gmingtian/HachimoDock-esp32s3/docs/superpowers/specs/2026-11-07-fusion-enclosure-api.md

# 当前接续：R4 原版实体复制

用户最终明确：以原版 STEP 实体为母版，外形只略放大；按键、摇杆、凹槽深度与原版接合结构照搬，内部空间和屏幕安装重新适配，左侧为双 Type-C。此前 R2/R3 完成记录和重画外形均已被本要求取代。

R4 复制原实体，在屏幕段 V=43 mm 插入原截面8.5 mm，总宽增3 mm；原版操作区实体恢复原尺寸和坐标。屏幕内装四个 M2 自攻圆柱，PCB H3/H4 为 M2.5×4×3.5 热熔螺母，H1 塑料定位。底部和上方收音孔同时保留。当前 R4 安装、面框视线、错误孔洞检查及最终 STL 导出回读完成。球帽18,360姿态无新增碰壳；未测枢轴的极限杆体模型仍有约0.268 mm³新增交集，保留原版操作区并明确为试装件。实物行程与USB插头尚待确认，不交付 R1/R2/R3。

以下为历史过程记录，不表示当前 R4 已最终验收。

---

# A4 外壳 R2：Fusion API 接续

用户确认使用 Fusion API 由当前助手继续设计；交付只需要前后壳 STL。用户要求补齐前壳中间 H3 固定，相关固定座统一为圆柱；尺寸参考用户原版打印件；屏幕与机身为连续圆角一体过渡。保留 A4 PCB 与按键/摇杆坐标、原 14 mm 球帽，接受球帽与 SW3 既有干涉。

本地 Fusion 加载一次会话插件。插件通过工作区 JSON 请求/响应通信，不开网络端口，不自启动，不执行来自请求的 Python 文本。后台线程只发 CustomEvent，全部 Fusion 对象操作在主线程完成。原版 STEP 导入独立参考文档；修改仅发生于插件创建的工作文档，输出限定在外壳工程 `output/r2-fusion/`。不覆盖原 STEP/3MF，不提交或推送。

先接通并读取实体、圆柱孔轴和高度，再依据实测原 CAD 修正前后壳固定结构。不能只检查无碰撞而遗漏中间固定是否存在；需要检查圆形承座、孔/螺丝路径及前后/PCB 同轴性。API 导出 STL 强制毫米，并回读验证尺寸、封闭性与实体数。保留音频低位安装假设、左侧双 USB、屏幕内装四个 M2 柱与收音孔，并重新校核。
