gmingtian/HachimoDock-esp32s3/hardware/s3-carrier/output/electrical-audit.md

# A4 电气与固件对应核对

已直接读取最终 KiCad PCB 焊盘，按当前 S3 代码和编号引脚逐项核对；不只检查生成器的网络表。

| 代码信号 | GPIO | 果云排母引脚号 | 目标端子 |
|---|---:|---:|---|
| PET_S3_LCD_CLK | 21 | 39 | J1.3 |
| PET_S3_LCD_MOSI | 47 | 38 | J1.4 |
| PET_S3_LCD_RST | 45 | 36 | J1.5 |
| PET_S3_LCD_DC | 40 | 29 | J1.6 |
| PET_S3_LCD_CS | 41 | 28 | J1.7 |
| PET_S3_LCD_BL | 42 | 27 | J1.8 |
| PET_S3_MIC_WS | 4 | 4 | U3.5 |
| PET_S3_MIC_BCLK | 5 | 5 | U3.6 |
| PET_S3_MIC_DIN | 6 | 6 | U3.3 |
| PET_S3_SPEAKER_DOUT | 7 | 7 | U2.5 |
| PET_S3_SPEAKER_BCLK | 15 | 8 | U2.6 |
| PET_S3_SPEAKER_WS | 16 | 9 | U2.7 |
| PET_S3_PREVIOUS_GPIO | 39 | 30 | SW1.1 |
| PET_S3_NEXT_GPIO | 38 | 31 | SW2.1 |
| PET_S3_CONFIRM_GPIO | 0 | 35 | SW3.1 |

麦克风 L/R 接地匹配当前左声道采集；按键另一端接地匹配内部上拉、低电平按下逻辑。
功放 VIN 保持用户确认的 3V3，SD 接 3V3；GAIN 连接 JP1 中间2脚，1脚接3V3、3脚接GND。I²S模式下单帽1-2为6dB，拔帽为9dB，2-3为12dB（模块自身若有增益电阻需先核实）。喇叭直接接模块端子。
JP1仅使用一个2.54mm跳线帽，断电后切换；禁止同时跨接1-2和2-3，否则短接3V3与GND。不占用GPIO，不新增电阻电容。
GPIO1/2/8 只预留给摇杆，当前 S3 固件不采集摇杆。
果云使用两条 1×21P 排母；功放 1×7P；圆形麦克风两条 1×3P、排距 7.62mm。模块按元件面安装，不能照背面视图把引脚顺序镜像。
麦克风预焊照片已核对：带字面朝外、长针向下；元件面左列由上到下 SD/3V3/GND，右列 SCK/WS/L/R。
屏幕接口由左到右 GND/VCC/SCL/SDA/RES/DC/CS/BLK，VCC=3V3；与用户屏幕图片同序。
未上电焊接检查：按连接表确认排母每脚与对应端子通断、相邻焊脚无锡桥，3V3 与 GND 无焊接短路。预留 GPIO 和 NC 脚不能当成地线连接。
本次是设计文件审核，不代替打样板的断电通断检查、上电电压测量、负载和温升测试。高度/屏幕/USB 对壳尚未核实，因此没有制造放行。
