gmingtian/HachimoDock-esp32s3/hardware/s3-carrier/output/independent-review.md

# A4 独立复核

结果：PASS；独立复核代理 pcb_gain_review，2026-11-02。

- 原生KiCad DRC重新执行：0违规、0未连接。
- 23项测试通过，6种故意错误被拒绝。
- 与A3原生PCB比对：98个原有焊盘（包括机械孔）的坐标、尺寸、钻孔、形状、朝向不变；原网络仅U2.4按要求变为AMP_GAIN。原模块、板框和控制器件位置不变。
- JP1为2.54mm三针：1=3V3、2=AMP_GAIN、3=GND；单帽1-2=6dB、拔帽9dB、2-3=12dB，符合MAX98357A官方手册第28页表8（I²S模式）。
- 无新增阻容，没有更改GPIO。说明保留单帽、断电切换、禁止双帽和模块原有增益电阻/焊桥需核实的条件。
- PCB SHA256：`3ea5f653f6bf27bdb09c90290e1f22ae493803e0c346911ff89b9b5f40b8624e`。

本复核是设计文件检查；实际模块增益设置、安装高度、整机装配、电源/RF和打样上电仍未验证，不构成量产或整机无干涉证明。
