gmingtian/HachimoDock-esp32s3/hardware/s3-carrier/output/mechanical-audit.md

# A4 装配间隙核对

以下为已锁定布局的平面包络计算，并与最终 PCB 的焊盘坐标校验值关联；不是整机三维无干涉证明。

| 检查对象 | 包络间隙 mm | 规划下限 mm |
|---|---:|---:|
| 屏幕插头—果云下排排母 | 0.536 | 0.5 |
| 屏幕插头—麦克风包络 | 2.600 | 1.0 |
| 麦克风包络—SW3键帽预留 | 1.071 | 1.0 |
| 功放包络—SW1键帽预留 | 0.871 | 0.8 |
| 摇杆本体—SW3键帽预留 | 1.593 | 1.0 |
| 屏幕插头—H1螺丝头Ø6 | 11.286 | 0.5 |
| 屏幕插头—H2螺丝头Ø6 | 19.504 | 0.5 |
| 屏幕插头—H3螺丝头Ø6 | 0.560 | 0.5 |
| 屏幕插头—H4螺丝头Ø6 | 11.599 | 0.5 |
| 屏幕插头—H5螺丝头Ø6 | 19.298 | 0.5 |
| JP1含跳线帽—U1模块 | 8.403 | 1.0 |
| JP1含跳线帽—U2模块 | 2.900 | 1.0 |
| JP1含跳线帽—U3模块 | 9.000 | 1.0 |
| JP1含跳线帽—屏幕插头 | 4.800 | 1.0 |
| JP1含跳线帽—SW1键帽预留 | 10.268 | 1.0 |
| JP1含跳线帽—SW2键帽预留 | 4.371 | 1.0 |
| JP1含跳线帽—SW3键帽预留 | 7.612 | 1.0 |
| JP1含跳线帽—H1螺丝头Ø6 | 12.015 | 1.0 |
| JP1含跳线帽—H2螺丝头Ø6 | 37.046 | 1.0 |
| JP1含跳线帽—H3螺丝头Ø6 | 3.170 | 1.0 |
| JP1含跳线帽—H4螺丝头Ø6 | 28.082 | 1.0 |
| JP1含跳线帽—H5螺丝头Ø6 | 26.373 | 1.0 |

JP1采用2.54mm三针直排针与一个跳线帽，帽体限4×5.5mm；两种插法与针座的总平面包络按4×8.5mm预留。实际高度和外壳可达性仍需装配确认。

屏幕杜邦插头选型限制为外壳不超过 22×3mm；实际排母宽度、插头与线缆高度仍需核准。键帽按18.5mm预留，原版STEP中三个键帽约18.021mm。

摇杆保持原版孔位、封装、朝向，使用用户确认的原版约14mm 3D打印圆帽。按厂家图纸使用角为±30°，角度公差另留2°；新模块与插头避开R15mm保守活动预留圈。这个圈包含较大的杆帽中心位移规划余量，不是实测帽子扫过边界，也不表示帽子直径30mm。

该保守圈与原版SW3键帽在俯视投影中相交；高度差可能提供实际间隙，不能据此认定碰撞，也不能据此宣布无干涉。原版STEP有帽和键帽几何，但果云排母高度、摇杆支点对打印帽的位置和屏幕总装高度尚未核准，需完成全行程、按压及键帽按下的三维/实物检查。控制器件不因此改位。

U1/U2下方原安装孔的螺钉头与模块背面也需按实际排母高度检查。屏幕本体和背板、外壳、USB插头、线缆弯曲空间尚未完成三维核对。

原版摇杆规格：YTL YA13S-L7.4-B10Ka(60)-0-DL01；厂家机械图通过立创数据手册获取：https://www.lcsc.com/datasheet/C37323748.pdf

固定螺丝头选型限外径不超过6mm，螺丝头高度、实际型号及排母实际宽度仍待核准；H3孔保留原位，J1由A2的Y32.6改为Y31.0mm。屏幕插头与上侧ESP32排母、下侧H3螺丝头同时留有约0.54/0.56mm平面余量，不能再套用A2的2.14mm上侧间隙。两层螺丝头周围3.5mm半径内禁止走线、过孔和铺铜。

结论：规定包络内的新增模块平面间距通过；整机无干涉及制造放行仍待核实。
