gmingtian/HachimoDock-esp32s3/.folder.md

# 目录导航

- `pc/`：客户端、Agent 连接服务、组件生成 Skill 和内置素材。
- `firmware/`：ESP32-S3 A4 / ESP32-P4 固件、驱动、测试及烧录工具。
- `hardware/`：A4 PCB、R4.4 外壳和经过校验的制造/打印清单。
- `tools/`：离线游戏与硬件发布包构建工具。
- `assets/`：项目介绍使用的图片。
- 构建方法见各目录 README，下载入口见项目首页。
