gmingtian/HachimoDock-esp32s3/firmware/.folder.md

# Host and target build consistency

S3 Xiangqi admits its unchanged maximum 256-work AI slice every 2ms; portable
preview and P4 retain 8ms. `pet_p4_game.c` loads target CONFIG macros through
`sdkconfig.h` only on ESP builds. The cadence test mirrors that IDF macro path
and compares changing positions, completed depth, work, nodes and exact replies
against the portable 8ms reference; search rules, evaluation and limits stay fixed.

S3 landscape Xiangqi has a main-task static-frame scheduling gate. It compares
the existing input/instance context, widget identity, view revision and state
update time only after successful rendering, and forces a refresh every second.
Page exits, transfers, render failures and live touch, confirmation, approval or
conversation overlays invalidate it. Animated/unknown surfaces keep the original
render cadence. This skips duplicate raster work, not game/input/protocol turns;
it retains no pixels and changes no AI search limits. Host gate/adapter tests
cover the fallback rules; S3 response latency still requires device measurement.

The S3 LCD SPI clock defaults to 40 MHz. A bounded 80 MHz experiment can pass
`-DPET_S3_LCD_SPI_HZ=80000000`; S3 main accepts only 40000000 or 80000000.
`build-local.ps1 -Target S3` explicitly selects 40 MHz so an earlier trial CMake
cache cannot silently alter the stable build. Clock trials must use a distinct
firmware version and retain the previous image; see `docs/ESP32-S3-80MHz-Trial.md`.

CI prepares the locked v1/v3 SDK compilation contexts before the complete host
suite. Preview WASM uses LLVM/LLD 20.1.8. Portable C keeps strict compiler and
sanitizer checks; R179 includes bounded tone text formatting. Compile databases
and dependency caches are generated inputs and are not published.

# R178 independent appearance audio

Status-cue updates use the bounded audio-only protocol and two independent
audio banks. Empty snapshots restore defaults; unknown storage or publication
results preserve both banks. Video assets and factory components remain intact.
The protocol dispatcher includes the system-cue declarations used by this route.

# R174 media controls and pet-status candidate

The media transport primitive draws a complete triangle and centers action
labels using font visual bounds. Empty main-page captions use pet lifecycle
labels rather than Agent/session identity. City-radio 1.4.1 carries the aligned
controls in the canonical generated bundle; existing full resource packages
need a normal PC sync after upgrade. Factory membership remains 29. This is a
local candidate requiring clean dual-chip builds and manual device validation.

# Paced CONTROL alignment isolation candidate

Only the existing PET_P4_UART_PACING_ACTIVE CONTROL queue and its prefix use
one 256-byte internal DRAM staging buffer aligned to 64 bytes. Each driver
submission re-copies the unaccepted original suffix with volatile byte accesses.
Prefix debt, bursts, drain/tick and terminal error gates remain unchanged.
Default-off policy, raw screenshot, audio/media/log queues, USB, DSP, SDK,
clock/task/watchdog policy and versions are unchanged. This is isolation and a
candidate mitigation, not validated root cause or hardware acceptance. Actual
ELF placement/alignment/byte-loop/no-copy-call proof and original gates remain
mandatory; host tests cannot grant those claims.

# Firmware repair baseline

Private `negotiated-parent` offers downstream control framing per physical
route and enables it only after a bounded explicit engine/nonce proposal.
Legacy bind/ack resets only that route; invalid proposals preserve its session.
The protocol worker serializes capabilities and negotiation; native USB has no
guarded writer and advertises no serial integrity. Existing media/audio/raw
paths, execution grants, flash format and timing gates are unchanged. Winning
boot-lifetime frame evidence additionally retains exact node costs and LCD
compare/submit/wait observations, not later independent maxima. These numeric
diagnostics contain no text, identities, paths or packet contents.

Private `bulk-parent` compares unbuffered IO only for authorized non-live
package JSON streams and alignment-checked may-alias word copies only for
existing app clean-frame buffers. Defaults preserve libc buffering/copy paths.
No extra framebuffer, file-format, private-save or catalog-publication change.
The same winning frame retains app capture/wait/draw phases; the worst native
registry turn also retains its inner duration plus numeric query/SAVE interval
context. Endpoint overlap is not causal CPU attribution. No payload, path,
native owner address, task policy, clock, watchdog or public grant is added.

Private `phase-parent` retains same-frame boot-lifetime raster stages and the
worst aggregate native registry turn's scheduler/collect/capture wall phases.
These bounded numeric observations export no program/event/owner/private data,
never reset maxima and never subtract waits from the original timing gates.
Private spare-open purpose stages append IDs 21/22 and a third post-operation
numeric trace line; ordinary targets retain their original stage count/format.
The independent opaque-span experiment uses at most 256 bytes of local scratch,
preserves default 32-byte scratch elsewhere, and still requires actual stack,
pixel, memory and whole-window device acceptance. It is not a throughput claim.

Private `dirty-parent` adds default-OFF `PET_P4_APP_DIRTY_CACHE` and
`PET_P4_SPARE_UPDATE`. The app path keeps the existing clean-frame buffer and
native overlays, compares exact resolved keys, and replays all intersecting
layers in order through intersected dirty/viewport clips. Unsupported resources,
animation, runtime layers and structural changes keep full repaint. A first
proven opaque panel center avoids duplicate background stores; the redundant
prefix snapshot is omitted only before a full clean-frame cache write.
Empty-to-empty image revisions update metadata without visual invalidation.
Non-cacheable app prefixes additionally bind their exact resource revision;
an empty image pack never authorizes a different component's cached prefix.
The separate storage candidate updates ONLY a positively seen, non-live spare
JSON target using write/flush/final-tail truncation; unknown targets retain wb,
only ENOENT may fall back, and all readback/catalog/save rules remain. These
are raster/storage experiments, not execution grants or released capabilities;
source-bound device, throughput and whole-frame acceptance are still required.

Private startup-parent queues only unsolicited hello work on the existing
protocol worker, using one immutable native board identity and a coalesced
pending tag. No model/state mutex spans that full capability TX. Requested
bind/ack replies and all audio routing stay unchanged. The optional I2C
diagnostic sweep finishes before the first visible frame; original timeouts,
drivers, milestones and lifetime counters remain. Additional numeric app-frame
phases separate snapshot wait/capture from actual drawing; no duration is
excluded from the unchanged frame budget. The same private profile compares
removing/recreating only an already-unreferenced spare package generation
instead of truncating it page by page. Live-generation exclusion, full readback,
checksums, atomic catalog rename and save durability are unchanged. All three
switches default OFF; this profile is not physically accepted or released.

Private prefetch-parent reuses the existing priority-1 asset preparation task
for one physically owned H264 frame. Source pins, exact lease completion and
single-job generation prevent cancellation from freeing live codec readers.
Renderer-owned packed-current pixels remain independent from next-frame I420,
including an exact original-coefficient CPU fallback. Worker trace is separate
from complete render lifetime/gap measurements; future frames wait their target
and clip tails are displayed before reset. The main native program window and
worker claim share one short mux admission; visibility/cancel handling is not
deferred, accepted events are neither dropped nor replayed. The private existing
worker uses 6144 bytes pending actual link/stack/high-water/memory acceptance;
normal targets retain 4096. No SDK, priority, clock, watchdog, new task or audio
policy changes. This experiment is NOT yet physically accepted or released.
The static render guard additionally covers three actual asynchronous render
paths; all original paths and the 4096-byte reviewed-path limit remain.
Input eligibility queries provider-neutral two-byte paging under the same data
lock rather than copying five text rows to the input/form stack. Full snapshots
and the paging query share signed modulo/count logic; validation, retained stale
rows, TTLs and source isolation are unchanged. A private 32-byte HOST candidate
is serialized by the existing host mux, preserving all-or-none typed reads while
avoiding a per-task stack candidate. Cooldown admission has its own bounded
call frame; the complete nested path is audited, not hidden by outlining.

Private state-memory-parent preserves the original stable-address task model
and struct ABI, placing only that model in external BSS. No audio/DMA/ISR/RTC
buffer, mutex, task priority, stack or watchdog changes. Ordinary targets keep
the original placement. Actual ELF section/RAM and same fixed memory/timing
gates are required; source checks cannot grant hardware acceptance. Program
action dispatch now returns actual queue acceptance, not success after a
denied/full/stopped/uninitialized foreground session. No fallback or replay.

Private lookup-parent integrates bounded positive search-start coordinates into
the already measured save-budget/shared-program parent. Native eight-FD pool,
original SDK visitor (exactly once), full names/headers/flags/readback/errors,
catalog temporary-file atomic rename, save A/B/fsync, priorities and watchdogs
are retained. Missing files are never cached as absent; stale/colliding hints
only change the visitor's start and cannot supply a result. Timer/metadata work
preserves the real visitor's errno. Ordinary targets remain OFF. Exact-package
comparison adds opt-in numeric OPEN/DATA/CLOSE spans, no paths/content. Previous
actual SAVE-fault data remains retained; this new integration is not yet P4
throughput, serial, memory, long-frame or acoustic acceptance.

Private save-budget-parent moves only the immutable pending save snapshot into
fixed PSRAM under exact original-address/current-task ownership. Nested writers
cannot overwrite it before storage admission. Original 4096-byte SAVE stack,
priority 1, task count, A/B/fsync, dirty-newer reconciliation, audio admission
and revocation stay unchanged. After a real physical flush returns, the same
worker caches numeric byte-labelled high-water metadata; diagnostics only copy
that metadata, never scan another stack or export addresses/content. Ordinary
targets remain default-OFF. Native sanitizer tests and static frames do not
prove whole-SDK stack bounds, real workload margin or acoustic acceptance.

The private unchanged-install comparator reads exact filesystem bytes plus EOF
while bypassing only the product HAL read cache. Native SPIFFS file/index cache
coherency remains unchanged; this is not a raw-media bit-rot scrub.

Private snapshot-close-parent adds an explicitly negotiated exact id/requestId/
route close receipt after physical retirement, plus bounded numeric request/id
correlation on errors. Legacy cleanup and all snapshot/audio/driver deadlines
stay unchanged. The PC waits inside its original frame budget, never retries
close or replays a task, and retains late errors. This extension is not yet
compiled or physically accepted; R106's full reader gate failed despite all
600 queries and all raw frame checks passing. Its separate unexecuted lifecycle
tail passed and removed only the two owned fixtures, preserving private saves.
The same private candidate additionally retains an unexpired boot cache epoch
across physical package boundaries without extending its <=5s deadline; only a
fully completed old epoch can rotate. Every original read/check/recovery still
runs. Explicit reopening of the same validated RAM program may retain its live
owner unchanged, or take the latest fully retired committed snapshot before
NEW broker admission. Visibility never rearms it; manually stopped registered
background programs remain stopped. These default-OFF optimizations have native
ownership/retirement tests but are not yet P4 timing or acoustic acceptance.
The RAM snapshot adapter itself is compiled only when its opt-in is enabled:
ordinary pure-compute sessions retain their original parser-free link boundary.

Private boot-trace-control records eight fixed monotonic app_main milestones;
boot-cache-parent additionally gives EACH existing physical catalog package
validation and catalog JSON/selected-package read its own finite native cache
work lifetime. No cached filename/absence/validation result, skipped parser,
checksum, older-item recovery or changed data format. Cache admission failure
only bypasses the optimization, never marks resources damaged. The selected
package scope finishes before private saves acquire their separate lease.
The generic adapter keeps exact original pointer/task/lease/epoch ownership,
including revoke, copied/stale scope and external manual-observer cases.
No TTL extension or new IO retry. Boot trace is default-empty, <=64 bytes plus
one mux, explicitly requested metadata only and atomically assembled JSON.
Milestones include preemption; returned initialization is not a health verdict.
These changes are not yet compiled or physically accepted; normal targets
remain closed and the earlier original OTA boot-deadline failure is retained.

Private `storage-save-parent` extends the exact-byte cache to independently
admitted native save IO leases, including cold loads and background flushes.
Borrowed miniapp leases retain their original scope; busy/manual observation is
never adopted. The native adapter binds the original scope pointer and task,
stops only its exact generation after physical close and before lease finish,
and permits cleanup after audio revocation without stopping a newer observer.
The five-second expiry, original fsync/A-B/save error semantics, audio guards,
task priorities and ordinary targets are unchanged. This is not a measured
throughput fix or acoustic acceptance. Activation/storage rejection logs add
fixed numeric admission gates, never paths, content or credentials.

Private render-pack-probe checks 4-byte source/output alignment before compiler
alignment assumptions and uses ordinary memcpy word IO for an 8-pixel H264
layout block. Unaligned rows and 2-pixel tails retain the original byte-safe
path. No new buffer/task/priority, DMA mode, ownership or fence change. Normal,
UI and mixed profiles keep the option off; bit-exact tests are not P4 speed or
acoustic acceptance. CPU tiled rotation remains a rejected private comparison.

Private framework-mixed-acceptance composes the reviewed unified parent,
scoped exact-page cache and guarded 256-byte paced control transport for JOINT
acceptance only. Still two PROGRAM leases/4096 total fuel/64 aggregate dispatch,
zero arbitrary peripherals/media grants, no auto-start. The inherited33-slot
catalog exists only for two owned fixtures without removing retained user
resources; remove exact fixtures before a32-slot image. Normal/UI/Windows are
unchanged. This configuration alone is not mixed P4/performance/AEC acceptance.

Private render-rotate-probe compares a bounded tiled CPU quarter-turn with the
unchanged PPA control after actual queue measurements. Same source/destination,
RGB565 element order and panel mapping, no extra framebuffer/priority/task. The
original panel submit, cache synchronization, refresh fence, screenshot and
double-buffer ownership remain in place. Invalid dimensions/capacity/overlap
fall back before any write. Ordinary builds remain closed; no throughput or
66.667ms/voice/AEC success is claimed before paired physical measurement.

Private render-queue-probe wraps only the pinned SDK ppa_do_operation boundary
for the exact renderer task/client/cookie. Preparation wall time is separated
from queue-to-callback on the SAME frame; neither is claimed as exclusive DMA.
Original arguments/result/errno, blocking mode, buffers, deadlines, fences and
priorities remain unchanged. No global cache wrapper, image data or pointers in
logs. Ordinary builds add no queue state/clock calls. Physical measurement and
the existing frame gate remain pending; this is diagnostic, not an optimization.

Private exact-page cache entries now use an 8-byte numeric representation:
all 23 aligned-address bits, 8 bounded pin bits, one filling bit, and the full
generation. Metadata is 17408 bytes, 8192 less than the earlier layout. Saturated
pins bypass the cache rather than wrap; invalidation still changes generation
only and cannot recycle pinned/filling copies. This is not a voice/AEC or DMA
acceptance, and the cache remains disabled in ordinary builds.

Private render-lcd-probe separates comparison, panel-submit and refresh-fence
wall time for the SAME retained window-peak frame. It does not change the
existing lcd_us meaning, fence/deadline, frame gate, DMA/buffer ownership or
voice/AEC policy. Ordinary compiled paths make no new timer calls. Invalid
timings are marked rather than interpreted as zero cost; measurement is not a
66.667ms gate pass or permission to remove the refresh wait.

The private storage-page-parent profile alone connects the bounded exact-byte
cache to actual STORAGE_WORK scope ownership. A busy/manual diagnostic window
is not adopted. Exact successful native scope completion stops only its own
generation; copied/failed/durable-unpublished scopes cannot stop another job.
Expiry is a cache bypass, never an IO/installation success or permission. The
new strict storage_io_latest RPC only observes metadata. Normal builds remain
closed; host tests are not automatic-parent P4 or acoustic acceptance.

`pet_p4_storage_sparse_page.h` adds a default-off exact65-byte representation for
successful512-byte snapshots with a uniform middle, within the same slot and
metadata budgets. Partial copies retain every prefix/tail byte; pins, generation,
invalidation, physical bypass and original SDK recovery semantics are unchanged.
`pet_p4_logical_retention.h` owns bounded renderer-only common-overlay plans and
previous successful final-frame authority. Exact staged content/resource keys
and unchanged captured overlays can avoid repeated rasterization while retaining
the complete final pixel comparison and original frame/gap clocks. Final pixels
with overlays never populate a clean texture; noncacheable modes remain live.

The private glyph-axis candidate relocates only the existing512-byte axis to
internal RAM. No sampling expression, font release, clipping or wide-glyph
fallback is changed. The relocation requires explicit internal-memory admission;
default profiles retain their original allocation. No extra scratch, framebuffer,
task, guest service or execution grant is introduced.

`pet_p4_storage_io_trace.c/.h` and its RPC are DEFAULT-OFF private observation of
the real SDK SPIFFS physical HAL callbacks, not a cache or new storage policy.
The private IO profile alone wraps read/write/erase, preserving exact args,
single-call returns and errno. Four categorical actors and size-count buckets
report requested (NOT accepted) bytes and preemptible wall time. In-flight calls
keep a stopped window incomplete until physical return; old generations/boot
tickets cannot reset a later window. No paths/addresses/payloads are exported.
Read/status export uint64 counters as exact decimal strings, bounded to one
record per reply. Ordinary builds have no wrappers or trace state. SDK link,
full regression and physical measurement for this new observer are still pending.

The private v2 background controller uses strict `widget/program-query/inspect/start/stop`
with request IDs, exact installed checksums and decimal registration serials.
Mutations additionally require the current exact boot ID; serial1 after reboot
cannot be cancelled by a stale serial1 ticket from the preceding boot. Query
returns the boot ID but needs no mutation authority. No automatic retry.
`pet_p4_background_protocol.inc` is included once by protocol.c and emits only
bounded categorical ownership/timing/checkpoint metadata, not program/cells.
Inspection separately negotiates `p4-program-inspect-v1` and copies exact
checksums from the verified RAM catalog only. Allocation failure never emits
a partial or apparently empty successful status; a lost receipt stays unknown.
Capability is advertised only after the private native parent initializes;
ordinary/Windows/UI remain ungranted. The small r71 private installed lifecycle
passed silent P4 acceptance; later v2 cross-boot stale-ticket rejection is also
verified. Real client inspection/control integration remains separately gated.

`pet_p4_screenshot_write.h` preserves a bounded numeric first TX failure across
best-effort error transmission and exact snapshot terminal history. Writer
budget, no-progress/invalid return, drain, lease, audio, mutex and encode differ.
There is no image/text capture, larger deadline, new thread or audio path change.
An unwritten TX-mutex refusal retains the SAME pull snapshot for a bounded
read-only observation. Begin reuses the exact nonce/route/dimensions; read/end
may return fixed busy metadata. Partial writes/driver/drain remain terminal;
idle/lifetime/read quotas and physical buffer ownership are unchanged.

Main samples its existing monotonic timestamp AFTER the shared state lock.
A protocol owner can admit new timers while main is waiting; an earlier sample
would spuriously cancel them as a clock rollback. There is still one sample,
no timer clamping, reset/replay, priority change or audio-path rewrite. The
actual extracted main prefix is tested with the real timer core; a genuinely
regressing timestamp must continue to latch cancellation.

Private `esp32_p4_background_candidate` connects the native registry to the
actual main parent and verified installed-package loader. The private parent
fragment `pet_p4_miniapp_background.inc` is included once by miniapp.c, not a
separate task/owner. Explicit native start preserves the visible selection,
uses exact catalog content identity, pins its authoritative RAM seed, rereads
the latest RAM checkpoint at publication and refuses inflight foreground events.
Registered program views project the registry owner; stale retired foreground
snapshots cannot overwrite later background progress. Update/delete quiesce and
checkpoint hidden owners too. First published seed refreshes its view without
pumping, avoiding a live revision with parse-time zero display. This is not a public
or package-autostart capability; global quota stays ONE, reclaim stays off.

`pet_p4_program_registry.c/.h` introduces a DEFAULT-OFF native parent with four
fixed session slots, one aggregate dispatcher, exact content/serial handles,
scoped-save pins and separate one-entry RAM checkpoints. Actual broker quota
is not enlarged. Parent/schema/install/UI integration and device acceptance
are still required; this source alone is NOT an installed background capability.

r69 private paced-UART reference now covers the screenshot writer too: the
r63 reference had paced only drained control replies, so its later screenshot
failure was on an UNPACED path. Keep that failure; it is not evidence that
pacing failed on screenshots. Default, USB JTAG and audio/media queueing stay
unchanged. Same send/snapshot deadlines and all CRC/error/ownership checks.

Scoped app-save RAM entries now support exclusive native lifetime pins, with
monotonic stale-safe tokens. Only confirmed loaded/clean/unpinned scoped slots
can be reused after successful storage admission; observation/update cannot
reserve a key. Dirty, loading, failed and all 32 legacy entries stay protected;
reclaiming RAM never deletes files. Reclamation remains DEFAULT OFF until all
long-lived consumers acquire pins; the existing foreground profile is unchanged.
This is a registry prerequisite, NOT an
installed background scheduler, execution grant or durability acknowledgement.

`pet_p4_spiffs_hint.c/.h` is a private IDF-5.5.1 lookup-start experiment,
default empty. Same-memory control/probe keep eight descriptors/cache pages;
only the probe changes where the unchanged SDK full-name visitor starts its
wrapping search. No existence/content/negative answers are cached, no file
format/readback/CRC/error is changed, and diagnostic counts contain no names.
Host RAM-flash tests compile the installed SDK unmodified (symbol redirection
only); P4 final-ELF caller/heap/timing verification is separately required.

A separate private `esp32_p4_program_candidate` permits ONE foreground PROGRAM
lease (4096 fuel total), following r64's actual main maximum-image/backedge
measurement. Normal/UI/Windows remain closed, peripherals remain closed, and
audio reservation still revokes it before flag sampling. This is not arbitrary
mixing, a background registry, public firmware or voice/AEC certification.
The broker denies NATIVE_PROBE versus PROGRAM/PERIPHERAL in both directions,
including revoked-but-unfinished physical work, so a debug job cannot silently
double an admitted component's quantum. Quotas and realtime masks are unchanged.

r65 retains a bounded terminal category for the last exact screenshot ID/route.
Idle expiry, lifetime expiry, broker revocation, explicit close, failed physical
send and active ID/route mismatch no longer collapse into one generic error.
Budgets, CRC checks, cancellation and no-recapture rules remain unchanged. No
image bytes or request contents survive release in this diagnostic record.

r64 expands the fixed main-loop diagnostic with two full 256-instruction,
64-cell images: a successful HALT and a 4096-fuel backedge trap. The latter must
retain every committed cell/output and revision. Both validate/start through the
actual host/session and shared parent, one operation per main turn; no guest
quota is opened and this is not a worst-case or acoustic timing certificate.

A private 4M paced-UART reference limits only drained-control bursts to 64
bytes separated by one RTOS tick. Normal/UI/Windows and audio/media queueing
are unchanged. This is a controlled link experiment, not a released workaround,
driver attribution, throughput improvement or acoustic acceptance.

r63 adds a fixed native main-loop diagnostic with one bounded work operation
per main turn outside UI locks. Completion publication is memory-only; only the
protocol worker serializes/drains the retained static reply route, exactly once.
No arbitrary guest code, background installation or resource grant is enabled.

r63 separates shared-parent dispatch from each session's own report collection.
Fresh sessions may bind one fixed native parent before admission; they cannot
step/rearm that parent implicitly or consume another child's result. The real
component parent now dispatches once and collects its own output after visibility
guards. Private-session callers remain compatible. Alias checks cover the shared
dispatcher and its registered host/group/timer/bus storage. This is not yet an
installed background registry, arbitrary mixing or new execution permission.

A separate `esp32_p4_uart_2m_reference` is a private silent link comparison;
normal/UI/Windows/default baud remain 4M. A clean low-rate window alone is not
driver fault attribution, normal-rate closure or voice/AEC acceptance.

The r62 fixed native session diagnostic uses a separate immutable constructor
and actual NATIVE_PROBE leases/publication. Ordinary PROGRAM construction and
its zero admission quota are unchanged. Eight fixed actions plus a one-shot
timer traverse the actual session/group/scheduler; every quantum returns and
yields. The bounded empty request cannot supply code/state/grants/owners. It
reports protocol-worker step timing, NOT main-parent/mixed-load acceptance.

r62 evaluates a startup-only lossless font pack in the UI candidate only.
Every original glyph byte/metric/mapping/kerning and MiSans notice is retained;
the normal target remains unpacked for comparison. One static PSRAM output and
inflater replace bitmap Flash bytes, never per-glyph decode or dynamic memory.
Startup requires exact packed/output lengths, terminal decode and Adler match
before input/audio/render; failure is latched and cannot validate the OTA app.
Existing OTA/stack budgets stay unchanged. This is capacity engineering, not
guest/background admission or acoustic acceptance.

r61 reads the bounded extent of the same owned file before and after reading,
without probing past EOF. Save metadata I/O failure or changing extent is
unavailable, never an invented empty save. Package/checksum/Unicode/lease/close
checks and directory retry/error gates remain intact; there is no SDK clearerr
or storage migration. Host fault tests are not P4 throughput acceptance.

r60 applies the existing bounded Unicode/depth source preflight before the
early debug parsers as well as the ordinary dispatcher. Screenshot envelopes
must consume the complete JSON text. An explicit audit result gets a separate
fixed TX observation; read-only last-result metadata does not recursively
capture itself or retry any command. Ordinary/audio no-audit hashing is unchanged.

r59 routes the component program session through the shared group/scheduler.
Explicit empty-scheduler rearm preserves serial uniqueness; stopped work never
automatically resumes. The guest execution gate remains closed pending device
admission/mixed-load review. Only cold declaration/diagnostic/capability code
uses size optimization; VM, audio DSP and pixel-render optimization are unchanged.

r58 writes widget/buttons JSON directly to an explicitly owned, unreferenced
package generation. Current catalog references are denied before any open;
readback/checksums and the final catalog's atomic replacement remain unchanged.
Partial writes can only leave unpublished spare bytes, not alter the live pair
or private saves. Legacy boot migration and sprite/catalog writes retain the
old atomic file helper. Native tests cover owner loss, reference checks and
short write/flush/close faults, alongside the real parent mutation tests.

Opt-in transport audits also sample the caller's bounded source fingerprint
after driver return, per retained route. This separates a changing source buffer
from driver/wire/host loss, not proof of delivery or cryptographic identity.
Normal and audio/media sends still perform no audit hashing while disarmed.

r57 compares the unlocked storage phase at the existing main/save-worker base
priority (1), never above UI. The idle-only r56 intervention removed reproduced
multi-second render starvation but tripled package completion time; that result
is retained as a rejected throughput trade-off. Exact owner, unlock/restore
ordering, audio reservations and all ordinary execution gates stay unchanged.

r56 gives only the exact protocol task's unlocked storage preparation/cleanup
phase an idle base priority. It restores the known protocol base before taking
the state lock, never an inherited effective value. File ownership, durable
publication, audio reservation, legacy saves and package format are unchanged.
This addresses a reproduced high-priority filesystem/render starvation path;
same-fixture device timing still gates acceptance, not filesystem wall time alone.

r55 adds a private priority-9 scheduling comparison, sharing the input priority
but remaining below UART/control. Ordinary/UI priorities are not changed by
this experiment. Only priorities 9 or 16 are allowed in this reference profile;
component execution remains explicitly forbidden. Performance acceptance is
still pending the same-clip device comparison, not inferred from compilation.

r54 adds an explicitly separate scheduling-reference build for matched fixed
clip comparisons. It keeps the old primary/pack priority only in that reference
image, cannot compile with guest execution reviewed, and is never a public
candidate or a new capability. Default UI ordering stays unchanged. Count actual
rendered frames separately from intentional exact-frame LCD suppression; random
idle variants and unmatched time windows cannot establish a performance delta.

r53 separates the existing core-1 secondary decoder priority from primary/pack
priority for a controlled throughput comparison. Control/input and audio task
priorities are not raised. Compile-time checks bind the SDK secondary to core 1;
this candidate must still pass wall-time and throughput gates, not just compile.

r52 tests the highest animation priority still below input/control (8), after
the conservative priority-7 candidate's observed throughput was lower. Timing
and throughput must both pass independently. Trusted read-only service native
authorities now reject copied instances before providers, output or revocation;
ordinary peripheral/program grants remain unchanged and closed.

r51 makes animation decode/pack best-effort below control and input, without
changing audio task priorities, codec parameters or pixel operations. Temporary
main-task boosts never save an inherited effective priority as a new base.
The secondary decoder priority is compile-time checked against the same policy.
Wall-time and frame-throughput acceptance remain separate device measurements.

r50 extends fixed-instance identity and admission-time stop latching to the
component session. A separate opt-in scheduler evidence build links audited
partial wrappers and numeric bounded reads; normal/UI builds contain no active
hooks/ring/commands. It is diagnostic only, not a capability or release image.

r49 rejects moved/copied program host, runtime, timer, group and scheduler
instances before callbacks or resource retirement. This is private native
identity, never a wire handle or storage field. Fixed probes retain timestamps
of the same slowest quantum for correlation; no execution quota is opened.

r48 adds a native cooperative deadline checkpoint over the same interpreter:
fresh factory clock/budget only, exact continuation without event replay, fresh
authority after each permitted checkpoint, terminal clock/no-progress failures.
It cannot preempt native callbacks, interrupts or Flash/cache stalls. A fourth
fixed probe case compares the same loop with the 750us policy, retaining the
legacy cases. PROGRAM/PERIPHERAL quotas and execution review remain closed.

r47 keeps the new program foreground activation latched after hide: ordinary
ticks and input cannot resume just because visibility/focus returns. A fresh
explicit activation preserves committed state. Legacy non-program timers keep
their old behavior. Shared mixed form/program/navigation fixtures exercise
separate writers, draft cancellation and bounded visible input verification.

r46 retains separate whole-call wall time and diagnostic-only local critical
cycles. No timing callback or timer SDK lock is invoked inside resource_mux;
compiler memory barriers fence the native cycle reads. Host stubs mark cycles
unmeasured. Keyboard transient role ownership and read-only queue availability
agree with the same-C preview; neither observation is a new execution grant.

`pet_resources_device_program_publish` atomically checks the exact PROGRAM
lease and copies one <=512-byte private state under the same mux used by real
realtime reservations/revocation. The device host factory binds that publisher
once, before first admission; components cannot select callbacks or pointers.
VM work, allocation, IO, audio getters and callbacks stay outside the critical
section. A losing commit preserves the entire old model and stops without retry;
later revocation cannot relabel a completed report. Other native adapters retain
their explicit serialization contract. P4 critical latency and voice/AEC gates
remain pending; no execution quota has been enabled.
`pet_p4_program_publication_probe` explicitly measures that same copy primitive
with fixed PSRAM scratch and NATIVE_PROBE leases, never caller bytecode/addresses
or program admission. It yields between bounded copies, stops on audio/ownership
loss, sends categorical timing only and never retries an uncertain result.

`pet_p4_component_program` validates the data-only candidate runtime.program;
`pet_p4_component_program_session` owns one foreground interpreter, timers,
receiver-derived outputs and latched stop. The real component parent prepares
private saves, quiesces before same-component replacement, captures typed input
and pumps once per main turn. UI compiles implementation only: a separate
EXECUTION_REVIEWED=0 gate still prevents PROGRAM quota/capability. No arbitrary
code, service grant or background app registry is opened. Timing/commit exclusion
and audio acceptance remain separate. Diagnostics never reuse the old owner's
report for a new active UI revision.
New program declaration/controller sources use size optimization; the VM, audio
DSP and rendering retain their previous performance flags and all budgets.

`pet_p4_host_collection` is the separate opt-in PC-fed visible-row control.
The UI candidate alone admits its strict declaration/snapshot; normal builds
reject it and advertise no capability. Source records stay on the PC. A whole
captured projection resolves into budgeted standard nodes, without per-node
host reads. Row presence, source and native observation fence the final action;
old/empty/mismatched rows cannot be reinterpreted as another record. No installer
for autonomous programs, new task, framebuffer, audio or peripheral grant is added.

`main/pet_p4_collection_host` is a default-closed owned-list lifecycle bridge.
Inactive fixed banks copy/validate source text; the receiver fixes its expected
declaration identity before first publication. Exact generation, source revision
and action epoch fence old gestures, with current authority checks and latched
stop. Cached copied views require no full dataset scan; parent rasterizes outside
the lock, then rechecks context/physical ownership before publication. Preparation
and PSRAM/resource admission stay with a trusted worker/parent; no package/wire
route, source IO, record mutation, installer or grant is opened here.
`pet_p4_collection_internal.h` exposes a native-only prevalidated projection to
that owned model; old public projections/authoring still validate fully. Product
WASM exports only its explicit cv_* ABI, not that trusted internal fast path.

`main/pet_p4_program_scheduler` adds a default-closed native four-group
cooperative dispatcher: one selected group, at most one timer/bus offer and
one pump per caller turn. Round-robin cursor and alternating ingress retain
report/queue backpressure. Exact registrations isolate reused host addresses;
manual stop or backwards time latches all attached groups, retaining busy
retirements and historical reports. No task, installer, grant, automatic restart,
physical deadline or acoustic acceptance is supplied by this library.
Per-registration removal also latches stop intent before cleanup; a busy remove
cannot accidentally resume work on a later turn or external group enqueue.

`main/pet_p4_json_source.h` rejects raw NUL and JSON-escaped decoded NUL
before cJSON can discard string lengths. Protocol/native JSON and component
JSON file readers share this allocation-free guard; legacy identity text and
binary image reads retain their distinct paths. Literal backslash-u0000 text
remains valid. The separate `source_text` functions also require valid UTF-8
scalars and paired Unicode escapes, refusing raw string controls/invalid escape
spelling before parsing. They never substitute replacement characters. Neither
entry is a complete JSON grammar/duplicate-key/schema validator or wire-loss
repair. Device ingress uses the separate bounded-text wrapper, limiting object/
array nesting to 32 BEFORE recursive cJSON parse. This does not change vendor
parser settings, enlarge task stacks or prove full call-graph/high-water bounds;
binary and legacy identity text remain separate readers.

This folder remains based on PC-bundled 0.7.103, not the experimental 0.7.108 branch.

`pet_p4_evidence_identity.h` provides a startup-only immutable boot nonce and
strict bounded read-only identity response. The protocol exposes the actual ELF
digest, not task authority. Screenshot begin carries the boot nonce. Host-side
evidence binding checks lifetimes/source without copying the raw board ID into
its summary; this is not authentication or timing/acoustic acceptance.

`pet_p4_form_v2` is the default-off mixed UTF-8/integer/choice editor core shared
with the product preview WASM. Its strict decoder and typed restoration keep
committed and draft ownership separate; malformed cold saves block publication
instead of allowing defaults to overwrite user progress. The experimental UI
target alone advertises v2. It does not open program/peripheral quotas or change
audio/AEC algorithms. Full device input/font/timing acceptance remains separate.

`main/pet_p4_main.c` gives debug screenshots a checked, bounded transmit path with
per-chunk byte counts and checksums. Partial writes/encode/drain failures abort the
capture; audio and media retain their existing no-drain path. Screenshot fault
injection is host-only; the earlier short capture's cause remains unproven.
`pet_p4_control_integrity.h` adds a DEFAULT0 downstream serial CONTROL-only
21-byte `!P4C1:ddddd:hhhhhhhh:` prefix for 1..32768 immutable JSON bytes. The
existing TX mutex/queues serialize prefix/body/newline; prefix is queued with
NO extra drain. Partial prefix cannot fall back to an unguarded serial body;
audio/media no-drain, native USB JSON and checked snapshot writers are unchanged.
Only private control/controlpaced targets advertise the new capability; the
latter separately inherits the existing 256-byte pacing experiment. This does
not establish a physical driver cause, authentication or acoustic acceptance.
Audit body counts/hash still describe ORIGINAL inner JSON and its body driver
calls, not the added wire prefix. No new audit delivery claim or business retry.

`pet_p4_transport_audit` adds an explicitly armed, RAM-only 64-record observation
budget with a 16-entry ring for ordinary drained TX metadata. It observes existing
driver returns without new drains/retries; audio/no-drain traffic disables it.
Large reply scratch lives in PSRAM. The raw-byte comparison tool never prints
frame contents or interprets driver acceptance as successful host delivery.
JSONL overflow/NUL rejects the entire remaining line; native JSON refuses NUL
and the protocol parser rejects trailing non-whitespace. Binary chunks remain
byte-exact. Screenshot writes recheck authority before drain, and native writes
reject overreported lengths. These bounds do not identify physical wire loss.

`main/pet_p4_resources.c/.h` owns bounded typed leases and trusted owner generations;
`pet_p4_resources_device.c/.h` is the single short-lock adapter. Host views and
snapshot/debug buffers and asynchronous asset preparation are real consumers; program/peripheral kinds remain zero
capacity, not advertised package capabilities. Cancel revokes delivery but only
physical completion releases capacity. Dedicated realtime tickets atomically
exclude new background storage/debug/asset work without consuming background
owner slots. Capture stop/start uses exact request identity, not a reused bool;
old completion/errors cannot cancel the next session. DSP parameters, frame
sizes, task priorities and core assignments are unchanged; acoustic and timing
acceptance remain separate.

`pet_p4_render_trace.h` records same-frame wall-time subphases and a complete
100-frame-window peak. Nested decode/pack/convert measurements must not be summed.
The screenshot pull mode retains one immutable frame until close/idle/lifetime
expiry, with origin-scoped idempotent reads; strict checks are never relaxed.
Numeric widget-operation traces use two independent fixed lanes (protocol and
deferred save). Nested filesystem/parse/checksum/NVS stages are wall times and
must not be summed. Frame context records absolute intervals and both lane
observations; coincident activity alone does not prove causality.
Inter-frame gaps are reported separately from execution time, so state-lock
waits cannot disappear merely because the next completed frame is fast.
`pet_p4_file_cleanup` uses one bounded exact-name directory snapshot only when
the caller still owns that namespace and `pet_p4_fs_activity` proves no other
SPIFFS operation overlapped enumeration. The observer covers independent file
readers as well as saves, because SPIFFS error state is shared. Unknown/error/
concurrent scans retain the original per-path cleanup; ownership loss stops
cleanup. It does not defer deletion, change catalog commit order, or touch
private save names. Existing committed package generations remain available
to the recovery mechanism.
`pet_p4_ppa_trace.h` splits observed callback/return timing with non-reused
transaction cookies. Missing/late callbacks remain unknown; this is not a DMA
CPU-time measurement and does not change blocking mode or buffer ownership.
The two existing compressed-stream caches now prepare data on one priority-1
worker in 16 KiB chunks, checking audio and owner authority between chunks. Its
physical buffers remain leased until work exits; storage suspension invalidates
even same-path/same-size cached data. Raw metadata uses short-lock epoch
publication, never Flash I/O under a critical section. Rendering still owns
decoder reset/copy/first-frame decode, overlays and panel submission: asynchronous
read/validation logs are not measurements of those remaining synchronous costs.

`pet_p4_app_form.h` and its JSON validator implement capability-gated integer and
choice editing with distinct draft/committed variables and all-field atomic
accept. Hide/cancel discards drafts; only declared committed variables persist.
`PET_P4_RENDER_SPAN_FILL` separately compares bounded opaque RGB565 burst
stores against the original halfword loop. Rectangles retain exact clipping,
pixels, draw order and synchronous ownership; private scratch is 32 bytes, no
allocation/DMA/priority/deadline change. It does not relax the frame gate or
claim faster hardware rendering without same-source P4 measurements.

`pet_p4_catalog_profile.h` gates `PET_PRIVATE_PARENT_CAPACITY_ACCEPTANCE`:
33 fixed catalog slots instead of 32, only to fit two owned fixtures beside
retained hidden user data. Format/path/publication are unchanged; ordinary
targets remain 32. Remove exact fixtures, preserve their saves, and verify the
original catalog before returning to a smaller image. No user data is freed.

`PET_COMPONENT_PROGRAM_PARENT_UNIFIED` is a separate default-off candidate.
Its fixed foreground session binds to the installed background registry's exact
scheduler, with model -> registry serialization for input, snapshots, lifecycle
and projection. There is one aggregate 64-instruction turn, not one per child.
Hidden foreground is stopped before that pump; explicit background survives
view detachment. Only this profile admits two physical PROGRAM leases within
4096 TOTAL fuel; ordinary/UI remain zero and older private profiles remain one.
Audio reservation still revokes all exact owners without auto-resume. Native
tests do not establish P4 timing, arbitrary service mixing or acoustic safety.

`pet_p4_program_core` is a bounded integer VM experiment. The staged
`pet_p4_program_image` decoder and `pet_p4_program_runtime` add a copied-code image,
four-event queue, cooperative one-phase pump, schema-checked state and exact-owner
cancellation. They are compiled for integration checking, but PROGRAM stays at
zero capacity: there is no enabled package installation/execution path. The
fixed-vector probe's previous P4 budget failure remains an open gate.
`pet_p4_program_timers` shares a fixed eight-timer monotonic event scheduler with
the offline product preview. One tick offers at most one event, late intervals
coalesce without catch-up bursts, queue backpressure preserves due work, and
clock/sequence failures latch cancellation. Its approved enqueue adapter still
uses the real program host's lease checks; it cannot create execution authority.
This is not an RTOS/background installation path, persisted alarm restoration,
cross-component bus or hard timing guarantee. Parent lifecycle cancellation must
stop both scheduler and host. Receiver-derived immutable output limits now
guard the complete numerical transaction; incompatible seeds remain untouched.
`pet_p4_event_bus` is a native-only, fixed four-owner/four-message integer bus.
Explicit native publish/subscribe masks are not component grants. Fanout is
all-or-none under backpressure, accepted publication IDs cannot repeat within
their registration, and delivery rechecks the exact receiver owner. The receiver
uses its own shared runtime sequence, not a sender's sequence. Queue-full/busy
retains pending work; uncertain/rejected enqueue outcomes latch stopped instead
of replaying. Closing/reopening a receiver clears only its volatile queue and
old tokens cannot affect the new registration. It never revokes broker owners
or releases physical leases. Native/WASM/fault tests and a real-host adapter
fixture do not open a device registry, package grants or persistent event jobs.
`pet_p4_program_host` binds that runtime to an exact broker lease and a native
owner generation, with single-step scheduling and cancellation before release.
Its device factory only binds broker operations and audio-state observers; it
does not activate programs, acquire hardware or advertise an install capability.
`pet_p4_program_store` provides the strict P4S1 portable snapshot and canonical
JSON envelope for the existing private save layer. Invalid/incompatible saves
preserve the old output; no reset, migration, filesystem or queue replay occurs.
`pet_p4_program_persistence` connects that codec to the existing A/B save worker
using a platform-only namespace. Eight bounded native cache slots are separate
from the 32 legacy slots; namespaced filenames cannot replace legacy saves.
Loading is worker-only and preserves EMPTY/BUSY/UNAVAILABLE distinctions. Save
acceptance and exact-content durability are separate RAM-only observations;
only reconciled fsync/close permits DURABLE. Flush selection is round-robin.
This does not install packages, execute events or supply a durable job journal.
`pet_p4_program_activation` bridges inactive image decoding, restore and final
host publication under a borrowed STORAGE_WORK ticket. The parent transaction
must provide the current operation/component/content identity while holding its
publication lock. Stale/denied publication preserves the old host; a successful
preparation is consumed once. Package wire/schema installation remains closed.
Candidate r34 keeps the CMake fallback and PlatformIO versions aligned; the
same immutable receiver recipe is validated and copied at verified publication.
Incompatible saved output domains preserve the preparation and old host data.
Candidate r35 adds `pet_p4_program_group`, one default-off native lifecycle for
an admitted host, its deliberate timer schedule and exact bus subscription.
One native host accepts only one group; only successful new-owner activation
clears the old attachment. Three enqueue paths share a sequence and preserve backpressure. Manual stop,
observed revocation/clock faults retire owned work without touching new-generation
instances; historical reports/snapshots survive. Its wrappers do no IO or queue
draining and do not create the missing installed registry or fair device task.
The package transaction, persistent-key assignment, actual lifecycle locks and
P4 latency gates still have to be integrated before these adapters are enabled.
`pet_p4_trusted_services` and its device adapter provide reviewed read-only clock
and existing joystick snapshots, not arbitrary native calls or raw bus access.
PERIPHERAL also stays at zero capacity. No GPIO, DMA or audio access is opened.
`pet_p4_observation` provides three fixed pinned slots for coherent native
observations of at most 64 bytes. Reader pins prevent physical reuse; weak CAS
and fixed acquisition attempts avoid a source-level spin/wait or a wrapping
sample-generation counter. It does not grant access, create driver threads or
promise freshness/hard deadlines. Joystick diagnostics now capture a completed
row rather than mixing new coordinates with old min/max/calibration fields;
unavailable capture reports ready=false. The ADC sampling, decoder, input-event
routing, timing configuration and all audio/AEC algorithms are unchanged.
Two-writer/four-reader native ASan/UBSan and ThreadSanitizer stress, pinned-slot
faults and the actual input writer/getter interleaving are covered offline.
P4 contention/performance and acoustic acceptance remain separate gates.
Service authorities are fresh zero-initialized, single-invocation objects;
callbacks cannot reinitialize their budgets or reenter reads. Aliased public
arguments fail before output mutation, and revoked/invalid completion cannot
publish a snapshot or free another owner's physical lease.

`pet_p4_storage_lane` retains one physical catalog mutation through preparation,
durable publication and cleanup. Each job is bound to its original fixed-address
native scope as well as its task/serial; copied scopes cannot change phases,
unlock/relock or release occupancy. Live scope rebinding, lane/scope overlap and
an unidentified configured task are refused before mutation. Boot's deliberate
unconfigured synchronous fallback remains unchanged. Only the protocol worker's explicit command
owner token permits temporarily releasing its state mutex; boot/native fallback
calls cannot release a mutex merely because callbacks were configured. Filesystem
preparation and cleanup run outside the state lock, while publication merges the
latest in-memory save. Asset preparation is suspended before the first unlock;
normal UI rendering keeps its existing cadence. These are not evidence that
all Flash driver calls are preemptible. Storage scopes and the deferred save
worker now share atomic broker admission with realtime audio. Revocation stops
at the next checked I/O boundary; already-durable results still reconcile.
Cold UI activation queues an exact token on the existing worker, retains the
previous view during preparation, and cancels late navigation after exit or
selection replacement. Pending acceptance is not activation success. Busy or
unreadable saves never fall back to invented empty data.
Runtime publication and sprite snapshots use an explicitly initialized static
recursive task mutex instead of masking interrupts during large copies. All
52 sections are task-only; unrelated clock/ISR short spinlocks remain. Host
contention tests establish whole snapshots and fail-closed misuse guards, not
P4 priority inheritance, bus latency or frame-time acceptance.
See `tests/PROGRAM_RUNTIME_EXPERIMENT.md`, `tests/TRUSTED_SERVICES.md` and the
storage mutation/integration fault tests for the implemented boundaries.

`pet_p4_surface` provides opt-in bounded App viewport projection and clipped hit
testing. `pet_p4_renderer` clips palette images, panels and labels without another
framebuffer; `petui_viewport_test.py` and renderer sanitizer tests cover boundaries.
`pet_p4_app_cache.h` holds exact keys for static App frames, with or without
viewports, reusing the
existing background buffer; changing text, geometry or button state invalidates
the key. Animated images are excluded; confirmation/connection overlays stay live.

`main/pet_p4_side_scene.c/.h` provide the bounded tile-world fixed-step core;
`pet_p4_side_scene_json.c/.h` parse strictly typed declarations. The renderer and
PC WASM preview share its camera/animation draw list. The opt-in profile does not
change legacy game, microphone or AEC paths. See the side-scene tests and contract.

The capability report separates current input/graphics limits from legacy
limits. Shared runtime semantic vectors are checked by both PC and host tests.
`tests/petui_generality_smoke_test.py` covers same-page variable exploration,
bounded search and rejection of actions without visible feedback.

Named app-variable bindings share the same typed source for drawing, visibility
and input hit testing. Host snapshots are instance/sequence scoped and expire;
local state machines retain the existing path. New packages require an explicit
binding capability; microphone, audio scheduling and AEC configuration are unchanged.

`main/pet_p4_miniapp.c` owns transactional component storage and per-component recovery from verified committed catalogs. `pet_p4_selection.c` stores only the selected ID/catalog epoch in NVS; old selection files remain read-only migration inputs. Package catalogs and progress stay untouched during navigation. Unparseable existing catalogs block destructive bootstrap reseeding. Known image-free bootstrap packages are distinguished from complete resources.

`main/pet_p4_navigation_core.h` contains the bounded pure-C page stack shared with
the fixed PC WASM; `main/pet_p4_app_navigation.h` parses page-level declarations and
action conditions. Shared vectors test C/Python/JS behavior; full/empty stacks never
apply accompanying mutations. Host UI, services and game profiles are not implied.

`main/pet_p4_collection.c/.h` is a bounded, data-only keyed collection model,
compiled but not wired to a package/control route. Caller-owned off-stack views
preserve hidden selection IDs and full source records; failures cannot reset the
saved view. Fixed product WASM/native C and the independent existing Rust PC
service execute shared vectors. Its full validation is not a render-critical-path
or P4 timing guarantee; installed dataset/gesture/resource ownership is still pending.

`main/pet_p4_protocol.c` exposes resource integrity and bounded resource-repair installation. Repairs retain component records and existing button configuration, and refuse writes during audio activity. `tools/build_builtin_bundle.py` emits bootstrap identity checks without inflating the bundle. `tests/component_resource_recovery_test.py` executes production recovery logic with sanitizers; fault injection belongs in offline tests, never on user storage.
- `main/pet_p4_app_host.c` 普通命令携带当前宿主上下文，但不冒充用户确认；组合 v2 需显式协商。
- `tests/petui_activation_test.py` 执行实际组件导航分支，覆盖未知字段、音频忙及失败保留页面，不重装资源。
- `main/pet_p4_app_host.c` 隐藏视图立即失效，重入/序号溢出更换实例；重复回包不续期，变量版本保护帧间往返点击。
- `main/pet_p4_host_observation.h` 是仅限原生的输入观察快照，不是 wire 授权。组件 ID、版本、视图生命期、变量 epoch 和上下文在宿主锁内一次捕获；固定/滚动视图均使用。松开后的实际命令入口再次在同一个锁内核验身份及动作可用性，旧点击不能转而作用于新列表，也不冒充 confirmed。
- `main/pet_p4_host_render.h` 是无令牌的只读整份宿主回复快照。App/媒体渲染以一次运行时快照取得布局、变更图片、横版场景和确认提示，不在绘制中重新抓取另一个组件；输入观察/授权与渲染数据分离。`main/pet_p4_render_lifetime.h` 保留窗口重置前的长帧峰值和饱和计数，不将耗时或日志端点关联等同于根因。
- `tools/renderer_stack_budget.py` 对跨 renderer/miniapp/host/form 的已审查静态路径（当前 17 条）检查 4096 字节预算，保留编译器内联语义并拒绝动态栈/缺失入口。应用镜像构建前产生绑定 ELF 摘要的 `.stack-budget.json`，构建证据独立检查；不是全调用图、ISR、库栈或实际高水位的证明，不增加任务栈。
- `tools/firmware_budget.py` 的 `p4-allocated-ram-v2` 按真实 P4 内存地址区间统计所有非空静态段，包括第二 DRAM 段、TCM、LP SRAM 和保留/对齐字节；修正旧三段求和的漏算。构建证据独立解析 ELF，旧未标记算法的记录不再获准通过。384 KiB 静态上限、128 KiB OTA 余量不变；不等同于运行时可用堆或音频性能。
- `main/pet_p4_canvas.c/.h` 是固定指令/变量/span 预算的整数绘图核心，设备和预览 WASM 同源。`pet_p4_canvas_json.h` 严格解析数据声明；组件不持有原生回调、像素地址或 DMA。默认编译开关关闭，正常 surface 结构不增加绘图存储；独立 canvas candidate 才接入实际解析/渲染/协商。绑定使用同一宿主锁内的完整整数快照，缺失/过期不画，完整帧缓存包括其可用性与数值。离线与目标编译不代表帧耗时、语音/AEC 已验收。
- `main/pet_p4_surface.c` 多视口使用独立能力、严格归属和共享裁切；旧单视口及全部预算不变。
- `tests/p4_screenshot_integrity_test.py` 故障注入截图专用发送路径；普通音频/媒体仍使用原非 drain 路径。
- `main/pet_p4_file_cleanup.c` 仅在首次目录读取失败且所有权/活动 epoch 不变时允许一次独立完整重扫，保留首轮诊断、不混合位图、不重试删除；`tests/petui_spiffs_dir_error_test.py` 提取已安装 SDK 的真实 EOF/目录错误路径作离线对照。
- `main/pet_p4_app_store.c` 后台存档启动前同时观察普通播放、流播放、采集和实时对话状态；忙时保留待保存内容，不把单次观察当作音频资源所有权。
- `main/pet_p4_sched_trace.c/.h` 及 `pet_p4_sched_trace_rpc.c/.h` 已接入 CMake，但普通/UI 目标编译为空；仅私有观测目标显式开启五个 SDK wrap。1024 条原始环仍保留溢出标记，三个已注册长寿命任务另有独立的完整窗口 FS/返回位汇总；OTHER 不配对，跨窗口不续算，不将墙钟时间等同 CPU 时间或优先级。`pet_p4_sched_probe.c/.h` 仍是未接入 CMake 的旧实验。均不增加组件权限或更改任务优先级/亲和性；host 测试不等于实机开销、传输所有权或长帧根因已验收。
- `main/pet_p4_storage_policy.h` 将原有 SPIFFS 挂载内存值显式固定为默认 8；只有独立私有对照目标可试验 31 个描述符/缓存页，未提升普通/UI/Windows 目标。SDK 的 max_files 同时影响 FD 名称提示和页缓存，不能将结果归因于其中单项。上界避开已审查 SDK 缓存位图的符号移位；不改文件系统、数据格式、校验、原子目录提交或挂载失败不格式化策略。候选仍待实际堆、吞吐和绘制对照。
# Private query reply boundary

`pet_p4_ota.c/.h` 的默认关闭 metadata 观测在可信启动/有效性确认结果处更新，
热查询只复制内部 DRAM 的两个标量，不等候长 OTA 锁、不进行 Flash/MMU 操作。
启动分区观察仅在原生 setter 返回后更新，失败则不可用；实际校验和回滚不变。
`tests/p4_ota_observation_test.py` 编译实际 init/process/status/getter 分支，覆盖
SDK 错误、未知结果、不假报有效、原回滚门限及 cached/default-off 对照。

`main/pet_p4_native_panic.c/.h` 是默认关闭的 144 字节 RTC 数值异常观测。
仅保存同一构建的 PC、返回地址、异常类别和核心，不保存原因文本、堆栈、
寄存器数据或用户内容；原 SDK handler 以原参数执行一次，复位、打印、
看门狗策略不变。私有 profile 需验证实际调用重定位、IRAM/DRAM/RTC 放置。
它不授予恢复、重发或清空数据权限，也不是异常根因已修复的证明。

`main/pet_p4_flash_phase.c/.h` 是默认空对象的私有 SDK 擦除阶段边界，
只包装原调用一次并保留参数、返回和 errno，不替换驱动、不重试、不改看门狗。
必须核对 ELF 重定位与实际选中芯片 callback 覆盖；固定数值阶段不是故障归因。

`main/pet_p4_storage_snapshot.h` 为默认关闭的只读诊断统计快照，失败/时钟倒退保留
旧值并显式标记陈旧，不参与写入授权。私有 storage-query 对照由现有存档线程的
固定原生 housekeeping 钩子在 flush 返回后锁外刷新，音频忙时跳过；查询不等待 FS。
`tests/p4_storage_snapshot_test.py` 编译实际查询、刷新和 worker 分支，验证锁外顺序、
默认关闭、旧字段与错误保留。RTC 阶段另覆盖原生分配和 HAL 调用，不能当故障归因。

`main/pet_p4_reset_record.c/.h` 是默认关闭、244字节、无 IO 的 retained-word codec；
`main/pet_p4_reset_phase.c/.h` 将固定原生任务和临界区外阶段绑定到它，不暴露 wire
写入入口。原始 ROM 双核复位原因与历史同构建阶段仅供只读诊断，不是设备认证或
根因证明。`tests/p4_reset_record_test.*` 覆盖逐字中断写入、校验/版本/启动/actor、
饱和及默认空对象；adapter 测试使用明确 SDK stub 模拟 BSS 重启，不能替代真实
RTC linker/保留/时间验收。看门狗配置、优先级、数据与音频发布语义均保持原值。
稳态入口、上下文门禁及完整记录调用链须在 IRAM/ROM，状态在内部 DRAM/RTC；
原生 CLIC 门限不等于全局 IRQ 开启，故另检查 MIE 和 SDK 缓存状态。未通过门禁
不读任务/owner、不写 RTC。实际 ELF 检查不能被 host stub 测试代替。
`main/pet_p4_reset_cost.c/.h` 仅私有目标开机测 32 次 enter/leave，分组让出 CPU，
不访问文件、网络或音频，不改频率、优先级和看门狗；显式 `includeRecorderCost`
查询只读不可变结果，包含抢占、不等于 CPU 时间/WCET。cache-hit 对照仅收粗
软件命中阶段，不改变物理读取/填充、字节校验、失效、errno、取消或写入权限。

`main/pet_p4_file_exact.h` provides bounded two-segment physical file comparison
with exact EOF and cancellation. The private unchanged-install gate uses a
fixed-address/task-bound HAL cache bypass, retains every legacy mutation path,
and never equates checksums with identical bytes. No public execution grant.

`main/pet_p4_query_reply.h` owns the default-off immutable diagnostic reply and
numeric previous-query timing contract. `pet_p4_protocol.c` retains the original
entry as a synchronous compatibility wrapper; its shared dispatch never stores
a temporary sender/context. `pet_p4_diagnostics.c` releases its mutex before TX;
the private main worker also releases runtime state before sending once. Tests
exercise actual serialization, allocator failures, both APIs, all trace/defer
build combinations, route preservation and numeric saturation without hardware.

`main/pet_p4_rgb565_blend.h` is the default-off exact raster candidate. Its
renderer-owned 128-byte channel lookup keeps every RGB565 rounding step; three
disjoint rounded-mask spans retain the original AA corners without double
compositing. Font sampling uses fixed 64-column/512-byte renderer scratch,
retaining float coordinates, bilinear order, weight, clipping and glyph release.
No task, allocator, DMA, audio or lifecycle authority is added. The private
`esp32_p4_raster_parent` retains asynchronous startup but does not enable the
unsuccessful spare-recreation experiment. `tests/p4_raster_exact_test.py` compares
all destination words/alpha values and actual old/new rectangle and glyph paths;
host pixel equality alone is not a hardware long-frame acceptance result.

The private `esp32_p4_delta_parent` additionally checks alpha endpoints before
channel divisions and bursts constant-alpha rows through only 16 stack pixels.
It can reuse an already-written, unreferenced spare JSON generation only after
the same storage owner checks and exact bytes/EOF comparison through the scoped
product HAL bypass. A boot-volatile 66-byte positive write filter avoids added
read scans on unknown/new generations; neither that filter nor a checksum can
authorize reuse. Cancellation/close failure cannot report a match. The current
generation, full readback/parse, save merge and atomic catalog publication are
unchanged. Both optimizations default off, have no new grants/tasks, and retain
all existing frame/memory/OTA gates. `p4_alpha_fast_test.py` and
`p4_spare_exact_reuse_test.py` cover actual C branches, cold writes, corrupted
targets, hash collisions and failure/cancellation paths; real throughput and
acoustic acceptance remain separate from host tests.

The default-off `esp32_p4_glyph_rows_parent` candidate additionally reuses two
source alpha rows within one glyph/tile in 532 bytes of renderer-owned DRAM.
It retains the original float coordinates, bilinear expression order, weight,
clipping and source lifetime; it does not retain a glyph or bitmap pointer.
Widths above 64 take the unchanged per-pixel sampler. `p4_glyph_rows_test.py`
compares actual old/new native/atlas/symbol/fallback paths byte-for-byte and
counts source samples independently; no font content, task, DMA or permission
changes. Source-read reduction is not a P4 frame-budget acceptance result.
Its 1,536-byte label layout scratch also belongs to the same serialized renderer
in PSRAM, rather than the nested UI stack. Sequential-label placement/wrapping
is checked against the original stack-backed implementation.

`tools/compress_font_metrics.py` canonically/losslessly packs all 21,208 existing
licensed metric records. No glyph, advance, map, kerning or attribution changes.
Only that private profile enables `PET_FONT_METRICS_PACKED`: the existing
before-input/audio/render initializer reconstructs numerical fields in fixed
PSRAM, with exact input/output/checksum and bitmap extent checks. It never treats
serialized bytes as a portable C bitfield ABI, publishes ready only after both
bitmap and metadata pass, and latches/clears failures without retry or allocation.
Ordinary/unpacked builds retain the original C descriptor table. The actual
record identity/ABI, decoder faults, reentry and truncated assets are covered in
`p4_font_metrics_test.py`; P4 boot/placement/frame/audio gates remain independent.
The asset must be declared in both CMake and `board_build.embed_files`: the
PlatformIO/SCons graph generates its assembly independently of CMake's graph.

The private `esp32_p4_span_target_parent` retests the existing exact opaque span
stores on the current shared execution parent. It does not change ordinary
builds, opacity rules, frame budgets, task priorities or audio policy. Its
`PET_P4_SPARE_TARGET_FILTER` keeps boot-volatile successful-write CRC/length
metadata for each actual spare JSON path. This is only a rejection filter;
reusing a candidate still compares physical bytes and exact EOF under all
existing storage ownership/non-live-generation guards. The live other
generation's CRC is not evidence about this target. Cold targets and failed
writes retain the original path; old filter mode and failure vectors remain.

`pet_p4_app_draw_trace.h` adds default-off numeric image/key/copy/clear/cache-save
and per-node wall observations to the same renderer frame/peak. RAII scopes also
end on continue/return. No text, IDs, paths or values are logged, and only the
existing peak/gap cadence emits a bounded line. These observations include
preemption, never subtract from or reset lifetime gates, and are not CPU-time
or causal proof. `p4_app_draw_trace_test.py` covers clock faults, saturation,
same-frame capture, scope exits and worst-case formatting/truncation.

Private `esp32_p4_budget_parent` adds `pet_p4_native_work_window.*`: one static
binary semaphore for pure native compute versus drained control/snapshot TX.
Compute only tries admission after model acquisition and media processing;
retirement still runs and no task priority is inherited or changed. Audio/media
bypass this window. No program, IO, register or package authority is added.
All ordinary profiles keep it disabled; source/emitted/physical timing gates
remain independent of the concurrency tests.

`PET_P4_STORAGE_PAGE_CACHE_PARTIAL` reuses only contained byte slices from a
previous successful full-page snapshot, with the same pins, owner, epoch and
physical bypass. It adds no physical read or existence result. The optional
completed-IO observer retains at most three native caller windows (under 2 KiB)
and atomically returns one actor's read/write/erase counters. Its immutable
generation is separate from a later save window; it is diagnostic, not storage
authority or durability. Query timing also identifies native debug/hello/
activation intervals numerically, without exposing their payloads.

`PET_P4_APP_CACHE_POPULATION_BUDGET` can defer only the optional background-cache
copy after a slow draw. It never omits current pixels or publishes an unmatched
cache key. Partial redraw retains its previous exact key/bytes when population
is deferred; a later fast draw can populate normally. No additional framebuffer
or relaxed frame budget is used. Unmeasured performance is not acceptance.

- D 集成：`main/pet_p4_miniapp_d.inc` 为通知与 data.refresh 的实例内出站钩子；form3 写回/恢复保留非表单 quota v3 长字符串，调用端用锁保护的 PSRAM workspace。定向测试为 `tests/petui_d_entrypoints_test.py`。

Native font storage follow-up: `tools/compress_font_kerning.py --check` verifies
`pet_p4_font_kerning_sparse.h` against both complete original arrays. The packed
metrics startup parent expands 73 sparse class pairs into two 21,208-byte PSRAM
maps and verifies their combined FNV before rendering starts. All glyph IDs and
kerning class values remain byte-identical; no glyph-time work is added.

`main/pet_p4_miniapp_observation.inc` supplies request-bound read-only content digests; `main/pet_p4_miniapp_alarm_boot.inc` stages saved hidden alarms on explicit per-boot worker grant. Neither starts hidden programs or changes task/stack policy.

组件 OTA 修复：`pet_p4_component_media.c` 对空媒体 staging 跳过不会增加用量的全设备预算扫描，避免普通计数器提交执行 896 次 SPIFFS 路径查询。仍校验 staging、阻止覆盖待发布事务、清理目标备用代；实际媒体包保留原预算上限与检查。`tests/component_media_budget_test.py` 验证查询数、清理与拒绝边界；离线通过不代表已刷入设备。

图片组件提交（r157 开发修复）：仅在当前存储命令持有未锁住状态通道、且目标 slot/generation 不被当前目录引用时，图片直接写备用代，替代临时文件和重命名；每次最多写 4096 字节并在 VFS 返回后让出一个 RTOS tick。整包物理回读、校验和、解析及 A/B 目录发布顺序保留；旧同步初始化路径仍使用原子文件写入。该更改尚待用户设备验证，未宣称已消除故障。

## Service bridge candidate routing

`main/pet_p4_service_bridge.h` owns the default-off
`PET_SERVICE_BRIDGE_ENABLED` bounded timeline/image core;
`main/pet_p4_service_bridge_json.h` owns its strict presentation parser.
app_host/surface/renderer/miniapp/protocol use the existing host-view identity,
legacy host scalar projection or explicit candidate service capability and
host_contract pairing for dynamic images/timelines/event parameters/local-media.
All numeric zero forms frame as i0; (other finite floats retain binary framing).
The image path uses request-correlated
app/image ACKs and immutable image leases. Only the independent
esp32_p4_service_bridge_candidate opts in; normal firmware is not opened.
See protocol.md and ../pc/skills/petui/references/service-bridge.md for quotas,
revocation/no-replay rules and local-media boundaries. This documentation does
not claim complete firmware/HIL acceptance or alter timing/memory gates.

安装失败隔离（r158 开发）：存储命令释放状态锁后，既有 RX 任务可处理严格白名单的 RAM 心跳、组件清单与缓存诊断；序列化在状态锁内完成，传输在锁外，任何 mutation 仍只走原命令队列。延迟 ACK 按真实任务所有者隔离。仅存储协议任务在原生 HAL 返回、cache/observer 临界区结束后每 10 ms 让出一 tick，使 GC 不持续饿死 idle；不改变错误码、不中断原生 GC、不自动重放。已知失败的当前未发布图片尽力删除其部分分配，旧目录/当前代和存档保留。实际断连、空间与后续同步恢复尚待用户设备验证。

### 2026-11-03 review fixes (source/offline scope)

The renderer retries only missing native output buffers after partial allocation
failure, preserving successful buffers and the current LCD reference. Cold APP
panels use exact gradient spans only on the three disjoint cover=1 interior
rectangles; corners, strokes and invalid radii retain the SDF path. The keyframe
worker retires its prior ready tag before overwriting its single output, so failed
decode cannot expose partially replaced pixels under an old frame identity. Big
image slots retain original RGBA palette bytes before RGB565 blending (8192 bytes
more fixed PSRAM across 32 slots, no added internal RAM or tasks). Focused host
tests execute the actual functions with sanitizer coverage, pixel comparisons and
allocation/decode fault injection; these checks do not establish device frame,
heap/DMA, worker-stack or 1200-query acceptance.
The APP clip pin now retains ownership of the shared H.264 job across frame
entries; hidden/generation/page-exit paths still retire it, and transfer frames
still cancel preparation. Node overlap totals include all admitted 48/64 trace
slots with saturation, rather than only the first 32.
Clip visibility uses the same shell-page and viewport projection as node drawing;
ordinary asset-read reclamation continues while a clip owns the shared decoder.
Keyframe decoding and PROGRAM slice admission now exclude one another under
the existing asset mux. Diagnostic node arrays cover all admitted slots, with
additional exact u32 mask halves while retaining the legacy numeric mask.
Visible runtime cell grids remain live outside whole-frame cache authority:
a 32-bit grid change hint cannot prove identical pixels. Hidden/off-page/outside-
viewport grids do not disable an otherwise static current page. Host images
retain their existing snapshot epoch key; successful service rendering consumes
a pending first-JPEG clear before subsequent nodes. Independent static prefixes
may still be reused. A keyframe background swap retires partial row population
and the old exact-key validity together. The unchanged 4096-byte static-path
guard now additionally covers panel scratch and cache/clip visibility (17 paths).

- r162 candidate: fixed public control-only UART pacing in `pet_p4_uart_pacing.h`; no-drain audio/media unchanged. Added `p4_uart_control_pacing_test.py` and actual SDK `p4_aux_metadata_bss_test.py`. Renderer static evidence v4 covers all 17 reviewed paths; historical schema consumers remain compatible. All 29 factory defaults retained. Hardware/release acceptance requires separate evidence.

2026-11-03：pet_p4_audio_volume* 提供读取真实 DAC 寄存器的有界总音量与空闲 NVS 保存；SDK 三个固定哈希源码仅复制到构建目录后修复错误传播，不原地修改依赖，不改变 AEC/DSP/PCM。widget_data 新增通用 clearOnExpire 和 8 个 PSRAM 有界源槽；过期/回退时不再提供受保护快照的旧行。main/CMakeLists 绑定生成源码与输入哈希。

工厂布局 v2 为32MiB：双3MiB OTA + 8.875MiB组件/元数据 + 双8.5MiB形象。build_factory_image 和 package-factory-release 同时核对生成分区表；旧20/18MiB形象布局只识别为历史布局，不能用普通OTA迁移。组件容量保持比旧设备增加2MiB。

OTA 客户端发送前按设备真实分区检查至少128KiB余量，旧2.5MiB布局不会被当作3MiB。当前测试机允许全新部署，无需以备份为前提；普通用户数据保全迁移仍是单独流程。

2026-11-03：R163 renderer 常规成功/性能/context 日志统一为 DEBUG；V1/V3 生产默认及最高 INFO，因此不会为正常绘帧等待共享协议 TX 锁。WARN/ERROR、故障及帧/gap 指标和计时边界保留。未改 transport mutex/framing/pacing、codec、DSP/AEC 或任务。

2026-11-03：P4 CPU暖重启生命周期修复：CORE priority0 在 init_heap100 前清理未拥有的旧 AHB group0，保留固定数值 before/after 快照及 C getter；不新增 wire 字段、不改计数/验收门槛或音频热路径。V1 IDF5.5.1 restart 仅通过固定哈希校验的构建目录副本回移 V3 已有 AHB reset SET/CLEAR；SDK 原件/V3 原生实现不改。仅离线检查不代表启动/OTA/设备验收通过，事故 fault12 及原 fault11 失败保留。

只读早期 DMA 数值证据：`diagnostics/query` 显式携带 `includeBootDma:true` 才附加 `bootDma`，从不可变 C 快照序列化3对 AHB 通道的 before/after 链地址、EOF/state、dw0 原值及 size/length/owner/successEof。查询不读 MMIO、不复位、不触碰 NVS；普通轮询及组件/持久化数据格式不变。dw0 是 CPU 内存视图，不能单凭该值宣称已证明 DMA 根因。

2026-11-03：scene sprite 临时节点显式初始化 big=-1，沿用普通图片节点的未使用哨兵，避免启用 PET_P4_BIG_IMAGE 后被默认 big=0 误分流并消失。所有 scene_view 精灵通用修复，不修改云端跳一跳资源或游戏逻辑。此修改尚未进入 R164 已发布镜像，后续须使用新固件标签构建。

2026-11-03：素材兼容复核：普通图片优先使用有效 image 索引，只有 image<0 且 big>=0 才进入大图分片绘制；scene sprite、壳导航及 PC 集合的合成节点保留 big=-1 哨兵。PC 集合标签补 text_id=-1，避免与长文本块0共存时被分页内容覆盖。未重生成组件素材、未改变组件 ID 或游戏规则，尚未构建/刷入新固件；只做代码审查与 surface.c 语法编译，不执行回归/实机验收。

2026-11-03：组件绘制复核：scene_view 与调用方裁剪取交集，角色仅完全离开时跳过；部分越界保留可见像素并恢复原裁剪。动态大图/短视频是否缓存与图层插入边界解耦，仍禁止这些媒体复用整帧和静态前缀，背景之后再画 scene/canvas。clip pack 期间取消后停止交付；粒子动作及状态复用绑定原生 g_image_revision/g_surface_revision，无粒子时清空。renderer_note_action 的声明、stub、caller 与既有源码契约同步；没有新增任务/音频处理或更改预算。尚未构建、刷机或回归。

Native32 candidate: `docs/font-native32.md` describes the default-off
`PET_FONT_NATIVE_32` path. `pet_p4_font_cn_32.c` retains PR12 native 32px
2bpp data for 199 glyphs; all 21,207 existing font16 glyphs remain intact.
`compress_font_native32.py` and `compress_font_metrics_columns.py` verify
lossless resources. Column metrics borrow the bitmap buffer only during
startup, before bitmap decode; font32 reuses the single inflater. Final
V1/V3 image size, old-slot headroom and device frame acceptance are separate.

2026-11-04：R172 审查候选同步 CMake、默认 evboard 与 public candidate 的版本。后台 PROGRAM 的 cells 提交同步到可见网格；会话期间闹钟通知保留到可展示时再消费；raw asset 冷缓存的临时分配失败允许恢复。音频 begin 使用同一 capture reservation 下取得的 owner 快照。factory builder 校验当前分区表的 MD5、完整性与精确分区集合；分区容量不变。新增确定性交错、连续 cells-only 提交、OOM 恢复与分区表负向回归。形象激活保留 owner、代次与存储工作租约，锁外准备并校验快照、写入标记，短锁发布并在锁外确认；正常激活不再扫描清理 legacy 全目录。无效上传 begin 保留已接受 staging，最终 close 失败返回失败。目录写入在可能已经改变持久代次后失败时进入只读恢复隔离，不伪称已提交或回滚删除；实际 sealed 代次决定重启恢复。Manifest 解析前拒绝真实文件字节中的 NUL 截断。静态构建、静默、显式激活与 I/O 重叠、各芯片硬件和声学验收分别记录。

2026-11-04：组件安装提交不以触屏硬件就绪状态为前置条件；触屏组件可以先安装，实际切果输入仍要求触屏就绪。包解析、资源校验、存档兼容、物理提交和空间边界保持不变。

全局提示音通过独立音频命名空间持久化，所有形象共用；音频下发保持视频和形象槽不变。

### ESP32-S3 A4 port (official 0.1.201 baseline)

The S3 port keeps the fabricated A4 GPIO mapping and official SW1-confirm,
SW2-component/realtime, SW3-back, analog joystick and center-press behavior.
There is no three-button action menu or virtual touch pointer. The client
exposes joystick bindings and uses fresh `s3j_` preferences.

`input/config` writes on S3 require `inputModel: "s3-a4-buttons-joystick-v1"`.
Old clients receive a failed ACK before any NVS write. A4 input settings use
`pet_input_a4j1`; Wi-Fi, pairings, packages and saves keep their existing stores.
Read-only `input/config-query` reports the model and 16 bindings. P4 keeps its
official protocol/configuration behavior.

The S3 MAX98357A uses software master volume with the shared official persistence
and protocol logic. P4 ES8311 vendor patches and AHB restart workarounds remain
P4-only. The S3 OTA partition remains 0x300000 bytes per app slot.

The S3 80MHz r12 trial converts exact-2x I420 assets through a bounded 320-pixel
stack row, cleans background at native size, then duplicates into the existing
logical canvas. BT.709 pixels, edge-only cleanup and generic/P4 sampling remain
covered by presentation regressions; no extra full-frame buffer is allocated.
Read-only diagnostics expose coherent completed-frame `runtime.renderStages`
from the existing timing boundaries. `decodeUs` and `convertUs` are nested inside
`assetUs`, and `gapUs` precedes the frame; they must not be summed into totalUs.

S3 landscape r13n adds native 320x240 home composition. Exact-2x H264 writes a
153600-byte clean native PSRAM asset layer; overlays project the original
logical coordinates directly onto native pixels, preserving the old final even
sample. Host RLE text shares the scale-aware pinned blitter; its old API retains
scale1 behavior. Native home bypasses logical compact/queue caches and final
downscaling; components and legacy/non-2x media retain their compatible logical
paths. Native allocation failure falls back to logical composition. Transfer
rendering clears native context; an explicit logical screenshot access expands
the successfully presented native image on demand. Completed-frame diagnostics
publish nativeComposition/nativeAsset flags under the existing metrics lock.

S3 landscape r14c reuses each I420 chroma cell across its 2x2 luma pixels and
quantizes directly to RGB565 with exactly the prior integer/clamp result.
Two native rows and their Y/U/V scratch replace repeated PSRAM reads in the
exact-2x native home path. Custom H264 assets fitting that path benefit too;
legacy/non-2x/JPEG and P4 keep their compatible paths. No new background
segmentation or floor/shadow removal is enabled: the r14b matte trial was
withdrawn to preserve authored animation effects. Existing edge-only cleanup
is unchanged. Exhaustive YUV equality and native-versus-logical guarded pixel
tests include an authored dark floor and enclosed dark foreground details.
S3 landscape r15 retains the clean native home layer across page changes with slot/revision/storage-epoch validity. Only actual conversion publishes it; playback reset and transfer invalidate. A missing first frame can retain the previous successful LCD pointer/index for up to 2000ms; expired waits show loading/unavailable text. Approval visibility or changes prohibit retaining the previous frame. Completed metrics include nativeAssetReady/nativeHeldPrevious. Built-in r14b connected matte is restored at user request; custom appearance policy stays unchanged. Component media retirement and all resource limits remain.

S3 r16d routes USB/UART/Wi-Fi raw appearance ingress through the task-scoped storage phase using the protocol-worker IO adapter. The legacy raw entry remains fail-closed; S3 no longer drops the first raw body after granting readiness. The coordinator regression now models that closed entry and verifies scoped IO handoff. Display, A4 pins, protected appearance slot and partition sizes are unchanged.
