gmingtian/HachimoDock-esp32s3/pc/.folder.md

# Desktop source (0.1.203)

- USB state/speech forwarding matches a bound bus session's bare ID with the
  same Agent's prefixed rollout ID (`codex:<id>`). It strips that Agent's prefix
  once only; different Agents, sessions and empty IDs remain isolated. This
  prevents completion/idle updates from being filtered after session binding.

- Linux runtime discovery holds DTR/RTS asserted only for the identified
  Espressif native USB-Serial/JTAG VID/PID 303a:1001, including resolved port
  aliases. This avoids S3 scan-induced resets and handshake write timeouts.
  External USB-UART and macOS retain their existing modem-line policy;
  Windows uses its separate unchanged implementation. No flashing sequence
  or firmware/configuration write is involved in this connection fix.

- Local `local-clawpkgs/xiangqi-a4` uses the shared native C/WASM Xiangqi
  engine, three AI levels and legal-destination guidance for all seven pieces.
  Only Xiangqi preview work runs at 8ms; unchanged search frames avoid React
  commits. Native installation and r15-to-r16 OTA acceptance are explicit,
  ignored tests in `usb_serial/xiangqi_install_hil.rs`.

- Local-only `local-clawpkgs/gomoku-a4` packages the existing native 15×15
  Gomoku engine for A4 controls; it is imported into the formal library and
  installed through the production transaction, without changing builtin
  inventory or r15 firmware. Explicit hardware acceptance lives in the
  ignored `usb_serial/gomoku_install_hil.rs` test module.

- Explicit authorized Gomoku publication uses the unchanged native community
  credential and safety boundary. The ignored `community/gomoku_publish_hil.rs`
  runner records service acceptance separately from harness execution: a test
  pass can accompany a recorded server rejection and must not imply publication.

- Codex Desktop history is readable even when the CLI needed to launch turns
  is unavailable. Ordinary replies close the turn silently. A completion cue
  requires successful work evidence from the same turn: a file change, image
  generation, or a successful tool call explicitly marked as a write.

- USB transfer JSONL uses a central bounded diagnostic schema: numeric/boolean
  metadata and fixed labels only. Paths, content hashes, stable identifiers,
  arbitrary errors and unrecognized nested peer fields are excluded.

- PC-online program autostart binds explicit consent to exact board/content,
  native checksums, boot and connection generation. One bounded native worker
  handles connection/preemption events outside RX; the formal-library and USB
  guards span revalidation and one fixed start payload. Journal unavailability
  disables only this optional service. USB status exports exact string u64
  connectionId and validated bootId; ended music still blocks component sync.

- Serial probes propose a fresh bounded connection nonce on the existing bind;
  an offer-capable board must echo that exact nonce in a guarded HELLO before
  admission. Confirmed sessions keep it in later ACKs and reject stale/downgrade
  HELLOs before any waiter. Boards predating negotiation retain their legacy
  framed/plain behavior. Malformed proposals never become a silent legacy reset.
  This is downstream corruption detection, not authentication or task replay.

- Explicit framework uploader acceptance is separate from the read-only
  graphics transport acceptance. It uses the actual production installer for
  one exact independently authored silent fixture, pins board/boot/ELF and all
  package bytes, and only removes that fixture with preserveSave after a known
  successful commit. Unknown results are retained without mutation replay.
  It does not run automatically, read user stores, or authorize new services.

- Unparsed-line diagnostics now retain rare exact-prefix firmware fault hints
  independently of generic text rate limits. Only fixed categories/counts are
  logged, never the original text, task names, pointers or private payloads.
  Hints are not authenticated reset evidence. Explicit diagnostic acceptance
  failures may make one NEW bounded read-only identity observation to separate
  a reboot from a lost reply, without clearing failure or replaying any query.

- Experimental downstream serial control integrity verifies original raw body
  length/FNV before UTF-8 and JSON, then latches the verified HELLO policy for
  that exact connection before resolving any waiter. Legacy boards stay legacy;
  a later HELLO cannot downgrade a required policy. Audio/media and four exact
  existing screenshot reply topics retain their independent paths. This is
  accidental-corruption detection, not authentication, upstream protection or
  permission to replay an unknown mutation. Numeric-only logarithmic rejection
  diagnostics never retain payloads, hashes, IDs or paths. The actual reader,
  byte/timeout fragments, legacy tail and shared C/Rust UTF-8 vectors are covered
  by an exact offline test allowlist; no ignored tests, GUI or device startup.

- Private installed-program control uses typed, sanitized native status and
  exact string uint64 registrations. Real USB methods read complete inventory
  and verified installed checksums before a single explicit start; stop keeps
  the observed boot/registration. Unknown results are never replayed. The
  React provider only appears with explicit capabilities; hidden UI stops
  observation, not the device task. All three commands use the existing
  local-only Tauri permission, never a community/remote bridge grant.
- Offline source evidence now includes all Tauri permissions/capabilities,
  build.rs and platform configurations, not just native and frontend source.
  Browser/mock and synthetic writer checks do not certify real GUI/device
  operation, resource mixing, sound or AEC.

- Screenshot writer failures may additionally carry one fixed bounded numeric
  observation, mapped to allowlisted budget/driver/drain/lease/audio categories.
  Unknown fields/text/types and impossible counters are dropped. Tick counts
  are not relabeled milliseconds; the collector never turns this into success,
  a longer deadline, task replay or permission to recapture another frame.
  Only an exact current snapshot/index with a fully validated zero-byte mutex
  refusal can re-read that same immutable block: original three attempts,
  read/event bounds and 25-second total budget remain. Wrong/missing metadata,
  partial writes and all other device errors still fail closed.

- Screenshot failures preserve allowlisted expiry/revocation/close/TX/identity
  categories without retaining arbitrary device text or extending any budget.

- Explicit read-only transport stress retains rejection metadata in its private
  output directory (bounded rotated log). Raw protocol contents stay disabled.

- Explicit local graphics acceptance may opt into 1..600 read-only diagnostic
  requests through the actual Rust live reader before its one screenshot.
  Exact waiter/board/firmware/monotonic-uptime checks never resend a failure;
  a numeric-only separate checkpoint survives timeout. This is test-only,
  default-off, not a whole-wire CRC proof, task replay, audio test or release
  gate. A separately negotiated control policy can now establish the narrower
  controlQueriesIntegrityConfirmed only after every requested query matched;
  rawIntegrityConfirmed stays false for the overall mixed transport.

- Probe and live readers preserve a frame's original UTF-8 validity through
  protocol parsing. Lossy boot diagnostics cannot repair corrupt JSON into an
  accepted identity/ACK; properly encoded U+FFFD and the next valid frame remain
  supported. The framing tests execute the actual production reader/parser gate.

- Unparsed serial lines now yield bounded categorical/count diagnostics per
  probe/live connection, never body text or content hashes. Each class logs its
  first occurrence then powers of two; boot/SDK text is not labeled corruption.
  These observations neither salvage a frame nor repeat a command. Shared
  offline graphics/transport tests compile the same metadata implementation.

- USB baud fallback reuses one reader/writer pair on macOS and Windows.
  The first usable baud on a recognized P4 serial bridge allows up to 40 seconds
  for cold boot and exits as soon as the current HELLO is verified. Later baud
  attempts stay short and keep the same OS handles. Unknown ports retain their
  existing discovery budgets.

- Serial probing hands the same buffered reader to the live reader thread.
  Successful hello parsing no longer discards prefetched bytes of subsequent
  frames. Regression reproduces the previous loss and preserves every byte at
  several buffer/fragment boundaries. No corrupted-frame salvage or task replay.

- Product/authoring program WASM remains the same C interpreter with fuel-only
  scheduling by the explicit preview turns. Native device deadline checkpoints
  do not add user clocks/imports, alter arithmetic, or imply a device time gate.
  The offline runner includes native deadline/clock/reentry/continuation tests.

- ProgramAppPreview latches foreground suspension across focus recovery, stops
  ordinary ticks, cancels text drafts and rejects stale input until explicit
  activation. Legacy non-program previews are unchanged. The mixed contract
  tests the production lazy preview, form editor and same-C program together.
  Authoring reports structurally disabled one-field/one-character operations
  explicitly, but still checks all other surface, swipe and physical actions.

- `app_component_program.rs` validates the candidate integer program declaration,
  unique model writers, typed events and actual device capability at installation.
  It is schema-only, not a second interpreter or source of execution grants.
  Product preview and authoring smoke use the same C core; ordinary firmware
  and current unreviewed UI execution remain closed.

- `app_host_collection.rs` validates the opt-in host collection declaration,
  strips full records from visible publications and keeps the existing 2048-byte
  app/snapshot budget. The composition source owns records/selection in its
  existing private state; oversized publications report no row actions and do
  not trim records or repeat mutations. Install checks require the new explicit
  device capability; ordinary firmware remains unsupported and unchanged.

- Device-bound JSON string values/keys cannot contain decoded NUL: the Rust
  package entry, Python authoring validator and mirrored JS preview refuse it
  rather than truncate or repair it. Private PC JSON and binary data are not
  subject to this device C-string guard; literal backslash-u0000 stays valid.
  Shared vectors are in `skills/petui/contracts/device-json-strings-v1.json`.
  `device-json-unicode-v1.json` additionally compares raw UTF-8 and paired/lone
  surrogate escapes across native/serde/Python/JS. Authoring/preview reject lone
  surrogate values before UTF-8 sizing/state publication, without normalization.
  `device-json-depth-v1.json` binds the device input limit of 32 object/array
  containers in source/previews/authoring/package validation. Private PC files
  remain outside that device bound; failures preserve input and old state.
  Device-file parse failure is explicit, never silently treated as an absent
  optional value; diagnostics contain canonical file role/reason, not payloads.

- `src/component-center/program-core.js/.wasm` and generated `program-bytes.mjs`:
  offline authoring API over the exact native bounded interpreter, fixed memory,
  no ambient imports or effects. Not loaded by old components, not a device grant.
  `scripts/build-program-runtime.mjs --check` verifies the product/skill copies;
  `skills/petui/scripts/program-preview.mjs` accepts bounded synthetic stdin only.
  Ten shared pure-logic vectors match native C at three instruction quanta.

- `scripts/build-framework-evidence.mjs`: explicit two-target development build
  receipts, source consistency, exact ELF/image association and ELF RAM budgets;
  no device, installer or public release operation.
- `scripts/test-framework-offline.mjs`: reviewed host-only storage scope ownership
  cases execute the production lane under sanitizers, including copied/live
  context rejection. They never install a package, use user files or test audio.
- `src-tauri/src/component_runtime_lifecycle/resource_broker.rs`: synchronous
  native resource contexts use 16 fixed thread-local frames, exact registrations
  and retained children under out-of-order cleanup. Refused nested contexts
  deny storage instead of inheriting an outer/anonymous grant; full cleanup
  permits fresh explicit contexts, never resets cancelled owners. Physical
  permits remain held until real work returns. Serial exhaustion refuses without
  poisoning the broker. No connector, credentials or package capability opens.
- `scripts/framework-stack-evidence.mjs`: pure fixed-budget validation of reviewed
  compiler-frame paths and exact ELF binding; no arbitrary paths/extra text in
  exported records and no claim of all-edge or runtime high-water coverage.
- `scripts/verify-framework-evidence.mjs`: bounded explicit-file coherence checks
  across offline, build and optional screenshot evidence; metadata-only output.
  It cannot turn skipped tests, absent provenance or hardware/acoustic gaps into
  framework completion.
- `src-tauri/src/graphics_capture_identity.rs`: bounded read-only boot/build
  observations, exact request and late-error preservation, no task replay.

- src-tauri/src/acoustic_acceptance.rs: explicit ignored physical tests using
  production USB, local synthetic sources and metadata-only receive diagnostics;
  no cloud credentials or recorded PCM files. Never run by default.

- src: React UI, generation pipeline and regression tests.
- src-tauri: native device, audio, desktop integration and local configuration.
- src-tauri/src/component_composition.rs: bounded, package-declared data sources,
  typed variable projection, isolated atomic state and a limited public-GET pool.
- src-tauri/src/component_ledger.rs: generic timestamp records, day/event units,
  progress/history and confirmed latest-record removal; never package user data.
- skills/petui/contracts: shared cross-interpreter semantic and validation vectors.
- `scripts/build-collection-runtime.mjs`: fixed cv_* export ABI, 256 KiB memory,
  no imports/growth; native owned-model fast/lifecycle APIs are not exported.
- src-tauri/src/component_external_outcome.rs: default-closed native outcome
  orchestration, bounded private metadata, durable-claim contract and read-only
  reconciliation semantics; no registered connector or package route.
- src-tauri/src/component_external_outcome/file_journal.rs: unregistered native
  Linux/macOS append-only private journal, cross-process CAS and sync barriers;
  128-slot directory and 128-record limits retain corrupt/unknown/full logs.
  Not a grant or Windows fallback.
- skills/petui/references/app-navigation.md: independently negotiated local page
  history; native validation, authoring checks, preview and sync gates match.
- src-tauri/bridge: local Agent session event bus and receipt handling.
- builtin-clawpkgs / new-components: public widget packages and source assets.
- scripts: resource preparation, tests and public distribution checks.

Public source uses user-provided credentials and per-computer networking settings. service_credentials.rs only rejects a legacy non-secret placeholder; it does not supply service defaults. Configure your own service keys in API settings. User configuration and caches are runtime data, never build inputs. See the repository README for build and release instructions.
- `src-tauri/src/component_expr.rs`：无副作用的有界表达式，跨语言共享向量；不读取凭据或执行脚本。
- `src-tauri/src/graphics_acceptance.rs`：显式启用的设备截图完整性与已安装导航测试，仅本机 PNG/元数据，不调用音频或云端。
- `skills/petui/contracts/composition-v2.json`：计算、文档与本地流程的接受/拒绝契约；不是任意服务已实现的声明。
- `src-tauri/src/component_runtime_lifecycle.rs`：不可伪造的宿主 owner、有限队列和真实 worker lease；取消不冒充在途副作用回滚。
- `src-tauri/src/component_runtime_lifecycle/resource_broker.rs`：已接入组合轮询/持久工作流 GET 的共享 2 路网络配额，以及真实 atomic 存储的 16 路立即准入；视图和持久运行 owner 分离。不是所有网络、CPU、传输或音频的统一仲裁。
- `src-tauri/src/component_composition.rs`：显式 v3 异步检查点、公开 GET 和本地步骤；重启/未知结果不自动重提，保留 v1/v2 存档。
- `src-tauri/src/graphics_capture_integrity.rs`：逐块和整帧完整性检查及故障报告，不将旧缺字节的原因猜作已确认。
# Stable collection views

`src/component-center/form-v1-core.js/.wasm` and its mechanical skill mirror now
run the existing device C integer/choice editor for legacy previews. The native
bridge grants no services and has fixed 64 KiB/zero imports. Complete snapshots
are loaded before each call; separate caller states cannot contaminate one
another. `scripts/build-legacy-form-runtime.mjs --check` verifies artifacts;
the legacy schema, saves, mappings and device core remain unchanged.

`src-tauri/src/component_collection.rs` is the bounded stable-key view model
used by service composition, not a component-ID provider. Documents remain the
source of truth; only selection/page is saved. Deterministic dependencies and
versioned host contexts prevent a fixed row from selecting replacement data.
Visible slots are bounded and have explicit empty/truncated markers. Rust and
Python share the collection contract; browser fixtures test real AppSurface
snapshot replacement. This does not create a new device-side dynamic UI engine.
# Candidate bounded drawing

`src-tauri/src/app_canvas.rs`, the Python canvas validator and shared declaration
vectors gate the data-only drawing extension. USB synchronization refuses devices
without its explicit capability. Preview and device use the same C/WASM raster
core with fixed spans/memory and no imported services. Ordinary targets remain
closed until hardware timing and voice/AEC acceptance; no release is implied.
# Private PPA boundary coverage

The offline allowlist also covers actual panel rotation adapters and the
bounded tiled CPU/PPA private comparison. Pixel equality is not a throughput
or acoustic claim; panel fences and ordinary configuration remain unchanged.
The private mixed-profile test resolves inherited flags and compiles the real
two-lease/4096-fuel broker without opening peripheral or ordinary-profile grants.

The offline firmware allowlist now includes actual callback/queue-boundary
tests, as well as compact-cache tests. These are counted forwarding, sanitizer
and fixed-SDK contracts, not a frame-performance or device/acoustic acceptance.
The runner still does not access a device or package an application.

The widget transaction contract also negotiates exact unchanged-install
preservation from the connection snapshot pinned to every send. Legacy begin
envelopes and resource repair remain unchanged; unknown commits are not retried.
Screenshot close-drain validates every duplicate receipt within the original
budget, rejecting contradictory late receipts without a second close.

USB discovery and connected reads share the same transient-read policy:
timeouts retain the pending frame; interrupted/would-block reads retain it
and back off 2 ms, inside the original deadline/cancellation loop. Fatal errors
and EOF still terminate. No write, task or transaction is replayed.

`usb_serial/windows_configuration.rs` preserves native Win32 operation stage,
baud and original OS error code in serial open/configuration failures. It adds
no port path, device identity or raw protocol logging. Actual Windows COM
hardware remains an independent acceptance requirement; synthetic formatting
tests do not prove driver compatibility. OVERLAPPED I/O and cancellation are
unchanged.

## Service bridge candidate routing

`src-tauri/src/service_bridge/{mod,contract,native,surface,assets}.rs` separate
bounded projection/commands, typed host_contract hashing, registered native
providers, surface validation and cached images. component_app/app_services
retain existing service policy; USB image transport waits for real ACKs.
`src/component-center/service-bridge.js`, AppSurface and ComponentAppPanel
provide the candidate preview/interaction path, not device acceptance.
`skills/petui/references/service-bridge.md` is the authoring route;
`skills/petui/scripts/bind_service_bridge.py` binds independent work packages
without publishing, networking or writing the formal library.
Scalar-only bridges may reuse legacy host capabilities without services or
host_contract. Dynamic images/timelines/event parameters/local-media require
explicit surface.services, actual widgetServiceBridge and dependent capabilities.
Preserve exact host_contract pairing (all numeric zeros frame as i0;, other finite
floats remain binary), quotas and no automatic
replay of unknown outcomes. Local-media is explicit PC import, not online
songs/accounts/payments; the old music-player global AVAILABLE remains false.
Candidate firmware defaults off and HIL remains unaccepted. No global skill
synchronization is implied by repository documentation.

Native startup supervision: src-tauri/src/startup_policy.rs is the pure bounded generation/deadline/dialog policy; startup_supervision.rs owns one condition-variable worker and native tauri-plugin-dialog recovery even when HTML never mounts. lib.rs manages it in setup/page-load/exit and registers local main-window generation/ready IPC. main.jsx captures the document token before importing App and confirms once after RootReady; late responses cannot trigger reload/exit. No USB/provider operation, automatic reload or mutation replay is introduced; logs contain fixed categories and existing sanitized app URL/stage only.

### 2026-11-03 clipboard ownership review fix

`src-tauri/src/codex_composer_macos.rs` temporarily owns the macOS pasteboard
through a nonblocking local input lease and its native change count. Failure
before a temporary write does not restore/clear anything; a user copy during
focus or readback is preserved instead of being replaced by the old snapshot.
The paste key is also gated by the last owned write count. Pure policy lives in
`pasteboard_ownership.rs`; no draft or clipboard contents enter that helper.
Change-count checks do not make cross-process pasteboard access atomic, and
actual AX/editor behavior still requires manual verification.
MiMo focused-target comparison now rejects missing current metadata that was
known at capture time (identifier, title or geometry), rather than treating lost
evidence as identity confirmation; capture-time missing fields keep legacy policy.

2026-11-03：原生 shared_location 统一城市估算/手动设置/关闭，给实时对话、自动定位天气和 location.current 数据源；IP 查询只有固定 HTTPS 域名，单一缓存、过期失效、旧异步结果隔离。usb_serial/master_volume 使用设备能力和连接身份绑定的查询/设置命令，不自动重发不确定设置。设置页保留全部 API 配置功能。

固件文件上限随工厂布局更新为3MiB；update_firmware 在任何abort/begin前查询目标设备实际nextPartition.size，并保留128KiB余量。旧2.5MiB设备不会因客户端更新而被假定为3MiB，容量不足须显式USB重新部署，不自动擦除。

2026-11-03：首页语音输入下方提供设备音量与至多三行的城市位置控制，城市名可由原生端解析；设置页仅保留服务配置。社区发布无需填写许可证或勾选三项人工声明，原包的许可证与署名仍保留，扫描、完整性、截图和待审流程不变。

2026-11-03：手动位置不受常用城市列表限制，原生 shared_location_suggest 返回有界城市/区县候选；固定 HTTPS 服务、公网 DNS 地址校验、无重定向与响应大小限制沿用。查询只读，不记录输入或响应，不自动保存；UI 选择候选后显式保存城市标签和内部坐标，未选候选的名称保存保留兼容解析。地区、行政区与同名父级匹配统一处理；历史坐标 IPC 与配置格式兼容。

2026-11-03：组件绘图链路修复：Rust 原生校验按 p4-cells-v1 约束格子声明、整格几何、普通图集和整数光标，并投影至既有几何检查；p4-quota-v3 的 state_mask 使用16位范围，旧配额保持既有范围。组件库预览补齐本地关键帧，保留基础图片 ID 和次序。源文件修复尚未打入新安装包。

2026-11-03：组件库独立媒体预览只读取包内常规 PNG/MP4，拒绝 URI、路径穿越及符号链接；新增媒体读取总量受16MiB上限约束，大图先检查 PNG 尺寸及分配限额再解码，不使用网络或转码子进程。视频预览依赖 WebView 支持源 MP4 编码，不支持时明确占位，设备端媒体编译流程不变。

2026-11-03：合入修正后的PR21：托盘失败不阻止前台启动，Linux保留原关闭退出，macOS菜单Quit/Command-Q接入退出保护；保留 startup_supervision 与所有后台关闭钩子。见 BACKGROUND.md。

DeepSeek Harness desktop input uses agent id `deepseek-harness` in the shared
`codex_composer` current-visible AX/UIA path. The macOS bundle identity is
`com.deepseek.dsh` and application/executable name is `DeepSeek Harness`;
Windows selects the matching `DeepSeek Harness.exe` main process. No DSH
plugin, pairing, HTTP draft RPC, session navigation, or version/hash pin is
required for composer input. Binding retains the visible process/window/editor,
real draft prefix and task identity; stale focus/draft fails closed. macOS DSH
writes use verified AX selection and PID-targeted Unicode events with readback,
without a pasteboard fallback. Windows reuses the bounded native Chromium UIA
selector and focused text writer. Submission requires explicit confirmation;
ambiguous targets or unknown write/submission outcomes are never replayed.

`src-tauri/src/device_voice_lifecycle.rs` bounds push-to-talk startup and writer release ownership: late composer startup remains tracked, one terminal cause is retained, and a new writer waits for the previous writer's actual release result. `codex_composer.rs` caches that result without treating a closed command channel as a release acknowledgment.

2026-11-04：0.1.185 为未发布审查候选。P4 会话绑定按 Agent、设备、连接和启动代次撤销旧队列结果，先在当前连接提交再更新 PC 语音目标；按键回调保留同一查询与配置修订归属。共享 profile 文件读改写串行化。OAuth/provider 响应读取遵守实际解码大小上限；DSH 有界去重历史保留在途请求，managed installer 支持 status-only 客户端及同版本源码更新。组件 VM 的 WASM 与字节镜像重新生成并由重复生成检查校验。包读取共用普通文件、非阻塞与不跟随链接的打开边界，并按实际解压字节累计总预算；新增伪造长度 ZIP、FIFO 与符号链接负向测试。公开 media-sample 测试夹具恢复，catalog 与远程 media 夹具职责分离。组件发布重新校验 staged manifest 的 ID，在撤销旧运行状态、创建命名空间或原子发布前拒绝源替换导致的跨 ID 漂移，同 ID 的版本更新仍可发布。

2026-11-04：Windows 输入桥的全部进度阶段与接收端白名单一致；形象切换区分未提交与结果未知，激活失败只记录固定阶段/错误类别与本机写入观察。音频坏包仅记录字段类型和长度计数，保留严格校验与退役排空，不记录语音、Base64 或会话标识。

2026-11-04：组件安装不再因触屏未就绪或可选设备能力声明不全而被客户端拦截；触屏手势映射仍可选择。包结构与资源预算、实际容量、目标连接、按键冲突和传输完整性检查保留；安装不代表缺失功能已实现。

2026-11-04：macOS DeepSeek 语音按完整原文前缀及 UTF-16 折叠末尾光标追加新增后缀，每次定向输入前后核对完整草稿及光标。读取失败、会话变化、非追加改写或确认未知均停止本次写入且不自动重放；保留原文与换行，不改 ChatGPT/WorkBuddy 输入和 writer 释放路径。实际 DSH 光标兼容性仍待人工验证。

2026-11-04：0.1.192 的 WorkBuddy 现有进程唤起仅在显式语音开始时执行：精确实例激活后确认真实 AX 窗口，再缓存可用性。显式确认可以从本客户端返回先前已成功写稿的 WorkBuddy/DeepSeek 窗口，前后校对原进程、窗口、编辑器、完整草稿及确认指纹；普通观察、取消和提交结果轮询不获自动切焦点权限。发送仍沿既有单次路径，未知结果不重放；固件仍为 R177。

- Windows 0.1.191 native composer patterns use SDK IDs, while managed UIA uses
  registered identifiers. Windows PowerShell 5.1 has no managed
  LegacyIAccessiblePattern type. Real-assembly offline tests exercise native
  Value/Legacy/Text capabilities without desktop access or message submission.

2026-11-04：0.1.193 在 Mac/Windows 共用形象管线按原主体结构表达动作语义，不以手臂、面部或固定朝向作为必选条件；显式恢复可补检旧策略拒绝并保留原媒体。已合入内部提交 1c41803 的 Windows UIA 模式标识兼容；图片生成默认总预算 120 秒（显式预算最高 600 秒），内容上限 64 MiB；结果链接先保存，图片下载最多三次、合计 45 秒；只有完整的明确可恢复限流响应最多重试两次。取消结束本地等待，不自动重放未知付费请求。固件仍为 R177。

2026-11-04：双端旧固件 OTA 开始确认单次等待最多 30 秒，兼容先同步擦除再确认的实现；等待期间每 50 ms 核对原连接代际，断开即结束，不重复发送 begin。分块及提交确认、完整性、余量与性能门槛不变；新增固定阶段与数字进度的失败元数据及中文提示。尚未证明历史失败均由擦除耗时引起，设备验收仍待人工确认。

2026-11-04：设备按键配置读取超时仅提示未确认，不再自动改写设备；配置写入 ACK 未确认时不再重连并重发。保留用户主动同步、严格 ACK 和互斥保护，阻断旧设备读取失败触发写入及重连的反馈路径。

- Radio diagnostics preserve fixed device-rejection categories and typed ACK
  validity fields before owner admission hides details. No device text, station
  data, session IDs or audio is logged; no outcome or replay policy is changed.

- City radio preserves correlated negative media replies. Only an exact active
  owner receiving a Chunk/Query rejection with empty session, zero buffer and a
  typed terminal state can retire its lease. The chunk remains rejected; no
  fabricated success, stop replay, unknown-state reset or automatic source retry.
  Later explicit entry can start a fresh session; incomplete/active/mismatched
  responses still latch unknown. Genuine timeouts retain all durable evidence.

## 城市电台播放恢复

Mac 电台使用 40 ms 独立音频块，保持原 1.28 s 起播和 2.56 s 队列容量；仅 media/chunk 将串口分片间隔下限提高到 400 µs，Windows 原有 80 ms 分帧不变。
精确关联到当前会话的明确音频块拒绝仍按失败处理，不伪造成功、不重播旧块；保持已知所有权以便获得停止回执后创建新会话。已未知的播放仅在新显式播放请求时通过同设备、启动及连接代次的只读查询核对，自动进入和自动重试不会自行恢复未知所有权。退役解码线程不再发送清理操作或污染新一代状态。

## Explicit Mac voice wake and local video inspection

WorkBuddy voice Begin may foreground only the exact existing trusted bundle/PID. The explicit cold path adds one AX foreground request, waits at most its own bounded window-readiness budget, and accepts independent pinned active-AppKit plus actual windows when AX focus information is absent. Explicit foreign focus, ambiguous windows/editors, stale targets and later input guards still stop delivery. Observers never activate. Readiness diagnostics are fixed status/count metadata only.

Generated-video inspection uses owned exact-range bytes. Desktop clients invoke the local-only `inspect_generation_video` command (`generation_video.rs`): decode the saved MP4 with FFmpeg into first/middle/last JPEGs, bypassing WebKitGTK video-to-canvas noise. Inputs are bounded to 100 MiB and 1–30 seconds; geometry, aspect and black-frame checks remain enforced. MOV input disables external references and network protocols; subprocesses share a 45-second deadline with bounded diagnostics and temporary-directory cleanup. Decoder discovery never launches separate version or H.264-encoder probes. Concurrent local checks queue without repeating generation. Web-only previews retain the bounded muted-video/presentation callback path. Policy revision 6 lets explicit recovery recheck a prior rejection once while retaining the old verdict and original media; no automatic paid retry. Local failures checkpoint only safe stage/code.

Local web development and preview bind to loopback by default; remote access requires an explicit operator override.

全局提示音在首页音量区和形象详情共享编辑器；内置形象跟随优先启用设备保护槽。

### ESP32-S3 A4 port (official 0.1.201 baseline)

The S3 port keeps the fabricated A4 GPIO mapping and official SW1-confirm,
SW2-component/realtime, SW3-back, analog joystick and center-press behavior.
There is no three-button action menu or virtual touch pointer. The client
exposes joystick bindings and uses fresh `s3j_` preferences.

`input/config` writes on S3 require `inputModel: "s3-a4-buttons-joystick-v1"`.
Old clients receive a failed ACK before any NVS write. A4 input settings use
`pet_input_a4j1`; Wi-Fi, pairings, packages and saves keep their existing stores.
Read-only `input/config-query` reports the model and 16 bindings. P4 keeps its
official protocol/configuration behavior.

The S3 MAX98357A uses software master volume with the shared official persistence
and protocol logic. P4 ES8311 vendor patches and AHB restart workarounds remain
P4-only. The S3 OTA partition remains 0x300000 bytes per app slot.
2026-11-07：本地固件升级修复。识别 S3 r13n/r14b/r14c 的数字和字母顺序，未知或重复 r 修订片段拒绝自动判断；S3 自动内置升级保留当前80m/l320适配标记。侧栏仅较新且标记兼容时提供更新，非配套目标显示适配版已保护。后端在命令预检和取得传输锁后的设备快照/镜像描述上双重检查。人工选文件OTA仍走显式恢复流程，芯片/项目/容量/SHA/启动校验保持。
2026-11-08：r15资源修复删除install_widget_clawpkg_mode中第二次同名compiled_sprites准备，保留已校验的S3原生资源或一次通用fallback；不放宽资源预算。生产repairResources真机补齐cloud-hop/block-combo/bloomfrog_companion，保留存档与按键。S3原生清单测试覆盖28项并按各原包声明图片数核对（当前74图）；更新旧三键策略和拒绝文案断言。忽略的s3_resource_repair_hil需要明确设备/目录/备份环境参数，不自动运行。
