gmingtian/HachimoDock-esp32s3/docs/ESP32-S3-A4-Controls.md

# A4 焊接板：按钮与摇杆操作

当前配套发行源码：桌面端 **0.1.202**、S3 **0.7.103-s3-r16c-80m-l320**。A4 使用三颗按键与四向模拟摇杆，恢复官方操作方式；早期仅三键的动作菜单、软件触摸光标等适配不再作为当前输入模式。

## 默认映射

| 控件 | GPIO | 默认操作 |
| --- | --- | --- |
| SW1 / 1 键 | 39 | 短按确认；按住开始语音，松开结束 |
| SW2 / 2 键 | 38 | 短按组件中心；长按聊天 |
| SW3 / 3 键 | 0 | 返回/退出 |
| 摇杆 X（B2） | 1 | 左/右导航 |
| 摇杆 Y（A2） | 2 | 上/下导航 |
| 摇杆按下 | 8 | 确认 |

按键默认内部上拉，按下接 GND。GPIO0 是启动选择脚，上电或复位时请松开。游戏可占用各按键执行游戏操作，以画面提示为准；客户端支持重新配置绑定。

按键采用 25ms 消抖、700ms 长按门限。摇杆启动采样校准中心，设有死区和回差，连续导航有重复等待。若有漂移先让摇杆回中重启，再核对接线与校准；不要用旧三键配置覆盖本模型。

## 客户端配套

A4 输入模型为 `s3-a4-buttons-joystick-v1`，使用独立 `pet_input_a4j1` 配置命名空间和 `s3j_` 桌面偏好，支持 16 条绑定。旧三键配置缺少或不匹配输入模型时，应在写入 NVS 前拒绝。

升级客户端和固件后，请确认设备页显示按钮＋摇杆配置。组件资源也需要安装/修复为横屏版本；仅刷固件不会补齐旧组件缺失资源。

## 游戏

| 游戏 | 摇杆 | 1 键 | 2 键 | 3 键 |
| --- | --- | --- | --- | --- |
| 五子棋 | 棋盘选点 | 开始/落子/重开 | 撤回最近一轮黑白落子 | 退出 |
| 中国象棋 | 开始前上下选难度；局内选棋和合法候选点 | 开始/选棋/落子/重开 | 优先取消选中，否则整轮悔棋 | 退出 |

象棋选中任一棋子后显示合法落点光标引导，涵盖将/帅、士/仕、象/相、马、车、炮、卒/兵；摇杆按候选位置跳点。落点经过规则和将军安全校验。默认普通难度，用户执红先手，AI 在设备离线运行；暂不做竞赛级长将长捉裁定，不保存未完成棋局。

云端跳一跳、像素方块、蛙蛙养成已恢复按钮/摇杆操作；鲜果一刀仍需要触屏，不因 A4 摇杆而恢复触屏玩法。r15 修复的横屏资源准备和返回首页恢复逻辑继续保留。

[五子棋](Gomoku-A4.md) · [象棋](ESP32-S3-r16-Xiangqi.md) · [r16c 搜索调度验证](ESP32-S3-r16c-Xiangqi-Speed.md) · [PCB 接线](../hardware/s3-carrier/README.md)
