gmingtian/HachimoDock-esp32s3/pc/src/.folder.md

# Desktop frontend

- Completed Codex replies use the same 60-second card expiry as completed tasks. The silent terminal state stays distinct on the wire.

ComponentCenter tests require explicit named-binding and App-viewport
capabilities, including both library metadata surface shapes; a higher version
string is not a substitute. Legacy packages remain installable unchanged.

React UI for devices, Agent bindings, API configuration, components and animated appearances. Shared avatar generation modules live in lib/avatar-pipeline. Tests run with npm test. API credentials come from user settings through the native configuration boundary; public frontend bundles do not embed credentials. The normal public generation, receipt, photo import, component caching and playback behavior is the 0.1.167 release baseline.
- 组合 v2 的同步门禁核验真实宿主上下文能力；PC 动作使用稳定编号与快照版本，旧组合保持兼容。
- 组合 v3 动作同样提交编号与版本；多视口安装必须协商独立 widgetAppViewports 能力，不用版本号或单视口能力替代。
# Host collection interaction

The offline framework UI fixtures include fixed host collection slots using
the production AppSurface. Replacing host context during a pointer gesture
cancels the old click; empty slots remain disabled. Synthetic browser replies
test rendering/input only; the actual composition request/state/storage path
is independently exercised by Rust contract tests.

Startup recovery: index.html retains a standalone loading view and public/startup-guard.js runs independently of React chunks. main.jsx dynamically imports App behind a root boundary. Only fixed failure category/type is logged; user-triggered reload never replays mutations. Native page-load logs only owned asset URL structure without query/fragment/private paths. This improves visibility, not proof of the prior WK blank-page root cause.
The mounted React Ready boundary also removes the loading overlay directly, so an unavailable independent guard cannot cover a working interface.
Component transfers use read-only device audio preflight and manual stop/recheck; never stop real-time voice automatically. Device removal preserves application saves only with the explicit peer capability; clearing needs explicit intent and confirmation and does not promise deletion of independent program snapshots.

Voice runtime polling now waits for a completed known USB target, binds asynchronous results to device/channel identity and uses native ASR exclusively for P4. Credential configuration is distinct from runtime running; stale legacy results cannot replace current UI state.

Native startup supervision additionally covers absent HTML: one managed worker waits for the main document generation/token handshake and one RootReady confirmation. A25s timeout presents an OS dialog with user-only reload/exit/dismiss; no automatic reload or mutation replay. Navigation invalidates late ready/notices/actions; at most one dialog remains outstanding. Permissions allow only the local main frontend commands. This is recovery visibility, not a diagnosis of the earlier WK failure.

2026-11-03：ApiSettings 的可见名称改为“设置”，保留 api 路由和凭据草稿保护，新增设备总音量和共享城市位置。位置配置由原生端保存，前端不使用 localStorage 保存城市或坐标。

2026-11-03：设备总音量和共享城市移至首页语音输入下方。城市面板最多三行，只显示当前城市、自动识别和手动城市输入；不显示坐标、来源时间表或说明段落。城市草稿由首页所有者保留，切换标签页不丢失；城市名由原生端解析供组件继续使用。

2026-11-03：组件发布移除许可证填写与末尾三项人工勾选；不再代用户发送确权、隐私确认或实机测试断言。既有许可证文件保留，包结构、敏感信息检查、截图、幂等提交与社区审核仍由原路径处理。

Component media errors describe required capabilities, not a particular package.
The component center and sidebar share catalog visibility rules while preserving
user files and settings across upgrades.

Follow/appearance assignment is single-flight per provider and pins USB board, connection and boot. Each explicit request first performs one read-only reconciliation, then lets native verify content/cache metadata for its own fresh switch; local appearance IDs do not skip either gate. Matching USB binding submission precedes profile persistence. Unknown results are neither replayed nor presented as a confirmed old image; bridge-start partial failure remains visible.

One new follow click owns a fresh intent UUID and a distinct read-only observation UUID. usb_reconcile_appearance_unknown must prove quiescence of an old unresolved transfer, or report no pending journal entry, before this click may start its own native mutation. The old result stays unknown; mutation catches never reconcile/retry/resume it. Cancellation, lost ownership, changed USB generation or boot stop continuation. The UI briefly shows confirmation without a separate reconciliation button; missing firmware proof still prompts an upgrade. Native codes, boot IDs and pack IDs are not displayed.

2026-11-04：组件安装不再因触屏未就绪或可选设备能力声明不全而被客户端拦截；触屏手势映射仍可选择。包结构与资源预算、实际容量、目标连接、按键冲突和传输完整性检查保留；安装不代表缺失功能已实现。

2026-11-04：0.1.193 在 Mac/Windows 共用形象管线按原主体结构表达动作语义，不以手臂、面部或固定朝向作为必选条件；显式恢复可补检旧策略拒绝并保留原媒体。已合入内部提交 1c41803 的 Windows UIA 模式标识兼容；图片生成默认总预算 120 秒（显式预算最高 600 秒），内容上限 64 MiB；结果链接先保存，图片下载最多三次、合计 45 秒；只有完整的明确可恢复限流响应最多重试两次。取消结束本地等待，不自动重放未知付费请求。固件仍为 R177。

2026-11-04：双端旧固件 OTA 开始确认单次等待最多 30 秒，兼容先同步擦除再确认的实现；等待期间每 50 ms 核对原连接代际，断开即结束，不重复发送 begin。分块及提交确认、完整性、余量与性能门槛不变；新增固定阶段与数字进度的失败元数据及中文提示。尚未证明历史失败均由擦除耗时引起，设备验收仍待人工确认。

2026-11-04：设备按键配置读取超时仅提示未确认，不再自动改写设备；配置写入 ACK 未确认时不再重连并重发。保留用户主动同步、严格 ACK 和互斥保护，阻断旧设备读取失败触发写入及重连的反馈路径。

Protected built-in follow operations use the device slot even when local cue edits exist. Cue changes retain the explicit audio-only downlink; capacity preflight failures remain distinct from connection/unknown-result errors.

GlobalAudioCuesPanel.jsx 与 lib/global-audio-cues.js：全局状态音效、跟随当前动作的状态选择、独立 WAV 持久化和下发，不触发视频准备；GlobalAudioCuesPanel.test.js 覆盖状态绑定。
2026-11-07：本地固件升级修复。识别 S3 r13n/r14b/r14c 的数字和字母顺序，未知或重复 r 修订片段拒绝自动判断；S3 自动内置升级保留当前80m/l320适配标记。侧栏仅较新且标记兼容时提供更新，非配套目标显示适配版已保护。后端在命令预检和取得传输锁后的设备快照/镜像描述上双重检查。人工选文件OTA仍走显式恢复流程，芯片/项目/容量/SHA/启动校验保持。
