gmingtian/HachimoDock-esp32s3/docs/superpowers/plans/2026-11-10-0.1.203-release.md

# Desktop 0.1.203 / S3 r16d Release Plan

> **For agentic workers:** Use the existing reviewed fixes and execute verification, packaging, and publication in order. The user explicitly authorized committing, pushing, and creating this release.

**Goal:** Publish reproducible Windows x64, macOS arm64 and Linux x86_64 clients plus S3 A4 OTA/factory firmware for the repaired USB, appearance and session flows.

**Architecture:** Preserve the current A4 hardware, 320×240/80MHz profile, partitions and upstream attribution. Commit the repaired sources and desktop version first; build clean r16d firmware from that commit, pin its exact bytes, then build all desktop clients from the final publication commit. Keep old releases and consolidate build receipts into one archive. No device flashing or paid generation is part of release preparation.

- [x] Review the complete source diff, confirm remote main and exclude local data/backups.
- [x] Correct the existing P4 host-test extractor selecting the S3 stub; verify actual P4 timeout cleanup without changing production P4 behavior.
- [x] Set desktop version 0.1.203; document r16d fixes and add targeted native regressions to all-platform CI.
- [ ] Run desktop, bridge, firmware and packaging checks; commit sources.
- [ ] Build clean S3 r16d with its true source commit; assemble and validate the public-data-only factory image.
- [ ] Pin the bundled firmware hash, commit final publication source and push main.
- [ ] Build the three desktop clients on their native CI runners; inspect actual installer resources and source/version receipts.
- [ ] Prepare OTA, minimal factory ZIP, corresponding third-party sources, Build-info.zip and SHA256SUMS.
- [ ] Publish v0.1.203-s3-a4-r16d as a new A4 prerelease; verify remote assets, tag and download checksums.
