gmingtian/HachimoDock-esp32s3/pc/src/dashboard/.folder.md

# 语音面板维护说明

A4 按钮面板复用官方 SW1/SW2/SW3/摇杆分组、图标与悬浮提示；仅展示用物理控件 ID 归一，保存与同步继续使用独立 s3j_ 偏好，移除旧纯三键菜单文案。

- The session feed uses the shared terminal predicate so silent reply cards expire on schedule.

2026-10-24：实时对话的单轮 ASR 超时显示继续聆听提示，不显示「实时对话失败」或要求重新开始；其他错误仍保留。新增 lib/realtime-feedback.js 判定测试。

Mac 语音候选修复待真实录音验收。
VoiceAssistantPanel 使用 deviceVoiceTransportReady 区分原生桌面草稿与CLI就绪状态，
Mac Codex 不因 CLI 缺失禁用启动；权限、窗口和真实输入检查仍由原生通道负责。
VoiceComposerCheck 展示用户触发的脱敏文本区明细，不自动录音或写入。
# 2026-10-24 语音定位失败现场

composer-failure-evidence.js 仅解析原生返回的有界结构快照，VoiceAssistantPanel 将技术快照从常规错误提示中折叠出来，供用户复制。不重扫目标 UI，不自动发送、不持久化。VoiceComposerCheck 继续提供显式只读检查。

Voice runtime polling now waits for a completed known USB target, binds asynchronous results to device/channel identity and uses native ASR exclusively for P4. Credential configuration is distinct from runtime running; stale legacy results cannot replace current UI state.

2026-11-03：首页语音输入下方使用 DeviceVolumePanel（设备确认后显示音量，未知设置结果先只读核对）与 SharedLocationPanel（自动识别/手动地区）；设置页保留服务配置。位置正常布局至多三行，不显示经纬度；手动输入城市、区县时以防抖联想展示真实候选及父级地区，选择后显式保存。切换页面、输入法组合、旧异步响应与保存期间均隔离候选。音量不处理 PCM 或 AEC。位置不写入包内资源。

Follow/appearance cancellation describes only the stopped request; it does not promise the device kept the old image. Unknown native appearance codes are replaced by a short failure notice, never a success notice or automatic resend.

ChannelMatrix has no separate appearance-reconciliation button. A new confirmed follow request briefly shows confirmation while its own read-only preflight checks any old unknown transfer; only successful proof/no-pending permits that request's fresh once-only switch. No old mutation is resumed and no action is dispatched from a failure catch. Required-firmware and incomplete-proof failures remain visible; DeviceContext owns cancellation and USB board/generation/boot continuity.
