gmingtian/HachimoDock-esp32s3/pc/src/shell/.folder.md

Unified status retains `transport` so Wi-Fi online state and USB fallback are
visible without changing the existing device reachability and runtime routing.
2026-11-07：本地固件升级修复。识别 S3 r13n/r14b/r14c 的数字和字母顺序，未知或重复 r 修订片段拒绝自动判断；S3 自动内置升级保留当前80m/l320适配标记。侧栏仅较新且标记兼容时提供更新，非配套目标显示适配版已保护。后端在命令预检和取得传输锁后的设备快照/镜像描述上双重检查。人工选文件OTA仍走显式恢复流程，芯片/项目/容量/SHA/启动校验保持。
