gmingtian/HachimoDock-esp32s3/docs/superpowers/plans/2026-11-02-s3-carrier.md

# S3 一体底板实施计划

按用户确认的方案在当前会话内执行；PCB先行，外壳后续适配。

最终提交范围为A4工程样板：86个电气焊盘、五个保留孔位、JP1功放增益跳线及两颗螺丝的装配说明。原生DRC、GPIO映射和故障检测报告随工程保留；实际供电、模块装配高度和整机干涉仍待验证。下方A0至A3段落记录演进过程，当前装配以 `hardware/s3-carrier/README.md` 为准。

**目标：** 在官方板框及按键/摇杆坐标内连接果云42针、圆形麦克风、MAX98357A和8针屏幕接口，保持现有GPIO。

**设计依据：** `docs/superpowers/specs/2026-11-02-s3-carrier-design.md`。

## 实施步骤

- [x] 从两份已下载的EDA工程提取板框、孔、器件、封装及符号引脚，保存可复查的几何与来源。
- [x] 使用真实源文件测试42针映射、原版按键间距、GPIO一致性和固定孔保留；再实现解析模块。
- [x] 生成一体布局和完整网络表，检查焊盘、安装孔及模块平面外形间距。
- [x] 生成可编辑PCB并布线，用KiCad原生DRC检查短路、间距及未连接项；按实际结果修正。
- [x] 导出可视化预览和装配说明；交付时列明屏幕与外壳三维验证的边界。

2026-11-02 实际检查：KiCad 9.0.8 DRC 0违规、0未连接；7项自动化检查通过。13个功能器件、97个电气焊盘、5个原安装孔。交付 A0 工程样板及网络表，不包含联动原理图。嘉立创交换文件完成坐标/网络回读检查；网页版打开本地工程要求登录，编辑器导入未验证，天线禁布规则仅保存在KiCad主设计中。供电余量、模块装配高度、屏幕与原壳仍待实物核对，本次不导出制造Gerber。

2026-11-02 A1：按用户修订删除 Q1、Q2、R1～R3；BL 直连 GPIO42，GAIN 保留模块设置；删除功放 SPK+/SPK− 对应底板焊盘和网络。重新生成 8 个功能器件、83 个电气焊盘，保留 5 个原安装孔。重新布线后 KiCad DRC 0 违规、0 未连接，7 项测试通过；旧 A0 工程和压缩包已保留在 artifacts/pcb 中。屏幕机械尺寸、供电余量与整机三维验证的边界不变。

2026-11-02 A2：比较朝向后选择旋转180°并向左平移3mm，按参考包络使USB端外伸约0.5mm；保持原板框、安装孔、控制器件及电气GPIO不变。右上H2用非金属紧固件，天线禁布区延伸到右板边。用户确认功放VIN=3V3；摇杆仅预留GPIO1/2/8；功放用1×7P排母，圆形麦克风两条1×3P排母（排距7.62mm），按用户预焊照片保持字面朝外、长针向下。屏幕接口按用户图片的GND/VCC/SCL/SDA/RES/DC/CS/BLK顺序及丝印，VCC仍为3V3。

A2早期迭代检查：12项自动检查通过；该迭代的原生PCB电气核对通过；四个临时故意错误变体被检出。此前DRC不替代最终修改后的重新检查。

本轮完善：屏幕插头包络与排母间隙纳入检查，保持已选定的J1/麦克风位置；锁定原板框、五孔和控制器件机械定位；用户确认原版3D打印摇杆帽。功放电源与地直接分支，增加两层GND铺铜及屏幕地过孔；统一两种CAD的丝印和铺铜边界；原生DRC与PCB/工程规则SHA256绑定，防止沿用旧报告。新增模块避开R15mm摇杆活动规划区，未将俯视投影相交当作三维碰撞结果。整机Z高度、原版帽子全行程、供电/RF与冷启动仍未完成实测，工程状态不变。

最终A2检查：18项自动测试、15路固件信号/电源地、83个原生焊盘坐标与两层GND填充检查通过；四种故意错误均检出。独立复核另确认83焊盘尺寸/钻孔、15个NPTH、842段走线、23过孔及原控制器件定位。原生DRC为0违规/0未连接，PCB校验值ca1aff06079614c79c40a95104101dcd499f4e37e7126d691f6e447e36436788。支持交付A2工程稿，仍不提供Gerber或制造放行。

仅在PCB检查全部通过后生成制造文件。保留现有软件、固件和用户设置；不自动下单。

2026-11-02 A3修正：用户指出H3孔与上方屏幕接口过近；实查A2在Ø5.5～6mm头部包络下与8P插头投影重叠0.79～1.04mm，前次审核遗漏头部。用户授权只微调排针，J1上移1.6mm，其余主要元件和全部原孔位不动。加入五孔头部R3.5mm双层禁布、原NPTH中心开口；先成对安排CLK/MOSI相反铜层无过孔走线，解决窄通道被先前供电走线堵塞的问题。新头部间隙及导出铺铜cutout检查加入测试；20项通过，原生DRC0/0，native audit与四故障检出通过。A2作为历史工程稿保留，不能把旧报告作为A3放行依据。装配立体图采用原版帽/键帽STEP和当前PCB坐标，模块外观/高度是示意，仍无制造放行。
