gmingtian/HachimoDock-esp32s3/docs/superpowers/plans/2026-10-29-s3-wifi.md

# ESP32-S3 USB / Wi-Fi Implementation Plan

> **For agentic workers:** REQUIRED SUB-SKILL: Use superpowers:subagent-driven-development or superpowers:executing-plans to implement this plan task-by-task. Steps use checkbox syntax for tracking.

**Goal:** Add authenticated, encrypted Wi-Fi with the complete existing S3 USB runtime feature set, remembered preference and safe USB fallback.

**Architecture:** Share existing JSONL/binary transactions over USB and TLS. A device lease and connection generation isolate owners. Network I/O has a single owner and bounded queues; business code retains current request IDs, checksums and commit rules.

**Tech Stack:** ESP-IDF 6.1 C/FreeRTOS/esp_wifi/esp-tls/mDNS, Rust/rustls, Tauri/React, C host tests, Rust integration tests and Node tests.

**Spec:** docs/superpowers/specs/2026-10-29-s3-wifi-design.md

## Global Constraints

- Existing N16R8 wiring and three keys stay unchanged; P4 remains target-isolated.
- TLS 1.2 minimum; service TCP port 48973; mDNS `_hachimodock._tcp`.
- Initial USB provisioning; per-board certificate and random 32-byte credential; credentials never enter logs.
- Certificate trust is device-specific; do not modify system trust or disable TLS verification.
- One active control owner; immutable generation on every queued request and reply.
- First use USB, remember explicit choice, never steal a live connection; after Wi-Fi loss clean transactions before bound-board USB fallback.
- No direct switch during audio, resource sync or OTA; never replay a user action or failed transfer.
- TLS and authentication deadlines 5 seconds each; host lease 6 seconds; JSON line buffer 32768 bytes; outbound budget 128KiB; send deadline 1 second.
- Keep two 3MiB app slots and current resource partitions. No physical verification claims without a board.

## Shared wire contract

All maintenance requests use JSONL `{topic,payload}` with a unique `requestId`.
Every response echoes it; failure has `ok:false,error:<non-secret-code>`.

- `wifi/status` -> `wifi/status`: `ok,enabled,configured,connected,ssid,ip,rssi,port,boardDeviceId`.
- `wifi/scan` -> `wifi/scan`: `ok,networks:[{ssid,rssi,secure}]`, bounded to 20 entries.
- `wifi/configure` -> `wifi/status`: input `ssid,password,enabled:true`. USB-only.
- `wifi/pair` -> `wifi/pair`: USB-only response `ok,boardDeviceId,hostname,certificatePem,token,ip,port`. Private key never leaves firmware. Reuses existing token until revoked.
- `wifi/set_enabled` -> `wifi/status`: input `enabled`.
- `wifi/clear` -> `wifi/status`: USB-only; clears configuration and revokes credentials after safely closing the old network session.
- `transport/release` -> `transport/status`: current owner explicitly releases only if no active operation.
- First TLS application request is `wifi/auth`: `token,desktopDeviceId,expectedBoardDeviceId,takeover:false,requestId`. `takeover:true` is only for an explicit user switch; reject while busy. Reply `wifi/auth`: `ok,boardDeviceId,requestId` before any normal hello/events.
- Once authenticated and leased, reuse all existing JSONL requests and raw asset blocks unchanged. Hello advertises `capabilities.transport.wifi:true,wifiProtocol:"pet-wifi-tls-v1"`, `usbOnly:false` for S3.
- Valid certificate SAN hostname is `<boardDeviceId>.local`, used independently of current IP.

### Task 1: Firmware Wi-Fi and owner isolation

**Files:** create `firmware/s3/pet_s3_wifi.{h,c}`, portable lease/framing helpers and host tests; modify `firmware/main/pet_p4_main.c`, `pet_p4_protocol.c`, `CMakeLists.txt`, S3 sdkconfig, S3 menu, firmware folder/protocol docs.

**Interfaces:** consume the wire contract above; produce all firmware endpoints, Wi-Fi runtime, immutable connection routing and authenticated normal protocol path. Root owns desktop files, so do not modify `pc/`.

- [ ] Write host behavior tests that reject stale generation, non-owner raw bytes, busy takeover and unpaired input. Assert actual parsed messages and side effects.
- [ ] Run red tests with the new implementation absent, then implement portable ownership/framing primitives.
- [ ] Add NVS Wi-Fi configuration, certificate/token identity, TLS server and bounded I/O. All secret operations only via USB maintenance path. Use ESP-IDF APIs present in the installed v6.1 SDK; do not assume mbedTLS 3.x certificate-generation APIs.
- [ ] Integrate main protocol queue and async event routing. On network loss reset capture/playback, uncommitted assets and active OTA before admitting a new owner. Generation cleanup must run on serialized protocol context.
- [ ] Add mDNS discovery (or minimal correct responder if new managed dependency unavailable), bounded scan, Wi-Fi status/menu and target-only dependencies.
- [ ] Run targeted host tests and `firmware/tools/build_s3.sh` with a dedicated output path. Record image/OTA sizes, static RAM, actual compiler output and any hardware-only checks.
- [ ] Commit only owned firmware files after tests and self-review; report findings to the root.

### Task 2: Shared desktop TLS transport and connection policy

**Files:** create `pc/src-tauri/src/wifi_transport.rs`, Wi-Fi persistence/commands, unit and TLS integration tests; modify `usb_serial.rs`, `usb_serial/connection_handle.rs`, `lib.rs`, Cargo dependencies and desktop folder docs.

**Interfaces:** consume Task 1 wire contract; expose Tauri `wifi_get_status`, `wifi_scan_networks`, `wifi_configure`, `wifi_pair`, `wifi_list_devices`, `wifi_connect`, `wifi_set_enabled`, `wifi_clear`, `device_set_transport_preference`. Existing `usb_get_status` carries the unified active connection; add `transport` while preserving old fields.

- [ ] Write failing tests for pinned TLS identity, authentication rejection, raw/JSON split input and cancellation using a real loopback TLS peer.
- [ ] Extract connection installation/reader loop to support paired generic Read/Write streams; preserve all existing ACK resolution and connection-generation checks.
- [ ] Implement single-owner TLS pump with bounded inbound/outbound storage, deadlines and cancellation; no global OS trust edits.
- [ ] Persist certificate/endpoint/explicit preference and protect token through existing secure_config encryption. Never store router password on desktop; do not return stored token to UI.
- [ ] Add USB maintenance requests via existing device waiters. `wifi_pair` stores the secret internally and returns public status only.
- [ ] Add safe manual switch and reconnect policy. Block switch while busy; cancel old generation before fallback; reconnect only the bound board. Existing command names remain compatibility wrappers around the shared connection.
- [ ] Run Rust transport/transaction suites and source checks. Commit only desktop-owned implementation files.

### Task 3: Client UI, integration and release

**Files:** create `pc/src/WifiSettings.jsx` plus behavior helpers/tests; modify `DeviceDashboard.jsx`, `DeviceSetup.jsx`, DeviceContext helpers, connection copy, docs and packaging metadata.

**Interfaces:** consume Task 2 Tauri commands. Wi-Fi setup never needs GPIO changes. Display active transport and remembered preference separately.

- [ ] Add red Node behavior tests for selected vs active transport, busy switching, secret-free UI payloads and offline state.
- [ ] Add Chinese network settings, scan/manual SSID, USB pairing, discovery/manual IP, enable/clear and USB/Wi-Fi selection. Show disconnect/upgrade/sync failure explicitly; retain existing device controls on both transports.
- [ ] Exercise loopback firmware peer for status, button events, capture/playback, widget install, appearance/raw blocks, firmware OTA and disconnect/reconnect. Test loss during writes and old-generation replies.
- [ ] Run full relevant C/Python, Node and Rust suites, Linux frontend/client build, S3 app/factory assembly; verify partition and resource checks.
- [ ] Request independent concurrency/security review; fix load-bearing findings and rerun the affected tests.
- [ ] Update compatibility, installation and feature comparison; version the Wi-Fi release separately from r2. Use existing native CI for Windows/macOS and verify resulting packaged runtime/resources.
- [ ] Commit/push the approved work, publish separate prerelease downloads only after corresponding checks pass. Keep existing r2 assets intact and report physical-test limits.

## Review and recovery

Record progress and implementation rulings under this plan's SDD workspace. The spec is authoritative. Each task report includes red/green commands, tests, commits, build sizes, unresolved issues and physical checks. Do not mark a task complete on code-only scans or claimed success without command evidence.
