gmingtian/HachimoDock-esp32s3/docs/ESP32-S3-Quality-Trial.md

# S3 动画画质对照（2026-11-07）

结论：降低压缩可以改善细节，但当前不采用整套 CRF 22 或 CRF 26。两者均
未通过现有存储/解码约束，未下发设备，未改固件、客户端或原素材。

## 试验范围

从 `pc/public/terrier-clips` 的同一批原始 MP4 重新编码，使用生产转换器
`firmware/tools/prepare_s3_assets.py` 和项目自带 `s3-ffmpeg.exe`。
保持 320×240、15fps、Lanczos 缩放、H.264 constrained baseline、单参考帧、
无 B 帧及单 slice 等约束，只改变 CRF。保留全部 16 段动画和公共提示音策略。
试验脚本在工作区 `.build-tools/s3-quality/`，原始素材摘要记录在生成报告中。

## 容量检查

| 参数 | 视频载荷及最坏对齐开销 | 加 4096 字节头后的结果 |
| --- | ---: | --- |
| CRF 27 | 2,843,566 字节 | 可容纳于 3,145,728 字节形象槽 |
| CRF 26 | 3,241,150 字节 | 超出 99,518 字节，约 97.2KiB |
| CRF 22 | 未完成整包 | 第六段 idle.playing 超过 384KiB 单流上限，被生产转换器拒绝 |

CRF 22 只留下前五段独立样本，**不是完整或可安装的形象包**。CRF 26 虽
生成完整离线目录，但 `encoding-report.json` 中 `fitsSlot=false`，也不能
下发。没有扩大限制、删动画、减时长、降帧率或覆盖用户数据来迁就试验。

重新编码的 CRF 27 是离线控制组；画质指标中的 CRF 27 则直接读取当前
仓库 `firmware/assets/s3-landscape-default` 的现有流，与实际交付素材一致。
两者流大小存在少量 SPS/编码器输出差别，报告没有把重编码包冒称为原包。

## 同源画质对照

参照是原始 MP4 经同一生产缩放链得到的未再次有损压缩的 YUV 帧，不是
摄像机原片。PSNR/SSIM 比较整个片段、相同帧率和时间轴。

| 动画 | CRF | 流大小 | PSNR 平均 | SSIM |
| --- | ---: | ---: | ---: | ---: |
| idle.begging | 当前 27 | 151,401 字节 | 42.121dB | 0.988346 |
| idle.begging | 26 | 172,901 字节 | 42.859dB | 0.989554 |
| idle.begging | 22 | 293,421 字节 | 45.890dB | 0.993395 |
| idle.daydreaming | 当前 27 | 193,490 字节 | 41.933dB | 0.987233 |
| idle.daydreaming | 26 | 221,082 字节 | 42.702dB | 0.988712 |
| idle.daydreaming | 22 | 373,458 字节 | 45.838dB | 0.993047 |

两段样本 CRF 22 的流体积约为当前的 1.93 倍；CRF 26 的指标提升较小，
完整包仍装不下。指标支持“有压缩质量收益”，不能单凭指标保证实物观感。

`artifacts/s3-quality/*-comparison.png` 是各动画第 45 帧的同帧并排预览，
从左到右为当前 CRF 27、试验 26、试验 22。预览使用桌面 FFmpeg 解码，
不是实物 LCD 截图，也没有包含设备的 RGB565 量化和近黑边缘处理。
原帧均另存为 PNG，不加锐化、补帧或生成式增强。

## 设备与后续方向

本轮没有连接串口、传素材、刷写或重启设备，也未操作桌面界面。设备仍
沿用上一轮 r12/80MHz 的资源和固件；上一轮同待机首页实测为 6.814FPS。
由于候选整包未通过容量检查，**本轮没有新的实机帧率结论**，不能宣称
提高画质后仍能保持 6.8FPS。

后续可选方向是只提高部分常用动画的质量、改进编码策略后重新做容量和
实机对照，或先优化原生 320×240 合成链。改变全部动画数量、时长、帧率
或分区布局属于另一项取舍，本轮未进行。完整数据、日志和预览都保留在
`artifacts/s3-quality/`；没有提交、推送或发布代码。
