gmingtian/HachimoDock-esp32s3/docs/ESP32-S3-r16c-Xiangqi-Speed.md

# r16c：中国象棋思考速度优化

2026-11-08，用户批准在不降低原搜索设置的前提下，将 S3 象棋搜索分片间隔从 8ms 改为 2ms，并在验证后刷入、保留 r16b 回滚。r16c 已通过正常 OTA 部署至 OTA0，OTA1 保留已验收的 r16b。

## 改动及棋力约束

只缩短 S3 象棋两次分片之间的等待。每次最多 256 个工作步骤，搜索深度、总工作量限制、评估函数、走法顺序和规则均保持原样；不增加追赶式连续搜索。其他游戏及 P4/桌面预览仍使用原调度。原有静态画面刷新优化、80MHz SPI 和原生 320×240 合成继续保留。

核心 `pet_p4_xiangqi.c/.h` 的文件哈希未变；重新生成的桌面 WASM 与原版逐字节相同，因此配套桌面端无需重新安装。

三档各 12 轮，共 36 个变化局面对比中，新旧版本的棋盘、完成深度、目标深度、节点数、搜索量、状态和最终落子完全一致。调度逻辑时间合计 47,968ms → 11,992ms；这不是设备墙钟测速或棋力对局评分。

主机测试先复现旧 8ms 不能在 2ms 推进，再验证新版本通过。独立审查发现并修正了 IDF 配置宏加载问题；测试使用与 IDF 一致的 `ESP_PLATFORM → sdkconfig.h` 路径，真实 Xtensa 预处理结果确认为 S3=1、间隔=2U。核心规则、AI、门控与实际适配器通过 MSVC AddressSanitizer 检查，另有其他游戏回归。

## 设备测速

同一开局，从最后一次落子命令发送前计时，到查询到 AI 回复为止；困难档包含每 800ms 公共状态更新及 heartbeat 压力。

| 难度 | r16b | r16c |
| --- | ---: | ---: |
| 简单 | 619.80ms | 667.01ms |
| 普通 | 1,038.19ms | 903.79ms |
| 困难 | 4,597.86ms | 2,195.88ms |

困难档本次减少约 52%，普通档约 13%；简单档约 0.6–0.7 秒，基本持平。以上为固定开局单次对比，包含界面绘制、协议及观察延迟，不承诺每个局面同样耗时或提升比例。

21 组自动设备验收通过：全部七种棋子的 21 个合法落点和 71 个操作逐步核对；三档 AI 与整轮悔棋；关闭串口 12 秒后的自主落子；困难思考中退出；五次首页往返；五子棋、云端跳一跳、像素方块、蛙蛙养成打开并返回首页。31 个组件、16 条按键绑定、形象槽保持不变；无新增故障或输入丢弃。

## 部署与回滚

- 当前固件：`0.7.103-s3-r16c-80m-l320`，OTA0，有效、健康就绪、无待验证状态。
- 固件 2,594,464 字节，SHA256：`07ffa6be00feb6cb90ddd747099d20d3fa79ffbcf7bac4cbacdd8057e4496efb`。
- 冻结交付：`artifacts/s3-xiangqi-r16c/hachimodock-s3-r16c-07ffa6be.bin`。
- r16b 完整 16MiB 私有备份：`artifacts/a4-flash-backup/before-r16c-full.bin`，SHA256：`540c88ef3b5e6218d2390ed414e9e20ad21b103c3f32cb29fc2ea8b79bbe746d`。已实际核对 OTA1 中 r16b 镜像切片的哈希。旧 r15 仍保存在此前私有备份中。

首次桌面 GUI 升级在 begin 阶段发生连接身份更换，保护机制停止，未继续传输或提交；只读核对确认设备仍为健康 r16b、事务已结束、故障未增加。随后使用独占连接的原生产 OTA API 完成升级：635 块、635 次尝试、无损坏拒绝或回退，传输约 47.2 秒，重启健康观察通过。未改动产品的未知结果停止及禁止自动重放保护。

私有记录在 `.build-tools/s3-r16c/`：`backup-receipt.json`、`isolated-ota.json`、`ota-receipt.json`、`device-acceptance.json`。备份和设备数据不随游戏包公开分发。本轮未发布社区作品或 GitHub 内容。

本轮实物画面和按键反馈尚待用户确认；r16b 的实物验收记录继续保留。
