gmingtian/HachimoDock-esp32s3/docs/UPSTREAM-0.1.201-A4-PORT.md

# 官方 0.1.201 的 S3 A4 本地适配

后续性能修订 r10 已刷入并同步客户端随包资源；输入协议与本次 r9 适配相同。当前版本及实机性能证据以 [r10 优化记录](ESP32-S3-r10-Performance.md) 为准，下文保留原始官方移植与 r9 验收记录。

官方基线为 `7fbe729aa52911da5fdd7e8c3c0578d4a4d8f60f`。保留本地原有 Git 历史，未提交、推送或发布；构建身份如实显示 `f719445ca638-dirty`。移植前的完整源码快照与逐功能组同步清单保存在工作区 `.build-tools/upstream-0201/`，同步前会拒绝覆盖并发用户修改。

## 配套版本

- 客户端：0.1.201 A4 适配版。
- S3 固件：`0.7.103-s3-r9-l320`，2,580,224 字节。
- 固件 SHA-256：`d24e8b8a3107a1b308aa58d3eb9f67c68a3884577c25d27f56786d372677a162`。
- 输入模型：`s3-a4-buttons-joystick-v1`；16 项绑定；NVS `pet_input_a4j1`。
- 引脚：SW1/2/3 为 39/38/0，摇杆 X/Y/中按为 1/2/8。
- 保持每个 OTA 应用分区 3 MiB；本轮 r9 在 OTA_0，原 r8 在 OTA_1。

## 关键处理

保留官方 SW1 确认/按住语音、SW2 组件中心/长按实时对话、SW3 返回、摇杆四向及中按。移除了客户端遗留的三键列表过滤、虚拟指针提示与固件废弃动作菜单 API。客户端偏好采用 `s3j_` ID。固件在分配配置或写 NVS 前拒绝旧客户端格式，避免再次恢复三键映射。

官方 USB 冷启动探测、连接代际、帧完整性、会话与音效更新已移植。S3 保留 Wi-Fi/TLS 传输、原生横屏资源与软件解码。新主音量使用 MAX98357A 实际消费的软件增益，复用官方存储与控制接口；P4 的 I2C 编解码器补丁及启动 AHB DMA 复位不在 S3 执行。原生字体/图像容量单独保留 S3 原有的边界。

桌面实机验收还发现官方新增的语音运行时选择与音量面板仅识别 `esp-p4`。两处前端判断已扩展到 `esp-s3`：语音走同一原生接口并继续使用非交互恢复；音量仍要求真实设备声明 `audioMasterVolume` 能力，先读取设备值，不推测音量或自动重复设置。相关 15 项回归通过，其中新增 S3 音量能力与实际查询用例，并扩充 S3 语音路由用例。

## 验证

| 验证项 | 结果 |
|---|---|
| 桌面前端 Node 测试 | 1825 通过 |
| Windows USB/Wi-Fi Rust 回归 | 290 通过，32 个官方可选验收用例未运行 |
| Linux 固件关键回归 | 118 通过，5 个平台/可选用例跳过 |
| Linux 桥接测试 | 232 通过 |
| 桌面资源 Python 回归 | 20 通过，2 个跳过 |
| Web/CSP、Rust 检查、真实 S3 编译 | 通过 |
| Windows 原生资源 | 291 文件；真实 320×240、15 帧视频转换/解码通过 |
| 实机启动 | r9、OTA_0、valid、runtimeReady、摇杆就绪、0 输入丢包 |
| 实机输入模型 | 旧格式拒绝；A4 16 项配置写入成功 |

Windows 未打包的 Rust 测试程序需要 Common Controls v6 清单；本轮用 Windows SDK `mt.exe` 给测试产物嵌入清单后运行。正式桌面包使用 Tauri 的 Windows 清单。

Windows 桥接全套测试在当前执行环境中仍存在 DSH ACL 权限及文件符号链接夹具限制，未削弱产品的 ACL 验证以绕过它；同一源码的 Linux 桥接 232 项已通过。实际物理按钮触感、摇杆全行程和所有第三方 Agent/云账号功能不等同于主机回归结果，需在对应设备/账号环境验收。

## 交接

Windows 桌面端最终安装与启动验收完成：0.1.201 经 COM3 连接 r9，按钮配置显示已同步；12 个可见手势对应固件的 16 项绑定（含按住事件）。S3 总音量实际读回 100%，显示已保存；语音不再停在握手等待，当前缺少火山引擎语音识别 API Key，未据此宣称云端语音已验收。实际安装资源 292 项校验通过，并完成 320×240 / 15 帧转换与解码。

最终安装包、摘要与收据在 `artifacts/desktop-a4-0.1.201/`；安装到 `%LOCALAPPDATA%/HachimiDock/`。校验确认安装主程序与 NSIS 包中程序一致；包中程序相对原始构建仅改变 Tauri 官方 `UNK` → `NSS` 三字节打包类型标记。安装器 SHA-256 为 `805e16d366eb0a14264c52fc80388c96df075068d6eb1add2a1011a69a3aaf1e`。

最终刷写/启动与完整 Flash 备份收据在 `artifacts/a4-flash-backup/`。备份包含设备数据，不应放入公开发布包。安装包应使用本项目构建的 A4 配套版本，普通官方 P4 客户端/固件不等同于这个硬件适配版。
