gmingtian/HachimoDock-esp32s3/docs/superpowers/plans/2026-10-29-s3-linux.md

# HachimoDock S3 / Linux Implementation Plan

> **For agentic workers:** Use subagent-driven-development for independent hardware, renderer and desktop work; integrate and verify in this chat.

**Goal:** Adapt the existing HachimoDock runtime and desktop to the user's fixed S3 hardware and Linux host.

**Architecture:** Preserve shared feature/runtime code. Add target-specific hardware, memory/storage and desktop capability profiles rather than cloning a reduced demo. Compile and test the integrated target before packaging.

**Tech Stack:** ESP-IDF 6.1 C/C++, ST7789 SPI, separate I2S channels, USB JSONL, Rust/Tauri/React/Node, software image/video decoding.

**Spec:** ../specs/2026-10-29-s3-linux-design.md

## Global Constraints

- Preserve existing IO: display 21/47/45/40/41/42, microphone 4/5/6, speaker 7/15/16, buttons 39/38/0.
- ESP32-S3, 16 MB flash, 8 MB PSRAM, 240×240 ST7789, no touch or joystick.
- Genuine S3 identity and capabilities; reject P4 OTA images.
- Preserve original P4 target and unrelated user projects.
- Retain full upstream feature modules; document any capability that cannot be implemented on this hardware/platform.
- Do not flash hardware, publish, or install persistent services.

## Task 1: S3 hardware and three-key interaction

Files: add `firmware/s3/` hardware profile, LCD/I2S backends; update hardware boundaries in audio/input/touch/native USB only as needed. Root integration owns shared build definitions/protocol/OTA.

- [x] Exercise the real button decoder with hold/release/navigation sequences and confirm no short press after long press.
- [x] Implement fixed-wiring SPI panel and independent I2S mic/speaker behind existing runtime APIs.
- [x] Adapt input initialization to only three real GPIOs; preserve component bindings and global escape.
- [x] Compile owned modules and run applicable host tests; document physical tests still required.

## Task 2: S3 rendering and bounded resources

Files: renderer, target image compatibility helpers, S3 asset conversion/profile, applicable asset tests. Do not edit Task 1 hardware or Task 3 desktop files.

- [x] Add failing aspect-fit/scaling and asset bound tests with literal small fixtures.
- [x] Guard P4 JPEG/PPA accelerators and use software alternatives on S3.
- [x] Bound caches and decode/output allocations for 8 MB PSRAM; preserve shared component/game rendering.
- [x] Produce an S3-ready reduced-resolution default appearance and conversion command.
- [x] Run renderer/resource host tests and report exact memory/performance assumptions.

## Task 3: Linux desktop and S3 negotiation

Files: `pc/` target identity/capability logic, serial/OTA and asset preparation profiles, Linux build scripts/configuration/documentation.

- [x] Add failing tests for S3 discovery/capability routing and P4/S3 OTA selection.
- [x] Implement S3 profile without spoofing P4, three-key editor support and bounded asset packaging.
- [x] Add a Linux native desktop build/run path; preserve platform-specific feature reporting.
- [x] Run relevant JS/Rust checks; prepare runtime dependencies in task-local storage.

## Task 4: Integration, build, review and handoff

Files: target CMake/manifest/sdkconfig defaults, partition table, protocol hello/OTA target checks, documentation and release artifacts.

- [x] Establish a baseline and record existing failures separately.
- [x] Build S3 with the available IDF/toolchain and resolve target-specific integration errors.
- [x] Verify partition sizes, actual image headers and target-correct OTA metadata.
- [x] Run relevant upstream tests and integrated desktop/firmware contract tests.
- [x] Review the full change and resolve material issues; package only successfully produced artifacts.
- [x] Report the exact implementation/validation state per feature, with no claims of unperformed hardware testing.

## Handoff state

All planned source, host verification, native build, review and packaging tasks are complete.
See `../progress-s3-linux.md` and the individual reports for evidence and limitations.
No board flashing or physical acceptance was performed. Linux external-app composer
automation remains unsupported, S3 audio is half-duplex, and the staged native
application is a debug build requiring host runtime libraries and external FFmpeg.
