gmingtian/HachimoDock-esp32s3/docs/images/s3-device-photo.jpg

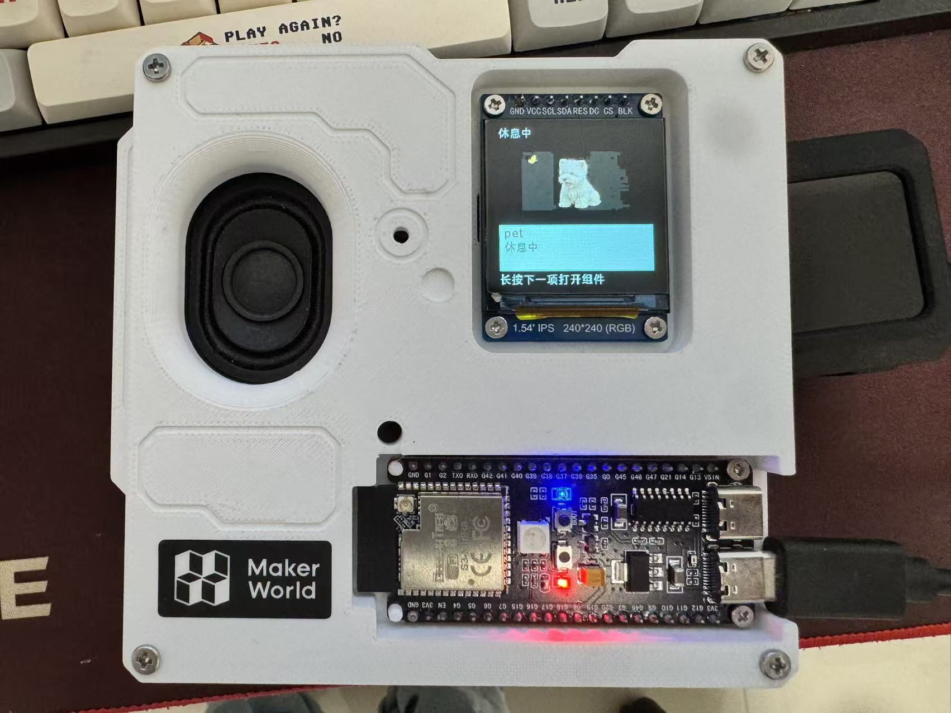
docs/images/s3-device-photo.jpg
