gmingtian/HachimoDock-esp32s3/docs/images/s3-menu-preview.png

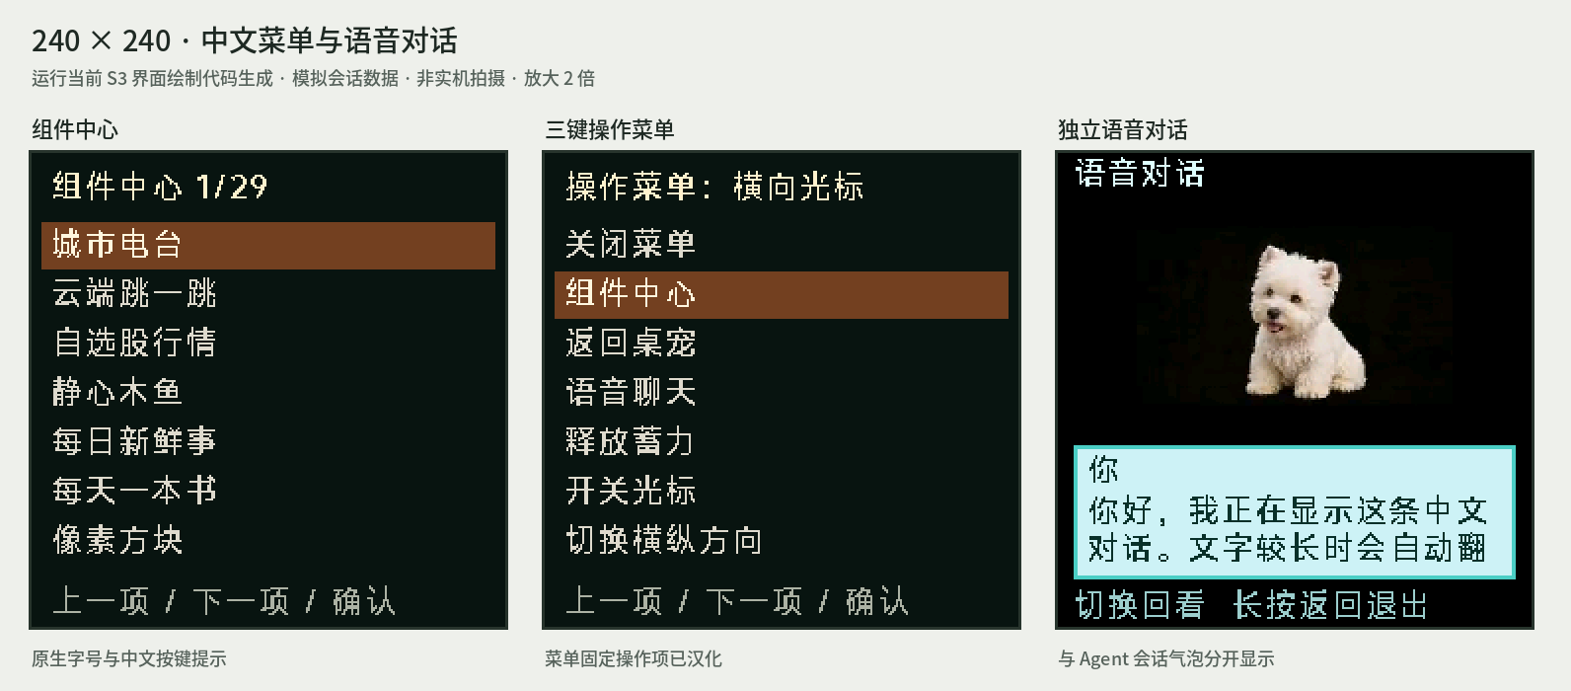
docs/images/s3-menu-preview.png
