gmingtian/HachimoDock-esp32s3/docs/images/s3-session-photo.jpg

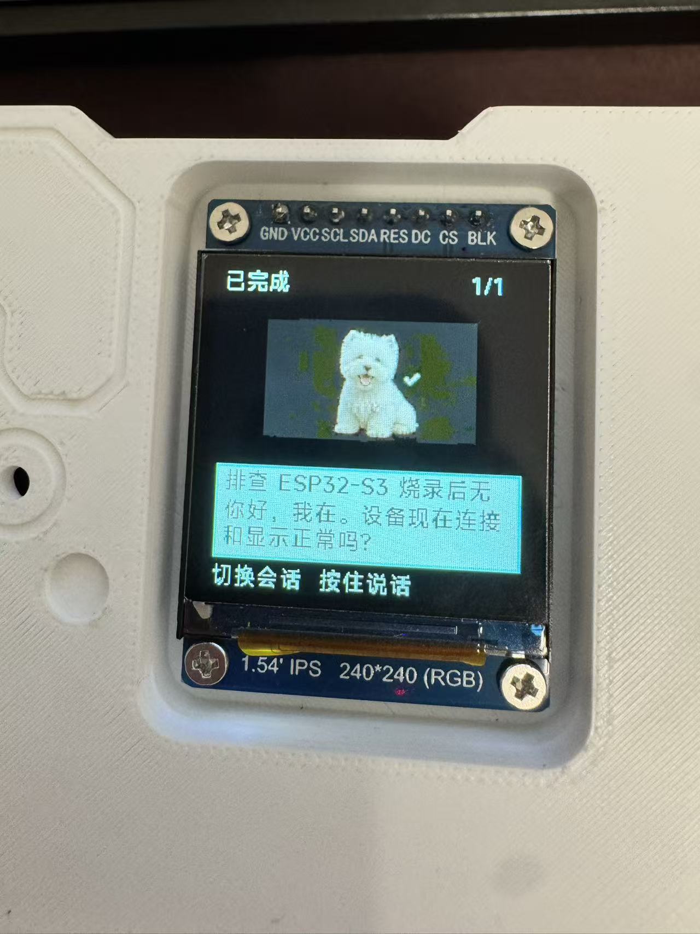
docs/images/s3-session-photo.jpg
