gmingtian/HachimoDock-esp32s3/docs/images/s3-session-preview.png

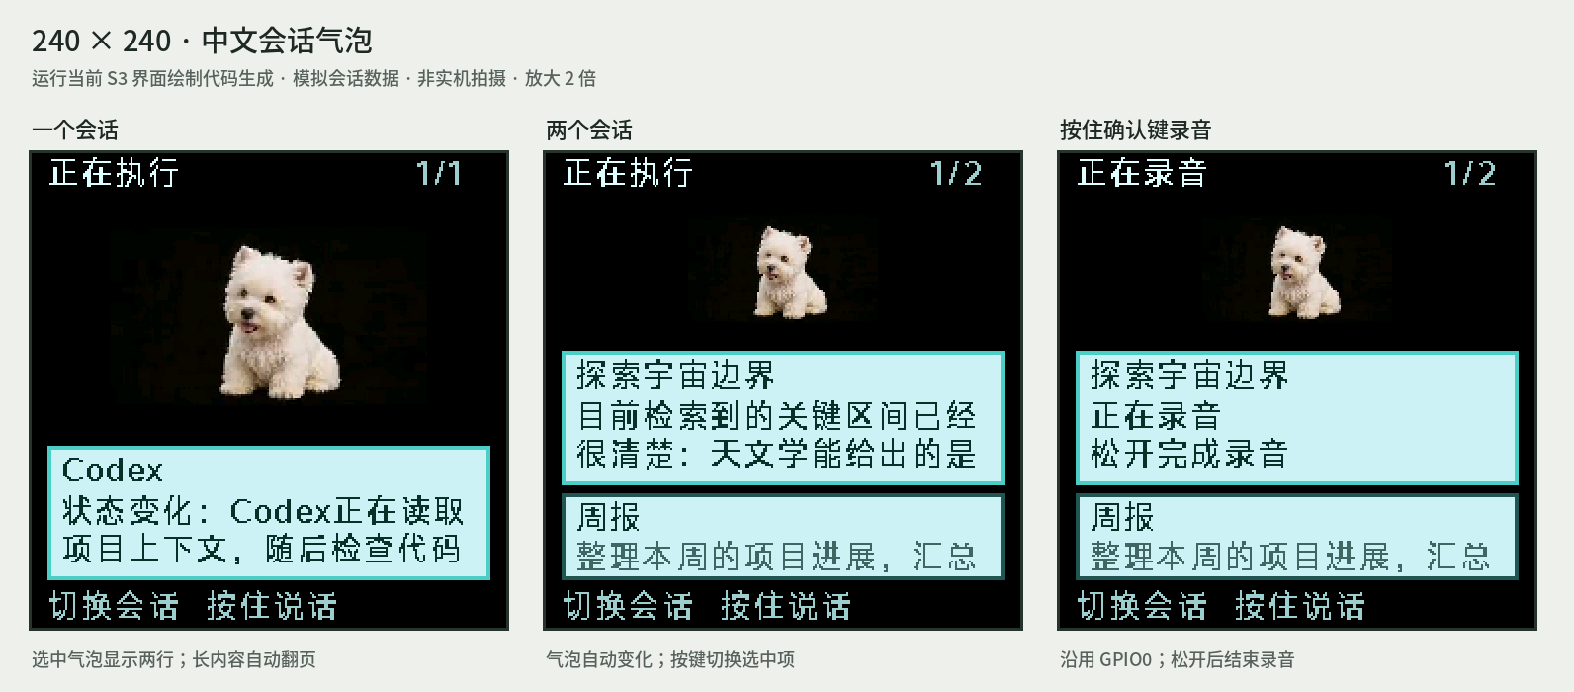
docs/images/s3-session-preview.png
