gmingtian/HachimoDock-esp32s3/firmware/assets/s3-landscape-ui/launcher/center_background.jpg

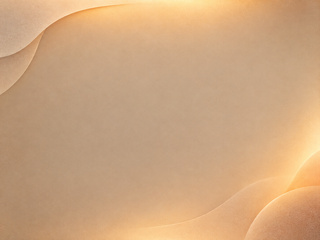
firmware/assets/s3-landscape-ui/launcher/center_background.jpg
