gmingtian/HachimoDock-esp32s3/firmware/assets/s3-landscape-ui/packages/city-radio/assets/vinyl.png

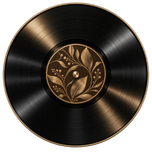
firmware/assets/s3-landscape-ui/packages/city-radio/assets/vinyl.png
