gmingtian/HachimoDock-esp32s3/firmware/assets/s3-landscape-ui/packages/daily-news/assets/background.png

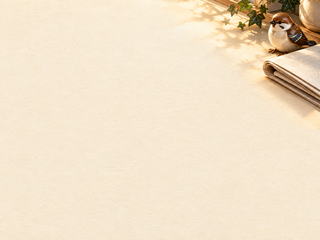
firmware/assets/s3-landscape-ui/packages/daily-news/assets/background.png
