gmingtian/HachimoDock-esp32s3/firmware/assets/s3-landscape-ui/packages/decision-capsule/assets/type0.png

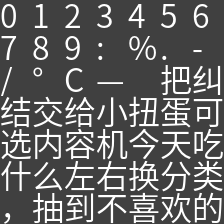
firmware/assets/s3-landscape-ui/packages/decision-capsule/assets/type0.png
