gmingtian/HachimoDock-esp32s3/firmware/assets/s3-landscape-ui/packages/flappy-bird/assets/background.png

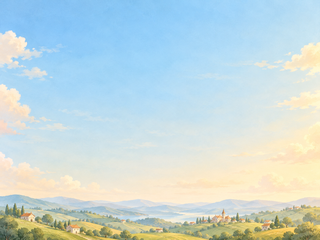
firmware/assets/s3-landscape-ui/packages/flappy-bird/assets/background.png
