gmingtian/HachimoDock-esp32s3/firmware/assets/s3-landscape-ui/packages/hachimi-home/assets/decor.png

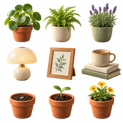
firmware/assets/s3-landscape-ui/packages/hachimi-home/assets/decor.png
