gmingtian/HachimoDock-esp32s3/firmware/assets/s3-landscape-ui/packages/hachimi-travel/assets/background.png

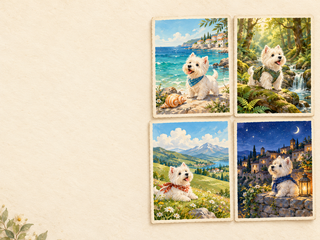
firmware/assets/s3-landscape-ui/packages/hachimi-travel/assets/background.png
