gmingtian/HachimoDock-esp32s3/firmware/assets/s3-landscape-ui/packages/hope-train/assets/background.png

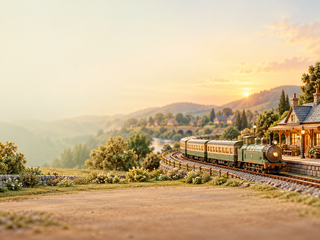
firmware/assets/s3-landscape-ui/packages/hope-train/assets/background.png
