gmingtian/HachimoDock-esp32s3/hardware/enclosure-a4/reference/screen-user-drawing.jpg

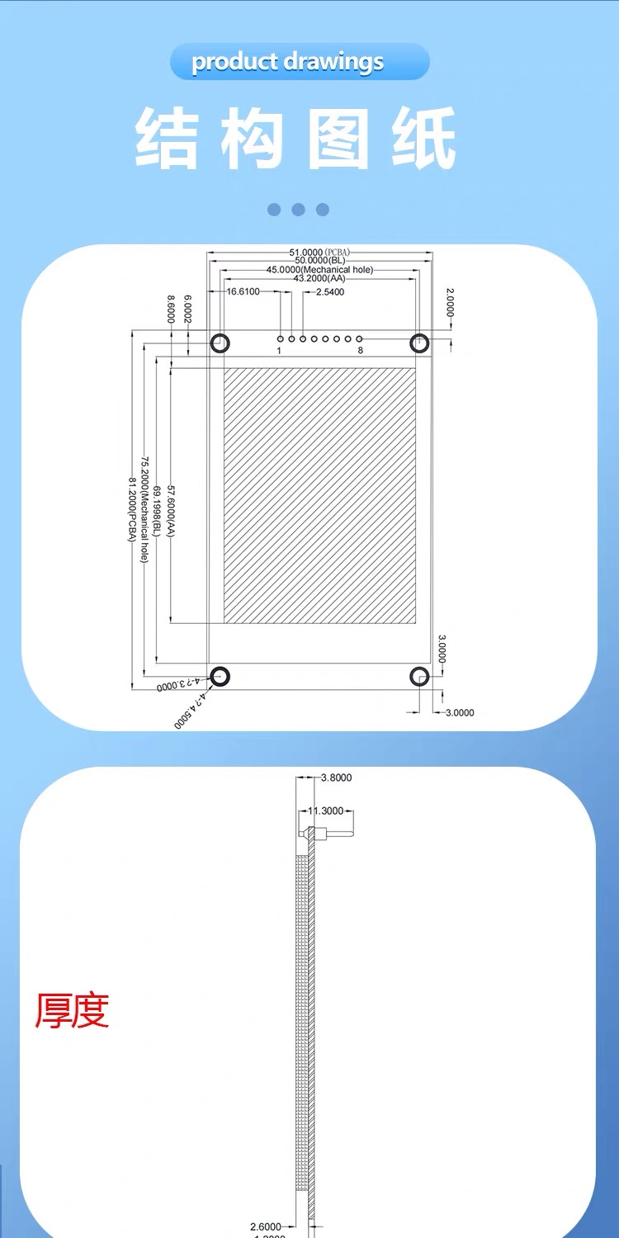
hardware/enclosure-a4/reference/screen-user-drawing.jpg
