gmingtian/HachimoDock-esp32s3/hardware/s3-carrier/output/pcb-preview.png

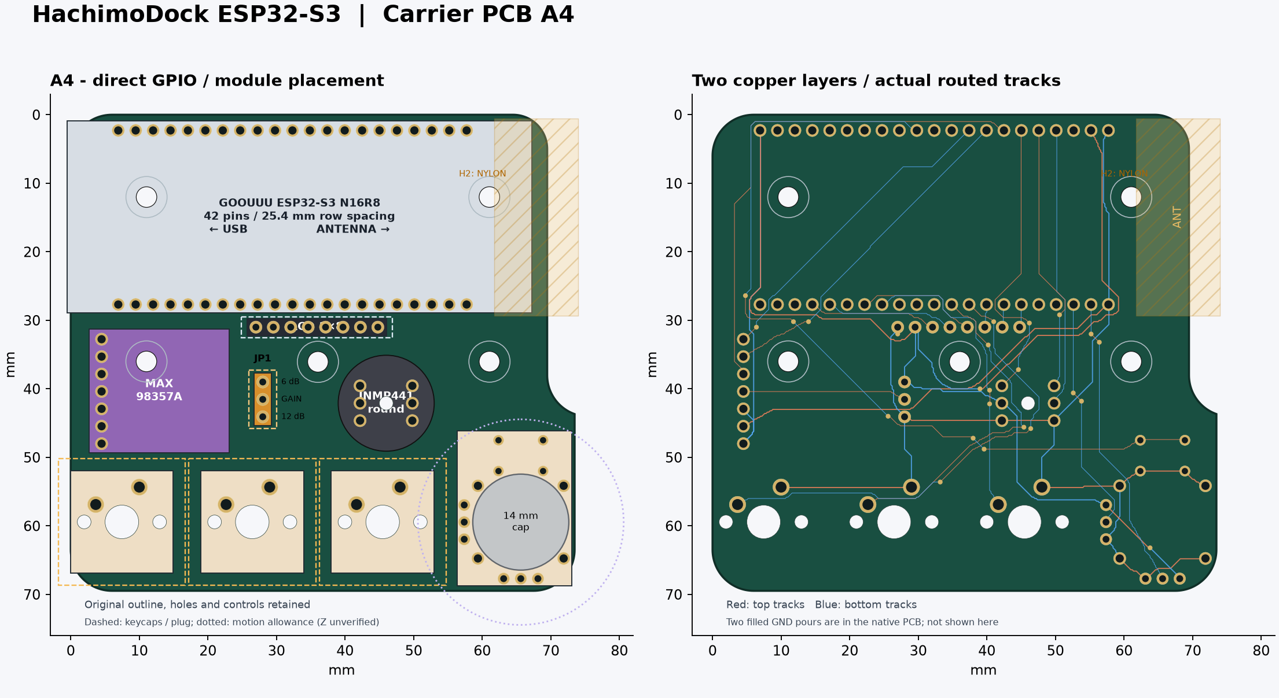
hardware/s3-carrier/output/pcb-preview.png
