gmingtian/HachimoDock-esp32s3/hardware/s3-carrier/output/schematic-preview.png

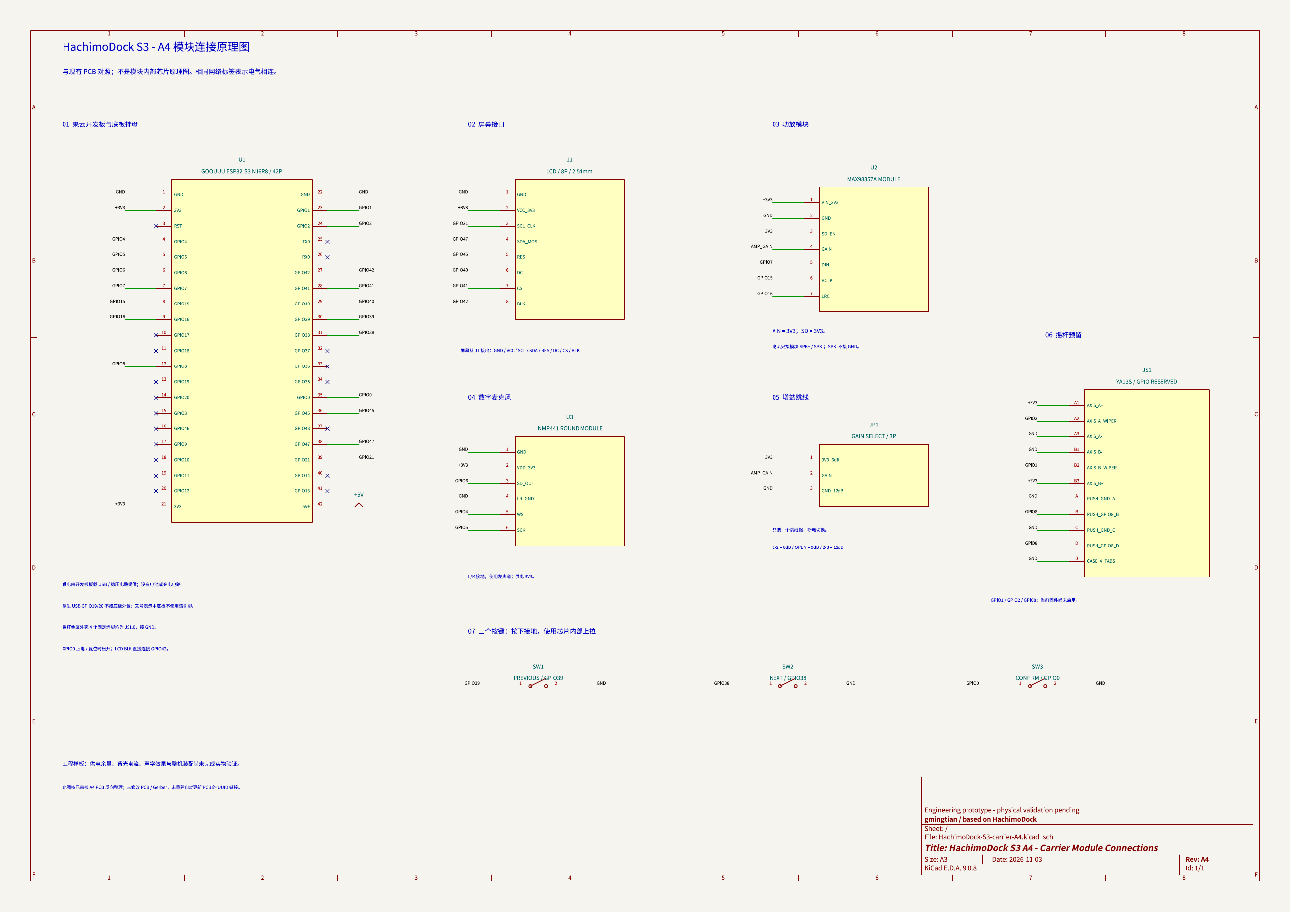
hardware/s3-carrier/output/schematic-preview.png
