gmingtian/HachimoDock-esp32s3/pc/local-clawpkgs/gomoku-a4/assets/board.png

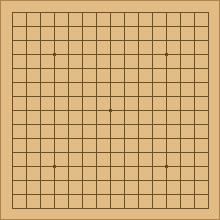
pc/local-clawpkgs/gomoku-a4/assets/board.png
