gmingtian/HachimoDock-esp32s3/pc/local-clawpkgs/xiangqi-a4/assets/board.png

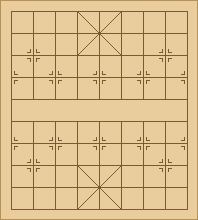
pc/local-clawpkgs/xiangqi-a4/assets/board.png
