gmingtian/HachimoDock-esp32s3/hardware/enclosure-a4/output/r4-original-copy/full-r4.4/working-r4.4-full.step

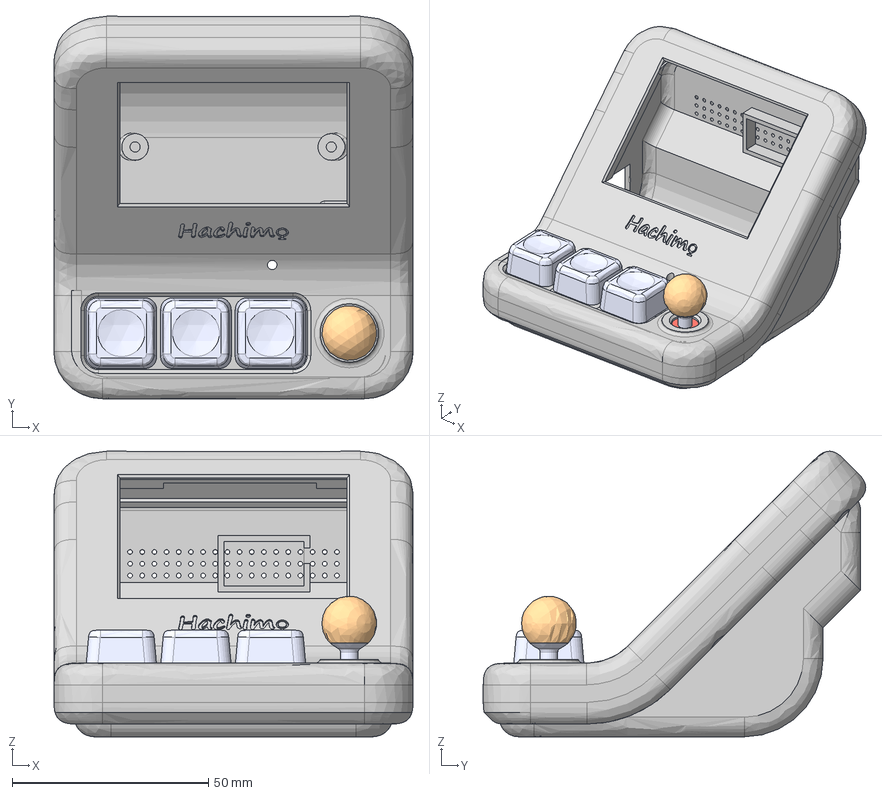
[picture p76: CAD file, 2026-11-08]
hardware/enclosure-a4/output/r4-original-copy/full-r4.4/working-r4.4-full.step
91.5 x 97.5 x 72.8 mm
