gmingtian/HachimoDock-esp32s3/hardware/enclosure-a4/reference/original-assembly.STEP

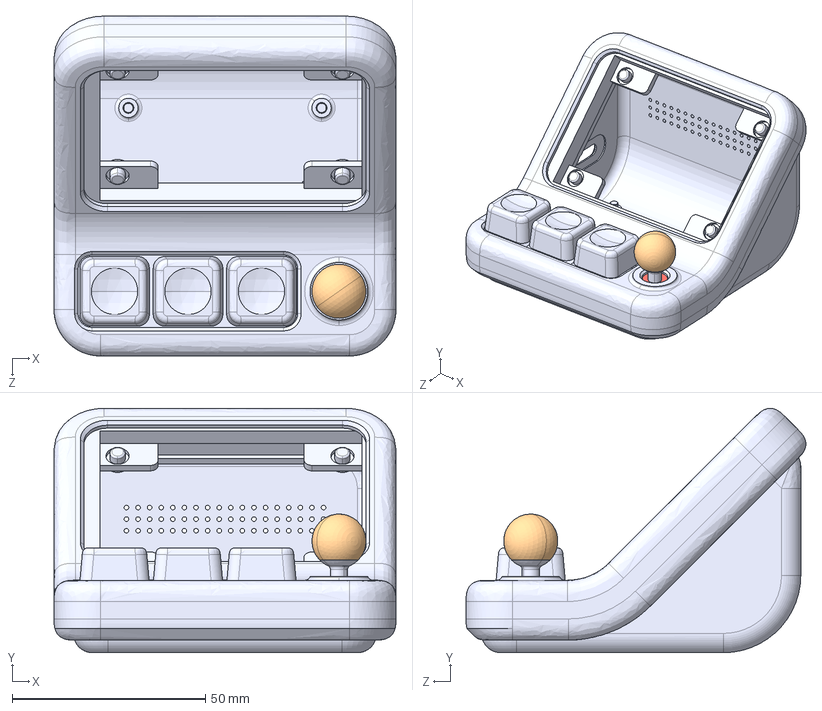
[picture p77: CAD file, 2026-11-08]
hardware/enclosure-a4/reference/original-assembly.STEP
88.5 x 63.2 x 88.0 mm
上壳-摇把版
底壳-摇把版
按键1 x 3
摇把帽
摇把盖板
