gmingtian/HachimoDock-esp32s3/hardware/enclosure-a4/output/r4-original-copy/full-r4.4/a4-upper-r4.4-hachimo.stl

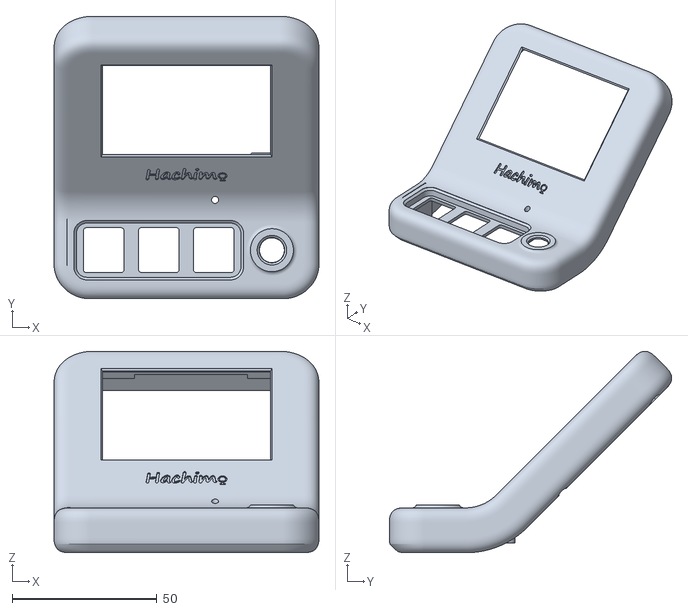
[picture p78: CAD file, 2026-11-08]
hardware/enclosure-a4/output/r4-original-copy/full-r4.4/a4-upper-r4.4-hachimo.stl
91.5 x 97.5 x 69.5
