gmingtian/HachimoDock-esp32s3/hardware/enclosure-a4/print-parts/keycap-3.stl

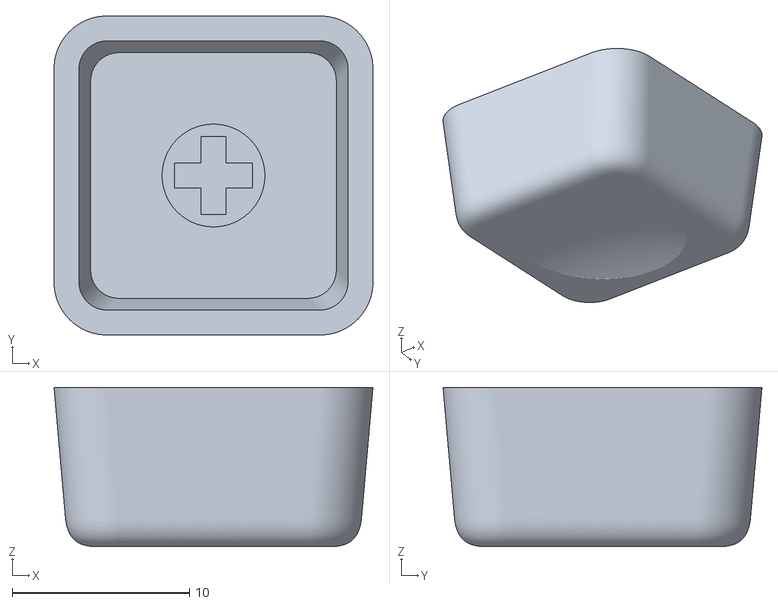
[picture p79: CAD file, 2026-11-09]
hardware/enclosure-a4/print-parts/keycap-3.stl
18.0 x 18.0 x 9.00
