gmingtian/HachimoDock-esp32s3/hardware/enclosure-a4/reference/original-lower.stl

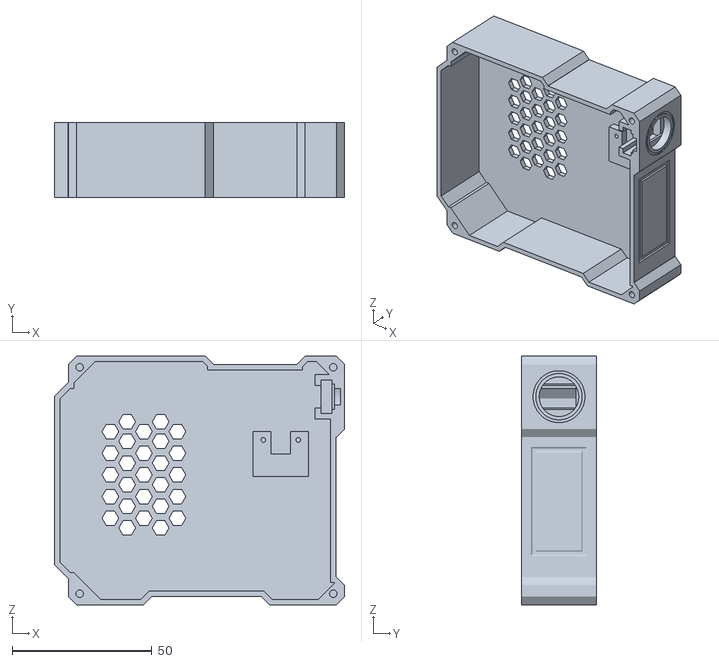
[picture p80: CAD file, 2026-11-08]
hardware/enclosure-a4/reference/original-lower.stl
103.8 x 27.0 x 89.0
