gmingtian/HachimoDock-esp32s3/hardware/enclosure-a4/reference/original-upper.stl

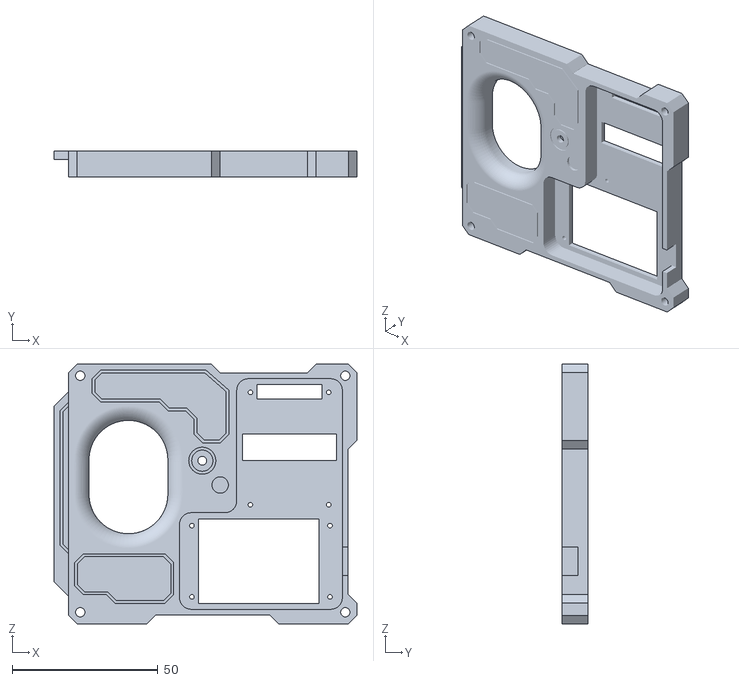
[picture p81: CAD file, 2026-11-08]
hardware/enclosure-a4/reference/original-upper.stl
103.8 x 9.00 x 89.0
