gmingtian/HachimoDock-esp32s3/hardware/enclosure-a4/output/r4-original-copy/full-r4.4/a4-lower-r4.4-speaker.stl

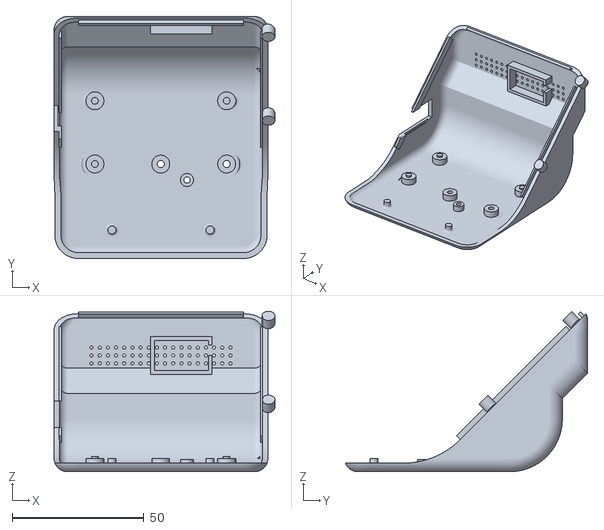
[picture p82: CAD file, 2026-11-08]
hardware/enclosure-a4/output/r4-original-copy/full-r4.4/a4-lower-r4.4-speaker.stl
83.8 x 91.9 x 60.9
