gmingtian/HachimoDock-esp32s3/hardware/enclosure-a4/print-parts/joystick-cap-b.stl

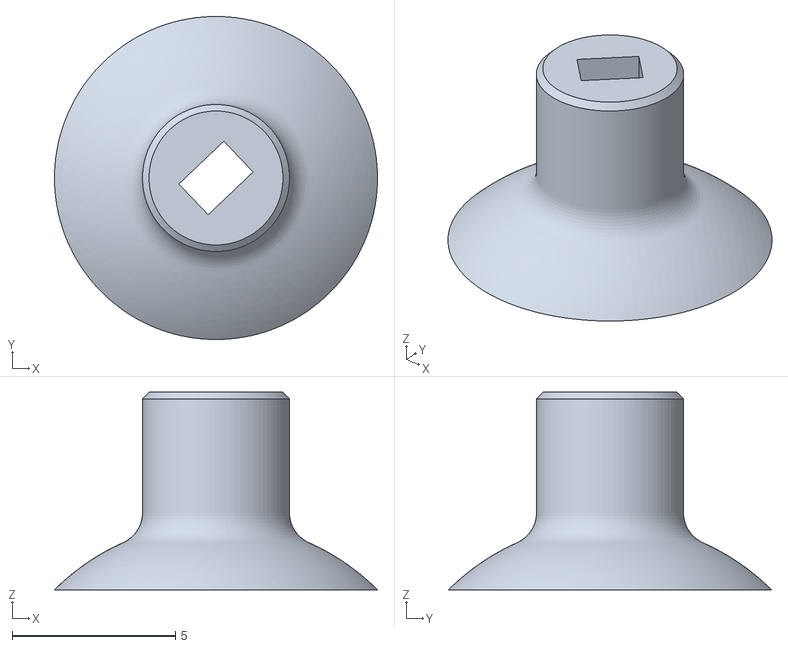
[picture p83: CAD file, 2026-11-09]
hardware/enclosure-a4/print-parts/joystick-cap-b.stl
9.89 x 9.89 x 6.05
