gmingtian/HachimoDock-esp32s3/hardware/enclosure-a4/print-parts/joystick-cap-a.stl

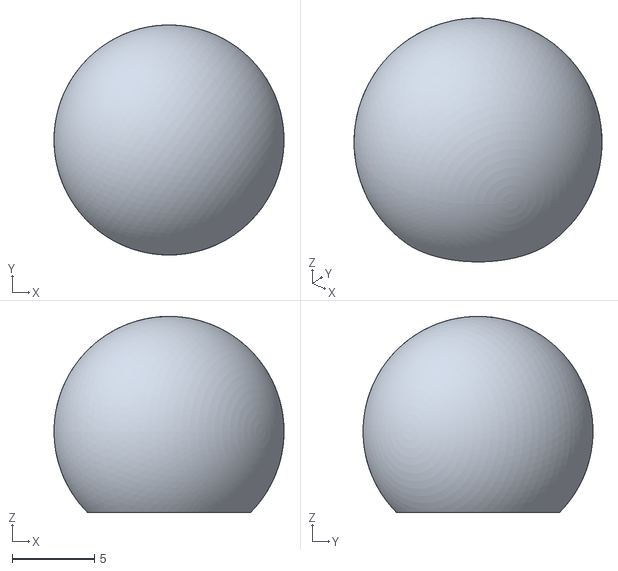
[picture p84: CAD file, 2026-11-09]
hardware/enclosure-a4/print-parts/joystick-cap-a.stl
14.0 x 14.0 x 11.9
