gmingtian/HachimoDock-esp32s3/hardware/enclosure-a4/print-parts/joystick-cover.stl

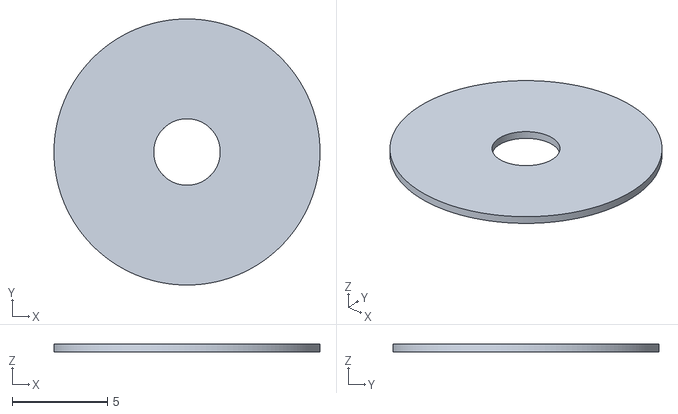
[picture p85: CAD file, 2026-11-09]
hardware/enclosure-a4/print-parts/joystick-cover.stl
14.0 x 14.0 x 0.4
