gmingtian/HachimoDock-esp32s3/(list of files, cad)

Other CAD files:
hardware/enclosure-a4/print-parts/keycap-2.stl
hardware/enclosure-a4/print-parts/keycap-1.stl
