gmingtian/HachimoDock-esp32s3/docs/INSTALLATION.md

# 安装与使用

当前发行源码为客户端 **0.1.203** 与 A4 S3 固件 **0.7.103-s3-r16d-80m-l320**，面向三颗按键＋四向摇杆、320×240 横屏。下载与 SHA-256 以[对应 Release 附件](https://github.com/gmingtian/HachimoDock-esp32s3/releases/tag/v0.1.203-s3-a4-r16d)为准。

## 客户端

| 平台 | 架构 | 安装方式 |
| --- | --- | --- |
| Windows | x64 | 运行 EXE 安装程序，首次安装可能需要联网准备 WebView2 |
| macOS | Apple Silicon arm64 | 打开 DMG，拖入 Applications；macOS 13.5+ |
| Linux | x86_64 | 解压客户端压缩包，运行 `./launch.sh`；依赖见 [Linux 原生客户端](../pc/docs/linux-native.md) |

本分支未声明商业代码签名或 Apple 公证。macOS 若阻止打开，在核对来源与校验值后使用系统“隐私与安全性”中针对此应用的“仍要打开”。不需要关闭整体安全保护。

本版附带的 Node.js 26.7.0 官方运行时要求 macOS 13.5 或更高版本，见 [Node.js 平台说明](https://github.com/nodejs/node/blob/v26.7.0/BUILDING.md#platform-list)。

Linux 包需要系统 GTK3、WebKitGTK 4.1、ALSA、udev 和 libatomic 运行库（Ubuntu/Debian 包名 `libatomic1`）；自定义形象转换需 Python 3.10+ 与包含 `libx264` 的 FFmpeg，具体系统库及构建环境见上述文档。Windows/macOS 资源内容以该版打包清单为准。Intel Mac 和 Linux ARM 不在本次安装包范围。

## 首次连接

1. 使用支持数据传输的 USB 线，连接 A4 开发板原生 USB 口。
2. 在设备页选择正确串口，核对 ESP32-S3、16MiB Flash、8MiB PSRAM、320×240 和 A4 输入模型。
3. 选择需要跟随的 Agent 会话；按需配置模型、语音或生成服务凭据及系统权限。
4. 使用客户端的形象同步、组件安装/修复，更新对应横屏资源。仅刷应用固件不会自动替换设备存储中的旧素材。

安装或启动客户端不会自动刷写设备。A4 默认操作见[按钮与摇杆](ESP32-S3-A4-Controls.md)。GPIO0 在复位和上电时须松开。

## 固件升级与恢复

- **应用 OTA**：用于已运行本项目且分区匹配的 S3。客户端校验芯片、项目、连接身份和传输完整性；升级失败或结果未知时先重新连接检查状态，不要盲目重放。
- **首次完整刷机**：只有明确标为 S3 factory 的完整镜像才能从 `0x0` 写入，会替换原固件及其中配置/资源。先保存自己的原固件和配置。
- **应用镜像不是完整镜像**：不得把应用 `.bin` 写入 `0x0`。串口直接写应用需先确认分区表和实际目标 OTA 槽，不硬编码当前活动分区。
- **P4 固件不能刷到 S3**，S3 包也不能刷入 P4。升级检查不能替代目标硬件核对。
- **回滚备份**：开发设备的全 Flash 备份含用户配置，只保存在本机，不作为公共出厂固件下载。

如该 Release 仅提供应用镜像，不要将它当作首次刷机包。完整工厂包、附件命名、大小及 SHA-256 均以该版交付清单为准。构建和接线见 [S3 开发说明](ESP32-S3-Linux.md)。

## Wi-Fi 与离线游戏

先 USB 配置 2.4GHz Wi-Fi 并绑定电脑，再在设备页选择 Wi-Fi。优先级、连接切换与恢复见 [Wi-Fi 使用说明](WIFI.md)。跨网、访客网络或 AP 隔离可能阻止直连。

五子棋和中国象棋的规则、AI、按键和画面都在设备运行，安装后不依赖电脑计算。城市电台、天气、Agent 同步和语音等功能仍依赖对应电脑/网络/服务。中国象棋暂不实现竞赛级长将长捉裁定，退出后重新开局。
