gmingtian/HachimoDock-esp32s3/firmware/assets/s3-landscape-ui/packages/token-usage/assets/background.png

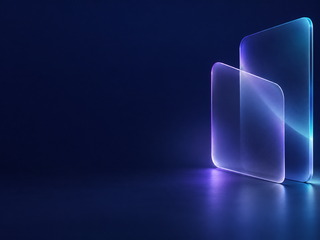
firmware/assets/s3-landscape-ui/packages/token-usage/assets/background.png
