gmingtian/HachimoDock-esp32s3/hardware/enclosure-a4/output/r4-original-copy/full-r4.4/complete-assembly.png

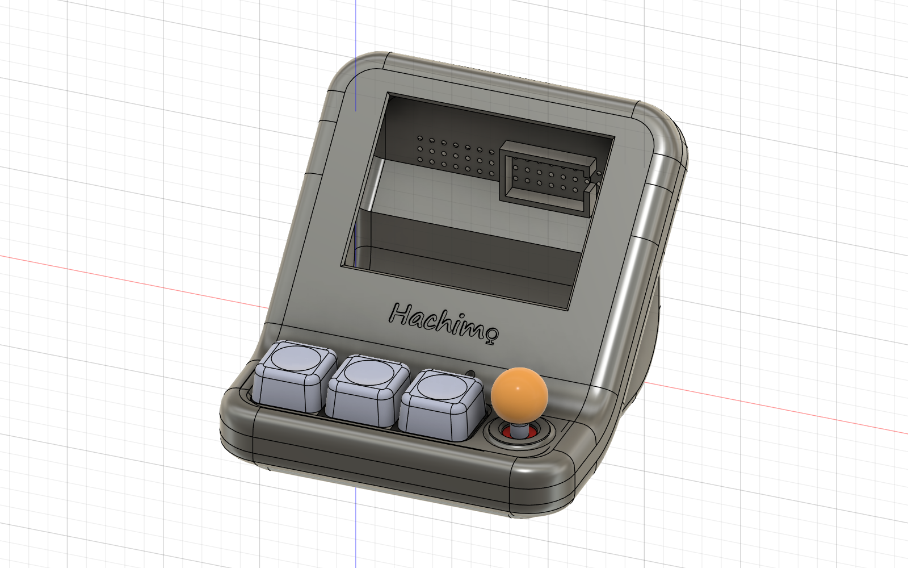
hardware/enclosure-a4/output/r4-original-copy/full-r4.4/complete-assembly.png
