gmingtian/HachimoDock-esp32s3/hardware/enclosure-a4/reference/assembled-user-side.jpg

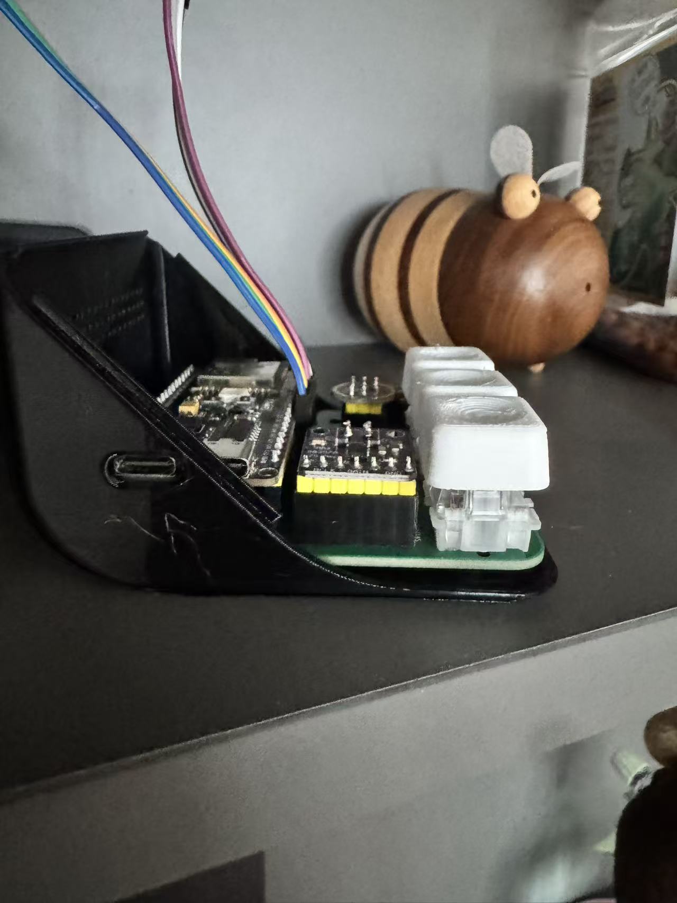
hardware/enclosure-a4/reference/assembled-user-side.jpg
