gmingtian/HachimoDock-esp32s3/hardware/s3-carrier/output/assembly-orientation.png

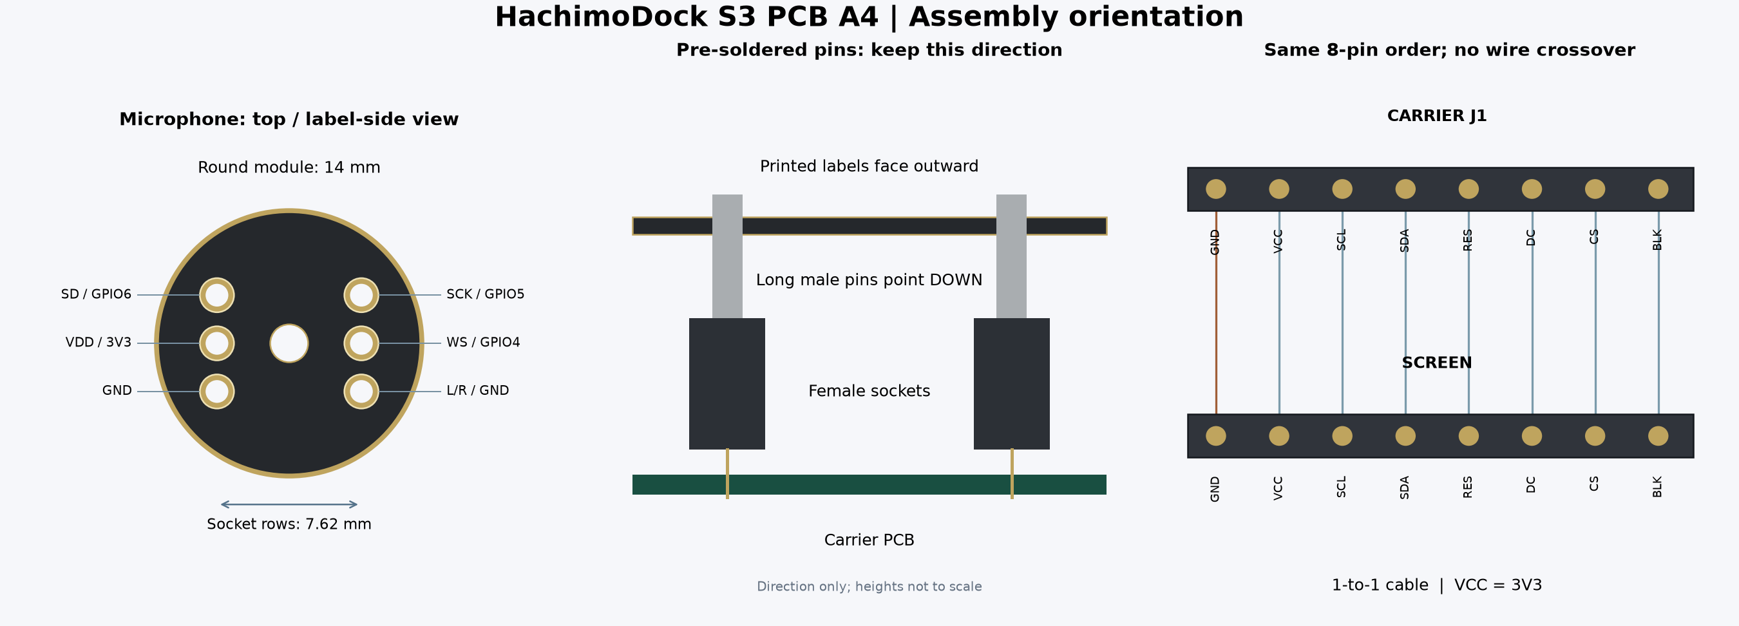
hardware/s3-carrier/output/assembly-orientation.png
