gmingtian/HachimoDock-esp32s3/hardware/s3-carrier/output/assembly-render/assembly-isometric.png

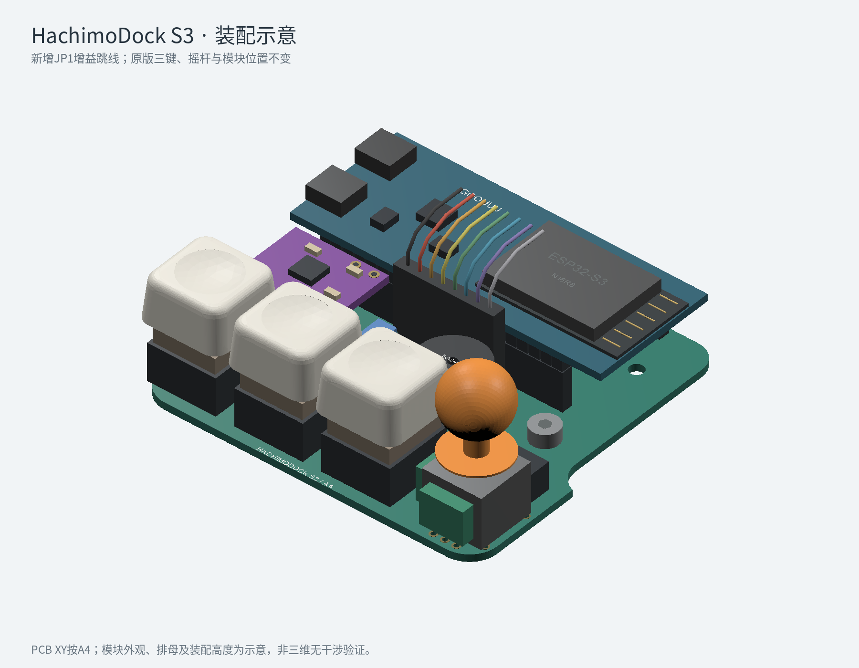
hardware/s3-carrier/output/assembly-render/assembly-isometric.png
