gmingtian/HachimoDock-esp32s3/hardware/s3-carrier/output/assembly-render/connector-fastener-clearance.png

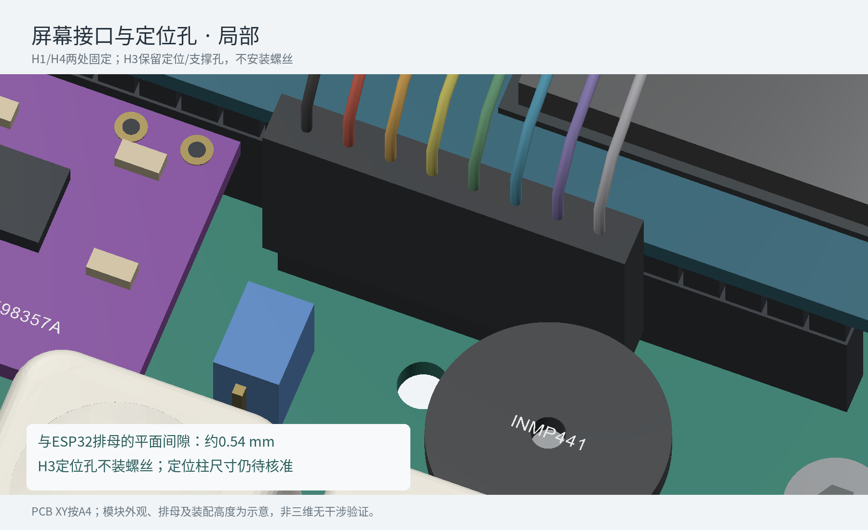
hardware/s3-carrier/output/assembly-render/connector-fastener-clearance.png
