gmingtian/HachimoDock-esp32s3/hardware/s3-carrier/output/assembly-render/rear.png

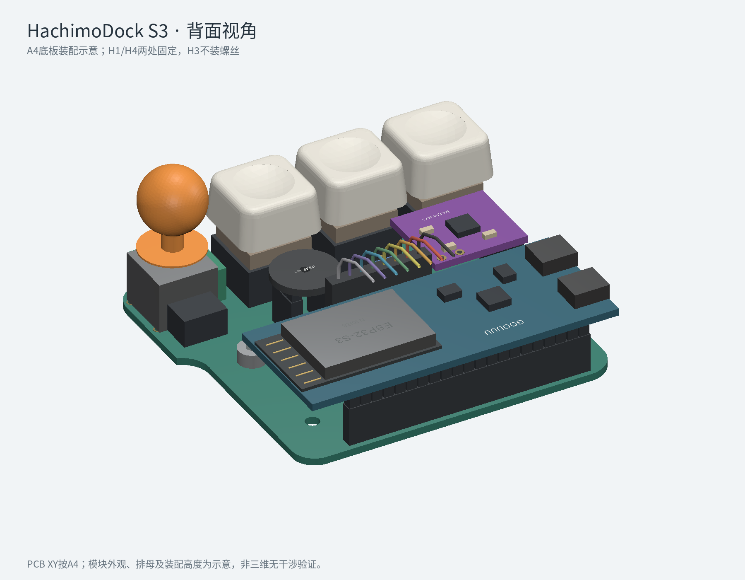
hardware/s3-carrier/output/assembly-render/rear.png
