gmingtian/HachimoDock-esp32s3/hardware/s3-carrier/output/HachimoDock-S3-carrier-A4-schematic.pdf

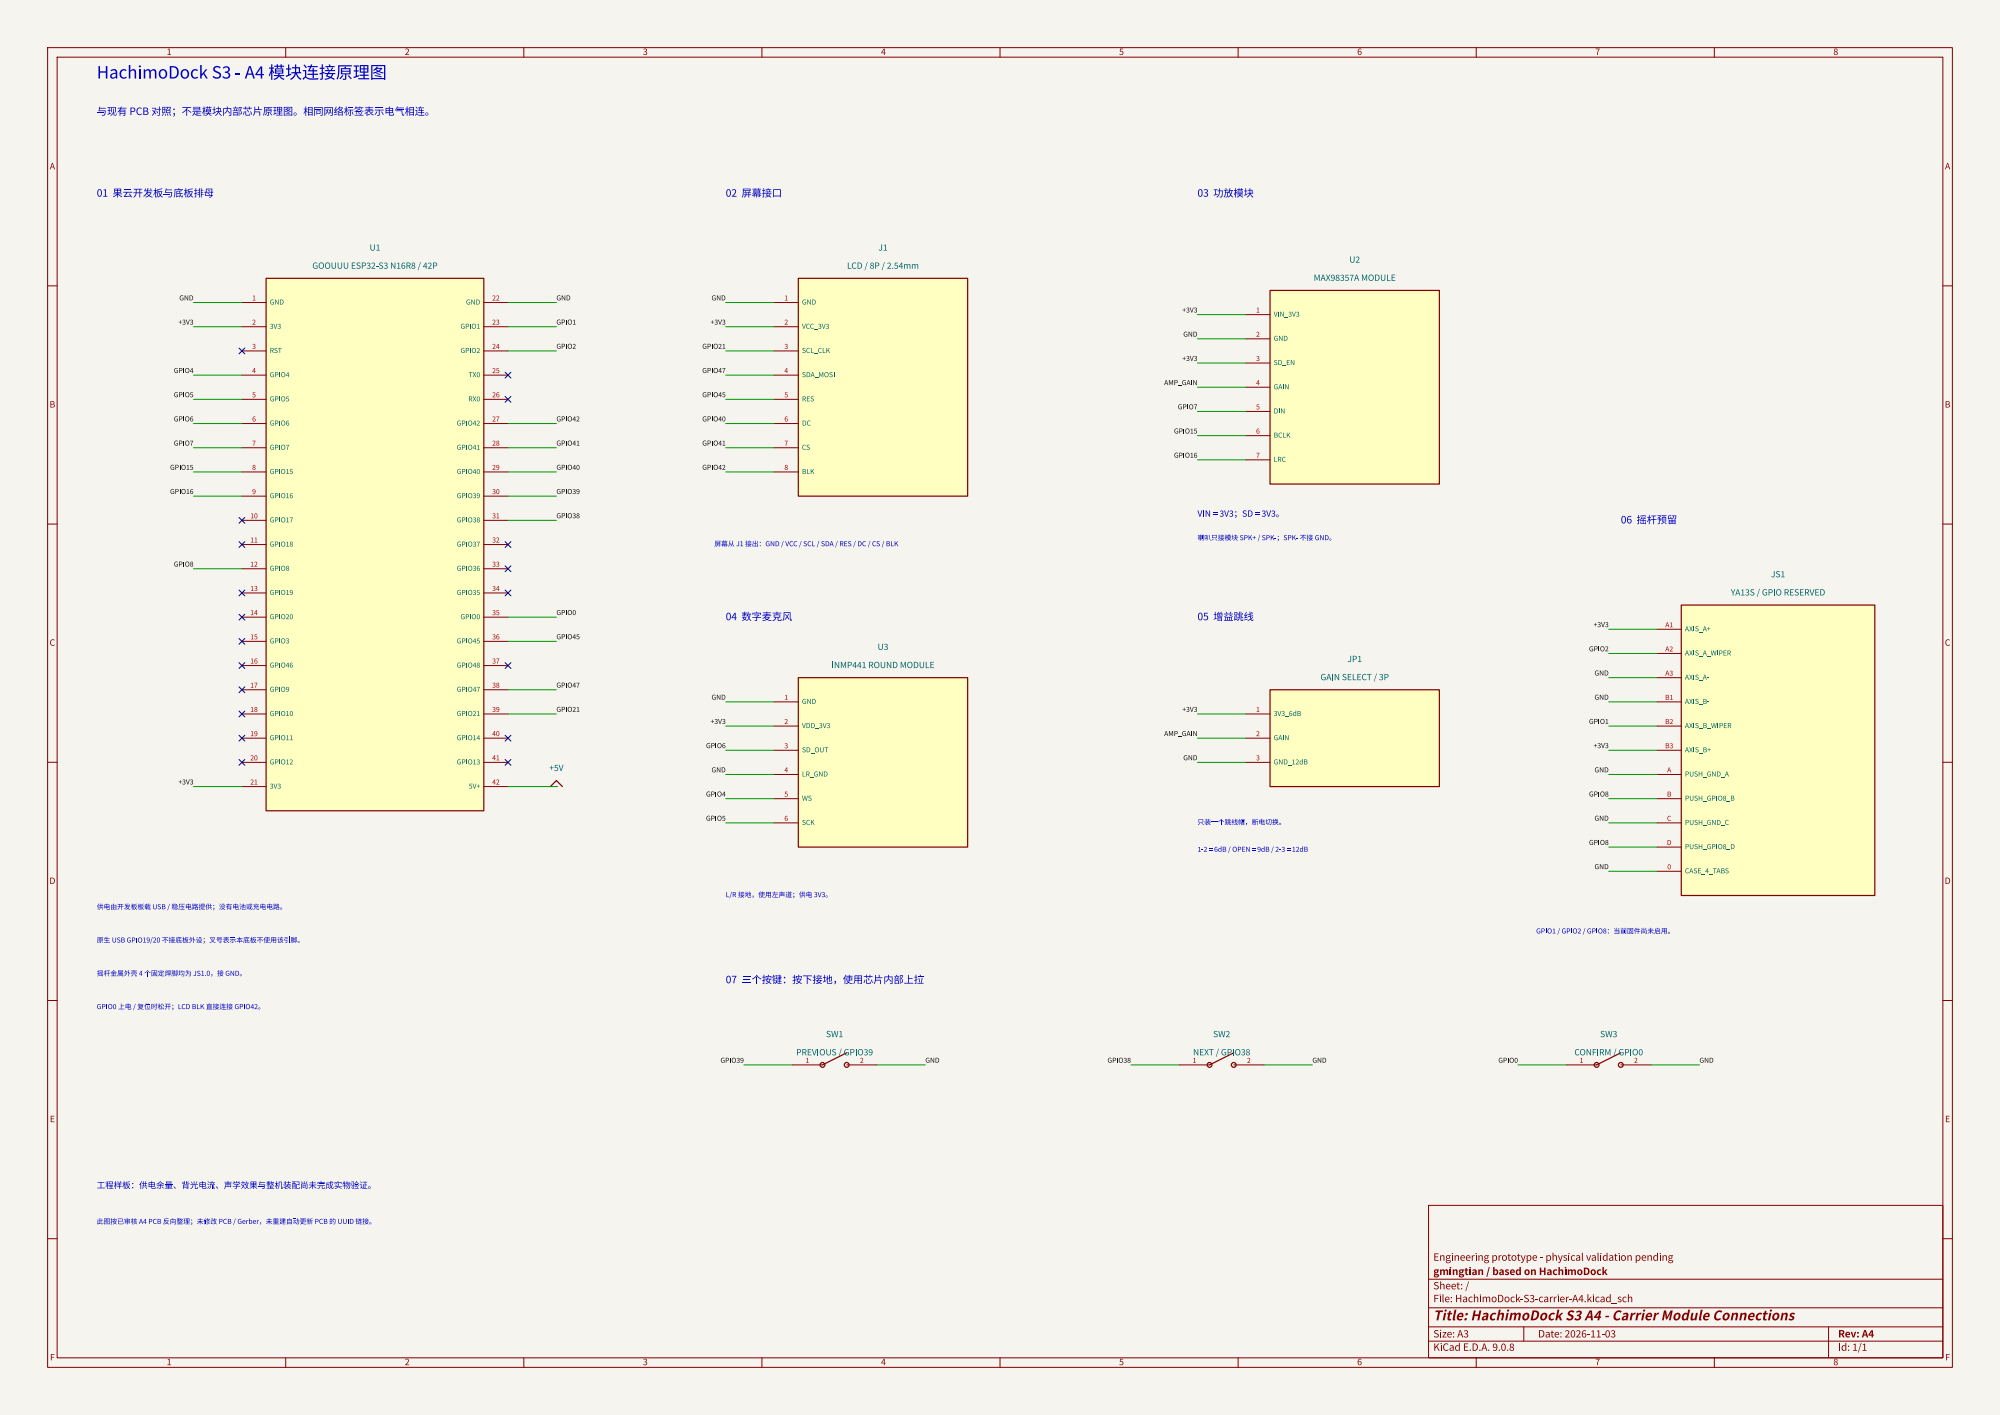
[picture p97: page 1]

HachimoDock S3 - A4 þÿj!WW•Þc¥SŸtVþ

vøT•Q~Üh{~ˆhy:u5lvø•Þ0-

þÿ\O^UNÎ J1 þÿc¥QúÿGND / VCC/ SCL/ SDA/ RES/ DC/ CS/ BLK 01 þÿgœN‘_SÑg•N^•g•c’kÍ

þÿU‡SíSêc¥j!WWSPK+/ þÿSPK-ÿSPK- þÿN

04 þÿep[Wž¦QK˜Î 07 þÿN N*c •.ÿc Nc¥W0ÿO•u(‚¯rGQ…•èN

L/R þÿc¥W0ÿO•u(]æXð•SÿO›u5 þÿ3V30-

þÿO›u5u1_SÑg•g••} USB/ þÿz3S‹u5•ïcÐO›ÿl¡g u5l`bQEu5u5•ï0-

þÿdGgF‘Ñ\^YXó4 þÿN*Vú[šq

OMeög~_ÿLCD BLK þÿvôc¥•Þc¥þÿGPIO420-

þÿ]åzh7g•ÿO›u5OY‘Ï0€ÌQIu5mA0Xð[feHgœNetg:ˆÅ‘M\g*[Œb[žrišŒ‹Á0-

þÿkdVþc ]ò[¡h8A4 PCBþÿSÍTettÿg*Oîe9PCB/ þÿGerberÿg*‘Í^ú•êR¨fôe° PCBþÿv„UUID þÿ”þc¥0-

File: HachimoDock-S3-carrier-A4.kicad_sch Sheet: / gmingtian / based on HachimoDock Engineering prototype - physical validation pending

Id: 1/1 Title: HachimoDock S3 A4 - Carrier Module Connections
