gmingtian/HachimoDock-esp32s3/(list of files, drawings)

Other design files:
hardware/s3-carrier/output/schematic-audit.json
hardware/s3-carrier/output/schematic-erc.json
