gmingtian/HachimoDock-esp32s3/hardware/s3-carrier/output/HachimoDock-S3-carrier-A4.kicad_pcb

## KiCad design hardware/s3-carrier/output/HachimoDock-S3-carrier-A4.kicad_pcb (2026-11-02)

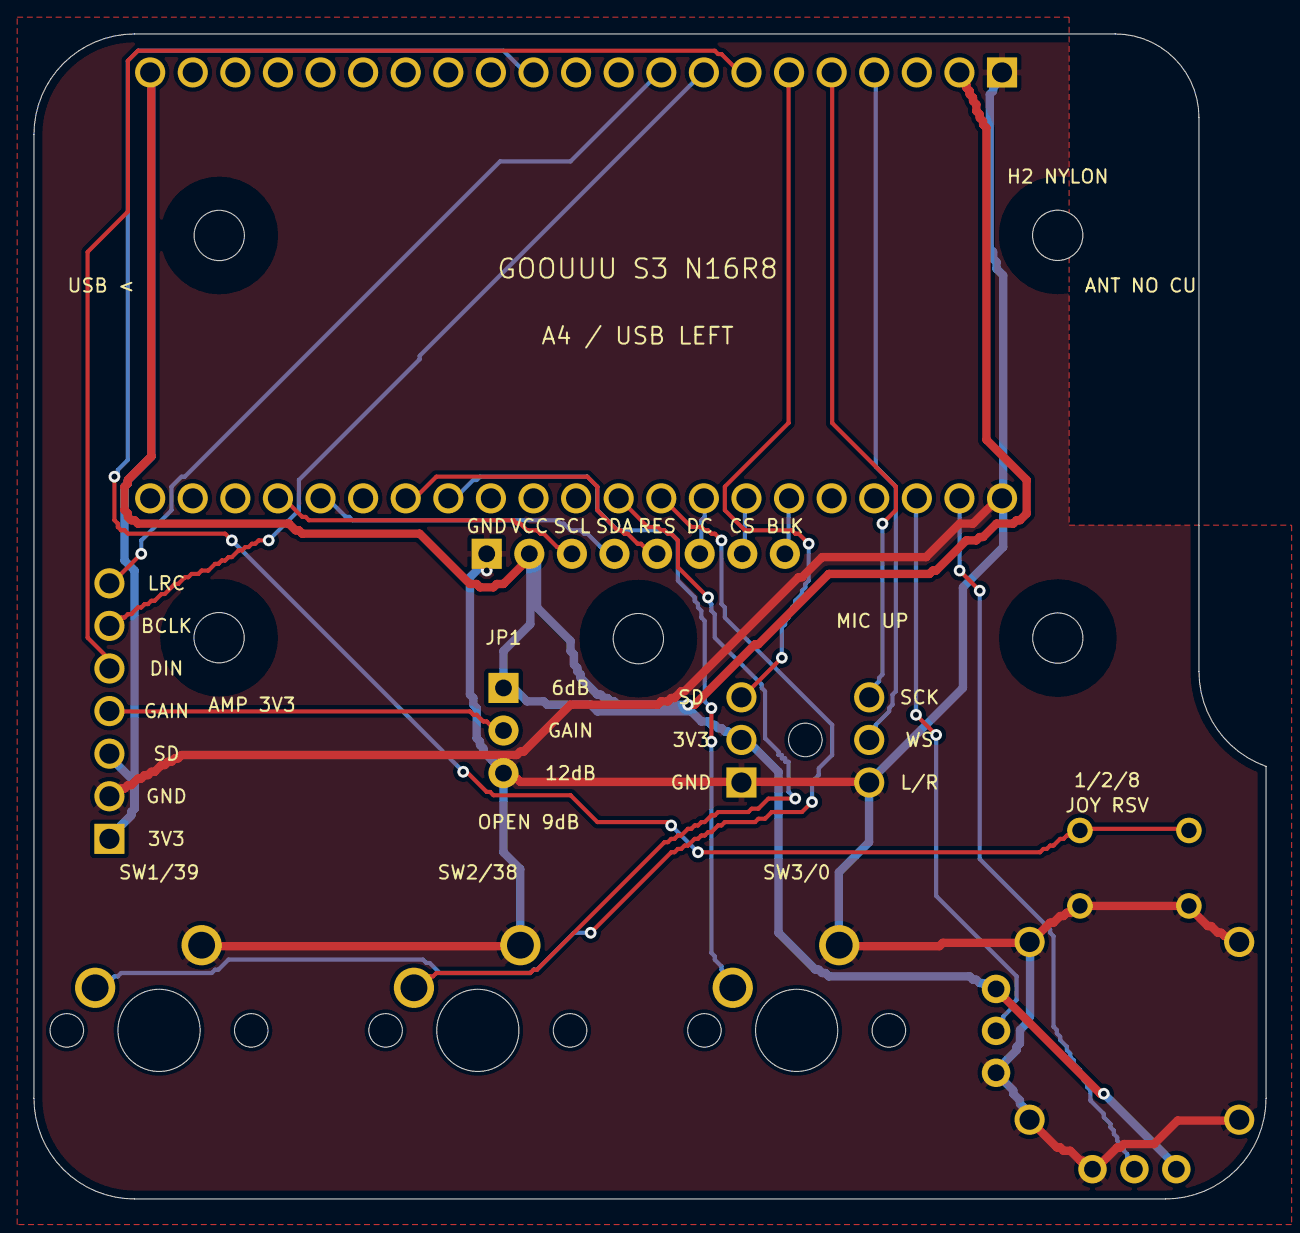
[picture p98: board HachimoDock-S3-carrier-A4.kicad_pcb from above]

Board: 2 copper layers, 73.5 x 69.5 mm, 14 parts (0 on the bottom side), 21 nets.

Parts:
H1: H1
H2: H2
H3: H3
H4: H4
H5: H5
J1: LCD: GND VCC(3V3) SCL SDA RES DC CS BLK; J1
JP1: AMP GAIN / 1-2=6dB OPEN=9dB 2-3=12dB; JP1
JS1: Original YA13S joystick; JS1
SW1: Original switch / GPIO39; SW1
SW2: Original switch / GPIO38; SW2
SW3: Original switch / GPIO0; SW3
U1: GOOUUU S3 N16R8 / 2x21 sockets; U1
U2: MAX98357A module; U2
U3: Round INMP441 / 14mm; U3

Connections:
+3V3: J1.2, JP1.1, JS1.A1, JS1.B3, U1.2, U1.21, U2.1, U2.3, U3.2
AMP_GAIN: JP1.2, U2.4
GND: J1.1, JP1.3, JS1.0, JS1.A, JS1.A3, JS1.B1, JS1.C, SW1.2, SW2.2, SW3.2, U1.1, U1.22, U2.2, U3.1, U3.4
GPIO0: SW3.1, U1.35
GPIO1: JS1.B2, U1.23
GPIO2: JS1.A2, U1.24
GPIO4: U1.4, U3.5
GPIO5: U1.5, U3.6
GPIO6: U1.6, U3.3
GPIO7: U1.7, U2.5
GPIO8: JS1.B, JS1.D, U1.12
GPIO15: U1.8, U2.6
GPIO16: U1.9, U2.7
GPIO21: J1.3, U1.39
GPIO38: SW2.1, U1.31
GPIO39: SW1.1, U1.30
GPIO40: J1.6, U1.29
GPIO41: J1.7, U1.28
GPIO42: J1.8, U1.27
GPIO45: J1.5, U1.36
GPIO47: J1.4, U1.38
