gmingtian/HachimoDock-esp32s3/firmware/main/pet_p4_game.c

/*
 * [Input] A validated preset or declarative scene, bounded tick rate, and semantic controls.
 * [Output] A deterministic fixed-grid frame retaining semantic shapes and sprite references.
 * [Pos] Heap-free, script-free gameplay engine used by the declarative mini-app runtime.
 */

#include "pet_p4_game.h"

#ifdef ESP_PLATFORM
#include "sdkconfig.h"
#endif

#include <stddef.h>
#include <string.h>

#define BLOCKS_WIDTH 10
#define BLOCKS_HEIGHT 16
#define SNAKE_WIDTH 16
#define SNAKE_HEIGHT 10
#define FLAPPY_WIDTH 16
#define FLAPPY_HEIGHT 10
#define FLAPPY_BIRD_X 3
#define FLAPPY_PIPE_WIDTH 2
#define FLAPPY_PIPE_GAP 4
#define FLAPPY_PIPE_SPACING 9
#define FLAPPY_GRAVITY_Q8 80
#define FLAPPY_FLAP_VELOCITY_Q8 -256
#define FLAPPY_MAX_FALL_VELOCITY_Q8 512
#define GAME_TICK_MIN_MS 100U
#define GAME_TICK_MAX_MS 2000U
#define BOUNDED_EVENT_MAX 32
#define BOUNDED_AXIS_X 1U
#define BOUNDED_AXIS_Y 2U

/* Keep portable/P4 preview timing; S3 can admit the same bounded work sooner. */
#if defined(CONFIG_IDF_TARGET_ESP32S3) && CONFIG_IDF_TARGET_ESP32S3
#define XIANGQI_WORK_INTERVAL_MS 2U
#else
#define XIANGQI_WORK_INTERVAL_MS 8U
#endif

typedef struct {
  pet_p4_game_trigger_t trigger;
  int8_t entity_index;
  pet_p4_game_edge_t edge;
} bounded_event_t;

static const uint16_t BLOCK_MASKS[7][4] = {
  {0x00f0, 0x2222, 0x00f0, 0x2222}, /* I */
  {0x0066, 0x0066, 0x0066, 0x0066}, /* O */
  {0x0072, 0x0262, 0x0270, 0x0232}, /* T */
  {0x0036, 0x0462, 0x0036, 0x0462}, /* S */
  {0x0063, 0x0264, 0x0063, 0x0264}, /* Z */
  {0x0071, 0x0226, 0x0470, 0x0322}, /* J */
  {0x0074, 0x0622, 0x0170, 0x0223}, /* L */
};

static uint32_t game_random(pet_p4_game_engine_t *game) {
  game->rng = game->rng * 1664525U + 1013904223U;
  return game->rng;
}

static int game_cell_index(const pet_p4_game_engine_t *game, int x, int y) {
  if (!game || x < 0 || y < 0 || x >= game->width || y >= game->height) return -1;
  return y * game->width + x;
}

static int bounded_clamp(int value, int minimum, int maximum) {
  if (value < minimum) return minimum;
  if (value > maximum) return maximum;
  return value;
}

static int32_t bounded_score(int64_t value) {
  if (value < -1000000000LL) return -1000000000;
  if (value > 1000000000LL) return 1000000000;
  return (int32_t) value;
}

static void bounded_queue_event(
  bounded_event_t *events,
  uint8_t *event_count,
  pet_p4_game_trigger_t trigger,
  int entity_index,
  pet_p4_game_edge_t edge
) {
  if (!events || !event_count || *event_count >= BOUNDED_EVENT_MAX) return;
  events[*event_count].trigger = trigger;
  events[*event_count].entity_index = (int8_t) entity_index;
  events[*event_count].edge = edge;
  *event_count += 1;
}

static bool bounded_hits_solid(
  const pet_p4_game_engine_t *game,
  const pet_p4_game_entity_t *entity,
  int x,
  int y
) {
  if (!game || !entity || game->bounded.solid_tone_mask == 0) return false;
  for (int py = 0; py < entity->height; py += 1) {
    for (int px = 0; px < entity->width; px += 1) {
      int index = game_cell_index(game, x + px, y + py);
      if (index < 0) continue;
      uint8_t tone = game->bounded.base_cells[index];
      if (tone > 0 && (game->bounded.solid_tone_mask & (1U << tone)) != 0) {
        return true;
      }
    }
  }
  return false;
}

static bool bounded_entities_overlap(
  const pet_p4_game_entity_t *left,
  const pet_p4_game_entity_t *right
) {
  if (!left || !right || !left->active || !right->active
      || !left->collidable || !right->collidable) {
    return false;
  }
  return left->x < right->x + right->width
    && left->x + left->width > right->x
    && left->y < right->y + right->height
    && left->y + left->height > right->y;
}

/* Reuse an off-screen slot after the furthest platform. All coordinates stay
 * local to the camera; endless play never allocates or grows world positions. */
static void track_append(pet_p4_game_engine_t *g,unsigned index,int previous){
  const pet_p4_bounded_game_config_t *c=&g->bounded;
  pet_p4_game_entity_t *e=&g->bounded_entities[index],*p=&g->bounded_entities[previous];
  unsigned gap=c->gap_min+(game_random(g)>>8)%(c->gap_max-c->gap_min+1);
  e->x_q8=p->x_q8+(p->width+gap)*256;
  e->width=c->width_min+(game_random(g)>>8)%(c->width_max-c->width_min+1);
  unsigned tones[4],n=0;
  for(unsigned t=1;t<=4;t++)if((c->tone_mask&(1u<<t))&&t!=p->tone)tones[n++]=t;
  e->tone=tones[(game_random(g)>>8)%n];e->y_q8=p->y_q8;
  e->x=(int8_t)(e->x_q8/256);e->y=p->y;e->active=true;
  g->track_visited&=~(1u<<index);
}

static bool track_camera(pet_p4_game_engine_t *g){
  const pet_p4_bounded_game_config_t *c=&g->bounded;
  if(!c->track)return false;
  int32_t delta=g->bounded_entities[c->motion_body].x_q8-c->camera_x*256;
  if(delta<=0)return false;
  int32_t shift=delta>4?delta/4:delta;
  for(unsigned i=0;i<c->entity_count;i++){
    pet_p4_game_entity_t *e=&g->bounded_entities[i];e->x_q8-=shift;e->x=(int8_t)(e->x_q8/256);
  }
  g->camera_travel_q8+=shift;
  for(unsigned i=0;i<c->entity_count;i++){
    pet_p4_game_entity_t *e=&g->bounded_entities[i];
    if(!(c->platform_mask&(1u<<i))||e->x_q8+e->width*256>=-256)continue;
    int last=-1;
    for(unsigned j=0;j<c->entity_count;j++)if((c->platform_mask&(1u<<j))&&(last<0||g->bounded_entities[j].x_q8>g->bounded_entities[last].x_q8))last=j;
    track_append(g,i,last);
  }
  return true;
}

static void bounded_reset(
  pet_p4_game_engine_t *game,
  uint64_t now_ms,
  bool running
) {
  if (!game) return;
  memcpy(
    game->bounded_entities,
    game->bounded.entities,
    sizeof(game->bounded_entities)
  );
  game->score = 0;
  game->running = running;
  game->game_over = false;
  game->last_tick_ms = now_ms;
  game->charging=false;game->grounded=true;game->charge_elapsed_ms=0;
  game->motion_vx_q8=game->motion_vy_q8=0;
  game->track_visited=0;game->camera_travel_q8=0;
  for(unsigned i=0;i<game->bounded.entity_count;i++){
    game->bounded_entities[i].x_q8=game->bounded_entities[i].x*256;
    game->bounded_entities[i].y_q8=game->bounded_entities[i].y*256;
    game->bounded_entities[i].body_vx_q8=game->bounded_entities[i].vx*256;
    game->bounded_entities[i].body_vy_q8=game->bounded_entities[i].vy*256;
    game->bounded_entities[i].angle_q8=0;
    game->bounded_entities[i].body_rx=game->bounded_entities[i].body_ry=game->bounded_entities[i].body_rg=0;
  }
  if(game->bounded.track){
    pet_p4_game_entity_t *b=&game->bounded_entities[game->bounded.motion_body];int home=-1;
    for(unsigned i=0;i<game->bounded.entity_count;i++){
      pet_p4_game_entity_t *p=&game->bounded_entities[i];
      if((game->bounded.platform_mask&(1u<<i))&&b->y+b->height==p->y&&b->x*2+b->width>=p->x*2&&b->x*2+b->width<(p->x+p->width)*2){home=i;break;}
    }
    game->track_visited=1u<<home;
    int last=home;
    for(unsigned i=0;i<game->bounded.entity_count;i++)if((game->bounded.platform_mask&(1u<<i))&&(int)i!=home){track_append(game,i,last);last=i;}
  }
}

static bool bounded_move_entity(
  pet_p4_game_engine_t *game,
  int entity_index,
  int dx,
  int dy,
  bounded_event_t *events,
  uint8_t *event_count
) {
  pet_p4_game_entity_t *entity;
  int old_x;
  int old_y;
  int next_x;
  int next_y;
  int max_x;
  int max_y;
  bool changed = false;
  bool crossed_x = false;
  bool crossed_y = false;
  pet_p4_game_edge_t edge_x = PET_P4_GAME_EDGE_NONE;
  pet_p4_game_edge_t edge_y = PET_P4_GAME_EDGE_NONE;
  if (!game || entity_index < 0 || entity_index >= game->bounded.entity_count) return false;
  entity = &game->bounded_entities[entity_index];
  if (!entity->active || (dx == 0 && dy == 0)) return false;
  old_x = entity->x;
  old_y = entity->y;
  next_x = old_x + dx;
  next_y = old_y + dy;
  max_x = game->width - entity->width;
  max_y = game->height - entity->height;

  if (next_x < 0) {
    crossed_x = true;
    edge_x = PET_P4_GAME_EDGE_LEFT;
  } else if (next_x > max_x) {
    crossed_x = true;
    edge_x = PET_P4_GAME_EDGE_RIGHT;
  }
  if (next_y < 0) {
    crossed_y = true;
    edge_y = PET_P4_GAME_EDGE_TOP;
  } else if (next_y > max_y) {
    crossed_y = true;
    edge_y = PET_P4_GAME_EDGE_BOTTOM;
  }

  if (crossed_x || crossed_y) {
    if (entity->bounds == PET_P4_GAME_BOUNDS_WRAP) {
      if (next_x < 0) next_x = max_x;
      else if (next_x > max_x) next_x = 0;
      if (next_y < 0) next_y = max_y;
      else if (next_y > max_y) next_y = 0;
    } else {
      next_x = bounded_clamp(next_x, 0, max_x);
      next_y = bounded_clamp(next_y, 0, max_y);
      if (entity->bounds == PET_P4_GAME_BOUNDS_BOUNCE) {
        if (crossed_x) entity->vx = (int8_t) -entity->vx;
        if (crossed_y) entity->vy = (int8_t) -entity->vy;
      } else if (entity->bounds == PET_P4_GAME_BOUNDS_HIDE) {
        entity->active = false;
      } else if (entity->bounds == PET_P4_GAME_BOUNDS_STOP) {
        game->running = false;
        game->game_over = true;
      }
    }
    if (crossed_x) {
      bounded_queue_event(
        events,
        event_count,
        PET_P4_GAME_TRIGGER_EDGE,
        entity_index,
        edge_x
      );
    }
    if (crossed_y) {
      bounded_queue_event(
        events,
        event_count,
        PET_P4_GAME_TRIGGER_EDGE,
        entity_index,
        edge_y
      );
    }
  }

  if (entity->active && bounded_hits_solid(game, entity, next_x, next_y)) {
    next_x = old_x;
    next_y = old_y;
    if (entity->bounds == PET_P4_GAME_BOUNDS_BOUNCE) {
      if (dx != 0) entity->vx = (int8_t) -entity->vx;
      if (dy != 0) entity->vy = (int8_t) -entity->vy;
    }
    bounded_queue_event(
      events,
      event_count,
      PET_P4_GAME_TRIGGER_BLOCKED,
      entity_index,
      PET_P4_GAME_EDGE_NONE
    );
  }
  if (next_x != old_x || next_y != old_y) {
    entity->x = (int8_t) next_x;
    entity->y = (int8_t) next_y;
    changed = true;
  }
  return changed || crossed_x || crossed_y;
}

static int bounded_random_range(
  pet_p4_game_engine_t *game,
  int minimum,
  int maximum
) {
  if (maximum <= minimum) return minimum;
  return minimum + (int) (game_random(game) % (uint32_t) (maximum - minimum + 1));
}

static bool bounded_place_entity(
  pet_p4_game_engine_t *game,
  const pet_p4_game_op_t *op
) {
  pet_p4_game_entity_t *entity;
  const pet_p4_game_entity_t *source = NULL;
  int next_x;
  int next_y;
  int max_x;
  int max_y;
  if (!game || !op || op->entity_index < 0
      || op->entity_index >= game->bounded.entity_count) {
    return false;
  }
  entity = &game->bounded_entities[op->entity_index];
  if (op->source_index >= 0 && op->source_index < game->bounded.entity_count) {
    source = &game->bounded_entities[op->source_index];
  }
  next_x = source ? source->x + op->dx : entity->x;
  next_y = source ? source->y + op->dy : entity->y;
  if (op->has_x) {
    next_x = op->random_x
      ? bounded_random_range(game, op->x_min, op->x_max)
      : op->x_min;
  }
  if (op->has_y) {
    next_y = op->random_y
      ? bounded_random_range(game, op->y_min, op->y_max)
      : op->y_min;
  }
  max_x = game->width - entity->width;
  max_y = game->height - entity->height;
  next_x = bounded_clamp(next_x, 0, max_x);
  next_y = bounded_clamp(next_y, 0, max_y);
  bool changed = !entity->active || entity->x != next_x || entity->y != next_y;
  entity->x = (int8_t) next_x;
  entity->y = (int8_t) next_y;
  entity->active = true;
  return changed;
}

static bool bounded_apply_op(
  pet_p4_game_engine_t *game,
  const pet_p4_game_op_t *op,
  uint64_t now_ms,
  bounded_event_t *events,
  uint8_t *event_count
) {
  pet_p4_game_entity_t *entity = NULL;
  if (!game || !op) return false;
  if (op->entity_index >= 0 && op->entity_index < game->bounded.entity_count) {
    entity = &game->bounded_entities[op->entity_index];
  }
  if(op->kind==PET_P4_GAME_OP_IMPULSE){
    if(!game->bounded.bodies||!entity||!entity->body||entity->body_static||!entity->mass)return false;
    entity->body_vx_q8=bounded_clamp(entity->body_vx_q8+op->dx*256/entity->mass,-16384,16384);
    entity->body_vy_q8=bounded_clamp(entity->body_vy_q8+op->dy*256/entity->mass,-16384,16384);
    return true;
  }
  if (op->kind == PET_P4_GAME_OP_MOVE) {
    return bounded_move_entity(
      game,
      op->entity_index,
      op->dx,
      op->dy,
      events,
      event_count
    );
  }
  if (op->kind == PET_P4_GAME_OP_VELOCITY && entity) {
    bool changed = entity->vx != op->vx || entity->vy != op->vy;
    entity->vx = op->vx;
    entity->vy = op->vy;
    return changed;
  }
  if (op->kind == PET_P4_GAME_OP_ACCELERATE && entity) {
    int next_vx = bounded_clamp(entity->vx + op->vx, -4, 4);
    int next_vy = bounded_clamp(entity->vy + op->vy, -4, 4);
    bool changed = entity->vx != next_vx || entity->vy != next_vy;
    entity->vx = (int8_t) next_vx;
    entity->vy = (int8_t) next_vy;
    return changed;
  }
  if (op->kind == PET_P4_GAME_OP_PLACE) {
    bool changed=bounded_place_entity(game, op);
    if(game->bounded.motion&&entity){
      entity->x_q8=entity->x*256;entity->y_q8=entity->y*256;
      if(op->entity_index==game->bounded.motion_body){game->motion_vx_q8=game->motion_vy_q8=0;game->grounded=true;game->charging=false;game->charge_elapsed_ms=0;}
    }
    return changed;
  }
  if (op->kind == PET_P4_GAME_OP_SHOW && entity) {
    bool changed = !entity->active;
    entity->active = true;
    return changed;
  }
  if (op->kind == PET_P4_GAME_OP_HIDE && entity) {
    bool changed = entity->active;
    entity->active = false;
    return changed;
  }
  if (op->kind == PET_P4_GAME_OP_SCORE_ADD) {
    int32_t next = bounded_score((int64_t) game->score + op->value);
    bool changed = next != game->score;
    game->score = next;
    return changed;
  }
  if (op->kind == PET_P4_GAME_OP_SCORE_SET) {
    int32_t next = bounded_score(op->value);
    bool changed = next != game->score;
    game->score = next;
    return changed;
  }
  if (op->kind == PET_P4_GAME_OP_RUN) {
    bool changed = !game->running || game->game_over;
    game->running = true;
    game->game_over = false;
    game->last_tick_ms = now_ms;
    return changed;
  }
  if (op->kind == PET_P4_GAME_OP_STOP) {
    bool changed = game->running || !game->game_over;
    game->running = false;
    game->game_over = true;
    return changed;
  }
  if (op->kind == PET_P4_GAME_OP_RESTART) {
    bounded_reset(game, now_ms, true);
    return true;
  }
  if (op->kind == PET_P4_GAME_OP_BOUNCE && entity) {
    int8_t old_vx = entity->vx;
    int8_t old_vy = entity->vy;
    if ((op->axis_mask & BOUNDED_AXIS_X) != 0) entity->vx = (int8_t) -entity->vx;
    if ((op->axis_mask & BOUNDED_AXIS_Y) != 0) entity->vy = (int8_t) -entity->vy;
    return old_vx != entity->vx || old_vy != entity->vy;
  }
  if (op->kind == PET_P4_GAME_OP_TONE && entity) {
    bool changed = entity->tone != op->tone;
    entity->tone = op->tone;
    return changed;
  }
  if (op->kind == PET_P4_GAME_OP_SFX) {
    if (op->value < 0 || op->value >= 8) return false;
    game->sfx_pending |= (uint8_t) (1u << op->value);
    return false; /* audible, not a board change */
  }
  if (op->kind == PET_P4_GAME_OP_VAR_SET || op->kind == PET_P4_GAME_OP_VAR_INC) {
    /* p4-logic-v1: entity_index addresses the mirrored runtime var slot. */
    if (op->entity_index < 0 || op->entity_index >= game->var_count) return false;
    int64_t next = op->kind == PET_P4_GAME_OP_VAR_SET
      ? (int64_t) op->value : (int64_t) game->vars[op->entity_index] + op->value;
    if (next < -PET_P4_GAME_VAR_LIMIT) next = -PET_P4_GAME_VAR_LIMIT;
    if (next > PET_P4_GAME_VAR_LIMIT) next = PET_P4_GAME_VAR_LIMIT;
    bool changed = game->vars[op->entity_index] != (int32_t) next;
    game->vars[op->entity_index] = (int32_t) next;
    return changed;
  }
  if(game->bounded.motion&&op->entity_index==game->bounded.motion_body){
    if(op->kind==PET_P4_GAME_OP_CANCEL){bool changed=game->charging;game->charging=false;game->charge_elapsed_ms=0;return changed;}
    if(op->kind==PET_P4_GAME_OP_CHARGE){
      if(game->game_over)bounded_reset(game,now_ms,true);
      else if(!game->running){
        /* Entry already prepared the visible board. Starting it must not
         * consume RNG or replace the platforms the player aimed at. */
        game->running=true;game->last_tick_ms=now_ms;
      }
    }
    if(op->kind==PET_P4_GAME_OP_CHARGE&&game->running&&game->grounded&&!game->charging){game->charging=true;game->charge_elapsed_ms=1;return true;}
    if(op->kind==PET_P4_GAME_OP_LAUNCH&&game->running&&game->grounded&&game->charging){
      unsigned ms=game->charge_elapsed_ms;
      if(ms>game->bounded.charge_ms)ms=game->bounded.charge_ms;
      game->motion_vx_q8=256*game->bounded.launch_min+(256*(game->bounded.launch_max-game->bounded.launch_min)*ms)/game->bounded.charge_ms;
      game->motion_vy_q8=-256*game->bounded.lift;game->grounded=false;game->charging=false;game->charge_elapsed_ms=0;return true;
    }
  }
  return false;
}

bool pet_p4_game_compare(int32_t left, unsigned op, int32_t right) {
  switch (op) {
    case PET_P4_GAME_CMP_LTE: return left <= right;
    case PET_P4_GAME_CMP_LT: return left < right;
    case PET_P4_GAME_CMP_GTE: return left >= right;
    case PET_P4_GAME_CMP_GT: return left > right;
    case PET_P4_GAME_CMP_EQ: return left == right;
    case PET_P4_GAME_CMP_NE: return left != right;
    default: return false;
  }
}

/* p4-logic-v1 rule guard. An unknown var slot never fires, it does not
 * silently read a stale initial value. */
static bool bounded_rule_guard(const pet_p4_game_engine_t *game, const pet_p4_game_rule_t *rule) {
  if (!rule->has_when) return true;
  if (rule->when_var < 0 || rule->when_var >= game->var_count) return false;
  int32_t right = rule->when_value;
  if (rule->when_value_var >= 0) {
    if (rule->when_value_var >= game->var_count) return false;
    right = game->vars[rule->when_value_var];
  }
  return pet_p4_game_compare(game->vars[rule->when_var], rule->when_op, right);
}

static bool bounded_rule_matches(
  const pet_p4_game_rule_t *rule,
  pet_p4_game_trigger_t trigger,
  const char *action,
  int entity_index,
  int with_index,
  pet_p4_game_edge_t edge
) {
  if (!rule || rule->trigger != trigger) return false;
  if (trigger == PET_P4_GAME_TRIGGER_ACTION) {
    return action && strcmp(rule->action, action) == 0;
  }
  if (trigger == PET_P4_GAME_TRIGGER_COLLISION) {
    return (rule->entity_index == entity_index && rule->with_index == with_index)
      || (rule->entity_index == with_index && rule->with_index == entity_index);
  }
  if(trigger==PET_P4_GAME_TRIGGER_LANDED)return rule->entity_index==entity_index&&rule->with_index==with_index;
  if (trigger == PET_P4_GAME_TRIGGER_EDGE || trigger == PET_P4_GAME_TRIGGER_BLOCKED) {
    return rule->entity_index == entity_index
      && (rule->edge == PET_P4_GAME_EDGE_NONE || rule->edge == edge);
  }
  return true;
}

static bool bounded_execute_rules(
  pet_p4_game_engine_t *game,
  pet_p4_game_trigger_t trigger,
  const char *action,
  int entity_index,
  int with_index,
  pet_p4_game_edge_t edge,
  uint64_t now_ms,
  bounded_event_t *events,
  uint8_t *event_count
) {
  bool changed = false;
  if (!game) return false;
  for (int index = 0; index < game->bounded.rule_count; index += 1) {
    const pet_p4_game_rule_t *rule = &game->bounded.rules[index];
    if (!bounded_rule_matches(
          rule,
          trigger,
          action,
          entity_index,
          with_index,
          edge
        )) {
      continue;
    }
    if (!bounded_rule_guard(game, rule)) continue;
    for (int op_index = 0; op_index < rule->op_count; op_index += 1) {
      changed |= bounded_apply_op(
        game,
        &rule->ops[op_index],
        now_ms,
        events,
        event_count
      );
    }
  }
  return changed;
}

static bool bounded_process_trigger(
  pet_p4_game_engine_t *game,
  pet_p4_game_trigger_t trigger,
  const char *action,
  uint64_t now_ms
) {
  bounded_event_t events[BOUNDED_EVENT_MAX];
  uint8_t event_count = 0;
  bool changed = bounded_execute_rules(
    game,
    trigger,
    action,
    -1,
    -1,
    PET_P4_GAME_EDGE_NONE,
    now_ms,
    events,
    &event_count
  );
  if (trigger == PET_P4_GAME_TRIGGER_TICK && game->running && !game->game_over && !game->bounded.motion && !game->bounded.bodies) {
    for (int index = 0; index < game->bounded.entity_count; index += 1) {
      pet_p4_game_entity_t *entity = &game->bounded_entities[index];
      if (!entity->active || (entity->vx == 0 && entity->vy == 0)) continue;
      changed |= bounded_move_entity(
        game,
        index,
        entity->vx,
        entity->vy,
        events,
        &event_count
      );
    }
  }
  for (int index = 0; index < event_count; index += 1) {
    bounded_event_t *event = &events[index];
    changed |= bounded_execute_rules(
      game,
      event->trigger,
      NULL,
      event->entity_index,
      -1,
      event->edge,
      now_ms,
      NULL,
      NULL
    );
  }
  for (int left = 0; !game->bounded.motion && !game->bounded.bodies && left < game->bounded.entity_count; left += 1) {
    for (int right = left + 1; right < game->bounded.entity_count; right += 1) {
      if (!bounded_entities_overlap(
            &game->bounded_entities[left],
            &game->bounded_entities[right]
          )) {
        continue;
      }
      changed |= bounded_execute_rules(
        game,
        PET_P4_GAME_TRIGGER_COLLISION,
        NULL,
        left,
        right,
        PET_P4_GAME_EDGE_NONE,
        now_ms,
        NULL,
        NULL
      );
    }
  }
  return changed;
}

/* Bounded continuous body integration, shared by firmware and WASM. Positions
 * are Q8 grid units, velocities grid units/second; no floating point or heap.
 * Only top-side descending crossings can land, never ascent/side overlap. */
#include "pet_p4_bodies_core.h"

static bool bounded_motion_step(pet_p4_game_engine_t *game,uint64_t now_ms){
  const pet_p4_bounded_game_config_t *c=&game->bounded;
  pet_p4_game_entity_t *body=&game->bounded_entities[c->motion_body];
  bool changed=bounded_process_trigger(game,PET_P4_GAME_TRIGGER_TICK,NULL,now_ms);
  if(!game->running||!body->active)return changed;
  changed|=track_camera(game);
  if(game->charging){
    unsigned before=game->charge_elapsed_ms;game->charge_elapsed_ms+=game->tick_ms;
    if(game->charge_elapsed_ms>c->charge_ms)game->charge_elapsed_ms=c->charge_ms;
    return changed||before!=game->charge_elapsed_ms;
  }
  if(game->grounded)return changed;
  int32_t old_x=body->x_q8,old_bottom=body->y_q8+body->height*256;
  game->motion_vy_q8+=(int32_t)c->gravity*256*game->tick_ms/1000;
  body->x_q8+=game->motion_vx_q8*(int32_t)game->tick_ms/1000;
  body->y_q8+=game->motion_vy_q8*(int32_t)game->tick_ms/1000;
  int32_t bottom=body->y_q8+body->height*256;
  int landed=-1;int32_t nearest=INT32_MAX,landing_x=body->x_q8;
  for(unsigned i=0;game->motion_vy_q8>=0&&i<c->entity_count;i++){
    if(!(c->platform_mask&(1u<<i)))continue;
    const pet_p4_game_entity_t *p=&game->bounded_entities[i];
    int32_t top=p->y_q8;
    if(!p->active||old_bottom>top||bottom<top||bottom<=old_bottom)continue;
    int32_t cross_left=old_x+(int64_t)(body->x_q8-old_x)*(top-old_bottom)/(bottom-old_bottom);
    /* Use the central half of the body as a foot span, not a zero-width
     * centre point or the full (often transparent) sprite rectangle. Strict
     * overlap excludes a mere tangent and never catches ascent/side impact.
     * Test at the swept top crossing, not at this tick's final position. */
    int32_t foot_left=cross_left+body->width*64;
    int32_t foot_right=cross_left+body->width*192;
    if(foot_right>p->x_q8&&foot_left<p->x_q8+p->width*256&&top<nearest){
      nearest=top;landed=i;landing_x=cross_left;
    }
  }
  if(landed>=0){
    /* Stop both axes at contact: retaining the remaining horizontal step can
     * draw the character beyond its support, especially on slow frames. */
    body->x_q8=landing_x;body->y_q8=nearest-body->height*256;game->grounded=true;game->motion_vx_q8=game->motion_vy_q8=0;
    body->x=(int8_t)(body->x_q8/256);body->y=(int8_t)(body->y_q8/256);
    /* A track slot earns its arrival event once until recycled. Landing back
     * on the same platform must not farm points. The character is never reset. */
    if(!c->track||!(game->track_visited&(1u<<landed))){
      game->track_visited|=1u<<landed;
      bounded_execute_rules(game,PET_P4_GAME_TRIGGER_LANDED,NULL,c->motion_body,landed,PET_P4_GAME_EDGE_NONE,now_ms,NULL,NULL);
    }
  }else if(body->y_q8>game->height*256||body->x_q8>game->width*256||body->x_q8 < -body->width*256){
    pet_p4_game_edge_t edge=body->y_q8>game->height*256?PET_P4_GAME_EDGE_BOTTOM:body->x_q8<0?PET_P4_GAME_EDGE_LEFT:PET_P4_GAME_EDGE_RIGHT;
    bounded_execute_rules(game,PET_P4_GAME_TRIGGER_EDGE,NULL,c->motion_body,-1,edge,now_ms,NULL,NULL);
    /* No unbounded fall even if a malformed rule omitted stop. */
    game->running=false;game->game_over=true;game->charging=false;
  }
  body->x=(int8_t)(body->x_q8/256);body->y=(int8_t)(body->y_q8/256);
  return true;
}

static bool block_mask_cell(uint8_t piece, uint8_t rotation, int x, int y) {
  if (piece >= 7 || rotation >= 4 || x < 0 || x >= 4 || y < 0 || y >= 4) return false;
  return (BLOCK_MASKS[piece][rotation] & (uint16_t) (1U << (y * 4 + x))) != 0;
}

static bool blocks_can_place(
  const pet_p4_game_engine_t *game,
  uint8_t piece,
  uint8_t rotation,
  int origin_x,
  int origin_y
) {
  for (int py = 0; py < 4; py += 1) {
    for (int px = 0; px < 4; px += 1) {
      int x;
      int y;
      int index;
      if (!block_mask_cell(piece, rotation, px, py)) continue;
      x = origin_x + px;
      y = origin_y + py;
      index = game_cell_index(game, x, y);
      if (index < 0 || game->board[index] != 0) return false;
    }
  }
  return true;
}

static void game_refresh_frame(pet_p4_game_engine_t *game) {
  pet_p4_game_frame_t *frame;
  if (!game) return;
  frame = &game->frame;
  memset(frame->cells, 0, sizeof(frame->cells));
  frame->kind = game->kind;
  frame->width = game->width;
  frame->height = game->height;
  frame->score = game->score;
  frame->running = game->running;
  frame->game_over = game->game_over;
  frame->entity_count = 0;
  frame->motion=game->kind==PET_P4_GAME_BOUNDED&&game->bounded.motion;
  frame->bodies=game->kind==PET_P4_GAME_BOUNDED&&game->bounded.bodies;
  frame->charge_percent=frame->motion&&game->charging?(uint8_t)(1+99*game->charge_elapsed_ms/game->bounded.charge_ms):0;
  if (game->kind == PET_P4_GAME_BOUNDED) {
    memcpy(
      frame->cells,
      game->bounded.base_cells,
      (size_t) game->width * game->height
    );
    for (int entity_index = 0;
         entity_index < game->bounded.entity_count;
         entity_index += 1) {
      const pet_p4_game_entity_t *entity = &game->bounded_entities[entity_index];
      if (!entity->active) continue;
      frame->entities[frame->entity_count++] = *entity;
    }
  } else if (game->kind == PET_P4_GAME_XIANGQI) {
    pet_p4_xiangqi_get_cells(&game->xiangqi, frame->cells);
  } else {
    memcpy(frame->cells, game->board, (size_t) game->width * game->height);
  }

  if (game->kind == PET_P4_GAME_BLOCKS && !game->game_over) {
    uint8_t color = (uint8_t) ((game->block_piece % 4U) + 1U);
    for (int py = 0; py < 4; py += 1) {
      for (int px = 0; px < 4; px += 1) {
        int index;
        if (!block_mask_cell(game->block_piece, game->block_rotation, px, py)) continue;
        index = game_cell_index(game, game->block_x + px, game->block_y + py);
        if (index >= 0) frame->cells[index] = color;
      }
    }
  } else if (game->kind == PET_P4_GAME_SNAKE) {
    memset(frame->cells, 0, sizeof(frame->cells));
    for (uint16_t i = 0; i < game->snake_length; i += 1) {
      int index = game_cell_index(game, game->snake_x[i], game->snake_y[i]);
      if (index >= 0) frame->cells[index] = i == 0 ? 3 : 1;
    }
    int food_index = game_cell_index(game, game->food_x, game->food_y);
    if (food_index >= 0) frame->cells[food_index] = 2;
  } else if (game->kind == PET_P4_GAME_FLAPPY) {
    memset(frame->cells, 0, sizeof(frame->cells));
    for (size_t pipe = 0; pipe < 2; pipe += 1) {
      int pipe_x = game->flappy_pipe_x[pipe];
      int gap_top = game->flappy_pipe_gap_top[pipe];
      for (int px = 0; px < FLAPPY_PIPE_WIDTH; px += 1) {
        int x = pipe_x + px;
        if (x < 0 || x >= game->width) continue;
        for (int y = 0; y < game->height; y += 1) {
          if (y >= gap_top && y < gap_top + FLAPPY_PIPE_GAP) continue;
          int index = game_cell_index(game, x, y);
          if (index >= 0) {
            bool cap = y == gap_top - 1 || y == gap_top + FLAPPY_PIPE_GAP;
            frame->cells[index] = cap ? 2 : 1;
          }
        }
      }
    }
    int bird_y = game->flappy_y_q8 >> 8;
    int bird_index = game_cell_index(game, FLAPPY_BIRD_X, bird_y);
    int wing_index = game_cell_index(game, FLAPPY_BIRD_X - 1, bird_y);
    if (wing_index >= 0) frame->cells[wing_index] = 4;
    if (bird_index >= 0) frame->cells[bird_index] = 3;
  } else if (game->kind == PET_P4_GAME_GOMOKU) {
    /* Stones come straight from board[]; overlay bits never touch the board. */
    if (!game->game_over) {
      int cursor = game_cell_index(game, game->gomoku_cursor_x, game->gomoku_cursor_y);
      if (cursor >= 0) frame->cells[cursor] |= PET_P4_GAME_GOMOKU_CURSOR;
    }
    unsigned last = game->gomoku_ai_pending ? game->gomoku_last_player : game->gomoku_last_ai;
    if (last == PET_P4_GAME_GOMOKU_NONE) last = game->gomoku_last_player;
    if (last < PET_P4_GAME_GOMOKU_CELLS) frame->cells[last] |= PET_P4_GAME_GOMOKU_LAST;
    if (game->gomoku_outcome == 1 || game->gomoku_outcome == 2) {
      static const int8_t dx[4] = {1, 0, 1, 1};
      static const int8_t dy[4] = {0, 1, 1, -1};
      int x = game->gomoku_win_index % PET_P4_GAME_GOMOKU_SIZE;
      int y = game->gomoku_win_index / PET_P4_GAME_GOMOKU_SIZE;
      for (int i = 0; i < game->gomoku_win_len; i += 1) {
        int index = game_cell_index(game, x + i * dx[game->gomoku_win_dir], y + i * dy[game->gomoku_win_dir]);
        if (index >= 0) frame->cells[index] |= PET_P4_GAME_GOMOKU_WIN;
      }
    }
  }
  frame->revision += 1;
}

static bool blocks_spawn(pet_p4_game_engine_t *game) {
  game->block_piece = (uint8_t) (game_random(game) % 7U);
  game->block_rotation = 0;
  game->block_x = 3;
  game->block_y = 0;
  if (blocks_can_place(
        game,
        game->block_piece,
        game->block_rotation,
        game->block_x,
        game->block_y
      )) {
    return true;
  }
  game->running = false;
  game->game_over = true;
  return false;
}

static int blocks_clear_lines(pet_p4_game_engine_t *game) {
  int cleared = 0;
  for (int y = game->height - 1; y >= 0; y -= 1) {
    bool full = true;
    for (int x = 0; x < game->width; x += 1) {
      if (game->board[y * game->width + x] == 0) {
        full = false;
        break;
      }
    }
    if (!full) continue;
    for (int pull = y; pull > 0; pull -= 1) {
      memcpy(
        &game->board[pull * game->width],
        &game->board[(pull - 1) * game->width],
        game->width
      );
    }
    memset(game->board, 0, game->width);
    cleared += 1;
    y += 1;
  }
  return cleared;
}

static bool blocks_lock_piece(pet_p4_game_engine_t *game) {
  uint8_t color = (uint8_t) ((game->block_piece % 4U) + 1U);
  for (int py = 0; py < 4; py += 1) {
    for (int px = 0; px < 4; px += 1) {
      int index;
      if (!block_mask_cell(game->block_piece, game->block_rotation, px, py)) continue;
      index = game_cell_index(game, game->block_x + px, game->block_y + py);
      if (index >= 0) game->board[index] = color;
    }
  }
  int cleared = blocks_clear_lines(game);
  game->score += 10 + cleared * cleared * 100;
  return blocks_spawn(game);
}

static bool blocks_step_down(pet_p4_game_engine_t *game) {
  if (blocks_can_place(
        game,
        game->block_piece,
        game->block_rotation,
        game->block_x,
        game->block_y + 1
      )) {
    game->block_y += 1;
  } else {
    blocks_lock_piece(game);
  }
  return true;
}

static void blocks_reset(pet_p4_game_engine_t *game, uint64_t now_ms, bool running) {
  memset(game->board, 0, sizeof(game->board));
  game->score = 0;
  game->running = running;
  game->game_over = false;
  game->last_tick_ms = now_ms;
  blocks_spawn(game);
  game->running = running && !game->game_over;
}

static bool snake_contains(
  const pet_p4_game_engine_t *game,
  uint8_t x,
  uint8_t y,
  uint16_t count
) {
  for (uint16_t i = 0; i < count; i += 1) {
    if (game->snake_x[i] == x && game->snake_y[i] == y) return true;
  }
  return false;
}

static void snake_place_food(pet_p4_game_engine_t *game) {
  uint16_t capacity = (uint16_t) game->width * game->height;
  uint16_t start = (uint16_t) (game_random(game) % capacity);
  for (uint16_t offset = 0; offset < capacity; offset += 1) {
    uint16_t index = (uint16_t) ((start + offset) % capacity);
    uint8_t x = (uint8_t) (index % game->width);
    uint8_t y = (uint8_t) (index / game->width);
    if (!snake_contains(game, x, y, game->snake_length)) {
      game->food_x = x;
      game->food_y = y;
      return;
    }
  }
  game->running = false;
  game->game_over = true;
}

static void snake_reset(pet_p4_game_engine_t *game, uint64_t now_ms, bool running) {
  memset(game->board, 0, sizeof(game->board));
  game->score = 0;
  game->running = running;
  game->game_over = false;
  game->last_tick_ms = now_ms;
  game->snake_length = 4;
  game->snake_direction = 0;
  game->snake_turn_pending = false;
  for (uint16_t i = 0; i < game->snake_length; i += 1) {
    game->snake_x[i] = (uint8_t) (game->width / 2 - i);
    game->snake_y[i] = (uint8_t) (game->height / 2);
  }
  game->food_x = (uint8_t) (game->width - 3);
  game->food_y = (uint8_t) (game->height / 2);
}

static bool snake_step(pet_p4_game_engine_t *game) {
  static const int8_t dx[] = {1, 0, -1, 0};
  static const int8_t dy[] = {0, 1, 0, -1};
  if(game->snake_turn_pending){
    game->snake_direction=game->snake_pending_direction;
    game->snake_turn_pending=false;
  }
  int next_x = (int) game->snake_x[0] + dx[game->snake_direction];
  int next_y = (int) game->snake_y[0] + dy[game->snake_direction];
  bool growing;
  uint16_t collision_count;
  if (next_x < 0 || next_y < 0 || next_x >= game->width || next_y >= game->height) {
    game->running = false;
    game->game_over = true;
    return true;
  }
  growing = next_x == game->food_x && next_y == game->food_y;
  collision_count = growing ? game->snake_length
                            : (game->snake_length > 0 ? game->snake_length - 1 : 0);
  if (snake_contains(game, (uint8_t) next_x, (uint8_t) next_y, collision_count)) {
    game->running = false;
    game->game_over = true;
    return true;
  }
  uint16_t next_length = game->snake_length;
  if (growing && next_length < PET_P4_GAME_GRID_MAX_CELLS) next_length += 1;
  for (uint16_t i = next_length - 1; i > 0; i -= 1) {
    game->snake_x[i] = game->snake_x[i - 1];
    game->snake_y[i] = game->snake_y[i - 1];
  }
  game->snake_x[0] = (uint8_t) next_x;
  game->snake_y[0] = (uint8_t) next_y;
  game->snake_length = next_length;
  if (growing) {
    game->score += 1;
    snake_place_food(game);
  }
  return true;
}

static void flappy_place_pipe(pet_p4_game_engine_t *game, size_t pipe, int x) {
  int gap_positions = FLAPPY_HEIGHT - FLAPPY_PIPE_GAP - 1;
  game->flappy_pipe_x[pipe] = (int8_t) x;
  game->flappy_pipe_gap_top[pipe] =
    (uint8_t) (1 + (game_random(game) % (uint32_t) gap_positions));
  game->flappy_pipe_scored[pipe] = false;
}

static void flappy_reset(
  pet_p4_game_engine_t *game,
  uint64_t now_ms,
  bool running,
  bool initial_flap
) {
  memset(game->board, 0, sizeof(game->board));
  game->score = 0;
  game->running = running;
  game->game_over = false;
  game->last_tick_ms = now_ms;
  game->flappy_y_q8 = (int16_t) ((FLAPPY_HEIGHT / 2) << 8);
  game->flappy_velocity_q8 = initial_flap ? FLAPPY_FLAP_VELOCITY_Q8 : 0;
  game->flappy_scroll_phase = 0;
  flappy_place_pipe(game, 0, FLAPPY_WIDTH - 5);
  flappy_place_pipe(game, 1, FLAPPY_WIDTH - 5 + FLAPPY_PIPE_SPACING);
}

static bool flappy_collides(const pet_p4_game_engine_t *game) {
  int bird_y = game->flappy_y_q8 >> 8;
  if (bird_y < 0 || bird_y >= game->height) return true;
  for (size_t pipe = 0; pipe < 2; pipe += 1) {
    int pipe_x = game->flappy_pipe_x[pipe];
    if (FLAPPY_BIRD_X < pipe_x || FLAPPY_BIRD_X >= pipe_x + FLAPPY_PIPE_WIDTH) continue;
    int gap_top = game->flappy_pipe_gap_top[pipe];
    if (bird_y < gap_top || bird_y >= gap_top + FLAPPY_PIPE_GAP) return true;
  }
  return false;
}

static bool flappy_step(pet_p4_game_engine_t *game) {
  /* Package-owned vertical speed; preserve tick, pipe cadence and legacy
   * physics at 100%. Scaling displacement scales the entire velocity curve. */
  game->flappy_y_q8 = (int16_t) (game->flappy_y_q8
    + game->flappy_velocity_q8 * game->flappy_vertical_speed_percent / 100);
  game->flappy_velocity_q8 = (int16_t) (
    game->flappy_velocity_q8 + FLAPPY_GRAVITY_Q8
  );
  if (game->flappy_velocity_q8 > FLAPPY_MAX_FALL_VELOCITY_Q8) {
    game->flappy_velocity_q8 = FLAPPY_MAX_FALL_VELOCITY_Q8;
  }

  game->flappy_scroll_phase += 1;
  if (game->flappy_scroll_phase >= 2) {
    game->flappy_scroll_phase = 0;
    for (size_t pipe = 0; pipe < 2; pipe += 1) {
      game->flappy_pipe_x[pipe] -= 1;
      if (!game->flappy_pipe_scored[pipe]
          && game->flappy_pipe_x[pipe] + FLAPPY_PIPE_WIDTH <= FLAPPY_BIRD_X) {
        game->flappy_pipe_scored[pipe] = true;
        game->score += 1;
      }
      if (game->flappy_pipe_x[pipe] + FLAPPY_PIPE_WIDTH < 0) {
        size_t other = pipe == 0 ? 1 : 0;
        flappy_place_pipe(
          game,
          pipe,
          game->flappy_pipe_x[other] + FLAPPY_PIPE_SPACING
        );
      }
    }
  }

  if (flappy_collides(game)) {
    game->running = false;
    game->game_over = true;
  }
  return true;
}

/* ---- gomoku: 15x15 board, black (player) vs white (device AI). ---------- */

static const int8_t GOMOKU_DX[4] = {1, 0, 1, 1};
static const int8_t GOMOKU_DY[4] = {0, 1, 1, -1};
/* Pattern table over every 5-cell window that contains the candidate cell.
 * Attack index = own stones in the window including the candidate (1..5);
 * defend index = opponent stones in a window without own stones (0..4).
 * Defend[4] blocks an immediate five, attack[5] wins outright; an open four
 * or open three is counted by two windows, so it outranks the closed shape. */
static const int32_t GOMOKU_ATTACK[6] = {0, 0, 12, 150, 1500, 100000};
static const int32_t GOMOKU_DEFEND[5] = {0, 2, 15, 200, 50000};

static void gomoku_sync_score(pet_p4_game_engine_t *game) {
  /* HUD contract: stone count while playing (odd = white to answer, even =
   * black to move), outcome*1000+stones once finished so a dashboard can key
   * result text and reply cues off the same score variable. */
  game->score = game->game_over
    ? (int32_t) game->gomoku_outcome * 1000 + game->gomoku_stones
    : game->gomoku_stones;
}

static void gomoku_reset(pet_p4_game_engine_t *game, uint64_t now_ms, bool running) {
  memset(game->board, 0, sizeof(game->board));
  game->running = running;
  game->game_over = false;
  game->last_tick_ms = now_ms;
  game->gomoku_cursor_x = PET_P4_GAME_GOMOKU_SIZE / 2;
  game->gomoku_cursor_y = PET_P4_GAME_GOMOKU_SIZE / 2;
  game->gomoku_rounds = 0;
  game->gomoku_stones = 0;
  game->gomoku_last_player = PET_P4_GAME_GOMOKU_NONE;
  game->gomoku_last_ai = PET_P4_GAME_GOMOKU_NONE;
  game->gomoku_outcome = 0;
  game->gomoku_win_index = 0;
  game->gomoku_win_dir = 0;
  game->gomoku_win_len = 0;
  game->gomoku_ai_pending = false;
  game->gomoku_ai_reads = 0;
  gomoku_sync_score(game);
}

static uint8_t gomoku_stone(const pet_p4_game_engine_t *game, int x, int y) {
  if (x < 0 || y < 0 || x >= PET_P4_GAME_GOMOKU_SIZE || y >= PET_P4_GAME_GOMOKU_SIZE) return 3;
  return game->board[y * PET_P4_GAME_GOMOKU_SIZE + x];
}

/* Five or more in a row through (x, y) ends the game for that colour. */
static bool gomoku_check_win(pet_p4_game_engine_t *game, int x, int y, uint8_t color) {
  for (int d = 0; d < 4; d += 1) {
    int forward = 0;
    int backward = 0;
    while (gomoku_stone(game, x + (forward + 1) * GOMOKU_DX[d], y + (forward + 1) * GOMOKU_DY[d]) == color) forward += 1;
    while (gomoku_stone(game, x - (backward + 1) * GOMOKU_DX[d], y - (backward + 1) * GOMOKU_DY[d]) == color) backward += 1;
    if (forward + backward + 1 >= 5) {
      int sx = x - backward * GOMOKU_DX[d];
      int sy = y - backward * GOMOKU_DY[d];
      game->gomoku_win_index = (uint8_t) (sy * PET_P4_GAME_GOMOKU_SIZE + sx);
      game->gomoku_win_dir = (uint8_t) d;
      game->gomoku_win_len = (uint8_t) (forward + backward + 1);
      game->gomoku_outcome = color;
      game->running = false;
      game->game_over = true;
      return true;
    }
  }
  return false;
}

static void gomoku_place_stone(pet_p4_game_engine_t *game, int index, uint8_t color) {
  int x = index % PET_P4_GAME_GOMOKU_SIZE;
  int y = index / PET_P4_GAME_GOMOKU_SIZE;
  game->board[index] = color;
  game->gomoku_stones += 1;
  if (color == 1) {
    game->gomoku_rounds += 1;
    game->gomoku_last_player = (uint8_t) index;
  } else {
    game->gomoku_last_ai = (uint8_t) index;
  }
  if (!gomoku_check_win(game, x, y, color) && game->gomoku_stones >= PET_P4_GAME_GOMOKU_CELLS) {
    game->gomoku_outcome = 3; /* board full, nobody connected five */
    game->running = false;
    game->game_over = true;
  }
  gomoku_sync_score(game);
}

/* Deterministic bounded reply: score every empty cell for both colours over
 * the four lines through it, then take the best (ties: nearest the centre,
 * then lowest index). No recursion, no heap, no randomness. */
static int gomoku_ai_choose(pet_p4_game_engine_t *game) {
  int best = -1;
  int32_t best_score = -1;
  int best_distance = 0;
  unsigned reads = 0;
  const int centre = PET_P4_GAME_GOMOKU_SIZE / 2;
  for (int index = 0; index < PET_P4_GAME_GOMOKU_CELLS; index += 1) {
    if (game->board[index] != 0) continue;
    int x = index % PET_P4_GAME_GOMOKU_SIZE;
    int y = index / PET_P4_GAME_GOMOKU_SIZE;
    int32_t total = 0;
    for (int d = 0; d < 4; d += 1) {
      uint8_t line[9];
      for (int k = -4; k <= 4; k += 1) {
        line[k + 4] = gomoku_stone(game, x + k * GOMOKU_DX[d], y + k * GOMOKU_DY[d]);
        reads += 1;
      }
      for (int w = 0; w < 5; w += 1) {
        int own = 0;
        int opp = 0;
        bool off = false;
        for (int j = w; j < w + 5; j += 1) {
          if (line[j] == 2) own += 1;
          else if (line[j] == 1) opp += 1;
          else if (line[j] == 3) off = true;
        }
        if (off) continue;
        if (opp == 0) total += GOMOKU_ATTACK[own + 1];
        if (own == 0) total += GOMOKU_DEFEND[opp];
      }
    }
    int dx = x > centre ? x - centre : centre - x;
    int dy = y > centre ? y - centre : centre - y;
    int distance = dx > dy ? dx : dy;
    if (total > best_score || (total == best_score && distance < best_distance)) {
      best = index;
      best_score = total;
      best_distance = distance;
    }
  }
  game->gomoku_ai_reads = (uint16_t) reads;
  return best;
}

static bool gomoku_step(pet_p4_game_engine_t *game) {
  if (!game->gomoku_ai_pending) return false;
  game->gomoku_ai_pending = false;
  int choice = gomoku_ai_choose(game);
  if (choice < 0) {
    game->gomoku_outcome = 3;
    game->running = false;
    game->game_over = true;
    gomoku_sync_score(game);
    return true;
  }
  gomoku_place_stone(game, choice, 2);
  return true;
}

static bool gomoku_command(pet_p4_game_engine_t *game, pet_p4_game_command_t command, uint64_t now_ms) {
  if (command == PET_P4_GAME_COMMAND_PLACE || command == PET_P4_GAME_COMMAND_START) {
    if (!game->running || game->game_over) {
      gomoku_reset(game, now_ms, true);
      return true;
    }
    if (command == PET_P4_GAME_COMMAND_START || game->gomoku_ai_pending) return false;
    int index = game->gomoku_cursor_y * PET_P4_GAME_GOMOKU_SIZE + game->gomoku_cursor_x;
    if (game->board[index] != 0) return false;
    gomoku_place_stone(game, index, 1);
    if (!game->game_over) game->gomoku_ai_pending = true;
    return true;
  }
  if (!game->running || game->game_over) return false;
  if (command == PET_P4_GAME_COMMAND_LEFT || command == PET_P4_GAME_COMMAND_WEST) {
    if (game->gomoku_cursor_x == 0) return false;
    game->gomoku_cursor_x -= 1;
    return true;
  }
  if (command == PET_P4_GAME_COMMAND_RIGHT || command == PET_P4_GAME_COMMAND_EAST) {
    if (game->gomoku_cursor_x + 1 >= PET_P4_GAME_GOMOKU_SIZE) return false;
    game->gomoku_cursor_x += 1;
    return true;
  }
  if (command == PET_P4_GAME_COMMAND_NORTH) {
    if (game->gomoku_cursor_y == 0) return false;
    game->gomoku_cursor_y -= 1;
    return true;
  }
  if (command == PET_P4_GAME_COMMAND_SOUTH) {
    if (game->gomoku_cursor_y + 1 >= PET_P4_GAME_GOMOKU_SIZE) return false;
    game->gomoku_cursor_y += 1;
    return true;
  }
  if (command == PET_P4_GAME_COMMAND_UNDO) {
    /* Take back the last player stone and, once white has answered, its reply.
     * One level only: no move history is kept. */
    if (game->gomoku_last_player == PET_P4_GAME_GOMOKU_NONE) return false;
    game->board[game->gomoku_last_player] = 0;
    game->gomoku_cursor_x = (uint8_t) (game->gomoku_last_player % PET_P4_GAME_GOMOKU_SIZE);
    game->gomoku_cursor_y = (uint8_t) (game->gomoku_last_player / PET_P4_GAME_GOMOKU_SIZE);
    if (game->gomoku_rounds > 0) game->gomoku_rounds -= 1;
    if (game->gomoku_stones > 0) game->gomoku_stones -= 1;
    if (!game->gomoku_ai_pending && game->gomoku_last_ai != PET_P4_GAME_GOMOKU_NONE) {
      game->board[game->gomoku_last_ai] = 0;
      if (game->gomoku_stones > 0) game->gomoku_stones -= 1;
    }
    game->gomoku_last_player = PET_P4_GAME_GOMOKU_NONE;
    game->gomoku_last_ai = PET_P4_GAME_GOMOKU_NONE;
    game->gomoku_ai_pending = false;
    gomoku_sync_score(game);
    return true;
  }
  return false;
}

const char *pet_p4_game_kind_name(pet_p4_game_kind_t kind) {
  if (kind == PET_P4_GAME_BOUNDED) return "p4-bounded-game-v1";
  if (kind == PET_P4_GAME_BLOCKS) return "blocks";
  if (kind == PET_P4_GAME_SNAKE) return "snake";
  if (kind == PET_P4_GAME_FLAPPY) return "flappy";
  if (kind == PET_P4_GAME_GOMOKU) return "gomoku";
  if (kind == PET_P4_GAME_XIANGQI) return "xiangqi";
  return "";
}

pet_p4_game_kind_t pet_p4_game_kind_from_name(const char *name) {
  if (name && strcmp(name, "p4-bounded-game-v1") == 0) return PET_P4_GAME_BOUNDED;
  if (name && strcmp(name, "blocks") == 0) return PET_P4_GAME_BLOCKS;
  if (name && strcmp(name, "snake") == 0) return PET_P4_GAME_SNAKE;
  if (name && strcmp(name, "flappy") == 0) return PET_P4_GAME_FLAPPY;
  if (name && strcmp(name, "gomoku") == 0) return PET_P4_GAME_GOMOKU;
  if (name && strcmp(name, "xiangqi") == 0) return PET_P4_GAME_XIANGQI;
  return PET_P4_GAME_NONE;
}

bool pet_p4_game_configure(
  pet_p4_game_engine_t *game,
  pet_p4_game_kind_t kind,
  uint32_t tick_ms,
  uint32_t seed
) {
  if (!game || kind == PET_P4_GAME_NONE || kind == PET_P4_GAME_BOUNDED
      || tick_ms < GAME_TICK_MIN_MS || tick_ms > GAME_TICK_MAX_MS) {
    return false;
  }
  memset(game, 0, sizeof(*game));
  game->kind = kind;
  game->tick_ms = tick_ms;
  game->flappy_vertical_speed_percent = 100;
  game->rng = seed ? seed : 0x70657434U;
  if (kind == PET_P4_GAME_BLOCKS) {
    game->width = BLOCKS_WIDTH;
    game->height = BLOCKS_HEIGHT;
    blocks_reset(game, 0, false);
  } else if (kind == PET_P4_GAME_SNAKE) {
    game->width = SNAKE_WIDTH;
    game->height = SNAKE_HEIGHT;
    snake_reset(game, 0, false);
  } else if (kind == PET_P4_GAME_XIANGQI) {
    game->width = 9;
    game->height = 10;
    pet_p4_xiangqi_init(&game->xiangqi, 1, game->rng);
    game->score = pet_p4_xiangqi_ui_score(&game->xiangqi);
  } else if (kind == PET_P4_GAME_GOMOKU) {
    game->width = PET_P4_GAME_GOMOKU_SIZE;
    game->height = PET_P4_GAME_GOMOKU_SIZE;
    gomoku_reset(game, 0, false);
  } else {
    game->width = FLAPPY_WIDTH;
    game->height = FLAPPY_HEIGHT;
    flappy_reset(game, 0, false, false);
  }
  game_refresh_frame(game);
  return true;
}

bool pet_p4_game_set_vertical_speed(pet_p4_game_engine_t *game, unsigned percent) {
  if (!game || game->kind != PET_P4_GAME_FLAPPY || percent < 25 || percent > 100)
    return false;
  game->flappy_vertical_speed_percent = (uint8_t)percent;
  return true;
}

bool pet_p4_game_configure_bounded(
  pet_p4_game_engine_t *game,
  const pet_p4_bounded_game_config_t *config,
  uint32_t seed
) {
  if (!game || !config
      || config->width < 4 || config->width > PET_P4_GAME_GRID_MAX_WIDTH
      || config->height < 4 || config->height > PET_P4_GAME_GRID_MAX_HEIGHT
      || config->tick_ms < (config->bodies?20U:config->motion?16U:GAME_TICK_MIN_MS) || config->tick_ms > (config->bodies?200U:config->motion?40U:GAME_TICK_MAX_MS)
      || config->entity_count == 0 || config->entity_count > PET_P4_GAME_MAX_ENTITIES
      || config->rule_count == 0 || config->rule_count > PET_P4_GAME_MAX_RULES) {
    return false;
  }
  if(config->bodies){
    unsigned count=0;
    if(config->motion||config->track||config->solid_tone_mask||config->body_gravity < -64||config->body_gravity>64)return false;
    for(unsigned i=0;i<config->width*config->height;i++)if(config->base_cells[i])return false;
    for(unsigned i=0;i<config->entity_count;i++){
      const pet_p4_game_entity_t *e=&config->entities[i];
      if(e->body&&e->rolling&&e->shape!=PET_P4_GAME_SHAPE_RECT&&e->shape!=PET_P4_GAME_SHAPE_CIRCLE&&e->shape!=PET_P4_GAME_SHAPE_BALL
          &&e->shape!=PET_P4_GAME_SHAPE_COIN&&e->shape!=PET_P4_GAME_SHAPE_CAPSULE&&e->shape!=PET_P4_GAME_SHAPE_TRIANGLE&&e->shape!=PET_P4_GAME_SHAPE_DIAMOND)return false;
      if(e->body){count++;if(!e->mass||e->mass>64||e->restitution>100||!e->collidable||e->bounds!=PET_P4_GAME_BOUNDS_CLAMP||(e->body_static&&(e->vx||e->vy)))return false;}
      else if(e->vx||e->vy)return false;
    }
    if(count<1||count>8)return false;
  }else for(unsigned i=0;i<config->entity_count;i++)if(config->entities[i].body)return false;
  if(config->motion&&(config->motion_body<0||config->motion_body>=config->entity_count||!config->platform_mask
    ||(config->platform_mask&(1u<<config->motion_body))||(config->platform_mask>>config->entity_count)
    ||config->gravity<4||config->gravity>64||config->lift<2||config->lift>16
    ||config->launch_min<1||config->launch_max<config->launch_min||config->launch_max>24
    ||config->charge_ms<300||config->charge_ms>3000||config->solid_tone_mask))return false;
  if(config->track){
    unsigned count=0,tones=0;
    for(unsigned i=0;i<config->entity_count;i++)if(config->platform_mask&(1u<<i))count++;
    for(unsigned i=1;i<=4;i++)if(config->tone_mask&(1u<<i))tones++;
    if(!config->motion||count<4||count>8||count+1!=config->entity_count
      ||config->camera_x<2||config->camera_x>config->width/2
      ||config->gap_min<1||config->gap_max<config->gap_min||config->gap_max>6
      ||config->width_min<2||config->width_max<config->width_min||config->width_max>4
      ||(config->gap_max+config->width_max)*config->gravity>2*config->lift*config->launch_max
      ||tones<2||(config->tone_mask&~30u))return false;
  }
  for (int index = 0; index < config->width * config->height; index += 1) {
    if (config->base_cells[index] > 4) return false;
  }
  for (int index = 0; index < config->entity_count; index += 1) {
    const pet_p4_game_entity_t *entity = &config->entities[index];
    if (!entity->id[0] || entity->width == 0 || entity->height == 0
        || entity->width > 8 || entity->height > 8
        || entity->tone == 0 || entity->tone > 4
        || entity->x < 0 || entity->y < 0
        || entity->x + entity->width > config->width
        || entity->y + entity->height > config->height
        || entity->vx < -4 || entity->vx > 4
        || entity->vy < -4 || entity->vy > 4
        || entity->bounds < PET_P4_GAME_BOUNDS_CLAMP
        || entity->bounds > PET_P4_GAME_BOUNDS_STOP
        || entity->shape < PET_P4_GAME_SHAPE_RECT
        || entity->shape > PET_P4_GAME_SHAPE_CHARACTER
        || entity->sprite_index < -1) {
      return false;
    }
  }
  for (int index = 0; index < config->rule_count; index += 1) {
    const pet_p4_game_rule_t *rule = &config->rules[index];
    if (rule->op_count == 0 || rule->op_count > PET_P4_GAME_MAX_OPS_PER_RULE
        || rule->trigger < PET_P4_GAME_TRIGGER_ACTION
        || rule->trigger > PET_P4_GAME_TRIGGER_LANDED
        || (rule->trigger == PET_P4_GAME_TRIGGER_ACTION && !rule->action[0])) {
      return false;
    }
    if(rule->has_when&&(rule->when_var<0||rule->when_var>=PET_P4_GAME_MAX_VARS||rule->when_value_var>=PET_P4_GAME_MAX_VARS||rule->when_op>PET_P4_GAME_CMP_NE))return false;
    if(rule->trigger==PET_P4_GAME_TRIGGER_LANDED&&(!config->motion||rule->entity_index!=config->motion_body
        ||rule->with_index<0||rule->with_index>=config->entity_count||!(config->platform_mask&(1u<<rule->with_index))))return false;
    for(unsigned j=0;j<rule->op_count;j++){
      const pet_p4_game_op_t *o=&rule->ops[j];
      if(o->kind==PET_P4_GAME_OP_IMPULSE){
        if(!config->bodies||o->entity_index<0||o->entity_index>=config->entity_count||!config->entities[o->entity_index].body
           ||o->dx < -64||o->dx>64||o->dy < -64||o->dy>64||(!o->dx&&!o->dy))return false;
        continue;
      }
      if(config->bodies&&(o->kind==PET_P4_GAME_OP_MOVE||o->kind==PET_P4_GAME_OP_PLACE||o->kind==PET_P4_GAME_OP_VELOCITY
          ||o->kind==PET_P4_GAME_OP_ACCELERATE||o->kind==PET_P4_GAME_OP_BOUNCE||o->kind==PET_P4_GAME_OP_CHARGE
          ||o->kind==PET_P4_GAME_OP_LAUNCH||o->kind==PET_P4_GAME_OP_CANCEL))return false;
      if(config->track&&(o->kind==PET_P4_GAME_OP_PLACE||o->kind==PET_P4_GAME_OP_SHOW||o->kind==PET_P4_GAME_OP_HIDE
        ||o->kind==PET_P4_GAME_OP_MOVE||o->kind==PET_P4_GAME_OP_VELOCITY||o->kind==PET_P4_GAME_OP_ACCELERATE||o->kind==PET_P4_GAME_OP_BOUNCE))return false;
      if(o->kind==PET_P4_GAME_OP_SFX){if(o->value<0||o->value>=8)return false;continue;}
      if(o->kind==PET_P4_GAME_OP_VAR_SET||o->kind==PET_P4_GAME_OP_VAR_INC){
        /* p4-logic-v1: entity_index is a mirrored var slot, value stays bounded. */
        if(o->entity_index<0||o->entity_index>=PET_P4_GAME_MAX_VARS||o->value < -10000||o->value>10000)return false;
        continue;
      }
      if(o->kind>=PET_P4_GAME_OP_CHARGE&&(!config->motion||o->kind!=PET_P4_GAME_OP_CHARGE||o->entity_index!=config->motion_body))return false;
    }
  }
  if(config->motion){
    const pet_p4_game_entity_t *b=&config->entities[config->motion_body];bool supported=false;
    for(unsigned i=0;i<config->entity_count;i++){
      const pet_p4_game_entity_t *p=&config->entities[i];if(p->vx||p->vy)return false;
      if(config->track&&(config->platform_mask&(1u<<i))&&(!p->active||p->y!=b->y+b->height))return false;
      if((config->platform_mask&(1u<<i))&&p->active&&b->y+b->height==p->y
          &&b->x*2+b->width>=p->x*2&&b->x*2+b->width<(p->x+p->width)*2)supported=true;
    }
    if(!b->active||!supported)return false;
  }
  memset(game, 0, sizeof(*game));
  game->kind = PET_P4_GAME_BOUNDED;
  game->tick_ms = config->tick_ms;
  game->rng = seed ? seed : 0x70657434U;
  game->width = config->width;
  game->height = config->height;
  game->bounded = *config;
  bounded_reset(game, 0, false);
  game_refresh_frame(game);
  return true;
}

bool pet_p4_game_command(
  pet_p4_game_engine_t *game,
  pet_p4_game_command_t command,
  uint64_t now_ms
) {
  bool changed = false;
  if (!game || game->kind == PET_P4_GAME_NONE
      || game->kind == PET_P4_GAME_BOUNDED) return false;
  if (game->kind == PET_P4_GAME_XIANGQI) {
    unsigned op = command == PET_P4_GAME_COMMAND_LEFT || command == PET_P4_GAME_COMMAND_WEST ? PET_P4_XIANGQI_LEFT
      : command == PET_P4_GAME_COMMAND_RIGHT || command == PET_P4_GAME_COMMAND_EAST ? PET_P4_XIANGQI_RIGHT
      : command == PET_P4_GAME_COMMAND_NORTH ? PET_P4_XIANGQI_UP
      : command == PET_P4_GAME_COMMAND_SOUTH ? PET_P4_XIANGQI_DOWN
      : command == PET_P4_GAME_COMMAND_PLACE || command == PET_P4_GAME_COMMAND_START ? PET_P4_XIANGQI_SELECT
      : command == PET_P4_GAME_COMMAND_UNDO ? PET_P4_XIANGQI_UNDO : 0;
    changed = op && pet_p4_xiangqi_command(&game->xiangqi, op);
    game->score = pet_p4_xiangqi_ui_score(&game->xiangqi);
    game->running = game->xiangqi.running;
    game->game_over = game->xiangqi.game_over;
    if (changed) game->last_tick_ms = now_ms;
  } else if (game->kind == PET_P4_GAME_GOMOKU) {
    changed = gomoku_command(game, command, now_ms);
  } else if (game->kind == PET_P4_GAME_FLAPPY && command == PET_P4_GAME_COMMAND_FLAP) {
    if (!game->running || game->game_over) {
      flappy_reset(game, now_ms, true, true);
    } else {
      game->flappy_velocity_q8 = FLAPPY_FLAP_VELOCITY_Q8;
    }
    changed = true;
  } else if (command == PET_P4_GAME_COMMAND_START) {
    if (game->kind == PET_P4_GAME_BLOCKS) blocks_reset(game, now_ms, true);
    else if (game->kind == PET_P4_GAME_SNAKE) snake_reset(game, now_ms, true);
    else flappy_reset(game, now_ms, true, true);
    changed = true;
  } else if (!game->running || game->game_over) {
    return false;
  } else if (game->kind == PET_P4_GAME_BLOCKS) {
    if (command == PET_P4_GAME_COMMAND_LEFT
        && blocks_can_place(game, game->block_piece, game->block_rotation,
                            game->block_x - 1, game->block_y)) {
      game->block_x -= 1;
      changed = true;
    } else if (command == PET_P4_GAME_COMMAND_RIGHT
        && blocks_can_place(game, game->block_piece, game->block_rotation,
                            game->block_x + 1, game->block_y)) {
      game->block_x += 1;
      changed = true;
    } else if (command == PET_P4_GAME_COMMAND_ROTATE) {
      uint8_t next_rotation = (uint8_t) ((game->block_rotation + 1U) % 4U);
      if (blocks_can_place(game, game->block_piece, next_rotation,
                           game->block_x, game->block_y)) {
        game->block_rotation = next_rotation;
        changed = true;
      }
    } else if(command==PET_P4_GAME_COMMAND_SOFT_DROP) {
      if(blocks_can_place(game,game->block_piece,game->block_rotation,game->block_x,game->block_y+1)){
        game->block_y++;game->score++;changed=true;
      }
      /* Do not lock/spawn a new piece on a held key. Gravity handles contact. */
    } else if (command == PET_P4_GAME_COMMAND_DROP) {
      int distance = 0;
      while (blocks_can_place(game, game->block_piece, game->block_rotation,
                              game->block_x, game->block_y + 1)) {
        game->block_y += 1;
        distance += 1;
      }
      game->score += distance;
      blocks_lock_piece(game);
      changed = true;
    }
  } else if (game->kind == PET_P4_GAME_SNAKE) {
    if(command>=PET_P4_GAME_COMMAND_WEST&&command<=PET_P4_GAME_COMMAND_SOUTH){
      static const uint8_t directions[]={2,0,3,1};
      uint8_t next=directions[command-PET_P4_GAME_COMMAND_WEST];
      if(!game->snake_turn_pending&&next!=game->snake_direction&&next!=(game->snake_direction+2)%4){
        game->snake_pending_direction=next;game->snake_turn_pending=true;changed=true;
      }
    }else if (command == PET_P4_GAME_COMMAND_LEFT) {
      game->snake_direction = (uint8_t) ((game->snake_direction + 3U) % 4U);
      changed = true;
    } else if (command == PET_P4_GAME_COMMAND_RIGHT) {
      game->snake_direction = (uint8_t) ((game->snake_direction + 1U) % 4U);
      changed = true;
    }
  }
  if (changed) game_refresh_frame(game);
  return changed;
}

bool pet_p4_game_dispatch_action(
  pet_p4_game_engine_t *game,
  const char *action,
  uint64_t now_ms
) {
  if (!game || game->kind != PET_P4_GAME_BOUNDED || !action || !action[0]) {
    return false;
  }
  bool changed = bounded_process_trigger(
    game,
    PET_P4_GAME_TRIGGER_ACTION,
    action,
    now_ms
  );
  if (changed) game_refresh_frame(game);
  return changed;
}

bool pet_p4_game_process(pet_p4_game_engine_t *game, uint64_t now_ms) {
  bool changed = false;
  if (!game || !game->running || game->game_over) return false;
  /* Search is cooperative: one slice per call, never replayed in catch-up ticks. */
  if (game->kind == PET_P4_GAME_XIANGQI) {
    if (now_ms < game->last_tick_ms) { game->last_tick_ms = now_ms; return false; }
    if (now_ms - game->last_tick_ms < XIANGQI_WORK_INTERVAL_MS) return false;
    game->last_tick_ms = now_ms;
    changed = pet_p4_xiangqi_process(&game->xiangqi, PET_P4_XIANGQI_SLICE_MAX);
    game->score = pet_p4_xiangqi_ui_score(&game->xiangqi);
    game->running = game->xiangqi.running;
    game->game_over = game->xiangqi.game_over;
    if (changed) game_refresh_frame(game);
    return changed;
  }
  if (game->last_tick_ms == 0) {
    game->last_tick_ms = now_ms;
    return false;
  }
  if (now_ms < game->last_tick_ms) {
    game->last_tick_ms = now_ms;
    return false;
  }
  uint64_t elapsed = now_ms - game->last_tick_ms;
  uint32_t steps = (uint32_t) (elapsed / game->tick_ms);
  if (steps == 0) return false;
  if (steps > 8U) {steps = 8U;if(game->bounded.motion||game->bounded.bodies)game->last_tick_ms=now_ms-(uint64_t)steps*game->tick_ms;}
  for (uint32_t step = 0; step < steps && game->running; step += 1) {
    if (game->kind == PET_P4_GAME_BOUNDED) {
      changed |= game->bounded.bodies?bounded_bodies_step(game,now_ms):game->bounded.motion?bounded_motion_step(game,now_ms):bounded_process_trigger(
        game,
        PET_P4_GAME_TRIGGER_TICK,
        NULL,
        now_ms
      );
    } else if (game->kind == PET_P4_GAME_BLOCKS) changed |= blocks_step_down(game);
    else if (game->kind == PET_P4_GAME_SNAKE) changed |= snake_step(game);
    else if (game->kind == PET_P4_GAME_GOMOKU) changed |= gomoku_step(game);
    else changed |= flappy_step(game);
  }
  game->last_tick_ms += (uint64_t) steps * game->tick_ms;
  if (changed) game_refresh_frame(game);
  return changed;
}

bool pet_p4_game_pointer(pet_p4_game_engine_t *game,unsigned index,int x,int y,unsigned axes){
  if(!game||game->kind!=PET_P4_GAME_BOUNDED||(game->bounded.motion||game->bounded.bodies)||!game->running||game->game_over||index>=game->bounded.entity_count||axes<1||axes>3||x < -1024||x>1024||y < -1024||y>1024)return false;
  pet_p4_game_entity_t *e=&game->bounded_entities[index];
  if(!e->active||e->bounds!=PET_P4_GAME_BOUNDS_CLAMP)return false;
  int nx=x-e->width/2,ny=y-e->height/2;
  if (nx < 0) nx = 0;
  if (ny < 0) ny = 0;
  if (nx > game->width - e->width) nx = game->width - e->width;
  if (ny > game->height - e->height) ny = game->height - e->height;
  bool changed=false;
  if((axes&1)&&e->x!=nx){e->x=nx;changed=true;}
  if((axes&2)&&e->y!=ny){e->y=ny;changed=true;}
  if(changed)game_refresh_frame(game);
  return changed;
}

bool pet_p4_game_release(pet_p4_game_engine_t *game,bool cancel,uint64_t now_ms){
  if(!game||!game->bounded.motion||!game->charging)return false;
  pet_p4_game_op_t op={.kind=cancel?PET_P4_GAME_OP_CANCEL:PET_P4_GAME_OP_LAUNCH,.entity_index=game->bounded.motion_body};
  bool changed=bounded_apply_op(game,&op,now_ms,NULL,NULL);if(changed)game_refresh_frame(game);return changed;
}

void pet_p4_game_get_frame(
  const pet_p4_game_engine_t *game,
  pet_p4_game_frame_t *out
) {
  if (!out) return;
  if (!game) {
    memset(out, 0, sizeof(*out));
    return;
  }
  *out = game->frame;
}
