gmingtian/HachimoDock-esp32s3/firmware/main/pet_p4_miniapp.c

/*
 * [Input] Bounded v3/v4 widget/button JSON, compiled RGB565-alpha sprites,
 *         sprite-complete firmware-embedded built-ins, install/delete actions, ticks, and stats.
 * [Output] Persisted declarative mini-app catalog, active state, context-resolvable
 *          buttons, post-OTA built-in package migration, and fixed-size
 *          dashboard/component-center views plus generation-safe sprite packs.
 *          Newly installed user packages lead the device catalog; firmware-owned
 *          defaults follow in product order without pinning over user content.
 * [Pos] ESP32-P4 negative-screen runtime and transactional multi-widget installer.
 * [Sync] If this file changes, update `firmware/.folder.md` and `protocol.md`.
 */

#include "pet_p4_miniapp.h"
#include "../s3/pet_s3_component_policy.h"
#include <stdatomic.h>
#if PET_P4_CAPABILITY_EXT
#include "pet_p4_component_ext.h" /* types precede transition/runtime declarations */
#endif
#include "pet_p4_local_tools.h"
#if PET_P4_CELLS_V1
#include "pet_p4_cells.h"
#endif
#include "esp_random.h"
#include "pet_p4_media.h"
#include "pet_p4_image.h"
#ifdef ESP_PLATFORM
#include "esp_attr.h"
#else
#define EXT_RAM_BSS_ATTR
#endif
#include "pet_p4_touch.h"
#include "pet_p4_audio.h"
#include "pet_p4_app_store.h"
#include "nvs.h"
#include "pet_p4_store_budget.h"
#include "pet_p4_file_read.h"
#include "pet_p4_file_exact.h"
#include "pet_p4_app_host.h"
#include "pet_p4_variable_owners.h"
#include "pet_p4_component_program_session.h"
#include "pet_p4_program_registry.h"
#if PET_COMPONENT_PROGRAM_ENABLED
#include "pet_p4_program_host_device.h"
#include "pet_p4_program_persistence.h"
#endif
#include "pet_p4_app_navigation.h"
#include "pet_p4_app_form_json.h"
#include "pet_p4_form_v2_json.h"
#if PET_FORM_V3_ENABLED
#include "pet_p4_form_v3_json.h"
#endif
#if PET_P4_DATA_ROWS
#include "pet_p4_data_rows.h"
#endif
#if PET_P4_NOTIFY
#include "pet_p4_notify.h"
#endif
#include "pet_p4_selection.h"
#include "pet_p4_widget_trace.h"
#include "pet_p4_file_cleanup.h"
#include "pet_p4_fs_activity.h"
#include "pet_p4_resources_device.h"
#include "pet_p4_storage_io_trace.h"
#include "pet_p4_storage_cache_lease.h"
#include "pet_p4_native_work_window.h"
#if PET_P4_H264_PREFETCH
#include "pet_p4_renderer.h"
#endif
#if PET_P4_H264_PREFETCH || PET_P4_NATIVE_WORK_WINDOW
static bool g_program_slice_admitted=true; /* main parent, model-lock serialized */
#endif

#include <errno.h>
#include <limits.h>
#include <math.h>
#include <stdio.h>
#include <stdlib.h>
#include <string.h>
#include <sys/stat.h>
#if PET_P4_SPARE_UPDATE
#include <unistd.h>
#endif

#include "esp_log.h"
#include "esp_timer.h"
#include "freertos/FreeRTOS.h"
#include "freertos/semphr.h"
#include "freertos/task.h"
#include "mbedtls/base64.h"

/* Array capacities are the p4-quota-v2 ceiling; packages that do not declare
 * quota keep the original v1 limits below (enforced at parse time). The runtime
 * struct lives in external RAM; growth is measured on device, not assumed. */
/* p4-quota-v2 ceilings: the array capacity unless p4-quota-v3 is compiled in. */
#define MINIAPP_V2_MAX_VARS 16
#define MINIAPP_V2_MAX_STATES 8
#define MINIAPP_V2_MAX_PAGES 6
#define MINIAPP_V2_MAX_TRANSITIONS 32
#define MINIAPP_V2_MAX_TICKS 12
#define MINIAPP_V2_MAX_CHOICES 8
#define MINIAPP_V2_SURFACE_NODES 48
#define MINIAPP_V2_LOCAL_ITEMS 24
#define MINIAPP_V2_SAVE_VARS 16
#define MINIAPP_V2_STRING_MAX 64
#define MINIAPP_V2_WIDGET_JSON_MAX 8192
/* p4-quota-v3 ceilings (PET_P4_CELLS/TEXT tracks' r150 capability parent): the
 * PSRAM runtime arrays grow to these only when PET_P4_QUOTA_V3 is on; v1/v2
 * packages keep their own numbers through MINIAPP_CAP at parse time. */
#define MINIAPP_V3_MAX_VARS 32
#define MINIAPP_V3_MAX_STATES 16
#define MINIAPP_V3_MAX_PAGES 12
#define MINIAPP_V3_MAX_TRANSITIONS 48
#define MINIAPP_V3_MAX_TICKS 16
#define MINIAPP_V3_MAX_CHOICES 12
#define MINIAPP_V3_SURFACE_NODES 64
#define MINIAPP_V3_LOCAL_ITEMS 64
#define MINIAPP_V3_SAVE_VARS 32
#define MINIAPP_V3_STRING_MAX 128
#define MINIAPP_V3_WIDGET_JSON_MAX 12288
#if PET_P4_QUOTA_V3
#define MINIAPP_MAX_VARS MINIAPP_V3_MAX_VARS
#define MINIAPP_MAX_STATES MINIAPP_V3_MAX_STATES
#define MINIAPP_MAX_PAGES MINIAPP_V3_MAX_PAGES
#define MINIAPP_MAX_TRANSITIONS MINIAPP_V3_MAX_TRANSITIONS
#define MINIAPP_MAX_TICKS MINIAPP_V3_MAX_TICKS
#define MINIAPP_MAX_CHOICES MINIAPP_V3_MAX_CHOICES
#define MINIAPP_STRING_MAX MINIAPP_V3_STRING_MAX
#define MINIAPP_WIDGET_JSON_MAX MINIAPP_V3_WIDGET_JSON_MAX
#else
#define MINIAPP_MAX_VARS MINIAPP_V2_MAX_VARS
#define MINIAPP_MAX_STATES MINIAPP_V2_MAX_STATES
#define MINIAPP_MAX_PAGES MINIAPP_V2_MAX_PAGES
#define MINIAPP_MAX_TRANSITIONS MINIAPP_V2_MAX_TRANSITIONS
#define MINIAPP_MAX_TICKS MINIAPP_V2_MAX_TICKS
#define MINIAPP_MAX_CHOICES MINIAPP_V2_MAX_CHOICES
#define MINIAPP_STRING_MAX MINIAPP_V2_STRING_MAX
#define MINIAPP_WIDGET_JSON_MAX MINIAPP_V2_WIDGET_JSON_MAX
#endif
/* Negotiated per-package ceiling: v1 default, v2 and v3 only when declared. */
#define MINIAPP_CAP(r,v1,v2,v3) ((r)->quota_v3?(v3):(r)->quota_v2?(v2):(v1))
#if PET_P4_GRAPHICS_V2
#define MINIAPP_GRAPHICS_V2(r) ((r)->graphics_v2)
#else
#define MINIAPP_GRAPHICS_V2(r) ((void)(r),false)
#endif
#define MINIAPP_MAX_EFFECTS 4
#define MINIAPP_MAX_BUTTONS 8
#define MINIAPP_MAX_CELL_OPS 4
#define MINIAPP_TEXT_MAX 64
#define MINIAPP_TEXT_ENTRY_MAX 120
#define MINIAPP_TEXT_POOL_MAX (4096+MINIAPP_TEXT_MAX)
#define MINIAPP_V1_MAX_VARS 8
#define MINIAPP_V1_MAX_STATES 6
#define MINIAPP_V1_MAX_PAGES 4
#define MINIAPP_V1_MAX_TRANSITIONS 24
#define MINIAPP_V1_MAX_TICKS 8
#define MINIAPP_V1_MAX_CHOICES 6
#define MINIAPP_V1_SURFACE_NODES 32
#define MINIAPP_V1_LOCAL_ITEMS 16
#define MINIAPP_V1_SAVE_VARS 8
#define MINIAPP_VAR_NAME_MAX 32
#define MINIAPP_VALUE_MAX 160
#define MINIAPP_BUTTONS_JSON_MAX 2048
#define MINIAPP_SPRITE_FILE_HEADER_SIZE 8
#define MINIAPP_SPRITE_FILE_MAX (MINIAPP_SPRITE_FILE_HEADER_SIZE + PET_P4_MINIAPP_SPRITE_PIXEL_BYTES_MAX)
#define MINIAPP_SPRITE_FRAME_MIN 8
#define MINIAPP_SPRITE_FRAME_MAX 64
#define MINIAPP_SPRITE_FRAMES_MAX 8
#define MINIAPP_SPRITE_FPS_MAX 20
#define MINIAPP_TICK_MIN_MS 100
#define MINIAPP_INT_MIN (-1000000000)
#define MINIAPP_INT_MAX 1000000000

#define MINIAPP_WIDGET_PATH "/spiffs/p4-miniapp-widget.json"
#define MINIAPP_WIDGET_TMP_PATH "/spiffs/p4-miniapp-widget.tmp"
#define MINIAPP_BUTTONS_PATH "/spiffs/p4-miniapp-buttons.json"
#define MINIAPP_BUTTONS_TMP_PATH "/spiffs/p4-miniapp-buttons.tmp"
#define MINIAPP_ID_PATH "/spiffs/p4-miniapp-id.txt"
#define MINIAPP_ID_TMP_PATH "/spiffs/p4-miniapp-id.tmp"
#define MINIAPP_LAST_ID_PATH "/spiffs/p4-miniapp-last.txt"
#define MINIAPP_CATALOG_PATH "/spiffs/p4-miniapps.json"
#define MINIAPP_BUILTIN_MARKER_PATH "/spiffs/p4-builtins.txt"
#define MINIAPP_BUILTIN_MARKER_TMP_PATH "/spiffs/p4-builtins.tmp"
#define MINIAPP_CATALOG_GENERATION_COUNT 2
#define MINIAPP_PACKAGE_GENERATION_COUNT 2
#define MINIAPP_CATALOG_VERSION 3
#define MINIAPP_CATALOG_JSON_MAX 16384

#ifndef PET_P4_BUILD_ID
#define PET_P4_BUILD_ID "unknown-build"
#endif

#include "miniz.h"
extern const unsigned char pet_p4_builtin_components_zlib[];
extern const size_t pet_p4_builtin_components_zlib_size;
extern const size_t pet_p4_builtin_components_json_size;
extern bool pet_p4_builtin_is_bootstrap(const char *id, uint32_t checksum);

typedef enum {
  MINIAPP_VAR_INT,
  MINIAPP_VAR_STRING,
} miniapp_var_type_t;

typedef struct {
  char name[MINIAPP_VAR_NAME_MAX];
  miniapp_var_type_t type;
  int32_t int_value;
  int32_t int_min,int_max;
  char string_value[MINIAPP_STRING_MAX];
} miniapp_var_t;

typedef enum {
  MINIAPP_EFFECT_SET,
  MINIAPP_EFFECT_INC,
} miniapp_effect_op_t;

typedef struct {
  uint8_t var_index;
  miniapp_effect_op_t op;
  int32_t int_value;
  int8_t source_var;
  char string_value[MINIAPP_STRING_MAX];
} miniapp_effect_t;

/* p4-logic-v1 guard: int var <op> literal-or-var. Legacy tick {var,lte} maps to
 * op LTE with a literal so older packages keep their exact behavior. */
#define MINIAPP_MAX_CONDITIONS 2
typedef struct {
  int8_t var;
  int8_t value_var;
  uint8_t op; /* pet_p4_game_cmp_t */
  int32_t value;
#if PET_P4_CELLS_V1
  /* p4-cells-v1: {"cell":{x,y}} reads one grid cell (literal or {var} coordinates) instead of var. */
  bool cell;
  int8_t cell_x_var,cell_y_var;
  int16_t cell_x,cell_y;
#endif
} miniapp_condition_t;
#if PET_P4_CELLS_V1
/* p4-cells-v1 bounded ops run after a branch's set/inc effects, in order:
 * cell set, fill, count -> var, longest run through (x,y) -> var. */
typedef enum { MINIAPP_CELL_SET, MINIAPP_CELL_FILL, MINIAPP_CELL_COUNT, MINIAPP_CELL_RUN } miniapp_cell_op_kind_t;
typedef struct {
  uint8_t kind;
  int8_t x_var,y_var,value_var,out_var; /* -1 = literal */
  int16_t x,y;
  int32_t value;
} miniapp_cell_op_t;
#endif

typedef struct {
  int8_t from_state;
  int8_t to_state;
  int8_t page_op;
  pet_nav_rule_t navigation_rule;
  char action[PET_P4_MINIAPP_ACTION_MAX];
  /* effects[0..effect_count) are the main branch; the optional p4-logic-v1
   * else branch follows in the same bounded array so memory does not grow. */
  uint8_t effect_count;
  miniapp_effect_t effects[MINIAPP_MAX_EFFECTS];
  uint8_t when_count;
  miniapp_condition_t when[MINIAPP_MAX_CONDITIONS];
  bool has_else;
  int8_t else_to_state;
  int8_t else_page_op;
  uint8_t else_effect_count;
  #if PET_P4_NOTIFY
  bool notify;
  #endif
  int8_t sfx_cue; /* p4-sfx-v1: cue index played when this transition executes, or -1 */
#if PET_P4_CELLS_V1
  /* Main branch ops first, the else branch's ops follow in the same bounded array. */
  uint8_t cell_op_count,else_cell_op_count;
  miniapp_cell_op_t cell_ops[MINIAPP_MAX_CELL_OPS];
#endif
#if PET_P4_CAPABILITY_EXT
  pet_cext_ops_t cext; /* Track C: sequence/sample/emit ops */
#endif
} miniapp_transition_t;

typedef struct {
  uint32_t every_ms;
  uint64_t last_ms;
  int8_t while_state;
  uint8_t effect_count;
  miniapp_effect_t effects[MINIAPP_MAX_EFFECTS];
  uint8_t when_count;
  miniapp_condition_t when[MINIAPP_MAX_CONDITIONS];
  int8_t completion_state;
  uint8_t completion_effect_count;
  miniapp_effect_t completion_effects[MINIAPP_MAX_EFFECTS];
  #if PET_P4_NOTIFY
  bool completion_notify;
  #endif
  int8_t completion_sfx_cue; /* p4-sfx-v1: cue played once when then fires, or -1 */
#if PET_P4_CELLS_V1
  uint8_t cell_op_count,completion_cell_op_count;
  miniapp_cell_op_t cell_ops[MINIAPP_MAX_CELL_OPS],completion_cell_ops[MINIAPP_MAX_CELL_OPS];
#endif
#if PET_P4_CAPABILITY_EXT
  pet_cext_ops_t completion_cext;
#endif
} miniapp_tick_t;

typedef struct {
  char event[48];
  char action[PET_P4_MINIAPP_ACTION_MAX];
  char label[64];
} miniapp_button_t;

typedef struct {
  bool active;
  int8_t score_var;
  int8_t difficulty_var, status_var;
  int8_t ready_state;
  int8_t charge_var;
  int8_t playing_state;
  int8_t result_state;
  char start_action[PET_P4_MINIAPP_ACTION_MAX];
  char left_action[PET_P4_MINIAPP_ACTION_MAX];
  char right_action[PET_P4_MINIAPP_ACTION_MAX];
  char rotate_action[PET_P4_MINIAPP_ACTION_MAX];
  char drop_action[PET_P4_MINIAPP_ACTION_MAX];
  char flap_action[PET_P4_MINIAPP_ACTION_MAX];
  char soft_drop_action[PET_P4_MINIAPP_ACTION_MAX];
  char up_action[PET_P4_MINIAPP_ACTION_MAX],down_action[PET_P4_MINIAPP_ACTION_MAX];
  char place_action[PET_P4_MINIAPP_ACTION_MAX],undo_action[PET_P4_MINIAPP_ACTION_MAX];
  bool absolute_directions;
  pet_p4_game_engine_t engine;
} miniapp_game_t;

typedef enum {
  MINIAPP_VALUE_LITERAL,
  MINIAPP_VALUE_VAR,
  MINIAPP_VALUE_MMSS,
  MINIAPP_VALUE_HMS,
  MINIAPP_VALUE_TEXT_AT, /* p4-texts-v1: text table entry selected by an int var */
} miniapp_value_kind_t;

typedef struct {
  miniapp_value_kind_t kind;
  int8_t var_index;
  char literal[MINIAPP_VALUE_MAX];
} miniapp_value_t;

typedef struct {
  int8_t selector;
  miniapp_value_t value;
} miniapp_choice_t;

typedef enum {
  MINIAPP_RULE_EMPTY,
  MINIAPP_RULE_VALUE,
  MINIAPP_RULE_SWITCH_STATE,
  MINIAPP_RULE_SWITCH_PAGE,
  MINIAPP_RULE_PROGRESS,
} miniapp_rule_kind_t;

typedef struct {
  miniapp_rule_kind_t kind;
  miniapp_value_t value;
  uint8_t choice_count;
  miniapp_choice_t choices[MINIAPP_MAX_CHOICES];
  int8_t progress_value_var;
  int8_t progress_max_var;
  char progress_label[64];
} miniapp_rule_t;

typedef enum {
  MINIAPP_SLOT_TITLE,
  MINIAPP_SLOT_EYEBROW,
  MINIAPP_SLOT_HEADLINE,
  MINIAPP_SLOT_METRIC_LABEL,
  MINIAPP_SLOT_METRIC_VALUE,
  MINIAPP_SLOT_METRIC_UNIT,
  MINIAPP_SLOT_BADGE,
  MINIAPP_SLOT_NOTE,
  MINIAPP_SLOT_FOOTER,
  MINIAPP_SLOT_PROGRESS,
  MINIAPP_SLOT_VISUAL_STYLE,
  MINIAPP_SLOT_VISUAL_PALETTE,
  MINIAPP_SLOT_VISUAL_LAYOUT,
  MINIAPP_SLOT_VISUAL_SPRITE,
  MINIAPP_SLOT_COUNT,
} miniapp_slot_t;

typedef struct {
  bool active;
  char widget_id[PET_P4_MINIAPP_WIDGET_ID_MAX];
  bool resource_incomplete;
  uint8_t var_count;
  miniapp_var_t vars[MINIAPP_MAX_VARS];
  uint8_t state_count;
  char states[MINIAPP_MAX_STATES][24];
  int8_t current_state;
  uint8_t page_count;
  char pages[MINIAPP_MAX_PAGES][24];
  int8_t current_page;
  bool navigation;
  pet_nav_history_t navigation_history;
  pet_form_t form;
#if PET_FORM_V2_ENABLED
  pet_form_text_config_t form_text;
#endif
#if PET_FORM_V3_ENABLED
  pet_form3_t form3; /* p4-app-form-v3 keyboard forms (mutually exclusive with form/form_text) */
#endif
#if PET_P4_NOTIFY
  bool notice_enabled,notice_pending;
  int8_t notice_badge_var;
  pet_notify_t notice;
#endif
#if PET_P4_DATA_ROWS
  bool data_refresh_pending,data_refresh_used;
  uint64_t data_refresh_last;
#endif
  uint8_t transition_count;
  miniapp_transition_t transitions[MINIAPP_MAX_TRANSITIONS];
  uint8_t tick_count;
  miniapp_tick_t ticks[MINIAPP_MAX_TICKS];
  uint8_t button_count;
  miniapp_button_t buttons[MINIAPP_MAX_BUTTONS];
  bool input_v1;
  uint8_t repeat_mask,press_mask;
  char hold_action[48];
  char drag_entity[16];
  uint8_t drag_axis;
  char swipe_actions[4][PET_P4_MINIAPP_ACTION_MAX];
  char confirm_actions[3][PET_P4_MINIAPP_ACTION_MAX],confirm_prompts[3][121];
  char cooldown_actions[3][PET_P4_MINIAPP_ACTION_MAX];
  uint16_t cooldown_ms[3];
  uint64_t cooldown_at[3];
  uint8_t cooldown_used;
  miniapp_game_t game;
  char pause_action[PET_P4_MINIAPP_ACTION_MAX];
  int8_t record_var;
  pet_p4_miniapp_sprite_pack_t sprites;
  miniapp_rule_t rules[MINIAPP_SLOT_COUNT];
  pet_p4_miniapp_view_t view;
  char data_source[48];
  int8_t data_page_var;
#if PET_P4_DATA_ROWS
  pet_data_rows_config_t data_rows; /* p4-data-rows-v1 filters/select/refresh */
#endif
  bool media;
  char media_source[48];
#if PET_SERVICE_BRIDGE_ENABLED
  char host_contract[65];
#endif
  pet_surface_t surface;
  uint16_t save_version;
  uint32_t save_vars; /* one bit per declared var, covers the v3 ceiling */
  bool save_page,app_expressions,app_host;
  bool logic; /* p4-logic-v1 declared and accepted */
  bool quota_v2; /* p4-quota-v2 (or v3) declared and accepted: v2 array ceilings apply */
#if PET_P4_GRAPHICS_V2
  bool graphics_v2; /* p4-graphics-v2 declared and accepted: sprite/image/font ceilings of that profile apply */
#endif
  bool quota_v3; /* p4-quota-v3 declared and accepted: v3 ceilings apply */
#if PET_P4_TEXT_TABLE
  /* p4-texts-v1 package text table: NUL-separated UTF-8 pool, <=64 entries. */
  uint8_t text_count;
  uint16_t text_offset[MINIAPP_TEXT_MAX];
  char text_pool[MINIAPP_TEXT_POOL_MAX];
#endif
#if PET_P4_CELLS_V1
  pet_cells_t cells;
  bool cells_program_owned; /* program v2 mirrors the grid; transitions may only read it */
#endif
  bool sfx; uint8_t sfx_volume, sfx_count, sfx_pending; /* p4-sfx-v1 cues: index -> preset */
  uint8_t sfx_cue_preset[PET_SFX_MAX_CUES];
  char sfx_cue_id[PET_SFX_MAX_CUES][16];
#if PET_P4_CAPABILITY_EXT
  pet_cext_runtime_t cext; /* Track C capability expansion state */
#endif
#if PET_VARIABLE_OWNERS_ENABLED
  pet_variable_owners_t variable_owners;
#endif
#if PET_COMPONENT_PROGRAM_ENABLED
  pet_component_program_config_t program;
  pet_program_snapshot_t program_seed;
  bool program_seed_ready,program_needs_start,program_suspended;
#if PET_COMPONENT_BACKGROUND_ENABLED
  uint64_t program_content[3];
  bool program_background_owned;
#endif
#endif
  int8_t save_states[MINIAPP_MAX_STATES];
  bool instrument;
  pet_local_config_t local;
  pet_local_state_t local_state;
  int8_t local_vars[PET_LOCAL_VARS];
  bool slicing;
  pet_fruit_t fruit;
  uint8_t effect_volume, ambience_volume;
  bool side_enabled,side_axis_live;
  uint32_t side_last_step_us,side_max_step_us;
  uint64_t side_axis_until,side_jump_until;
  pet_side_scene_t side;
  pet_side_art_t side_art;
  char side_actions[4][48];
  int8_t side_states[4],side_vars[4];
} miniapp_runtime_t;
#include "pet_p4_miniapp_ext.h" /* Track C hooks; bodies in pet_p4_miniapp_ext.inc */

static bool runtime_host_variable(const miniapp_runtime_t *r,int index){
  if(!r->app_host||index<0)return false;
#if PET_VARIABLE_OWNERS_ENABLED
  if(r->variable_owners.mixed)return pet_variable_owners_host(r->variable_owners,index);
#endif
  return true;
}
static bool runtime_host_action(const miniapp_runtime_t *r,const char *action){
  if(!r->app_host)return false;
#if PET_VARIABLE_OWNERS_ENABLED
  if(r->variable_owners.mixed)return action&&!strncmp(action,"host.",5);
#endif
  (void)action;return true;
}
static bool runtime_host_dashboard(const miniapp_runtime_t *r){
#if PET_VARIABLE_OWNERS_ENABLED
  if(r->variable_owners.mixed)return false;
#endif
  return r->app_host;
}
static bool runtime_action_host_dependent(const miniapp_runtime_t *r,const char *action){
  if(runtime_host_action(r,action))return true;
#if PET_VARIABLE_OWNERS_ENABLED && PET_COMPONENT_PROGRAM_ENABLED
  if(r->variable_owners.mixed&&r->program.enabled&&action)
    for(unsigned i=0;i<r->program.action_count;i++)if(!strcmp(action,r->program.actions[i].name))
      for(unsigned k=0;k<r->program.actions[i].event.count;k++)
        if(runtime_host_variable(r,r->program.actions[i].input[k]))return true;
#endif
  return false;
}
/* Input acceptance, not eventual VM completion or a consumed stale gesture,
 * starts cooldown. Caller owns the native model lock. Never persisted. */
static void runtime_action_accepted(miniapp_runtime_t *r,const char *action,uint64_t now){
  for(int i=0;i<3;i++)if(r->cooldown_ms[i]&&!strcmp(r->cooldown_actions[i],action)){
    r->cooldown_used|=1u<<i;r->cooldown_at[i]=now;
  }
}

typedef struct {
  bool active;
  char transfer_id[64];
  bool repair_resources;
#if PET_P4_STORAGE_PRESERVE_UNCHANGED
  bool preserve_unchanged;
#endif
  char widget_id[PET_P4_MINIAPP_WIDGET_ID_MAX];
  char widget_json[MINIAPP_WIDGET_JSON_MAX];
  size_t widget_len;
  uint32_t widget_next_index;
  char buttons_json[MINIAPP_BUTTONS_JSON_MAX];
  size_t buttons_len;
  uint32_t buttons_next_index;
  pet_p4_miniapp_sprite_pack_t sprites;
} miniapp_staging_t;

typedef struct {
  char widget_id[PET_P4_MINIAPP_WIDGET_ID_MAX];
  char title[64];
  uint8_t slot;
  uint8_t package_generation;
  uint32_t widget_checksum;
  uint32_t buttons_checksum;
  uint32_t sprites_checksum;
  /* Recomputed from committed files, never trusted from catalog JSON. */
  uint8_t resource_state; /* 0 unchecked, 1 ready, 2 bootstrap, 3 damaged */
  uint8_t image_count;
} miniapp_catalog_item_t;

// Catalog transactions must not grow the USB task stack with the slot limit.
// GCC/Clang cleanup releases scratch storage on every error and success return.
static void catalog_scratch_free(miniapp_catalog_item_t **p) { free(*p); }

typedef struct {
  bool parsed;
  bool valid;
  bool needs_upgrade;
  uint8_t file_generation;
  uint32_t sequence;
  char active_widget_id[PET_P4_MINIAPP_WIDGET_ID_MAX];
  char selected_widget_id[PET_P4_MINIAPP_WIDGET_ID_MAX];
  bool seed_pending; /* missing old field means authoritative membership */
  miniapp_catalog_item_t items[PET_P4_MINIAPP_CATALOG_MAX];
  size_t count;
} miniapp_catalog_snapshot_t;

static const char *TAG = "pet-p4-miniapp";
static _Atomic bool g_catalog_recovery_blocked;
static char g_storage_failure[128];
static EXT_RAM_BSS_ATTR miniapp_runtime_t g_runtime;
#if PET_COMPONENT_PROGRAM_ENABLED
static EXT_RAM_BSS_ATTR pet_component_program_session_t g_component_program;
#if !PET_COMPONENT_PROGRAM_PARENT_UNIFIED
static EXT_RAM_BSS_ATTR pet_program_scheduler_t g_component_program_scheduler;
#endif
static EXT_RAM_BSS_ATTR pet_program_snapshot_t g_component_program_save;
static bool g_component_program_initialized;
static bool g_component_program_scheduler_initialized;
static uint32_t g_component_program_last_us,g_component_program_max_us;
static uint32_t g_component_program_attempt_revision;
static pet_program_runtime_result_t g_component_program_start_result;
#if PET_COMPONENT_PROGRAM_PARENT_UNIFIED
static bool component_parent_enter(void);
static void component_parent_leave(bool *held);
#endif
/* Same lifecycle/model mutex as runtime publication, inputs and rendering.
 * These functions never initialize audio, open files or drain VM execution. */
static void component_program_retire_locked(void){
#if PET_COMPONENT_PROGRAM_PARENT_UNIFIED
  bool held __attribute__((cleanup(component_parent_leave)))=component_parent_enter();if(!held)return;
#endif
  if(g_component_program_initialized&&(g_component_program.live||g_component_program.retiring))(void)pet_component_program_session_stop(&g_component_program);
}
static bool component_program_snapshot_locked(pet_program_snapshot_t *out){
#if PET_COMPONENT_PROGRAM_PARENT_UNIFIED
  bool held __attribute__((cleanup(component_parent_leave)))=component_parent_enter();if(!held)return false;
#endif
  return pet_component_program_session_snapshot(&g_component_program,out);
}
#endif
static uint32_t g_image_revision=1;
#if PET_COMPONENT_BACKGROUND_ENABLED
static EXT_RAM_BSS_ATTR pet_program_registry_t g_background_programs;
static SemaphoreHandle_t g_background_mutex;
static bool g_background_ready;
static uint32_t g_background_last_us,g_background_max_us;
static bool background_init(void);
static bool background_current_locked(const miniapp_runtime_t *r,pet_program_registration_t *h);
static bool background_seed_locked(miniapp_runtime_t *r,bool *found);
static bool background_project_locked(miniapp_runtime_t *r);
static bool background_action_enabled_locked(const miniapp_runtime_t *r);
static bool background_status_current_locked(pet_p4_miniapp_program_status_t *out);
static bool background_enqueue_locked(const char *action,const int32_t base[8],bool *accepted);
static void background_process_locked(uint64_t now);
static bool background_checkpoint_one(void);
static bool background_prepare_replace(miniapp_runtime_t *next);
static bool background_prepare_remove(const char *id);
static uint32_t miniapp_checksum(const char *data,size_t len);
static uint32_t sprite_pack_checksum(const pet_p4_miniapp_sprite_pack_t *pack);
#endif
#if PET_COMPONENT_PROGRAM_PARENT_UNIFIED
/* The model mutex is already held by every foreground caller. Registry-only
 * checkpoint/admission can run on the storage parent, so all accesses to its
 * shared scheduler also take this mutex, in model -> registry order. */
static bool component_parent_enter(void){
  return g_background_mutex&&xSemaphoreTake(g_background_mutex,portMAX_DELAY)==pdTRUE;
}
static void component_parent_leave(bool *held){if(*held)xSemaphoreGive(g_background_mutex);}
#endif
static int g_pressed_node=-1;
static uint64_t g_pressed_context;
static int32_t g_pressed_scroll[PET_SURFACE_VIEWPORTS+1];
#if PET_HOST_COLLECTION_ENABLED
static uint64_t g_pressed_collection_epoch;
#endif
/* Pointer-only generation: scrolling must not reset held joystick repeats. */
static uint32_t g_viewport_epoch;
static char g_confirm_action[48],g_confirm_prompt[121];
static char g_confirm_host_token[65];
#if PET_VARIABLE_OWNERS_ENABLED
static EXT_RAM_BSS_ATTR pet_host_observation_t g_confirm_host_observation;
#endif
static uint64_t g_confirm_until,g_confirm_context;
static uint8_t g_input_epoch;
static unsigned g_hold_owner;
static uint64_t g_hold_context;
static bool g_wall_valid;
static int64_t g_wall_seconds;
static uint64_t g_wall_at,g_utc_ms,g_clock_generation;
static portMUX_TYPE g_clock_lock = portMUX_INITIALIZER_UNLOCKED;
#if PET_P4_EVENTS
static pet_cev_clock_snapshot_t miniapp_utc_snapshot(uint64_t ms){
  pet_cev_clock_snapshot_t out={0};
  portENTER_CRITICAL(&g_clock_lock);
  out.monotonic_at_sync=g_wall_at;out.calibration_generation=g_clock_generation;
  out.valid=g_wall_valid&&g_clock_generation&&ms>=g_wall_at&&ms-g_wall_at<=UINT64_MAX-g_utc_ms;
  if(out.valid)out.utc_ms=g_utc_ms+(ms-g_wall_at);
  portEXIT_CRITICAL(&g_clock_lock);return out;
}
#endif
static int64_t local_wall_seconds(uint64_t ms){
  portENTER_CRITICAL(&g_clock_lock);
  int64_t value=g_wall_valid?g_wall_seconds+(int64_t)((ms>=g_wall_at?ms-g_wall_at:0)/1000):-1;
  portEXIT_CRITICAL(&g_clock_lock);return value;
}
bool pet_p4_miniapp_clock_sync(const cJSON *payload,uint64_t ms){
  const cJSON *time=cJSON_GetObjectItemCaseSensitive(payload,"unixSeconds"),*offset=cJSON_GetObjectItemCaseSensitive(payload,"utcOffsetMinutes");
  if(!cJSON_IsNumber(time)||time->valuedouble<1577836800.0||time->valuedouble>4102444799.0||floor(time->valuedouble)!=time->valuedouble||!cJSON_IsNumber(offset)||offset->valuedouble!=offset->valueint||offset->valueint< -840||offset->valueint>840)return false;
  portENTER_CRITICAL(&g_clock_lock);
  if(g_clock_generation==UINT64_MAX){portEXIT_CRITICAL(&g_clock_lock);return false;}
  g_clock_generation++;g_utc_ms=(uint64_t)time->valuedouble*1000U;
  g_wall_seconds=(int64_t)time->valuedouble+offset->valueint*60;g_wall_at=ms;g_wall_valid=true;portEXIT_CRITICAL(&g_clock_lock);return true;
}
static bool g_input_visible;
static EXT_RAM_BSS_ATTR miniapp_staging_t g_staging;
static EXT_RAM_BSS_ATTR uint8_t g_image_staging[PET_IMAGE_MAX_BYTES+1];
static size_t g_image_used;
static uint32_t g_image_next;
static char g_image_id[16];
static bool g_builtin_sync_in_progress;
/* Catalog absence is a durable membership tombstone after any user transaction.
 * Only an explicitly unfinished first-boot seed may add missing defaults. */
static bool g_catalog_seed_pending;
static pet_p4_miniapp_catalog_cursor_schedule_fn g_catalog_cursor_schedule;
static void *g_catalog_cursor_context;
static uint64_t g_catalog_cursor_serial;
static uint32_t g_catalog_cursor_sequence;
static bool g_catalog_cursor_dirty;
static uint64_t g_catalog_cursor_retry_ms;
static void catalog_cursor_retry(uint64_t now_ms);

static miniapp_catalog_item_t g_catalog[PET_P4_MINIAPP_CATALOG_MAX];
static size_t g_catalog_count;
static size_t g_catalog_selected;
static int g_catalog_file_generation = -1;
static uint32_t g_catalog_sequence;
/* Task-only runtime: publication/sprite snapshots can copy over 128 KiB and
 * must not mask interrupts. Keep the RTOS object in internal BSS (not PSRAM).
 * Lock order: state/render/media/diagnostics mutex -> this mutex -> bounded
 * clock/data/host/resource spinlocks. None of those spinlocks calls back here.
 * Initialization is explicit before any input/render/USB receiver starts;
 * never lazily create or silently bypass this lock on a bad call path. */
static StaticSemaphore_t g_runtime_mutex_storage;
static SemaphoreHandle_t g_runtime_mutex;
static bool miniapp_runtime_lock_init(void) {
  if(xPortInIsrContext() || !xPortCanYield())return false;
  if(!g_runtime_mutex)g_runtime_mutex=xSemaphoreCreateRecursiveMutexStatic(&g_runtime_mutex_storage);
  return g_runtime_mutex!=NULL;
}
static void miniapp_runtime_lock(void) {
  if(xPortInIsrContext() || !xPortCanYield() || !g_runtime_mutex
      || xSemaphoreTakeRecursive(g_runtime_mutex,portMAX_DELAY)!=pdTRUE)abort();
}
static void miniapp_runtime_unlock(void) {
  if(xPortInIsrContext() || !xPortCanYield() || !g_runtime_mutex
      || xSemaphoreGiveRecursive(g_runtime_mutex)!=pdTRUE)abort();
}
static pet_storage_lane_t g_storage_lane;
static pet_resource_owner_t g_storage_resource_owner;
static pet_resource_lease_t g_storage_resource_lease;
/* This slot owns only bounded metadata; package bytes are prepared by the
 * existing protocol worker. Cancellation never frees an in-flight job or
 * permits its physical package names to be reused. */
typedef struct {
  uint64_t serial;
  uint32_t catalog_sequence,image_revision;
  miniapp_catalog_item_t item;
  bool active,cancelled,published,running;
} miniapp_activation_t;
static miniapp_activation_t g_activation;
static pet_p4_miniapp_activation_schedule_fn g_activation_schedule;
static void *g_activation_schedule_context;

bool pet_p4_miniapp_storage_lane_configure(pet_storage_lock_fn unlock,
  pet_storage_lock_fn lock,pet_storage_owner_fn owner,void *context){
  return pet_storage_lane_configure(&g_storage_lane,unlock,lock,owner,context);
}
bool pet_p4_miniapp_storage_lane_enter(void){return pet_storage_lane_enter(&g_storage_lane);}
bool pet_p4_miniapp_storage_lane_leave(void){return pet_storage_lane_leave(&g_storage_lane);}
bool pet_p4_miniapp_storage_busy(void){return g_storage_lane.occupied||g_activation.active;}
static bool storage_work_current(void){
  return !g_storage_lane.occupied||pet_resources_device_current(g_storage_resource_lease);
}
#include "pet_p4_storage_cache_scope.inc"
static bool storage_scope_begin(pet_storage_scope_t *scope,bool activation_job){
  if(g_catalog_recovery_blocked||(g_activation.active&&!activation_job)||!pet_storage_scope_begin(&g_storage_lane,scope))return false;
  pet_resource_result_t opened=pet_resources_device_owner_open(
    PET_RESOURCE_MASK(PET_RESOURCE_STORAGE_WORK),&g_storage_resource_owner);
  pet_resource_result_t acquired=opened==PET_RESOURCE_OK
    ?pet_resources_device_acquire(g_storage_resource_owner,PET_RESOURCE_STORAGE_WORK,1,&g_storage_resource_lease)
    :PET_RESOURCE_UNAVAILABLE;
  if(opened==PET_RESOURCE_OK&&acquired==PET_RESOURCE_OK){
#if PET_P4_STORAGE_CACHE_SCOPE_ENABLED
    storage_cache_scope_begin(scope);
#endif
    return true;
  }
#if PET_P4_RESET_PHASE_TRACE
  ESP_LOGW(TAG,"P4 storage admission rejected open=%u acquire=%u",(unsigned)opened,(unsigned)acquired);
#endif
  pet_resources_device_revoke(g_storage_resource_owner);
  memset(&g_storage_resource_owner,0,sizeof(g_storage_resource_owner));
  (void)pet_storage_scope_finish(scope);return false;
}
static void storage_scope_finish(pet_storage_scope_t *scope){
  if(!scope->active)return;
  if(!pet_storage_scope_finish(scope)){
    g_catalog_recovery_blocked=true;
    ESP_LOGE(TAG,"storage ownership invariant failed; further catalog mutations blocked");
    return;
  }
#if PET_P4_STORAGE_CACHE_SCOPE_ENABLED
  storage_cache_scope_finish(scope);
#endif
  /* Only after physical I/O, allocator cleanup and state-lock reacquisition.
   * Revocation during audio retains occupancy until this exact completion. */
  (void)pet_resources_device_finish(g_storage_resource_lease);
  pet_resources_device_revoke(g_storage_resource_owner);
  memset(&g_storage_resource_lease,0,sizeof(g_storage_resource_lease));
  memset(&g_storage_resource_owner,0,sizeof(g_storage_resource_owner));
}
static bool storage_audio_busy(void){
  return pet_p4_audio_active()||pet_p4_audio_playback_active()
    ||pet_p4_audio_conversation_active()||pet_p4_audio_music_active()
    ||pet_p4_audio_stream_playing();
}

static const char *const g_retired_builtin_ids[] = {
  "falling-catch",
};

static bool remove_file_if_present(const char *path);
/* A single storage scope owns package names through durable publication and
 * cleanup, even while the shared state lock is released for flash I/O. No
 * queued cleanup may retain these names after that scope/slot reuse. The only other
 * SPIFFS writer is app_store; the common activity epoch also covers independent
 * readers whose VFS error handling can clear shared SPIFFS errno mid-scan.
 * A future filesystem actor must join that epoch or disable this shortcut. */
static bool cleanup_owner_current(void *context) {
  return *(const uint32_t *)context==g_catalog_sequence&&storage_work_current();
}
static bool cleanup_storage_idle(void *context,uint64_t *epoch) {
  (void)context;return pet_fs_activity_idle_epoch(epoch);
}
static pet_file_cleanup_guard_t cleanup_guard(uint32_t *sequence) {
  return (pet_file_cleanup_guard_t){.owner_current=cleanup_owner_current,
    .idle_epoch=cleanup_storage_idle,.context=sequence,.remove_path=remove_file_if_present};
}
static void free_bounded_scene_config(pet_p4_bounded_game_config_t **config) {
  free(*config);
}

static bool parse_bounded_scene(
  miniapp_runtime_t *runtime,
  const cJSON *scene,
  bool runtime_v4,
  char *error,
  size_t error_size
);

static void set_error(char *error, size_t error_size, const char *message) {
  if (!error || error_size == 0) return;
  snprintf(error, error_size, "%s", message ? message : "mini-app error");
}

static const char *json_string(const cJSON *object, const char *key) {
  const cJSON *item = cJSON_GetObjectItemCaseSensitive(object, key);
  return cJSON_IsString(item) ? item->valuestring : "";
}

static bool safe_id(const char *value, size_t max_len) {
  size_t len;
  if (!value || !value[0]) return false;
  len = strlen(value);
  if (len >= max_len) return false;
  for (size_t i = 0; i < len; i += 1) {
    char ch = value[i];
    if (!((ch >= 'a' && ch <= 'z') || (ch >= 'A' && ch <= 'Z')
          || (ch >= '0' && ch <= '9') || ch == '_' || ch == '-' || ch == '.')) {
      return false;
    }
  }
  return true;
}

static bool safe_widget_id(const char *value) {
  size_t len;
  if (!value || !value[0]) return false;
  len = strlen(value);
  if (len >= PET_P4_MINIAPP_WIDGET_ID_MAX) return false;
  if (value[0] < 'a' || value[0] > 'z') return false;
  for (size_t i = 0; i < len; i += 1) {
    char ch = value[i];
    if (!((ch >= 'a' && ch <= 'z') || (ch >= '0' && ch <= '9')
          || ch == '_' || ch == '-')) {
      return false;
    }
  }
  return true;
}

static void copy_utf8(char *dest, size_t dest_size, const char *src) {
  size_t len;
  if (!dest || dest_size == 0) return;
  if (!src) src = "";
  len = strlen(src);
  if (len >= dest_size) {
    len = dest_size - 1;
    while (len > 0 && (((unsigned char) src[len] & 0xc0U) == 0x80U)) len -= 1;
  }
  memcpy(dest, src, len);
  dest[len] = '\0';
}

static int32_t clamp_i64(long long value) {
  if (value < MINIAPP_INT_MIN) return MINIAPP_INT_MIN;
  if (value > MINIAPP_INT_MAX) return MINIAPP_INT_MAX;
  return (int32_t) value;
}

static int find_name(char names[][24], int count, const char *name) {
  if (!name) return -1;
  for (int i = 0; i < count; i += 1) {
    if (strcmp(names[i], name) == 0) return i;
  }
  return -1;
}

static int find_var(const miniapp_runtime_t *runtime, const char *name) {
  if (!runtime || !name) return -1;
  for (int i = 0; i < runtime->var_count; i += 1) {
    if (strcmp(runtime->vars[i].name, name) == 0) return i;
  }
  return -1;
}
#if PET_VARIABLE_OWNERS_ENABLED && PET_COMPONENT_PROGRAM_ENABLED
static bool component_program_action_values(const miniapp_runtime_t *r,const char *action,
    int32_t values[8],const pet_host_observation_t *observed,uint64_t now_ms);
#endif
static int32_t surface_integer(int index,uint64_t now);
static int32_t surface_scroll(const pet_surface_viewport_t *v,uint64_t now){return v&&v->enabled?pet_surface_clamp_offset(v,surface_integer(find_var(&g_runtime,v->offset_var),now)):0;}
static void surface_scroll_context(int32_t out[PET_SURFACE_VIEWPORTS+1],uint64_t now){
  out[0]=surface_scroll(&g_runtime.surface.viewport,now);
  for(int i=0;i<PET_SURFACE_VIEWPORTS;i++)out[i+1]=i<g_runtime.surface.viewport_count?surface_scroll(&g_runtime.surface.viewports[i],now):0;
}

static void format_compact_u64(char *out, size_t out_size, uint64_t value, bool available) {
  static const struct {
    uint64_t divisor;
    char suffix;
  } scales[] = {
    {1000000000ULL, 'B'},
    {1000000ULL, 'M'},
    {1000ULL, 'K'},
  };
  if (!available) {
    snprintf(out, out_size, "-");
    return;
  }
  for (size_t i = 0; i < sizeof(scales) / sizeof(scales[0]); i += 1) {
    if (value >= scales[i].divisor) {
      uint64_t whole = value / scales[i].divisor;
      unsigned tenth = (unsigned)((value % scales[i].divisor) * 10ULL / scales[i].divisor) % 10U;
      if (tenth == 0) snprintf(out, out_size, "%llu%c", (unsigned long long) whole, scales[i].suffix);
      else snprintf(out, out_size, "%llu.%u%c", (unsigned long long) whole,
                    (unsigned) tenth, scales[i].suffix);
      return;
    }
  }
  snprintf(out, out_size, "%llu", (unsigned long long) value);
}

static bool set_string_var(miniapp_runtime_t *runtime, const char *name, const char *value) {
  int index = find_var(runtime, name);
  miniapp_var_t *var;
  char next[sizeof(runtime->vars[0].string_value)];
  if (index < 0 || runtime->vars[index].type != MINIAPP_VAR_STRING) return false;
  var = &runtime->vars[index];
  copy_utf8(next, sizeof(next), value ? value : "");
  if (strcmp(var->string_value, next) == 0) return false;
  copy_utf8(var->string_value, sizeof(var->string_value), next);
  return true;
}

static bool object_keys_allowed(const cJSON *object, const char *const *allowed, size_t count) {
  const cJSON *item;
  if (!cJSON_IsObject(object)) return false;
  cJSON_ArrayForEach(item, object) {
    bool known = false;
    for (size_t i = 0; i < count; i += 1) {
      if (item->string && strcmp(item->string, allowed[i]) == 0) {
        known = true;
        break;
      }
    }
    if (!known) return false;
  }
  return true;
}

static bool parse_vars(miniapp_runtime_t *runtime, const cJSON *vars, char *error, size_t error_size) {
  const cJSON *decl;
  if (!cJSON_IsObject(vars)) {
    set_error(error, error_size, "vars must be an object");
    return false;
  }
  cJSON_ArrayForEach(decl, vars) {
    const char *type;
    const cJSON *init;
    miniapp_var_t *var;
    if (runtime->var_count >= MINIAPP_CAP(runtime, MINIAPP_V1_MAX_VARS, MINIAPP_V2_MAX_VARS, MINIAPP_MAX_VARS) || !safe_id(decl->string, MINIAPP_VAR_NAME_MAX)) {
      set_error(error, error_size, "vars exceed bounds or contain an invalid id");
      return false;
    }
    if (!cJSON_IsObject(decl)) {
      snprintf(error, error_size, "var %s declaration must be an object", decl->string);
      return false;
    }
    const cJSON *field;
    cJSON_ArrayForEach(field, decl) {
      if (!field->string
          || (strcmp(field->string, "type") != 0 && strcmp(field->string, "init") != 0)) {
        snprintf(
          error,
          error_size,
          "var %s contains unsupported field %s",
          decl->string,
          field->string ? field->string : "?"
        );
        return false;
      }
    }
    type = json_string(decl, "type");
    init = cJSON_GetObjectItemCaseSensitive(decl, "init");
    var = &runtime->vars[runtime->var_count++];
    copy_utf8(var->name, sizeof(var->name), decl->string);
    if (strcmp(type, "int") == 0) {
      if (init && (!cJSON_IsNumber(init)
          || init->valuedouble < MINIAPP_INT_MIN
          || init->valuedouble > MINIAPP_INT_MAX
          || init->valuedouble != (double) ((long long) init->valuedouble))) {
        snprintf(error, error_size, "var %s int init must be an integer in bounds", decl->string);
        return false;
      }
      var->type = MINIAPP_VAR_INT;
      var->int_min=MINIAPP_INT_MIN;var->int_max=MINIAPP_INT_MAX;
      var->int_value = init ? clamp_i64((long long) init->valuedouble) : 0;
    } else if (strcmp(type, "string") == 0) {
      /* p4-quota-v3 raises string vars to 127 bytes; v1/v2 packages keep 63 even when the array holds 128. */
      if (init && (!cJSON_IsString(init) || strlen(init->valuestring) >= (runtime->quota_v3 ? sizeof(var->string_value) : (size_t) MINIAPP_V2_STRING_MAX))) {
        snprintf(error, error_size, "var %s string init must fit in %d UTF-8 bytes", decl->string, runtime->quota_v3 ? MINIAPP_V3_STRING_MAX - 1 : MINIAPP_V2_STRING_MAX - 1);
        return false;
      }
      var->type = MINIAPP_VAR_STRING;
      copy_utf8(var->string_value, sizeof(var->string_value), init ? init->valuestring : "");
    } else {
      snprintf(error, error_size, "var %s type must be int or string", decl->string);
      return false;
    }
  }
  return true;
}

static bool parse_name_array(
  const cJSON *array,
  char names[][24],
  uint8_t *out_count,
  int max_count,
  const char *label,
  char *error,
  size_t error_size
) {
  const cJSON *item;
  if (!cJSON_IsArray(array) || cJSON_GetArraySize(array) <= 0 || cJSON_GetArraySize(array) > max_count) {
    snprintf(error, error_size, "%s must be a non-empty bounded array", label);
    return false;
  }
  cJSON_ArrayForEach(item, array) {
    if (!cJSON_IsString(item) || !safe_id(item->valuestring, 24)
        || find_name(names, *out_count, item->valuestring) >= 0) {
      snprintf(error, error_size, "%s contains an invalid or duplicate id", label);
      return false;
    }
    copy_utf8(names[*out_count], 24, item->valuestring);
    *out_count += 1;
  }
  return true;
}

static bool parse_pages(miniapp_runtime_t *runtime, const cJSON *pages, char *error, size_t error_size) {
  const cJSON *item;
  if (!pages) {
    runtime->current_page = -1;
    return true;
  }
  if (!cJSON_IsArray(pages) || cJSON_GetArraySize(pages) <= 0
      || cJSON_GetArraySize(pages) > MINIAPP_CAP(runtime, MINIAPP_V1_MAX_PAGES, MINIAPP_V2_MAX_PAGES, MINIAPP_MAX_PAGES)) {
    set_error(error, error_size, "pages must be a non-empty bounded array");
    return false;
  }
  cJSON_ArrayForEach(item, pages) {
    static const char *const allowed[] = {"id"};
    const char *id;
    if (!object_keys_allowed(item, allowed, 1)) {
      set_error(error, error_size, "page contains an unsupported field");
      return false;
    }
    id = json_string(item, "id");
    if (!safe_id(id, 24) || find_name(runtime->pages, runtime->page_count, id) >= 0) {
      set_error(error, error_size, "page contains an invalid or duplicate id");
      return false;
    }
    copy_utf8(runtime->pages[runtime->page_count++], 24, id);
  }
  return true;
}

static bool parse_effect_object(
  miniapp_runtime_t *runtime,
  const cJSON *object,
  miniapp_effect_op_t op,
  miniapp_effect_t *effects,
  uint8_t *effect_count,
  char *error,
  size_t error_size
) {
  const cJSON *item;
  if (!object) return true;
  if (!cJSON_IsObject(object)) {
    set_error(error, error_size, "set/inc must be an object");
    return false;
  }
  cJSON_ArrayForEach(item, object) {
    int var_index;
    miniapp_var_t *var;
    miniapp_effect_t *effect;
    if (*effect_count >= MINIAPP_MAX_EFFECTS) {
      set_error(error, error_size, "transition/tick has too many effects");
      return false;
    }
    var_index = find_var(runtime, item->string);
    if (var_index < 0) {
      set_error(error, error_size, "effect references an unknown var");
      return false;
    }
    var = &runtime->vars[var_index];
    int source_var=-1;
    if(((runtime->app_expressions&&op==MINIAPP_EFFECT_SET)||runtime->logic)&&cJSON_IsObject(item)&&cJSON_GetArraySize(item)==1){
      const char *source=json_string(item,"var");source_var=find_var(runtime,source);
      if(source_var<0||var->type!=MINIAPP_VAR_INT||runtime->vars[source_var].type!=MINIAPP_VAR_INT){set_error(error,error_size,"set/inc var reference must use integers");return false;}
    }
    if (op == MINIAPP_EFFECT_INC && (var->type != MINIAPP_VAR_INT || !(cJSON_IsNumber(item)||source_var>=0))) {
      set_error(error, error_size, "inc requires an int var and numeric value");
      return false;
    }
    if (op == MINIAPP_EFFECT_SET
        && !((var->type == MINIAPP_VAR_INT && (cJSON_IsNumber(item)||source_var>=0))
             || (var->type == MINIAPP_VAR_STRING && cJSON_IsString(item)))) {
      set_error(error, error_size, "set value does not match var type");
      return false;
    }
    if(runtime->app_expressions&&cJSON_IsNumber(item)&&(!isfinite(item->valuedouble)||floor(item->valuedouble)!=item->valuedouble||item->valuedouble < -1000000000.0||item->valuedouble>1000000000.0)){
      set_error(error,error_size,"app effects require bounded integers");return false;
    }
    effect = &effects[(*effect_count)++];
    effect->var_index = (uint8_t) var_index;
    effect->op = op;
    effect->source_var=source_var;
    if (var->type == MINIAPP_VAR_INT) {
      effect->int_value = clamp_i64((long long) item->valuedouble);
    } else {
      if (strlen(item->valuestring) >= (runtime->quota_v3 ? sizeof(effect->string_value) : (size_t) MINIAPP_V2_STRING_MAX)) {
        set_error(error, error_size, "set string exceeds the negotiated string variable size");
        return false;
      }
      copy_utf8(effect->string_value, sizeof(effect->string_value), item->valuestring);
    }
  }
  return true;
}

static bool parse_effects(
  miniapp_runtime_t *runtime,
  const cJSON *object,
  miniapp_effect_t *effects,
  uint8_t *effect_count,
  char *error,
  size_t error_size
) {
  if (!parse_effect_object(runtime, cJSON_GetObjectItemCaseSensitive(object, "set"),
                           MINIAPP_EFFECT_SET, effects, effect_count, error, error_size)) return false;
  return parse_effect_object(runtime, cJSON_GetObjectItemCaseSensitive(object, "inc"),
                             MINIAPP_EFFECT_INC, effects, effect_count, error, error_size);
}

static bool json_bounded_int(const cJSON *item, int32_t *out) {
  if (!cJSON_IsNumber(item) || !isfinite(item->valuedouble)
      || item->valuedouble < MINIAPP_INT_MIN || item->valuedouble > MINIAPP_INT_MAX
      || item->valuedouble != (double) ((long long) item->valuedouble)) return false;
  *out = (int32_t) item->valuedouble;
  return true;
}

#if PET_P4_CELLS_V1
/* A cell op/condition argument: a bounded literal within lo..hi or {"var": "<int var>"}. */
static bool parse_cell_arg(const miniapp_runtime_t *runtime, const cJSON *item, int8_t *var, int32_t *literal, int32_t lo, int32_t hi) {
  *var = -1; *literal = 0;
  if (cJSON_IsObject(item) && cJSON_GetArraySize(item) == 1) {
    int source = find_var(runtime, json_string(item, "var"));
    if (source < 0 || runtime->vars[source].type != MINIAPP_VAR_INT) return false;
    *var = (int8_t) source; return true;
  }
  return json_bounded_int(item, literal) && *literal >= lo && *literal <= hi;
}
/* "cells": [ {op:cell,x,y,set} | {op:cellfill,set} | {op:cellcount,value,var} | {op:cellrun,x,y,value,var} ] (<= 4). */
static bool parse_cell_ops(miniapp_runtime_t *runtime, const cJSON *array, miniapp_cell_op_t *ops, uint8_t *count, char *error, size_t error_size) {
  static const char *const names[] = {"cell", "cellfill", "cellcount", "cellrun"};
  static const char *const set_keys[] = {"op", "x", "y", "set"}, *const fill_keys[] = {"op", "set"};
  static const char *const count_keys[] = {"op", "value", "var"}, *const run_keys[] = {"op", "x", "y", "value", "var"};
  const cJSON *item;
  if (!array) return true;
  if (!runtime->cells.enabled || !cJSON_IsArray(array) || cJSON_GetArraySize(array) < 1) {
    set_error(error, error_size, "cells ops require a declared cells grid and a non-empty array");
    return false;
  }
  const pet_cells_t *grid = &runtime->cells;
  cJSON_ArrayForEach(item, array) {
    if (*count >= MINIAPP_MAX_CELL_OPS || !cJSON_IsObject(item)) { set_error(error, error_size, "too many or invalid cells ops"); return false; }
    miniapp_cell_op_t *op = &ops[(*count)];
    memset(op, 0, sizeof(*op)); op->x_var = op->y_var = op->value_var = op->out_var = -1;
    const char *name = json_string(item, "op"); int kind = -1;
    for (unsigned k = 0; k < 4; k++) if (!strcmp(name, names[k])) kind = (int) k;
    bool ok = kind >= 0;
    int32_t x = 0, y = 0, value = 0;
    if (kind == MINIAPP_CELL_SET || kind == MINIAPP_CELL_FILL) {
      ok = ok && !runtime->cells_program_owned && object_keys_allowed(item, kind == MINIAPP_CELL_SET ? set_keys : fill_keys, kind == MINIAPP_CELL_SET ? 4 : 2)
        && parse_cell_arg(runtime, cJSON_GetObjectItemCaseSensitive(item, "set"), &op->value_var, &value, 0, pet_cells_max_value(grid));
    } else {
      ok = ok && object_keys_allowed(item, kind == MINIAPP_CELL_COUNT ? count_keys : run_keys, kind == MINIAPP_CELL_COUNT ? 3 : 5)
        && parse_cell_arg(runtime, cJSON_GetObjectItemCaseSensitive(item, "value"), &op->value_var, &value, 0, pet_cells_max_value(grid));
      int out = ok ? find_var(runtime, json_string(item, "var")) : -1;
      ok = ok && out >= 0 && runtime->vars[out].type == MINIAPP_VAR_INT; op->out_var = (int8_t) out;
    }
    if (ok && (kind == MINIAPP_CELL_SET || kind == MINIAPP_CELL_RUN))
      ok = parse_cell_arg(runtime, cJSON_GetObjectItemCaseSensitive(item, "x"), &op->x_var, &x, 0, grid->cols - 1)
        && parse_cell_arg(runtime, cJSON_GetObjectItemCaseSensitive(item, "y"), &op->y_var, &y, 0, grid->rows - 1);
    if (!ok) {
      set_error(error, error_size, runtime->cells_program_owned && (kind == MINIAPP_CELL_SET || kind == MINIAPP_CELL_FILL)
        ? "the component program owns cell writes" : "invalid cells op");
      return false;
    }
    op->kind = (uint8_t) kind; op->x = (int16_t) x; op->y = (int16_t) y; op->value = value;
    (*count)++;
  }
  return true;
}
/* Runs after a branch's set/inc: literal or current var arguments, outputs clamped by limits. */
static bool apply_cell_ops(miniapp_runtime_t *runtime, const miniapp_cell_op_t *ops, int count) {
  bool changed = false;
  for (int i = 0; i < count; i++) {
    const miniapp_cell_op_t *op = &ops[i];
    int32_t x = op->x_var >= 0 ? runtime->vars[op->x_var].int_value : op->x;
    int32_t y = op->y_var >= 0 ? runtime->vars[op->y_var].int_value : op->y;
    int32_t value = op->value_var >= 0 ? runtime->vars[op->value_var].int_value : op->value;
    if (op->kind == MINIAPP_CELL_SET) changed |= pet_cells_set(&runtime->cells, x, y, value);
    else if (op->kind == MINIAPP_CELL_FILL) changed |= pet_cells_fill(&runtime->cells, value);
    else {
      miniapp_var_t *out = &runtime->vars[op->out_var];
      int32_t next = op->kind == MINIAPP_CELL_COUNT ? pet_cells_count(&runtime->cells, value) : pet_cells_run(&runtime->cells, x, y, value);
      if (next < out->int_min) next = out->int_min; if (next > out->int_max) next = out->int_max;
      if (next != out->int_value) { out->int_value = next; changed = true; }
    }
  }
  return changed;
}
#endif

static bool parse_condition_item(
  const miniapp_runtime_t *runtime,
  const cJSON *item,
  miniapp_condition_t *condition,
  bool legacy_only,
  char *error,
  size_t error_size
) {
  static const char *const allowed[] = {"var", "lte", "op", "value", "cell"};
  static const char *const ops[] = {"lte", "lt", "gte", "gt", "eq", "ne"};
  const cJSON *lte;
  const cJSON *value;
  const char *op_name;
  int var;
  if (!cJSON_IsObject(item) || !object_keys_allowed(item, allowed, sizeof(allowed) / sizeof(allowed[0]))) {
    set_error(error, error_size, "condition contains an unsupported field");
    return false;
  }
  memset(condition, 0, sizeof(*condition));
  const cJSON *cell = cJSON_GetObjectItemCaseSensitive(item, "cell");
  if (cell) {
#if PET_P4_CELLS_V1
    /* p4-cells-v1: {"cell":{"x":..,"y":..},"op":..,"value":..} reads one grid cell; out of range reads -1. */
    static const char *const cell_keys[] = {"x", "y"};
    int32_t x = 0, y = 0;
    if (!runtime->cells.enabled || legacy_only || cJSON_HasObjectItem(item, "var") || cJSON_HasObjectItem(item, "lte")
        || !object_keys_allowed(cell, cell_keys, 2)
        || !parse_cell_arg(runtime, cJSON_GetObjectItemCaseSensitive(cell, "x"), &condition->cell_x_var, &x, 0, runtime->cells.cols - 1)
        || !parse_cell_arg(runtime, cJSON_GetObjectItemCaseSensitive(cell, "y"), &condition->cell_y_var, &y, 0, runtime->cells.rows - 1)) {
      set_error(error, error_size, "cell condition requires cells, logic and x/y in range or {var}");
      return false;
    }
    condition->cell = true; condition->cell_x = (int16_t) x; condition->cell_y = (int16_t) y; var = -1;
#else
    set_error(error, error_size, "cell conditions require the cells capability");
    return false;
#endif
  } else {
    var = find_var(runtime, json_string(item, "var"));
    if (var < 0 || runtime->vars[var].type != MINIAPP_VAR_INT) {
      set_error(error, error_size, "condition requires an int var");
      return false;
    }
  }
  condition->var = (int8_t) var;
  condition->value_var = -1;
  condition->op = PET_P4_GAME_CMP_LTE;
  lte = cJSON_GetObjectItemCaseSensitive(item, "lte");
  value = cJSON_GetObjectItemCaseSensitive(item, "value");
  op_name = json_string(item, "op");
  if (lte) {
    if (op_name[0] || value || !json_bounded_int(lte, &condition->value)) {
      set_error(error, error_size, "condition lte requires one bounded integer threshold");
      return false;
    }
    return true;
  }
  if (legacy_only) {
    set_error(error, error_size, "condition op/value requires logic p4-logic-v1");
    return false;
  }
  condition->op = 0xFF;
  for (unsigned i = 0; i < sizeof(ops) / sizeof(ops[0]); i += 1) {
    if (strcmp(op_name, ops[i]) == 0) condition->op = (uint8_t) i;
  }
  if (condition->op == 0xFF) {
    set_error(error, error_size, "condition op must be lte/lt/gte/gt/eq/ne");
    return false;
  }
  if (cJSON_IsObject(value) && cJSON_GetArraySize(value) == 1) {
    int source = find_var(runtime, json_string(value, "var"));
    if (source < 0 || runtime->vars[source].type != MINIAPP_VAR_INT) {
      set_error(error, error_size, "condition value var must be an int var");
      return false;
    }
    condition->value_var = (int8_t) source;
    condition->value = 0;
    return true;
  }
  if (!json_bounded_int(value, &condition->value)) {
    set_error(error, error_size, "condition value must be a bounded integer or {var}");
    return false;
  }
  return true;
}

/* when: {var,lte} | {var,op,value} | {all:[c1,c2]}. legacy_only keeps the
 * pre-logic tick contract for packages that did not declare p4-logic-v1. */
static bool parse_condition(
  const miniapp_runtime_t *runtime,
  const cJSON *when,
  miniapp_condition_t *out,
  uint8_t *count,
  bool legacy_only,
  char *error,
  size_t error_size
) {
  const cJSON *all;
  const cJSON *item;
  *count = 0;
  if (!cJSON_IsObject(when)) {
    set_error(error, error_size, "when must be an object");
    return false;
  }
  all = cJSON_GetObjectItemCaseSensitive(when, "all");
  if (!all) {
    if (!parse_condition_item(runtime, when, &out[0], legacy_only, error, error_size)) return false;
    *count = 1;
    return true;
  }
  if (legacy_only || !cJSON_IsArray(all) || cJSON_GetArraySize(when) != 1
      || cJSON_GetArraySize(all) < 1 || cJSON_GetArraySize(all) > MINIAPP_MAX_CONDITIONS) {
    set_error(error, error_size, "when all requires logic p4-logic-v1 and 1-2 conditions");
    return false;
  }
  cJSON_ArrayForEach(item, all) {
    if (!parse_condition_item(runtime, item, &out[*count], false, error, error_size)) return false;
    *count += 1;
  }
  return true;
}

static bool conditions_hold(const miniapp_runtime_t *runtime, const miniapp_condition_t *conditions, int count) {
  for (int i = 0; i < count; i += 1) {
    const miniapp_condition_t *c = &conditions[i];
    int32_t right = c->value_var >= 0 ? runtime->vars[c->value_var].int_value : c->value;
    int32_t left;
#if PET_P4_CELLS_V1
    if (c->cell) left = pet_cells_get(&runtime->cells, c->cell_x_var >= 0 ? runtime->vars[c->cell_x_var].int_value : c->cell_x,
                                        c->cell_y_var >= 0 ? runtime->vars[c->cell_y_var].int_value : c->cell_y);
    else
#endif
    left = runtime->vars[c->var].int_value;
    if (!pet_p4_game_compare(left, c->op, right)) return false;
  }
  return true;
}

static int find_sfx_cue(const miniapp_runtime_t *runtime, const char *id) {
  if (!runtime->sfx || !id || !id[0]) return -1;
  for (int i = 0; i < runtime->sfx_count; i += 1) if (!strcmp(runtime->sfx_cue_id[i], id)) return i;
  return -1;
}

/* Optional "sfx": "<cue id>" on a transition or tick.then; requires the sfx profile. */
static bool parse_sfx_ref(const miniapp_runtime_t *runtime, const cJSON *object, int8_t *out, char *error, size_t error_size) {
  const cJSON *ref = cJSON_GetObjectItemCaseSensitive(object, "sfx");
  *out = -1;
  if (!ref) return true;
  int cue = cJSON_IsString(ref) ? find_sfx_cue(runtime, ref->valuestring) : -1;
  if (cue < 0) {
    set_error(error, error_size, runtime->sfx ? "sfx references an unknown cue" : "sfx requires the p4-sfx-v1 profile");
    return false;
  }
  *out = (int8_t) cue;
  return true;
}

static bool parse_page_op(miniapp_runtime_t *runtime, const char *page, int8_t *op) {
  *op = -1;
  if (!page[0]) return true;
  if (strcmp(page, "next") == 0) *op = -2;
  else if (strcmp(page, "prev") == 0) *op = -3;
  else *op = (int8_t) find_name(runtime->pages, runtime->page_count, page);
  return *op != -1;
}

#include "pet_p4_miniapp_d.inc"

static bool parse_transitions(
  miniapp_runtime_t *runtime,
  const cJSON *array,
  char *error,
  size_t error_size
) {
  const cJSON *item;
  if (!cJSON_IsArray(array) || cJSON_GetArraySize(array) > MINIAPP_CAP(runtime, MINIAPP_V1_MAX_TRANSITIONS, MINIAPP_V2_MAX_TRANSITIONS, MINIAPP_MAX_TRANSITIONS)) {
    set_error(error, error_size, "transitions must be a bounded array");
    return false;
  }
  cJSON_ArrayForEach(item, array) {
    static const char *const allowed[] = {"from", "on", "to", "set", "inc", "page", "from_page", "when", "else", "sfx", "cells"
#if PET_P4_NOTIFY
      , "notify"
#endif
#if PET_P4_CAPABILITY_EXT
      , PET_CEXT_OP_KEYS
#endif
    };
    const char *from;
    const char *action;
    const char *to;
    const char *page;
    const cJSON *when;
    const cJSON *otherwise;
    miniapp_transition_t *transition = &runtime->transitions[runtime->transition_count++];
    if (!object_keys_allowed(item, allowed, sizeof(allowed) / sizeof(allowed[0]))) {
      set_error(error, error_size, "transition contains an unsupported field");
      return false;
    }
    when = cJSON_GetObjectItemCaseSensitive(item, "when");
    otherwise = cJSON_GetObjectItemCaseSensitive(item, "else");
    transition->else_to_state = -1;
    transition->else_page_op = -1;
    if ((when || otherwise) && !runtime->logic) {
      set_error(error, error_size, "transition when/else requires logic p4-logic-v1");
      return false;
    }
    from = json_string(item, "from");
    action = json_string(item, "on");
    to = json_string(item, "to");
    page = json_string(item, "page");
    if (strcmp(from, "*") == 0) {
      transition->from_state = -1;
    } else {
      transition->from_state = (int8_t) find_name(runtime->states, runtime->state_count, from);
      if (transition->from_state < 0) {
        set_error(error, error_size, "transition references an invalid source state");
        return false;
      }
    }
    transition->to_state = to[0]
      ? (int8_t) find_name(runtime->states, runtime->state_count, to) : -1;
    transition->page_op = -1;
    if(!pet_nav_parse_rule(runtime->navigation,runtime->pages,runtime->page_count,item,&transition->navigation_rule)){
      set_error(error,error_size,"invalid application navigation rule");return false;
    }
    if (!(safe_id(action, sizeof(transition->action)) MINIAPP_EXT_OR_EVENT_ACTION(action))
        || (to[0] && transition->to_state < 0)) {
      set_error(error, error_size, "transition references an invalid state or action");
      return false;
    }
    copy_utf8(transition->action, sizeof(transition->action), action);
    if (page[0]) {
      if (strcmp(page, "next") == 0) transition->page_op = -2;
      else if (strcmp(page, "prev") == 0) transition->page_op = -3;
      else transition->page_op = (int8_t) find_name(runtime->pages, runtime->page_count, page);
      if (transition->page_op == -1) {
        set_error(error, error_size, "transition references an invalid page");
        return false;
      }
    }
    if (!parse_effects(runtime, item, transition->effects, &transition->effect_count, error, error_size)) {
      return false;
    }
    if (when && !parse_condition(runtime, when, transition->when, &transition->when_count, false, error, error_size)) {
      return false;
    }
    if (!parse_sfx_ref(runtime, item, &transition->sfx_cue, error, error_size)) return false;
#if PET_P4_NOTIFY
    if(!miniapp_parse_notify_rule(runtime,item,&transition->notify)){set_error(error,error_size,"notify requires runtime.notify and literal true");return false;}
#endif
#if PET_P4_CAPABILITY_EXT
    if (!pet_cext_parse_ops(&runtime->cext, item, &transition->cext, error, error_size)) return false;
    if (!pet_cext_add_subscription(&runtime->cext, action)) { set_error(error, error_size, "event subscription requires events p4-events-v1 and at most 8 safe names"); return false; }
#endif
#if PET_P4_CELLS_V1
    if (!parse_cell_ops(runtime, cJSON_GetObjectItemCaseSensitive(item, "cells"), transition->cell_ops, &transition->cell_op_count, error, error_size)) return false;
#else
    if (cJSON_HasObjectItem(item, "cells")) { set_error(error, error_size, "cells ops require the cells capability"); return false; }
#endif
    if (otherwise) {
      static const char *const else_allowed[] = {"to", "page", "set", "inc", "cells"};
      uint8_t total = transition->effect_count;
      const char *else_to;
      if (!when || !cJSON_IsObject(otherwise)
          || !object_keys_allowed(otherwise, else_allowed, sizeof(else_allowed) / sizeof(else_allowed[0]))) {
        set_error(error, error_size, "transition else requires when and only to/page/set/inc");
        return false;
      }
      else_to = json_string(otherwise, "to");
      transition->else_to_state = else_to[0]
        ? (int8_t) find_name(runtime->states, runtime->state_count, else_to) : -1;
      if ((else_to[0] && transition->else_to_state < 0)
          || !parse_page_op(runtime, json_string(otherwise, "page"), &transition->else_page_op)) {
        set_error(error, error_size, "transition else references an invalid state or page");
        return false;
      }
      /* The else branch shares the bounded 4-effect array with the main branch. */
      if (!parse_effects(runtime, otherwise, transition->effects, &total, error, error_size)) return false;
      transition->else_effect_count = (uint8_t) (total - transition->effect_count);
      transition->has_else = true;
      bool else_cells = false;
#if PET_P4_CELLS_V1
      uint8_t cell_total = transition->cell_op_count;
      if (!parse_cell_ops(runtime, cJSON_GetObjectItemCaseSensitive(otherwise, "cells"), transition->cell_ops, &cell_total, error, error_size)) return false;
      transition->else_cell_op_count = (uint8_t) (cell_total - transition->cell_op_count);
      else_cells = transition->else_cell_op_count > 0;
#else
      if (cJSON_HasObjectItem(otherwise, "cells")) { set_error(error, error_size, "cells ops require the cells capability"); return false; }
#endif
      if (transition->else_to_state < 0 && transition->else_page_op == -1 && transition->else_effect_count == 0 && !else_cells) {
        set_error(error, error_size, "transition else must change state, page or variables");
        return false;
      }
    }
  }
  return true;
}

static bool parse_ticks(miniapp_runtime_t *runtime, const cJSON *array, char *error, size_t error_size) {
  const cJSON *item;
  if (!cJSON_IsArray(array) || cJSON_GetArraySize(array) > MINIAPP_CAP(runtime, MINIAPP_V1_MAX_TICKS, MINIAPP_V2_MAX_TICKS, MINIAPP_MAX_TICKS)) {
    set_error(error, error_size, "tick must be a bounded array");
    return false;
  }
  cJSON_ArrayForEach(item, array) {
    static const char *const allowed[] = {
      "every_ms", "while_state", "set", "inc", "when", "then", "cells",
    };
    static const char *const then_allowed[] = {"to", "set", "inc", "sfx", "cells"
#if PET_P4_NOTIFY
      , "notify"
#endif
#if PET_P4_CAPABILITY_EXT
      , PET_CEXT_OP_KEYS
#endif
    };
    const cJSON *every;
    const cJSON *when;
    const cJSON *then;
    const char *while_state;
    miniapp_tick_t *tick = &runtime->ticks[runtime->tick_count++];
    tick->when_count = 0;
    tick->completion_state = -1;
    tick->completion_sfx_cue = -1;
#if PET_P4_CAPABILITY_EXT
    tick->completion_cext = (pet_cext_ops_t) {-1, -1, 0};
#endif
    if (!object_keys_allowed(item, allowed, sizeof(allowed) / sizeof(allowed[0]))) {
      set_error(error, error_size, "tick contains an unsupported field");
      return false;
    }
    every = cJSON_GetObjectItemCaseSensitive(item, "every_ms");
    while_state = json_string(item, "while_state");
    if (!cJSON_IsNumber(every) || every->valuedouble < MINIAPP_TICK_MIN_MS
        || every->valuedouble > 86400000.0) {
      set_error(error, error_size, "tick interval is outside bounds");
      return false;
    }
    tick->every_ms = (uint32_t) every->valuedouble;
    tick->while_state = while_state[0]
      ? (int8_t) find_name(runtime->states, runtime->state_count, while_state) : -1;
    if (while_state[0] && tick->while_state < 0) {
      set_error(error, error_size, "tick references an invalid state");
      return false;
    }
    if (!parse_effects(runtime, item, tick->effects, &tick->effect_count, error, error_size)) return false;
#if PET_P4_CELLS_V1
    if (!parse_cell_ops(runtime, cJSON_GetObjectItemCaseSensitive(item, "cells"), tick->cell_ops, &tick->cell_op_count, error, error_size)) return false;
#else
    if (cJSON_HasObjectItem(item, "cells")) { set_error(error, error_size, "cells ops require the cells capability"); return false; }
#endif
    when = cJSON_GetObjectItemCaseSensitive(item, "when");
    then = cJSON_GetObjectItemCaseSensitive(item, "then");
    if ((when && !then) || (!when && then) || (when && (!cJSON_IsObject(when) || !cJSON_IsObject(then)))) {
      set_error(error, error_size, "tick when and then must be paired objects");
      return false;
    }
    if (when) {
      const char *completion_state = json_string(then, "to");
      if (!object_keys_allowed(then, then_allowed, sizeof(then_allowed) / sizeof(then_allowed[0]))) {
        set_error(error, error_size, "tick completion contains an unsupported field");
        return false;
      }
      if (!parse_condition(runtime, when, tick->when, &tick->when_count, !runtime->logic, error, error_size)) {
        return false;
      }
      tick->completion_state = completion_state[0]
        ? (int8_t) find_name(runtime->states, runtime->state_count, completion_state) : -1;
      if (completion_state[0] && tick->completion_state < 0) {
        set_error(error, error_size, "tick then references an invalid state");
        return false;
      }
      if (!parse_effects(runtime, then, tick->completion_effects,
                         &tick->completion_effect_count, error, error_size)) {
        return false;
      }
      if (!parse_sfx_ref(runtime, then, &tick->completion_sfx_cue, error, error_size)) return false;
#if PET_P4_NOTIFY
      if(!miniapp_parse_notify_rule(runtime,then,&tick->completion_notify)){set_error(error,error_size,"notify requires runtime.notify and literal true");return false;}
#endif
#if PET_P4_CAPABILITY_EXT
      if (!pet_cext_parse_ops(&runtime->cext, then, &tick->completion_cext, error, error_size)) return false;
#endif
      bool then_cells = false;
#if PET_P4_CELLS_V1
      if (!parse_cell_ops(runtime, cJSON_GetObjectItemCaseSensitive(then, "cells"), tick->completion_cell_ops, &tick->completion_cell_op_count, error, error_size)) return false;
      then_cells = tick->completion_cell_op_count > 0;
#else
      if (cJSON_HasObjectItem(then, "cells")) { set_error(error, error_size, "cells ops require the cells capability"); return false; }
#endif
      if (tick->completion_state < 0 && tick->completion_effect_count == 0 && !then_cells
#if PET_P4_NOTIFY
          && !tick->completion_notify
#endif
      ) {
        set_error(error, error_size, "tick then must change state or variables");
        return false;
      }
    }
  }
  return true;
}

static bool parse_value(
  const miniapp_runtime_t *runtime,
  const cJSON *item,
  miniapp_value_t *value,
  char *error,
  size_t error_size
) {
  if (cJSON_IsString(item)) {
    value->kind = MINIAPP_VALUE_LITERAL;
    copy_utf8(value->literal, sizeof(value->literal), item->valuestring);
    return true;
  }
  if (!cJSON_IsObject(item)) {
    set_error(error, error_size, "dashboard value must be text or a value rule");
    return false;
  }
  const char *name = json_string(item, "var");
  if (name[0]) value->kind = MINIAPP_VALUE_VAR;
  else if ((name = json_string(item, "fmt_mmss"))[0]) value->kind = MINIAPP_VALUE_MMSS;
  else if ((name = json_string(item, "fmt_hms"))[0]) value->kind = MINIAPP_VALUE_HMS;
#if PET_P4_TEXT_TABLE
  else if ((name = json_string(item, "text_at"))[0]) {
    if (!runtime->text_count) { set_error(error, error_size, "text_at requires a package texts table"); return false; }
    value->kind = MINIAPP_VALUE_TEXT_AT;
  }
#endif
  else {
    set_error(error, error_size, "dashboard value rule is unsupported");
    return false;
  }
  value->var_index = (int8_t) find_var(runtime, name);
  if (value->var_index < 0) {
    set_error(error, error_size, "dashboard value references an unknown var");
    return false;
  }
  if ((value->kind == MINIAPP_VALUE_MMSS || value->kind == MINIAPP_VALUE_HMS || value->kind == MINIAPP_VALUE_TEXT_AT)
      && runtime->vars[value->var_index].type != MINIAPP_VAR_INT) {
    set_error(error, error_size, "time formatter requires an int var");
    return false;
  }
  return true;
}

static int slot_from_name(const char *name) {
  static const char *const names[] = {
    "title", "eyebrow", "headline", "metricLabel", "metricValue",
    "metricUnit", "badge", "note", "footer", "progress",
    "visualStyle", "visualPalette", "visualLayout", "visualSprite",
  };
  for (int i = 0; i < MINIAPP_SLOT_COUNT; i += 1) {
    if (strcmp(name, names[i]) == 0) return i;
  }
  return -1;
}

static bool visual_literal_allowed(int slot, const miniapp_value_t *value) {
  if (!value || value->kind != MINIAPP_VALUE_LITERAL) return false;
  const char *literal = value->literal;
  if (slot == MINIAPP_SLOT_VISUAL_STYLE) {
    return strcmp(literal, "classic") == 0 || strcmp(literal, "pixel") == 0
      || strcmp(literal, "clean") == 0;
  }
  if (slot == MINIAPP_SLOT_VISUAL_PALETTE) {
    return strcmp(literal, "candy") == 0 || strcmp(literal, "sunset") == 0
      || strcmp(literal, "mint") == 0 || strcmp(literal, "arcade") == 0
      || strcmp(literal, "ocean") == 0 || strcmp(literal, "forest") == 0
      || strcmp(literal, "ember") == 0 || strcmp(literal, "mono") == 0;
  }
  if (slot == MINIAPP_SLOT_VISUAL_LAYOUT) {
    return strcmp(literal, "arcade") == 0 || strcmp(literal, "scoreboard") == 0
      || strcmp(literal, "tool") == 0;
  }
  if (slot == MINIAPP_SLOT_VISUAL_SPRITE) {
    return strcmp(literal, "target") == 0 || strcmp(literal, "trophy") == 0
      || strcmp(literal, "star") == 0 || strcmp(literal, "bolt") == 0
      || strcmp(literal, "coffee") == 0 || strcmp(literal, "timer") == 0
      || strcmp(literal, "droplet") == 0 || strcmp(literal, "gauge") == 0
      || strcmp(literal, "blocks") == 0 || strcmp(literal, "snake") == 0
      || strcmp(literal, "flappy") == 0
      || strcmp(literal, "mole-ready") == 0 || strcmp(literal, "mole-left") == 0
      || strcmp(literal, "mole-center") == 0 || strcmp(literal, "mole-right") == 0 || strcmp(literal,"music")==0;
  }
  return true;
}

static bool validate_visual_rule(int slot, const miniapp_rule_t *rule) {
  if (slot < MINIAPP_SLOT_VISUAL_STYLE || slot > MINIAPP_SLOT_VISUAL_SPRITE) return true;
  if (rule->kind == MINIAPP_RULE_VALUE) return visual_literal_allowed(slot, &rule->value);
  if (rule->kind == MINIAPP_RULE_SWITCH_STATE || rule->kind == MINIAPP_RULE_SWITCH_PAGE) {
    for (int i = 0; i < rule->choice_count; i += 1) {
      if (!visual_literal_allowed(slot, &rule->choices[i].value)) return false;
    }
    return rule->choice_count > 0;
  }
  return false;
}

static bool parse_switch_rule(
  const miniapp_runtime_t *runtime,
  const cJSON *map,
  bool by_state,
  miniapp_rule_t *rule,
  char *error,
  size_t error_size
) {
  const cJSON *choice;
  if (!cJSON_IsObject(map)) {
    set_error(error, error_size, "dashboard switch must be an object");
    return false;
  }
  cJSON_ArrayForEach(choice, map) {
    int selector;
    miniapp_choice_t *target;
    if (rule->choice_count >= MINIAPP_CAP(runtime, MINIAPP_V1_MAX_CHOICES, MINIAPP_V2_MAX_CHOICES, MINIAPP_MAX_CHOICES)) {
      set_error(error, error_size, "dashboard switch has too many choices");
      return false;
    }
    selector = by_state
      ? find_name((char (*)[24]) runtime->states, runtime->state_count, choice->string)
      : find_name((char (*)[24]) runtime->pages, runtime->page_count, choice->string);
    if (selector < 0) {
      set_error(error, error_size, "dashboard switch references an unknown selector");
      return false;
    }
    target = &rule->choices[rule->choice_count++];
    target->selector = (int8_t) selector;
    if (!parse_value(runtime, choice, &target->value, error, error_size)) return false;
  }
  return true;
}

static bool parse_dashboard(
  miniapp_runtime_t *runtime,
  const cJSON *dashboard,
  char *error,
  size_t error_size
) {
  const cJSON *item;
  if (!cJSON_IsObject(dashboard)) {
    set_error(error, error_size, "dashboard must be an object");
    return false;
  }
  cJSON_ArrayForEach(item, dashboard) {
    int slot = slot_from_name(item->string);
    miniapp_rule_t *rule;
    const cJSON *map;
    if (slot < 0) {
      set_error(error, error_size, "dashboard contains an unknown slot");
      return false;
    }
    rule = &runtime->rules[slot];
    if (slot == MINIAPP_SLOT_PROGRESS && cJSON_IsObject(item)
        && cJSON_GetObjectItemCaseSensitive(item, "pct_of")) {
      rule->kind = MINIAPP_RULE_PROGRESS;
      rule->progress_value_var = (int8_t) find_var(runtime, json_string(item, "pct_of"));
      rule->progress_max_var = (int8_t) find_var(runtime, json_string(item, "of_max"));
      copy_utf8(rule->progress_label, sizeof(rule->progress_label), json_string(item, "label"));
      if (rule->progress_value_var < 0 || rule->progress_max_var < 0
          || runtime->vars[rule->progress_value_var].type != MINIAPP_VAR_INT
          || runtime->vars[rule->progress_max_var].type != MINIAPP_VAR_INT) {
        set_error(error, error_size, "progress requires two int vars");
        return false;
      }
      continue;
    }
    map = cJSON_IsObject(item) ? cJSON_GetObjectItemCaseSensitive(item, "switch_state") : NULL;
    if (map) {
      rule->kind = MINIAPP_RULE_SWITCH_STATE;
      if (!parse_switch_rule(runtime, map, true, rule, error, error_size)) return false;
      if (!validate_visual_rule(slot, rule)) {
        set_error(error, error_size, "visual slot contains an unsupported preset");
        return false;
      }
      continue;
    }
    map = cJSON_IsObject(item) ? cJSON_GetObjectItemCaseSensitive(item, "switch_page") : NULL;
    if (map) {
      rule->kind = MINIAPP_RULE_SWITCH_PAGE;
      if (!parse_switch_rule(runtime, map, false, rule, error, error_size)) return false;
      if (!validate_visual_rule(slot, rule)) {
        set_error(error, error_size, "visual slot contains an unsupported preset");
        return false;
      }
      continue;
    }
    rule->kind = MINIAPP_RULE_VALUE;
    if (!parse_value(runtime, item, &rule->value, error, error_size)) return false;
    if (!validate_visual_rule(slot, rule)) {
      set_error(error, error_size, "visual slot contains an unsupported preset");
      return false;
    }
  }
  return true;
}

static bool button_event_contains(const char *binding, const char *event_name) {
  if (strcmp(binding, event_name) == 0) return true;
  return strcmp(binding, "knob.rotate_cw / knob.rotate_ccw") == 0
    && (strcmp(event_name, "knob.rotate_cw") == 0
        || strcmp(event_name, "knob.rotate_ccw") == 0);
}

static bool button_events_conflict(const char *left, const char *right) {
  return button_event_contains(left, right)
    || button_event_contains(right, left)
    || (button_event_contains(left, "knob.rotate_cw")
        && button_event_contains(right, "knob.rotate_cw"))
    || (button_event_contains(left, "knob.rotate_ccw")
        && button_event_contains(right, "knob.rotate_ccw"));
}

static bool parse_buttons(
  miniapp_runtime_t *runtime,
  const char *buttons_json,
  char *error,
  size_t error_size
) {
  cJSON *root;
  const cJSON *item;
  if (!buttons_json || !buttons_json[0]) return true;
  root = cJSON_ParseWithOpts(buttons_json,NULL,true);
  if (!cJSON_IsArray(root) || cJSON_GetArraySize(root) > MINIAPP_MAX_BUTTONS) {
    cJSON_Delete(root);
    set_error(error, error_size, "buttons.json must be a bounded array");
    return false;
  }
  cJSON_ArrayForEach(item, root) {
    const char *event = json_string(item, "event");
    const char *action = json_string(item, "action");
    miniapp_button_t *button;
    if (!event[0] || strlen(event) >= sizeof(runtime->buttons[0].event)
        || !safe_id(action, PET_P4_MINIAPP_ACTION_MAX)) {
      cJSON_Delete(root);
      set_error(error, error_size, "button binding contains an invalid event or action");
      return false;
    }
    for (int i = 0; i < runtime->button_count; i += 1) {
      if (button_events_conflict(runtime->buttons[i].event, event)) {
        cJSON_Delete(root);
        set_error(error, error_size, "button binding event is already assigned");
        return false;
      }
      if (strcmp(runtime->buttons[i].action, action) == 0) {
        cJSON_Delete(root);
        set_error(error, error_size, "button binding action must be unique");
        return false;
      }
    }
    button = &runtime->buttons[runtime->button_count++];
    copy_utf8(button->event, sizeof(button->event), event);
    copy_utf8(button->action, sizeof(button->action), action);
    copy_utf8(button->label, sizeof(button->label), json_string(item,"label"));
  }
  cJSON_Delete(root);
  return true;
}

static uint32_t stable_widget_seed(const char *widget_id) {
  uint32_t hash = 2166136261U;
  if (!widget_id) return hash;
  for (const unsigned char *cursor = (const unsigned char *) widget_id; *cursor; cursor += 1) {
    hash ^= *cursor;
    hash *= 16777619U;
  }
  return hash;
}

static bool runtime_has_transition_action(
  const miniapp_runtime_t *runtime,
  const char *action
) {
  for (int i = 0; i < runtime->transition_count; i += 1) {
    if (strcmp(runtime->transitions[i].action, action) == 0) return true;
  }
  return false;
}

static bool runtime_has_button_action(
  const miniapp_runtime_t *runtime,
  const char *action
) {
  for (int i = 0; i < runtime->button_count; i += 1) {
    if (strcmp(runtime->buttons[i].action, action) == 0) return true;
  }
  return false;
}

static void form_values(const miniapp_runtime_t *r,int32_t values[PET_FORM_VARS]){
  for(int i=0;i<PET_FORM_VARS;i++)values[i]=i<r->var_count?r->vars[i].int_value:0;
}
#if PET_FORM_V2_ENABLED
static void form2_values(const miniapp_runtime_t *r,pet_form_value_t values[PET_FORM_VARS]){
  memset(values,0,sizeof(pet_form_value_t)*PET_FORM_VARS);
  if(r->var_count>PET_FORM_VARS)return; /* fail closed if a bad runtime bypassed import */
  for(int i=0;i<r->var_count;i++){
    if(r->vars[i].type==MINIAPP_VAR_INT)values[i].number=r->vars[i].int_value;
    else copy_utf8(values[i].text,sizeof(values[i].text),r->vars[i].string_value);
  }
}
static bool form2_write(miniapp_runtime_t *r,const pet_form_value_t values[PET_FORM_VARS]){
  if(r->var_count>PET_FORM_VARS)return false;
  bool changed=false;
  for(int i=0;i<r->var_count;i++){
    if(r->vars[i].type==MINIAPP_VAR_INT){if(r->vars[i].int_value!=values[i].number){r->vars[i].int_value=values[i].number;changed=true;}}
    else if(strcmp(r->vars[i].string_value,values[i].text)){copy_utf8(r->vars[i].string_value,sizeof(r->vars[i].string_value),values[i].text);changed=true;}
  }
  if(changed){g_viewport_epoch++;g_pressed_node=-1;}return changed;
}
#endif
#if PET_FORM_V3_ENABLED
/* Only these roles belong to the bounded editor. Unrelated quota-v3 strings
 * never pass through its 64-byte intermediate values or writeback. */
/* Recursive model lock also serializes preparation of unpublished candidates. */
static EXT_RAM_BSS_ATTR pet_form3_value_t g_form3_workspace[PET_FORM3_VARS];
static pet_form3_value_t *form3_workspace_begin(void){miniapp_runtime_lock();return g_form3_workspace;}
static void form3_workspace_end(void){miniapp_runtime_unlock();}
static bool form3_owns(const miniapp_runtime_t *r,unsigned at){
  const pet_form3_t *f=&r->form3;if(!f->enabled)return false;
  if(at==f->focus_var||at==f->active_var||at==f->key_var||at==f->cursor_var||at==f->buffer_var||at==f->label_var||at==f->candidates_var)return true;
  for(unsigned i=0;i<f->count;i++)if(at==f->fields[i].var||at==f->fields[i].draft_var)return true;
  return false;
}
static unsigned form3_string_limit(const miniapp_runtime_t *r,unsigned at){
  if(!form3_owns(r,at))return 0;
  for(unsigned i=0;i<r->form3.count;i++)if(at==r->form3.fields[i].var||at==r->form3.fields[i].draft_var)return r->form3.fields[i].max_bytes;
  return at==r->form3.buffer_var?PET_FORM3_BUFFER_DIGITS:63;
}
static void form3_values(const miniapp_runtime_t *r,pet_form3_value_t values[PET_FORM3_VARS]){
  memset(values,0,sizeof(pet_form3_value_t)*PET_FORM3_VARS);
  for(int i=0;i<r->var_count&&i<PET_FORM3_VARS;i++){
    if(!form3_owns(r,(unsigned)i))continue;
    if(r->vars[i].type==MINIAPP_VAR_INT)values[i].number=r->vars[i].int_value;
    else copy_utf8(values[i].text,sizeof(values[i].text),r->vars[i].string_value);
  }
}
static bool form3_write(miniapp_runtime_t *r,const pet_form3_value_t values[PET_FORM3_VARS]){
  bool changed=false;
  for(int i=0;i<r->var_count&&i<PET_FORM3_VARS;i++){
    if(!form3_owns(r,(unsigned)i))continue;
    if(r->vars[i].type==MINIAPP_VAR_INT){if(r->vars[i].int_value!=values[i].number){r->vars[i].int_value=values[i].number;changed=true;}}
    else if(strcmp(r->vars[i].string_value,values[i].text)){copy_utf8(r->vars[i].string_value,sizeof(r->vars[i].string_value),values[i].text);changed=true;}
  }
  if(changed){g_viewport_epoch++;g_pressed_node=-1;}return changed;
}
#endif
static bool form_write(miniapp_runtime_t *r,const int32_t values[PET_FORM_VARS]){
  if(r->var_count>PET_FORM_VARS)return false;
  bool changed=false;
  for(int i=0;i<r->var_count;i++)if(r->vars[i].type==MINIAPP_VAR_INT&&r->vars[i].int_value!=values[i]){r->vars[i].int_value=values[i];changed=true;}
  if(changed){g_viewport_epoch++;g_pressed_node=-1;}
  return changed;
}
static bool form_cancel(miniapp_runtime_t *r){
#if PET_FORM_V3_ENABLED
  if(r->form3.enabled){pet_form3_value_t *values=form3_workspace_begin();form3_values(r,values);pet_form3_cancel(&r->form3,values);bool changed=form3_write(r,values);form3_workspace_end();return changed;}
#endif
  if(!r->form.enabled)return false;
#if PET_FORM_V2_ENABLED
  if(r->form_text.enabled){pet_form_value_t values[PET_FORM_VARS];form2_values(r,values);pet_form2_cancel(&r->form,&r->form_text,values);return form2_write(r,values);}
#endif
  int32_t values[PET_FORM_VARS];form_values(r,values);pet_form_cancel(&r->form,values);return form_write(r,values);
}
static int form_operation(const miniapp_runtime_t *r,const char *action){
#if PET_FORM_V3_ENABLED
  if(r->form3.enabled)return pet_form3_operation(&r->form3,action);
#endif
#if PET_FORM_V2_ENABLED
  if(r->form_text.enabled)return pet_form2_operation(&r->form,&r->form_text,action);
#endif
  return pet_form_operation(&r->form,action);
}
/* Keep the early admission clock/strcmp temporaries out of the much larger
 * form availability frame. Both mutually exclusive call paths are audited. */
static bool runtime_action_cooled(const miniapp_runtime_t *r,const char *action) __attribute__((noinline));
static bool runtime_action_cooled(const miniapp_runtime_t *r,const char *action){
  uint64_t now=esp_timer_get_time()/1000ULL;
  for(int i=0;i<3;i++)if(r->cooldown_ms[i]&&(r->cooldown_used&(1u<<i))&&!strcmp(r->cooldown_actions[i],action)
      &&(now<r->cooldown_at[i]||now-r->cooldown_at[i]<r->cooldown_ms[i]))return false;
  return true;
}
/* Admission and dispatch must select the same guarded branch. from_page is
 * shared by both branches; only the selected main branch owns its navigation. */
static bool runtime_transition_branch(const miniapp_runtime_t *r,const miniapp_transition_t *t,const char *action,bool *taken) {
  if(strcmp(t->action,action)||(t->from_state>=0&&t->from_state!=r->current_state))return false;
  if(r->navigation&&t->navigation_rule.from_page>=0&&t->navigation_rule.from_page!=r->current_page)return false;
  *taken=t->when_count==0||conditions_hold(r,t->when,t->when_count);
  if(!*taken&&!t->has_else)return false;
  if(r->navigation){
    pet_nav_rule_t rule=t->navigation_rule;
    if(!*taken){rule.op=PET_NAV_NONE;rule.target=-1;}
    if(!pet_nav_allowed(&r->navigation_history,r->current_page,&rule))return false;
  }
  return true;
}
static bool runtime_action_enabled(const miniapp_runtime_t *r,const char *action) {
  if(!r->input_v1)return true; /* Legacy packages keep their original contract. */
  if(!runtime_action_cooled(r,action))return false;
#if PET_COMPONENT_PROGRAM_ENABLED
  if(r->program.enabled&&r->program_suspended)return false;
  if(r==&g_runtime&&r->program.enabled)for(unsigned i=0;i<r->program.action_count;i++)if(!strcmp(r->program.actions[i].name,action)){
#if PET_VARIABLE_OWNERS_ENABLED
    if(runtime_action_host_dependent(r,action)){
      int32_t values[8];if(!component_program_action_values(r,action,values,NULL,esp_timer_get_time()/1000ULL))return false;
    }
#endif
#if PET_COMPONENT_BACKGROUND_ENABLED
    pet_program_registration_t h={0};if(background_current_locked(r,&h))return background_action_enabled_locked(r);
#endif
#if PET_COMPONENT_PROGRAM_PARENT_UNIFIED
    bool held __attribute__((cleanup(component_parent_leave)))=component_parent_enter();if(!held)return false;
#endif
    return g_component_program_initialized&&pet_component_program_session_can_enqueue(&g_component_program,g_image_revision);
  }
#endif
  int form_op=form_operation(r,action);
#if PET_FORM_V3_ENABLED
  if(form_op>=0&&r->form3.enabled){pet_form3_value_t *values=form3_workspace_begin();form3_values(r,values);bool allowed=pet_form3_allowed(&r->form3,values,r->current_page,form_op);form3_workspace_end();return allowed;}
#endif
#if PET_FORM_V2_ENABLED
  if(form_op>=0&&r->form_text.enabled){pet_form_value_t values[PET_FORM_VARS];form2_values(r,values);return pet_form2_allowed(&r->form,&r->form_text,values,r->current_page,form_op);}
#endif
  if(form_op>=0){int32_t values[PET_FORM_VARS];form_values(r,values);return pet_form_allowed(&r->form,values,r->current_page,form_op);}
  if(r->local.enabled&&!pet_local_enabled(&r->local,&r->local_state,action))return false;
#if PET_P4_DATA_ROWS
  if(!r->data_rows.enabled)pet_p4_widget_data_set_filter(NULL,NULL,NULL);
#endif
  for(int i=0;i<r->transition_count;i++){
    const miniapp_transition_t *t=&r->transitions[i];
    bool taken;
    if(runtime_transition_branch(r,t,action,&taken)){
      const int to_state=taken?t->to_state:t->else_to_state;
      const int page_op=taken?t->page_op:t->else_page_op;
      const int effect_count=taken?t->effect_count:t->else_effect_count;
      const miniapp_effect_t *effects=t->effects+(taken?0:t->effect_count);
      if(r->data_source[0]&&to_state<0&&page_op<0&&effect_count==1&&effects[0].var_index==r->data_page_var){
        pet_p4_data_paging_t data=pet_p4_widget_data_paging(r->data_source,r->vars[r->data_page_var].int_value);
        const miniapp_effect_t *e=&effects[0];int64_t value=e->source_var>=0?r->vars[e->source_var].int_value:e->int_value;
        if(e->op==MINIAPP_EFFECT_INC)value+=r->vars[r->data_page_var].int_value;
        int pages=data.pages?data.pages:1;
        return ((value%pages)+pages)%pages!=data.page;
      }
      return true;
    }
  }
  return false;
}

static bool parse_input_policy(miniapp_runtime_t *r,const cJSON *root) {
  const cJSON *p=cJSON_GetObjectItemCaseSensitive(root,"input");
  if(!p)return true;
static const char *const keys[]={"engine","repeat","press","swipe","confirm","drag","cooldown","hold"};
  static const char *const dirs[]={"left","right","up","down"};
  if(!cJSON_IsObject(p)||!object_keys_allowed(p,keys,8)||strcmp(json_string(p,"engine"),"p4-input-v1"))return false;
  r->input_v1=true;
  const cJSON *hold=cJSON_GetObjectItemCaseSensitive(p,"hold");
  if(hold){
    const cJSON *scene=cJSON_GetObjectItemCaseSensitive(root,"scene");
    bool side=!strcmp(json_string(scene,"engine"),"p4-side-scene-v1");
    if(!cJSON_IsString(hold)||!runtime_has_transition_action(r,hold->valuestring)||(!side&&!cJSON_GetObjectItemCaseSensitive(scene,"motion")))return false;
    bool bound=false;for(int b=0;b<r->button_count;b++)if(!strcmp(r->buttons[b].action,hold->valuestring)&&!strcmp(r->buttons[b].event,"button.sw1.short_press"))bound=true;
    if(!bound||cJSON_HasObjectItem(p,"drag"))return false;
    const char *conflicts[]={"repeat","press","confirm","cooldown"};
    for(int k=0;k<4;k++){const cJSON *v=cJSON_GetObjectItemCaseSensitive(p,conflicts[k]),*item;
      if(k<2){cJSON_ArrayForEach(item,v)if(cJSON_IsString(item)&&!strcmp(item->valuestring,hold->valuestring))return false;}
      else if(cJSON_HasObjectItem(v,hold->valuestring))return false;
    }
    copy_utf8(r->hold_action,48,hold->valuestring);
  }
  for(int mode=0;mode<2;mode++){
    const cJSON *a=cJSON_GetObjectItemCaseSensitive(p,mode?"press":"repeat");
    if(!a)continue;
    if(!cJSON_IsArray(a)||cJSON_GetArraySize(a)>8)return false;
    uint8_t mask=0;const cJSON *v;
    cJSON_ArrayForEach(v,a){
      if(!cJSON_IsString(v)||!runtime_has_transition_action(r,v->valuestring))return false;
      int b=-1;
      for(int i=0;i<r->button_count;i++)if(!strcmp(r->buttons[i].action,v->valuestring)){b=i;break;}
      if(b<0||(mask&(1u<<b)))return false;
      const char *event=r->buttons[b].event;
      if(mode){
        const cJSON *game=cJSON_GetObjectItemCaseSensitive(root,"game");
        const char *flap=json_string(cJSON_GetObjectItemCaseSensitive(game,"actions"),"flap");
        if(strcmp(event,"button.sw1.short_press")||
           (strcmp(v->valuestring,flap)&&!(cJSON_GetObjectItemCaseSensitive(root,"instrument")&&!strcmp(v->valuestring,"instrument.strike"))))return false;
      }else if(strcmp(event,"knob.rotate_ccw")&&strcmp(event,"knob.rotate_cw")&&strcmp(event,"joystick.up")&&strcmp(event,"joystick.down"))return false;
      mask|=1u<<b;
    }
    if(mode)r->press_mask=mask;else r->repeat_mask=mask;
  }
  const cJSON *swipe=cJSON_GetObjectItemCaseSensitive(p,"swipe");
  if(swipe){
    if(!cJSON_IsObject(swipe)||!object_keys_allowed(swipe,dirs,4))return false;
    for(int i=0;i<4;i++){
      const cJSON *v=cJSON_GetObjectItemCaseSensitive(swipe,dirs[i]);
      if(!v)continue;
      if(!cJSON_IsString(v)||!runtime_has_transition_action(r,v->valuestring))return false;
      copy_utf8(r->swipe_actions[i],sizeof(r->swipe_actions[i]),v->valuestring);
    }
  }
  const cJSON *confirm=cJSON_GetObjectItemCaseSensitive(p,"confirm");
  if(confirm){
    if(!cJSON_IsObject(confirm)||cJSON_GetArraySize(confirm)>3)return false;
    int i=0;const cJSON *v;
    cJSON_ArrayForEach(v,confirm){
      if(!cJSON_IsString(v)||!v->string||!runtime_has_transition_action(r,v->string)||!v->valuestring[0]||strlen(v->valuestring)>120)return false;
      copy_utf8(r->confirm_actions[i],48,v->string);copy_utf8(r->confirm_prompts[i],121,v->valuestring);i++;
    }
  }
  const cJSON *drag=cJSON_GetObjectItemCaseSensitive(p,"drag");
  if(drag){
    static const char *const dk[]={"entity","axis"};
    const char *id=json_string(drag,"entity"),*axis=json_string(drag,"axis");
    const cJSON *scene=cJSON_GetObjectItemCaseSensitive(root,"scene"),*surface=cJSON_GetObjectItemCaseSensitive(root,"surface");
    if(!object_keys_allowed(drag,dk,2)||!id[0]||strlen(id)>15||strcmp(json_string(cJSON_GetObjectItemCaseSensitive(surface,"scene_view"),"engine"),"p4-scene-surface-v1"))return false;
    r->drag_axis=!strcmp(axis,"x")?1:!strcmp(axis,"y")?2:!strcmp(axis,"xy")?3:0;
    if(!r->drag_axis)return false;
    bool found=false;const cJSON *e;cJSON_ArrayForEach(e,cJSON_GetObjectItemCaseSensitive(scene,"entities")){
      const char *bounds=json_string(e,"bounds");
      if(!strcmp(json_string(e,"id"),id)&&(!bounds[0]||!strcmp(bounds,"clamp")))found=true;
    }
    if(!found)return false;
    copy_utf8(r->drag_entity,16,id);
  }
  const cJSON *cooldown=cJSON_GetObjectItemCaseSensitive(p,"cooldown");
  if(cooldown){
    if(!cJSON_IsObject(cooldown)||cJSON_GetArraySize(cooldown)>3)return false;
    if(cJSON_GetArraySize(cooldown)&&(cJSON_IsTrue(cJSON_GetObjectItemCaseSensitive(root,"host"))||cJSON_GetObjectItemCaseSensitive(root,"media")||cJSON_GetObjectItemCaseSensitive(root,"instrument")))return false;
    int i=0;const cJSON *v;cJSON_ArrayForEach(v,cooldown){
      if(!v->string||!runtime_has_transition_action(r,v->string)||!cJSON_IsNumber(v)||v->valuedouble!=v->valueint||v->valueint<250||v->valueint>60000)return false;
      for(int j=0;j<i;j++)if(!strcmp(r->cooldown_actions[j],v->string))return false;
      copy_utf8(r->cooldown_actions[i],48,v->string);r->cooldown_ms[i++]=v->valueint;
    }
  }
  return true;
}

static bool json_int_range(const cJSON *value, int minimum, int maximum, int *out);
static bool parse_game(
  miniapp_runtime_t *runtime,
  const cJSON *game,
  char *error,
  size_t error_size
) {
  static const char *const allowed[] = {
    "type", "tick_ms", "playing_state", "result_state", "score_var", "actions", "vertical_speed_percent", "direction_mode", "difficulty_var", "status_var",
  };
  static const char *const blocks_action_allowed[] = {
    "start", "left", "right", "rotate", "drop", "soft_drop",
  };
  static const char *const snake_action_allowed[] = {
    "start", "left", "right", "up", "down",
  };
  static const char *const flappy_action_allowed[] = {
    "flap",
  };
  static const char *const gomoku_action_allowed[] = {
    "place", "left", "right", "up", "down", "undo",
  };
  const cJSON *tick;
  const cJSON *actions;
  const char *type;
  const char *score_var;
  const char *playing_state;
  const char *result_state;
  pet_p4_game_kind_t kind;
  const char *required_actions[5];
  int required_count;
  if (!game) return true;
  if (!object_keys_allowed(game, allowed, sizeof(allowed) / sizeof(allowed[0]))) {
    set_error(error, error_size, "game contains an unsupported field");
    return false;
  }
  type = json_string(game, "type");
  kind = pet_p4_game_kind_from_name(type);
  tick = cJSON_GetObjectItemCaseSensitive(game, "tick_ms");
  actions = cJSON_GetObjectItemCaseSensitive(game, "actions");
  score_var = json_string(game, "score_var");
  playing_state = json_string(game, "playing_state");
  result_state = json_string(game, "result_state");
  const char *const *action_allowed = kind == PET_P4_GAME_BLOCKS
    ? blocks_action_allowed
    : kind == PET_P4_GAME_SNAKE ? snake_action_allowed
    : (kind == PET_P4_GAME_GOMOKU || kind == PET_P4_GAME_XIANGQI) ? gomoku_action_allowed : flappy_action_allowed;
  size_t action_allowed_count = kind == PET_P4_GAME_BLOCKS
    ? sizeof(blocks_action_allowed) / sizeof(blocks_action_allowed[0])
    : kind == PET_P4_GAME_SNAKE
      ? sizeof(snake_action_allowed) / sizeof(snake_action_allowed[0])
    : (kind == PET_P4_GAME_GOMOKU || kind == PET_P4_GAME_XIANGQI)
      ? sizeof(gomoku_action_allowed) / sizeof(gomoku_action_allowed[0])
      : sizeof(flappy_action_allowed) / sizeof(flappy_action_allowed[0]);
  if (kind == PET_P4_GAME_NONE || !cJSON_IsNumber(tick)
      || tick->valuedouble < 100.0 || tick->valuedouble > 2000.0
      || tick->valuedouble != (double) ((uint32_t) tick->valuedouble)
      || !object_keys_allowed(actions, action_allowed, action_allowed_count)) {
    set_error(error, error_size, "game requires a supported type, bounded tick_ms, and actions");
    return false;
  }
  runtime->game.score_var = (int8_t) find_var(runtime, score_var);
  runtime->game.difficulty_var = -1;
  runtime->game.status_var = -1;
  runtime->game.ready_state = runtime->current_state;
  if (kind == PET_P4_GAME_XIANGQI) {
    runtime->game.difficulty_var = (int8_t) find_var(runtime, json_string(game, "difficulty_var"));
    runtime->game.status_var = (int8_t) find_var(runtime, json_string(game, "status_var"));
    if (runtime->game.difficulty_var < 0 || runtime->game.status_var < 0
        || runtime->vars[runtime->game.difficulty_var].type != MINIAPP_VAR_INT
        || runtime->vars[runtime->game.status_var].type != MINIAPP_VAR_INT) {
      set_error(error, error_size, "xiangqi requires integer difficulty_var and status_var");
      return false;
    }
  } else if (cJSON_GetObjectItemCaseSensitive(game, "difficulty_var")
      || cJSON_GetObjectItemCaseSensitive(game, "status_var")) return false;
  runtime->game.playing_state =
    (int8_t) find_name(runtime->states, runtime->state_count, playing_state);
  runtime->game.result_state =
    (int8_t) find_name(runtime->states, runtime->state_count, result_state);
  if (runtime->game.score_var < 0
      || runtime->vars[runtime->game.score_var].type != MINIAPP_VAR_INT
      || runtime->game.playing_state < 0 || runtime->game.result_state < 0) {
    set_error(error, error_size, "game references an invalid score var or state");
    return false;
  }
  copy_utf8(runtime->game.start_action, sizeof(runtime->game.start_action),
            json_string(actions, "start"));
  copy_utf8(runtime->game.left_action, sizeof(runtime->game.left_action),
            json_string(actions, "left"));
  copy_utf8(runtime->game.right_action, sizeof(runtime->game.right_action),
            json_string(actions, "right"));
  copy_utf8(runtime->game.rotate_action, sizeof(runtime->game.rotate_action),
            json_string(actions, "rotate"));
  copy_utf8(runtime->game.drop_action, sizeof(runtime->game.drop_action),
            json_string(actions, "drop"));
  copy_utf8(runtime->game.flap_action, sizeof(runtime->game.flap_action),
            json_string(actions, "flap"));
  copy_utf8(runtime->game.soft_drop_action,sizeof(runtime->game.soft_drop_action),json_string(actions,"soft_drop"));
  copy_utf8(runtime->game.up_action,sizeof(runtime->game.up_action),json_string(actions,"up"));
  copy_utf8(runtime->game.down_action,sizeof(runtime->game.down_action),json_string(actions,"down"));
  copy_utf8(runtime->game.place_action,sizeof(runtime->game.place_action),json_string(actions,"place"));
  copy_utf8(runtime->game.undo_action,sizeof(runtime->game.undo_action),json_string(actions,"undo"));
  const cJSON *mode=cJSON_GetObjectItemCaseSensitive(game,"direction_mode");
  if(mode){
    if(!runtime->input_v1||kind!=PET_P4_GAME_SNAKE||!cJSON_IsString(mode)||strcmp(mode->valuestring,"absolute"))return false;
    runtime->game.absolute_directions=true;
  }
  /* gomoku moves a board cursor, so up/down are part of its fixed action table. */
  if((runtime->game.up_action[0]||runtime->game.down_action[0])&&!runtime->game.absolute_directions&&kind!=PET_P4_GAME_GOMOKU&&kind!=PET_P4_GAME_XIANGQI)return false;
  if(runtime->game.absolute_directions&&(!runtime->game.up_action[0]||!runtime->game.down_action[0]))return false;
  if(cJSON_GetObjectItemCaseSensitive(actions,"soft_drop")&&(!runtime->input_v1||!runtime->game.soft_drop_action[0]))return false;
  const char *extras[]={runtime->game.soft_drop_action,runtime->game.up_action,runtime->game.down_action};
  for(int i=0;i<3;i++)if(extras[i][0]&&(!safe_id(extras[i],PET_P4_MINIAPP_ACTION_MAX)||!runtime_has_transition_action(runtime,extras[i])||!runtime_has_button_action(runtime,extras[i])))return false;
  if (kind == PET_P4_GAME_FLAPPY) {
    required_actions[0] = runtime->game.flap_action;
    required_count = 1;
  } else if (kind == PET_P4_GAME_GOMOKU || kind == PET_P4_GAME_XIANGQI) {
    /* place doubles as start/restart (flappy convention); up/down are checked
     * with the extras above. */
    if(!runtime->game.up_action[0]||!runtime->game.down_action[0])return false;
    required_actions[0] = runtime->game.place_action;
    required_actions[1] = runtime->game.left_action;
    required_actions[2] = runtime->game.right_action;
    required_actions[3] = runtime->game.undo_action;
    required_count = 4;
  } else {
    required_actions[0] = runtime->game.start_action;
    required_actions[1] = runtime->game.left_action;
    required_actions[2] = runtime->game.right_action;
    required_actions[3] = runtime->game.rotate_action;
    required_actions[4] = runtime->game.drop_action;
    required_count = kind == PET_P4_GAME_BLOCKS ? 5 : 3;
  }
  for (int i = 0; i < required_count; i += 1) {
    if (!safe_id(required_actions[i], PET_P4_MINIAPP_ACTION_MAX)
        || !runtime_has_transition_action(runtime, required_actions[i])
        || !runtime_has_button_action(runtime, required_actions[i])) {
      set_error(error, error_size, "game actions must match transitions and buttons");
      return false;
    }
  }
  if (!pet_p4_game_configure(
        &runtime->game.engine,
        kind,
        (uint32_t) tick->valuedouble,
        stable_widget_seed(runtime->widget_id)
      )) {
    set_error(error, error_size, "game engine configuration is invalid");
    return false;
  }
  const cJSON *speed=cJSON_GetObjectItemCaseSensitive(game,"vertical_speed_percent");
  int percent=100;
  if(speed&&(!json_int_range(speed,25,100,&percent)
      ||!pet_p4_game_set_vertical_speed(&runtime->game.engine,(unsigned)percent))){
    set_error(error,error_size,"vertical_speed_percent requires flappy and an integer in 25-100");
    return false;
  }
  runtime->game.active = true;
  return true;
}

#if PET_P4_TEXT_TABLE
/* p4-texts-v1: index outside the table resolves to the empty string. */
static const char *text_at(const miniapp_runtime_t *runtime, int32_t index) {
  if (index < 0 || index >= runtime->text_count) return "";
  return runtime->text_pool + runtime->text_offset[index];
}
static bool parse_texts(miniapp_runtime_t *runtime, const cJSON *texts) {
  const cJSON *item; size_t used = 0;
  if (!cJSON_IsArray(texts) || cJSON_GetArraySize(texts) < 1 || cJSON_GetArraySize(texts) > MINIAPP_TEXT_MAX) return false;
  cJSON_ArrayForEach(item, texts) {
    if (!cJSON_IsString(item)) return false;
    size_t length = strlen(item->valuestring);
    if (length > MINIAPP_TEXT_ENTRY_MAX || used + length + 1 > sizeof(runtime->text_pool) || used + length > 4096) return false;
    for (const unsigned char *s = (const unsigned char *) item->valuestring; *s; s++) if (*s < 32 || *s == 127) return false;
    runtime->text_offset[runtime->text_count++] = (uint16_t) used;
    memcpy(runtime->text_pool + used, item->valuestring, length + 1); used += length + 1;
  }
  return true;
}
#endif

static void resolve_value(
  const miniapp_runtime_t *runtime,
  const miniapp_value_t *value,
  char *out,
  size_t out_size
) {
  const miniapp_var_t *var;
  out[0] = '\0';
  if (value->kind == MINIAPP_VALUE_LITERAL) {
    copy_utf8(out, out_size, value->literal);
    return;
  }
  if (value->var_index < 0 || value->var_index >= runtime->var_count) return;
  var = &runtime->vars[value->var_index];
  if (value->kind == MINIAPP_VALUE_VAR) {
    if (var->type == MINIAPP_VAR_INT) snprintf(out, out_size, "%ld", (long) var->int_value);
    else copy_utf8(out, out_size, var->string_value);
  } else if (value->kind == MINIAPP_VALUE_TEXT_AT) {
#if PET_P4_TEXT_TABLE
    copy_utf8(out, out_size, text_at(runtime, var->int_value));
#endif
  } else {
    int32_t seconds = var->int_value > 0 ? var->int_value : 0;
    if (value->kind == MINIAPP_VALUE_MMSS) {
      snprintf(out, out_size, "%02ld:%02ld", (long) (seconds / 60), (long) (seconds % 60));
    } else {
      snprintf(out, out_size, "%ld:%02ld:%02ld", (long) (seconds / 3600),
               (long) ((seconds / 60) % 60), (long) (seconds % 60));
    }
  }
}

static void resolve_rule(
  const miniapp_runtime_t *runtime,
  const miniapp_rule_t *rule,
  char *out,
  size_t out_size
) {
  int selector;
  out[0] = '\0';
  if (rule->kind == MINIAPP_RULE_VALUE) {
    resolve_value(runtime, &rule->value, out, out_size);
    return;
  }
  if (rule->kind != MINIAPP_RULE_SWITCH_STATE && rule->kind != MINIAPP_RULE_SWITCH_PAGE) return;
  selector = rule->kind == MINIAPP_RULE_SWITCH_STATE ? runtime->current_state : runtime->current_page;
  for (int i = 0; i < rule->choice_count; i += 1) {
    if (rule->choices[i].selector == selector) {
      resolve_value(runtime, &rule->choices[i].value, out, out_size);
      return;
    }
  }
}

static void local_values(miniapp_runtime_t *r,int32_t v[PET_LOCAL_VARS],bool write){
  if(!write)memset(v,0,sizeof(int32_t)*PET_LOCAL_VARS);
  unsigned count=r->local.wide_masks?PET_LOCAL_VARS:PET_LOCAL_LEGACY_VARS;
  for(unsigned i=0;i<count;i++){if(write)r->vars[r->local_vars[i]].int_value=v[i];else v[i]=r->vars[r->local_vars[i]].int_value;}
}
static void refresh_view(miniapp_runtime_t *runtime) {
#if PET_P4_DATA_ROWS
  if(runtime==&g_runtime&&!runtime->data_rows.enabled)pet_p4_widget_data_set_filter(NULL,NULL,NULL);
#endif
  if (runtime->resource_incomplete) return;
  pet_p4_miniapp_view_t *view = &runtime->view;
  uint32_t next_revision = view->revision + 1;
  memset(view, 0, sizeof(*view));
  view->active = runtime->active;
  view->progress_percent = -1;
  view->revision = next_revision;
  copy_utf8(view->data_source, sizeof(view->data_source), runtime->data_source);
  view->media=runtime->media;
  view->app_surface=runtime->surface.app;
  view->app_host=runtime_host_dashboard(runtime);
  view->surface_page=runtime->current_page<0?0:runtime->current_page;
  view->instrument=runtime->instrument;
  view->slicing=runtime->slicing;
  view->effect_volume=runtime->effect_volume;
  view->ambience_volume=runtime->ambience_volume;
  if (runtime->data_source[0]) view->data_page = runtime->vars[runtime->data_page_var].int_value;
  copy_utf8(view->widget_id, sizeof(view->widget_id), runtime->widget_id);
  if (runtime->current_state >= 0) {
    copy_utf8(view->state, sizeof(view->state), runtime->states[runtime->current_state]);
  }
  if (runtime->current_page >= 0) {
    copy_utf8(view->page, sizeof(view->page), runtime->pages[runtime->current_page]);
  }
  resolve_rule(runtime, &runtime->rules[MINIAPP_SLOT_TITLE], view->title, sizeof(view->title));
  resolve_rule(runtime, &runtime->rules[MINIAPP_SLOT_EYEBROW], view->eyebrow, sizeof(view->eyebrow));
  resolve_rule(runtime, &runtime->rules[MINIAPP_SLOT_HEADLINE], view->headline, sizeof(view->headline));
  resolve_rule(runtime, &runtime->rules[MINIAPP_SLOT_METRIC_LABEL], view->metric_label, sizeof(view->metric_label));
  resolve_rule(runtime, &runtime->rules[MINIAPP_SLOT_METRIC_VALUE], view->metric_value, sizeof(view->metric_value));
  resolve_rule(runtime, &runtime->rules[MINIAPP_SLOT_METRIC_UNIT], view->metric_unit, sizeof(view->metric_unit));
  resolve_rule(runtime, &runtime->rules[MINIAPP_SLOT_BADGE], view->badge, sizeof(view->badge));
  resolve_rule(runtime, &runtime->rules[MINIAPP_SLOT_NOTE], view->note, sizeof(view->note));
  resolve_rule(runtime, &runtime->rules[MINIAPP_SLOT_FOOTER], view->footer, sizeof(view->footer));
  resolve_rule(runtime, &runtime->rules[MINIAPP_SLOT_VISUAL_STYLE], view->visual_style, sizeof(view->visual_style));
  resolve_rule(runtime, &runtime->rules[MINIAPP_SLOT_VISUAL_PALETTE], view->visual_palette, sizeof(view->visual_palette));
  resolve_rule(runtime, &runtime->rules[MINIAPP_SLOT_VISUAL_LAYOUT], view->visual_layout, sizeof(view->visual_layout));
  resolve_rule(runtime, &runtime->rules[MINIAPP_SLOT_VISUAL_SPRITE], view->visual_sprite, sizeof(view->visual_sprite));
  if (runtime->game.active) {
    pet_p4_game_get_frame(&runtime->game.engine, &view->game);
  }
  const miniapp_rule_t *progress = &runtime->rules[MINIAPP_SLOT_PROGRESS];
  if (progress->kind == MINIAPP_RULE_PROGRESS) {
    int32_t value = runtime->vars[progress->progress_value_var].int_value;
    int32_t maximum = runtime->vars[progress->progress_max_var].int_value;
    view->progress_percent = maximum > 0 ? (int) (((long long) value * 100LL) / maximum) : 0;
    if (view->progress_percent < 0) view->progress_percent = 0;
    if (view->progress_percent > 100) view->progress_percent = 100;
    copy_utf8(view->progress_label, sizeof(view->progress_label), progress->progress_label);
  } else {
    char raw[MINIAPP_VALUE_MAX];
    resolve_rule(runtime, progress, raw, sizeof(raw));
    char *colon = strchr(raw, ':');
    if (raw[0]) {
      view->progress_percent = atoi(raw);
      if (view->progress_percent < 0) view->progress_percent = 0;
      if (view->progress_percent > 100) view->progress_percent = 100;
      if (colon) copy_utf8(view->progress_label, sizeof(view->progress_label), colon + 1);
    }
  }
}

static void refresh_local_view(miniapp_runtime_t *r,uint64_t now){
  int32_t v[PET_LOCAL_VARS];local_values(r,v,false);pet_local_view_t o;
  pet_local_view(&r->local,&r->local_state,v,now,local_wall_seconds(now),&o);
  r->current_state=o.phase;refresh_view(r);
  copy_utf8(r->view.eyebrow,sizeof(r->view.eyebrow),o.eyebrow);
  copy_utf8(r->view.headline,sizeof(r->view.headline),o.headline);
  copy_utf8(r->view.note,sizeof(r->view.note),o.note);
  copy_utf8(r->view.metric_value,sizeof(r->view.metric_value),o.metric);
  copy_utf8(r->view.metric_label,sizeof(r->view.metric_label),o.label);
  copy_utf8(r->view.metric_unit,sizeof(r->view.metric_unit),o.unit);
  copy_utf8(r->view.badge,sizeof(r->view.badge),o.badge);
  r->view.progress_percent=o.progress;
}
static bool parse_local(miniapp_runtime_t *r,const cJSON *root){
  const cJSON *local=cJSON_GetObjectItemCaseSensitive(root,"local");if(!local)return true;
  if(!r->surface.app||!r->input_v1||r->tick_count||r->page_count||r->state_count!=6||r->transition_count<2||r->game.active||cJSON_HasObjectItem(root,"host")||cJSON_HasObjectItem(root,"scene")||cJSON_HasObjectItem(root,"media")||cJSON_HasObjectItem(root,"data")||cJSON_HasObjectItem(root,"instrument"))return false;
  const char *states[]={"ready","busy","result","editing","empty","offline"};
  for(int i=0;i<6;i++)if(strcmp(r->states[i],states[i])||r->save_states[i]!=0)return false;
  if(!pet_local_parse(local,&r->local)||r->local.action_count!=r->transition_count)return false;
  unsigned local_count=r->local.wide_masks?PET_LOCAL_VARS:PET_LOCAL_LEGACY_VARS;
  if(r->var_count!=local_count||r->save_vars!=((UINT32_C(1)<<local_count)-1)
      ||r->save_version!=(r->local.wide_masks?2:1))return false;
  for(unsigned i=0;i<local_count;i++){char name[12];snprintf(name,sizeof(name),"local%u",i);int index=find_var(r,name);if(index<0||r->vars[index].type!=MINIAPP_VAR_INT)return false;r->local_vars[i]=index;}

  /* v1 packages keep the 16-item deck even though the array now holds the v2 ceiling. */
  for(int i=0;i<r->local.count;i++)if(r->local.groups[i].count>MINIAPP_CAP(r,MINIAPP_V1_LOCAL_ITEMS,MINIAPP_V2_LOCAL_ITEMS,PET_LOCAL_ITEMS))return false;
  for(int i=0;i<r->transition_count;i++){
    miniapp_transition_t *t=&r->transitions[i];bool found=false;
    for(int j=0;j<r->local.action_count;j++)if(!strcmp(t->action,r->local.actions[j]))found=true;
    if(!found||t->from_state!=-1||t->to_state!=-1||t->page_op!=-1||t->effect_count)return false;
  }
  if(cJSON_HasObjectItem(root,"game"))return false;
  pet_local_init(&r->local_state);return true;
}
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
