gmingtian/HachimoDock-esp32s3/firmware/main/pet_p4_protocol.c

/*
 * [Input] JSON-line control/state envelopes from USB-UART and native USB.
 * [Output] validated runtime updates, ACK/NACK responses, persisted input
 *          configuration snapshots, transfer routing, deterministic appearance
 *          pack discovery/reactivation across both flash slots, compatible
 *          v3/v4 component capabilities with bounded sprite limits, restart-safe
 *          slot cleanup, idle-transfer recovery and legacy-pack migration, 60-second per-session
 *          terminal conversation visibility across active-queue refreshes,
 *          stable first-seen card ordering, selected-card lifecycle authority for
 *          appearance playback, and exact retained-card selection preservation
 *          after host refreshes; queue resets preserve physical voice-hold feedback;
 *          DSH R5 approval pending state with fail-closed expiry and one-decision
 *          idempotency; actual chip revision for safe firmware selection.
 * [Pos] shared ESP32-P4 protocol dispatcher.
 * [Sync] If this file changes, update firmware/protocol.md and .folder.md.
 */

#include "pet_p4_protocol.h"
#include "pet_p4_usb_native.h"
#include "pet_p4_variable_owners.h"
#include "pet_p4_conversation.h"
#include "pet_p4_audio.h"
#include "pet_p4_audio_patch.h"
#include "pet_p4_system_cues.h"
#include "esp_attr.h"
#include "pet_p4_transport_config.h"
#include "pet_p4_control_integrity.h"
#include "pet_p4_control_session.h"
#include "pet_p4_screenshot_close.h"
#include "pet_p4_evidence_identity.h"
#include "pet_p4_component_program.h"
#include "pet_p4_storage_io_trace.h"
#include "pet_p4_resources_device.h"
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
