gmingtian/HachimoDock-esp32s3/(commit log)

2026-10-29 feat: adapt HachimoDock for ESP32-S3 and Linux
    Retain fixed N16R8 wiring and full shared runtime, add Chinese native three-key/session UI, bounded S3 assets, target-safe OTA, and Linux desktop support. Include host verification reports and UI previews; physical-board validation remains pending.
    [partitions.s3.csv]
2026-10-29 docs: introduce ESP32-S3 fork and credit original HachimoDock
2026-10-29 docs: compare ESP32-S3 adaptation with upstream P4 features
2026-10-29 fix(s3): exclude built-in games requiring unsupported controls
    [build_s3_factory.py, pet_p4_miniapp.c, pet_s3_component_policy.h, s3_component_policy_test.py]
2026-10-29 fix(s3): preserve USB recovery and pending audio ownership
    [pet_p4_audio.c, pet_p4_audio.h, s3_protocol_session_test.c, s3_wifi_host_test.py]
2026-10-29 fix: preserve selected transport and filter S3 games for three keys
    [connection_policy.rs, s3_components.rs, wifi_commands.rs]
2026-10-29 fix: bind OTA reconnect to the locked update connection
    [music_player.rs, wifi_commands.rs]
2026-10-29 build: bundle clean S3 r3 firmware and pin release resources
2026-10-29 fix: stage Linux resources under the configured Tauri product name
2026-10-29 docs: rename project to HachimoDock-esp32s3
2026-10-29 docs: distinguish upstream daily USB-UART from P4 HS capability
2026-10-29 fix: fit r4 USB handshake writes within SDK console buffer
    [pet_p4_main.c, s3_boot_runtime_test.py]
2026-10-29 docs: add physical S3 device and session photos
2026-10-30 feat(s3): support 15fps appearance assets and bundle r6 firmware
    Regenerate all 16 default animation families, preserve legacy 10fps packs, and round inferred durations safely. Update desktop to 0.1.169, pin the bundled S3 r6 image, and extend bounded asset and hardware verification coverage.
    Document the measured display rate separately from accepted asset FPS; 240x320 and joystick adaptation remain pending. Fix resource smoke expectations for the new 15fps converter default.
    [build_s3_factory.py, package_s3_release.py, pet_p4_assets.c, pet_p4_protocol.c, pet_s3_render.h, prepare_s3_assets.py, s3_renderer_test.py]
2026-11-01 fix(s3): rotate landscape panel 180 degrees from initial orientation
    [pet_s3_display.h, s3_landscape_test.py]
2026-11-01 fix(s3): render original component cards in landscape profile
    [p4_component_center_test.py, pet_p4_renderer.c]
2026-11-01 fix(s3): improve global landscape text and preserve thin glyph strokes
    [pet_p4_renderer.c, s3_typography_test.py]
2026-11-02 Add A4 ESP32-S3 carrier PCB and assembly documentation
    [BOM.csv, HachimoDock-S3-carrier-A4.kicad_pcb, connections.csv]
2026-11-03 Add verified A4 carrier schematics and portable netlist exports
    [HachimoDock-S3-carrier-A4.kicad_sch, schematic-audit.json, schematic-erc.json]
2026-11-08 Release A4 joystick controls, native rendering and offline board games
    Prepare desktop 0.1.202 and the verified S3 r16c OTA firmware.
    Carry the current upstream desktop/runtime updates and A4 development state.
    Remove the superseded pure three-key adaptation and keep official A4 controls.
    Include native 320x240 composition, animation/home recovery, Gomoku and Xiangqi.
    Add Windows/macOS/Linux packaging, real device photos, PCB and R4.4 CAD/print assets.
    Keep private device backups, CAD IPC, credentials and build outputs excluded.
    Validation: 1832 frontend tests; 324 bridge/security tests (3 platform skips);
    40 packaging tests; 5 Linux staging tests; 9 firmware host tests;
    40 targeted native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
    [a4-lower-r4.4-speaker.stl, a4-upper-r4.4-hachimo.stl, original-assembly.STEP, original-lower.stl, original-upper.stl, partitions.csv, working-r4.4-full.step]
2026-11-09 Complete A4 printable controls and restore reproducible desktop builds
    Extract the three original keycaps and three joystick pieces with provenance and geometry checks. Include them in the hardware manifest and download bundle. Restore locked bridge dependencies and native resources before CI tests, pin the reviewed Node 26.7.0 runtime, and align macOS 13.5 and Linux libatomic requirements.
    Validation: Node 26 frontend 1832 passed; bridge 229 passed with 3 platform skips; DSH security 95 passed; packaging 40 passed; print meshes, hardware manifest, source gate and diff checks passed.
    [joystick-cap-a.stl, joystick-cap-b.stl, joystick-cover.stl, keycap-1.stl, keycap-2.stl, keycap-3.stl]
2026-11-09 Fix Linux image-budget type inference without changing limits
    [component_capability_ext.rs]
2026-11-09 Publish verified A4 release downloads and printable controls index
2026-11-10 Fix S3 transfers and desktop USB, generation, and session states
    Prepare desktop 0.1.203 and A4 firmware r16d. Keep exact-board and same-agent protections, add native regression coverage, and record the existing P4 host-suite baseline failures.
    [bound_state_session.rs, generation_video.rs, p4_appearance_upload_phase_test.py, package_s3_release.py]
